tominhcuong2041505-sys/SMT-Pick-and-Place/PCB/2026-09-16/README_NOTE.txt

Thickness   : 1.6mm
Color       : Black
Stencil     : YES
Stencil size: 150*150mm
