tominhcuong2041505-sys/SMT-Pick-and-Place/PCB/2026-07-02/Layout/LPC1769_PNP-B_Silkscreen.pdf

VIN

GND

2B

## 2A1A1B

3V3 GND

X-AXIS

VIN

GND

2B

## 2A1A1B

3V3 GND

Y0-AXIS

VIN

GND

2B

## 2A1A1B

3V3 GND

Y1-AXIS Z-AXIS

VIN

GND

2B

## 2A1A1B

3V3 GND

R-AXIS

VIN

GND

2B

## 2A1A1B

3V3 GND

## ENM1 M2RX

TX CLK

STP

DIR

## ENM1 M2RX

TX CLK

STP

DIR

## ENM1 M2RX

TX CLK

STP

DIR

## ENM1 M2RX

TX CLK

STP

DIR

## ENM1 M2RX

TX CLK

STP

DIR

# P1.29 P1.28 P1.27 P1.18 P1.19 P2.1 P2.3 P2.2 GND

GND

GND

GND

GND P2.5 + P2.4 + P0.15 + P0.16 + + - D- D+ VBUS GND + + + + + + + +
