tominhcuong2041505-sys/SMT-Pick-and-Place/OpenPnP/LBoiz_Scripts/README.md

Tải và copy vào scripts Openpnp "/home/$user$/.openpnp2/scripts"

```
chmod +x /home/lboiz/.openpnp2/scripts/Examples/Python/reset_camera_*.py
```
