tominhcuong2041505-sys/SMT-Pick-and-Place/Klipper/.theme/main-background.png

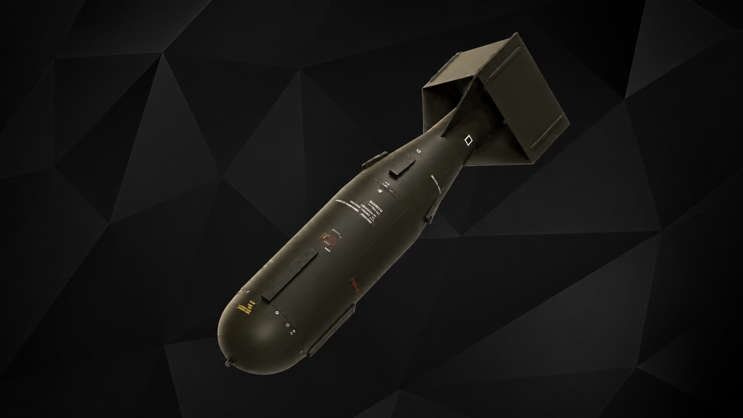
Klipper/.theme/main-background.png
