tominhcuong2041505-sys/SMT-Pick-and-Place/Klipper/.theme/sidebar-background.png

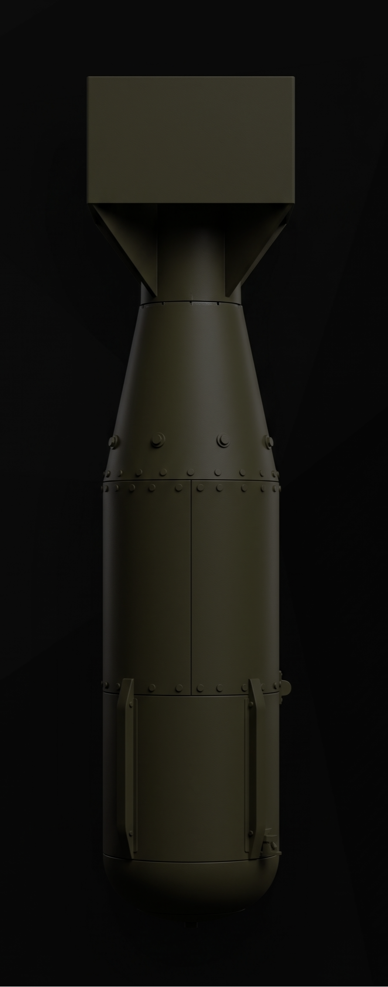
Klipper/.theme/sidebar-background.png
