tominhcuong2041505-sys/SMT-Pick-and-Place/PCB/Images/LPC1769_LBoizPnP_v1.1.png

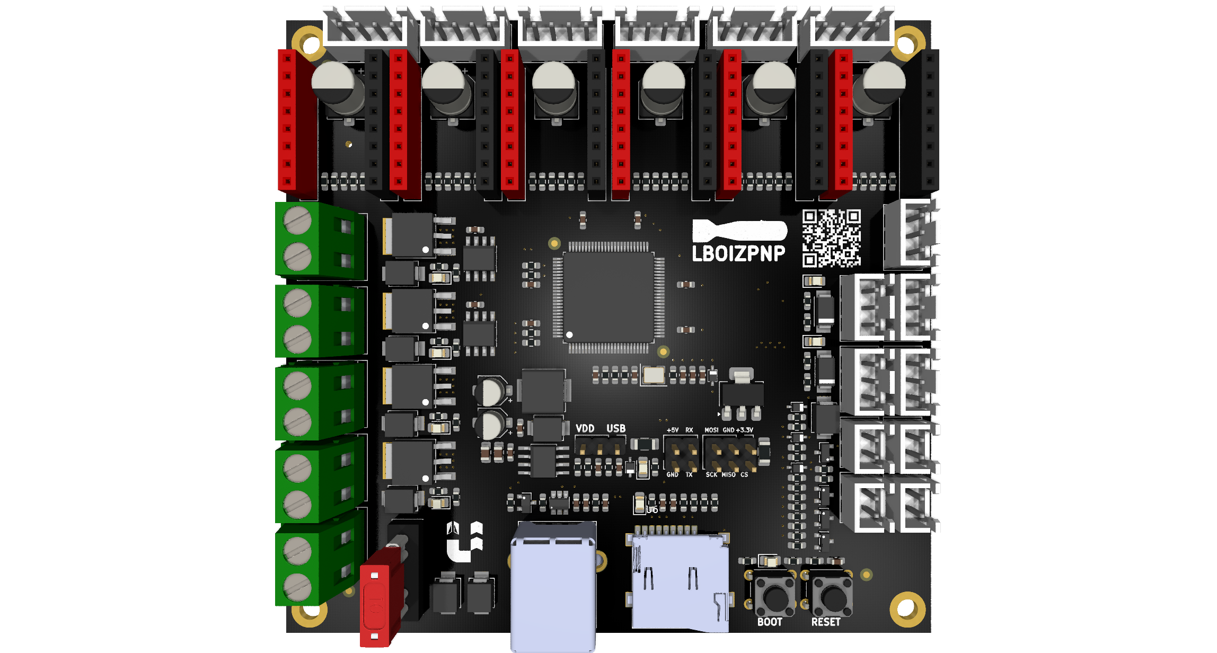
PCB/Images/LPC1769_LBoizPnP_v1.1.png
