tominhcuong2041505-sys/SMT-Pick-and-Place/PCB/Images/LPC1769_LPC-PnP_v1.png

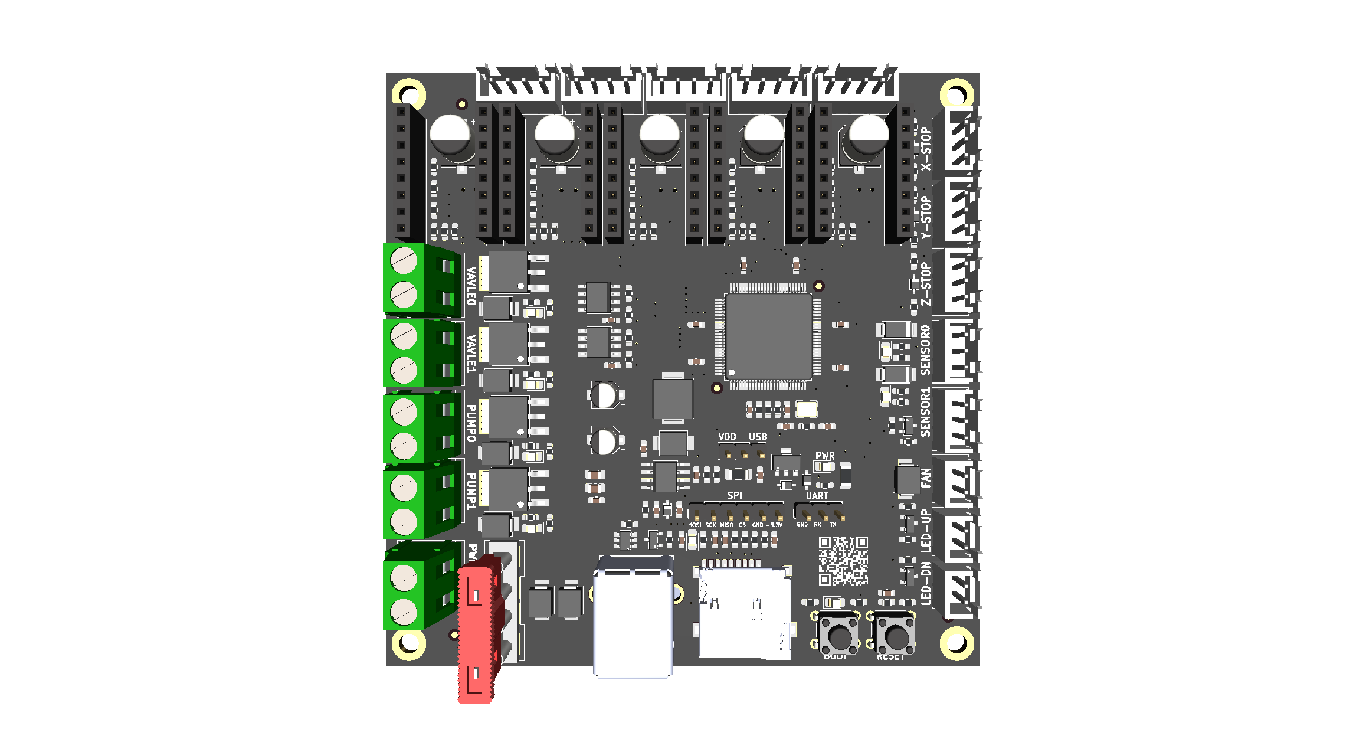
PCB/Images/LPC1769_LPC-PnP_v1.png
