tominhcuong2041505-sys/SMT-Pick-and-Place/PCB/2026-07-02/LBoizPnP_BOM_2026-07-02.xlsx

BILL OF MATERIAL
Project: LBoizPnP
Items | Quantity | Reference | Value | Footprint | Description | Manufacturer | MPN
1 | 2 | C1,C2 | 2.2uF/50V | Capacitor_SMD:C_0805_2012Metric_Pad1.18x1.45mm_HandSolder | 2.2uF ±10% 50V Ceramic Capacitor X7R 0805 | SAMWHA | CS2012X7R225K500NRE
2 | 2 | C3,C4 | 0.1uF/50V | Capacitor_SMD:C_0603_1608Metric_Pad1.08x0.95mm_HandSolder | 100nF ±10% 50V Ceramic Capacitor X7R 0603 | Samsung Electro-Mechanics | CL10B104KB8NNNC
3 | 9 | C5,C8,C10,C22,C23,C24,C25,C26,C27 | 0.1uF/16V | Capacitor_SMD:C_0603_1608Metric_Pad1.08x0.95mm_HandSolder | 100nF ±10% 16V Ceramic Capacitor X7R 0603 | Samsung Electro-Mechanics | CL10B104KO8NNNC
4 | 2 | C6,C7 | 4.7uF/50V | Capacitor_SMD:CP_Elec_4x5.4 | 4.7uF ±20% 50V Aluminum Electrolytic Capacitors 1000hrs@105℃ | VT(Vertical Technology) | VT1H4R7M-CRC54
5 | 1 | C9 | 22uF/10V | Capacitor_SMD:C_0603_1608Metric_Pad1.08x0.95mm_HandSolder | 22uF ±20% 10V Ceramic Capacitor X5R 0603 | CCTC | TCC0603X5R226M100CT
6 | 10 | C11,C12,C13,C14,C15,C16,C17,C18,C19,C20 | 18pF/50V | Capacitor_SMD:C_0603_1608Metric_Pad1.08x0.95mm_HandSolder | 18pF ±5% 50V Ceramic Capacitor C0G 0603 | Chinocera | HGC0603G0180J500NTHJ
7 | 1 | C21 | 47pF/50V | Capacitor_SMD:C_0603_1608Metric_Pad1.08x0.95mm_HandSolder | 47pF ±5% 50V Ceramic Capacitor C0G 0603 | AIDE CAPACITOR | 0603C0G470J500NT
8 | 5 | C28,C29,C30,C31,C32 | 100uF/35V | Capacitor_SMD:CP_Elec_6.3x7.7 | 100uF ±20% 35V Aluminum Electrolytic Capacitors 2000hrs@105℃ | ROQANG | RVT1V101M0607
9 | 8 | D1,D2,D3,D19,D20,D23,D24,D25 | SS56/SMB | MaxiK:SMB_DO-214AA | 1 Independent 60V 950mV@5A 5A SMB Single Diodes RoHS | SEP | SS56(SMB)
10 | 2 | D4,D7 | PESD5V0S1BA | MaxiK:PESD3V3L1BA_PESD5V0S1BA | 14VC Clamp 12A@8/20us Ipp ESD DIODE SOD-323 | UMW | PESD5V0S1BA
11 | 5 | D5,D8,D14,D15,D16 | LED_R | LED_SMD:LED_0603_1608Metric_Pad1.05x0.95mm_HandSolder | Red 2.1V 20mA 120° 2mm x 1.25mm square LED 0805 LED Indication - Discrete RoHS | Guiguang light | GL0805UR01
12 | 4 | D6,D9,D10,D11 | PESD3V3L1BA | MaxiK:PESD3V3L1BA_PESD5V0S1BA | 12VC Clamp 35A Ipp ESD DIODE SOD-323 | TDSEMIC | PESD3V3L1BA
13 | 2 | D12,D13 | SS14 | MaxiK:SS14 | 1 Independent 40V 700mV@1A 1A SMA Single Diodes RoHS | SEP | SS14
14 | 4 | D17,D18,D21,D22 | LED_G | LED_SMD:LED_0603_1608Metric_Pad1.05x0.95mm_HandSolder | 20mA 2.1V 120° Red 2mm x 1.25mm square LED 0805 LED Indication - Discrete RoHS | Guiguang light | GL0805UR01
15 | 1 | F1 | 32V/10A | MaxiK:ATO_Blade_Fuse_Holder_10A | Blade Fuses | Littelfuse | 0287010.PXCN
16 | 1 | F3 | 12V/5A | Fuse:Fuse_1210_3225Metric_Pad1.42x2.65mm_HandSolder | PTC RESET FUSE 12V 5A 1210 | Jinrui | JK-SMD1210-500L-12
17 | 1 | F4 | PTC_6V/1A | Fuse:Fuse_1206_3216Metric_Pad1.42x1.75mm_HandSolder | Polymeric PTC Resettable Fuse 6V 1A Surface Mount 1206 | Jinrui | JK-nSMD100-6
18 | 6 | FB1,FB2,FB3,FB4,FB5,FB6 | 120R | Resistor_SMD:R_0603_1608Metric_Pad0.98x0.95mm_HandSolder | 120Ω@100MHz 1 Line Ferrite Bead 0603 600mA 150mΩ | Chilisin | GBK160808T-121Y-N
19 | 1 | J1 | DC_IN 12-24V | MaxiK:TerminalBlock_KF128_1x02_P5.08 | 2 Position Wire to Board Terminal Block Through Hole 5.08mm | Cixi Kefa Elec | KF128-5.08-2P-AA
20 | 1 | J2 | DC_SEL | Connector_PinHeader_2.54mm:PinHeader_1x03_P2.54mm_Vertical | Pin Header 3 Position 2.54mm Pitch Single Row Through Hole -55℃~+105℃ | HanElectricity | 2541WV-03P
21 | 1 | J3 | SPI | Connector_PinHeader_2.54mm:PinHeader_1x06_P2.54mm_Vertical | Pin Header 6 Position 2.54mm Pitch Single Row Through Hole -55℃~+105℃ | HanElectricity | 2541WV-06P
22 | 1 | J4 | X-STOP | MaxiK:P1x03_XH2.54 | Connector Header 2.5mm Pitch Through Hole | HanElectricity | 8821WV-03P
23 | 1 | J5 | Y-STOP | MaxiK:P1x03_XH2.54 | Connector Header 2.5mm Pitch Through Hole | HanElectricity | 8821WV-03P
24 | 1 | J6 | Z-STOP | MaxiK:P1x03_XH2.54 | Connector Header 2.5mm Pitch Through Hole | HanElectricity | 8821WV-03P
25 | 1 | J7 | SENSOR1 | MaxiK:P1x03_XH2.54 | Connector Header 2.5mm Pitch Through Hole | HanElectricity | 8821WV-03P
26 | 1 | J8 | SENSOR0 | MaxiK:P1x03_XH2.54 | Connector Header 2.5mm Pitch Through Hole | HanElectricity | 8821WV-03P
27 | 1 | J9 | Katapult(CanBoot) | Connector_PinHeader_2.54mm:PinHeader_1x03_P2.54mm_Vertical | Pin Header 3 Position 2.54mm Pitch Single Row Through Hole -55℃~+105℃ | HanElectricity | 2541WV-03P
28 | 1 | J10 | PUMP1 | MaxiK:TerminalBlock_KF128_1x02_P5.08 | 2 Position Wire to Board Terminal Block Through Hole 5.08mm | Cixi Kefa Elec | KF128-5.08-2P-AA
29 | 1 | J11 | PUMP0 | MaxiK:TerminalBlock_KF128_1x02_P5.08 | 2 Position Wire to Board Terminal Block Through Hole 5.08mm | Cixi Kefa Elec | KF128-5.08-2P-AA
30 | 1 | J12 | VAVLE1 | MaxiK:TerminalBlock_KF128_1x02_P5.08 | 2 Position Wire to Board Terminal Block Through Hole 5.08mm | Cixi Kefa Elec | KF128-5.08-2P-AA
31 | 1 | J13 | VAVLE0 | MaxiK:TerminalBlock_KF128_1x02_P5.08 | 2 Position Wire to Board Terminal Block Through Hole 5.08mm | Cixi Kefa Elec | KF128-5.08-2P-AA
32 | 5 | J14,J15,J16,J20,J21 | TMC2209_CONN | MaxiK:TMC2209_CONN | Female Header 8 Position 2.54mm Pitch Single Row Through Hole -40℃~+105℃ | JILN | 22850108ANG1SYA01
33 | 1 | J17 | Motor_X | MaxiK:P1x04_XH2.54 | Connector Header 4 position 2.54mm Pitch 3A Through Hole -25℃~+85℃ | Hanbo Electronic | WAFER-XH254Z-4AL
34 | 1 | J18 | Motor_Y0 | MaxiK:P1x04_XH2.54 | Connector Header 4 position 2.54mm Pitch 3A Through Hole -25℃~+85℃ | Hanbo Electronic | WAFER-XH254Z-4AL
35 | 1 | J19 | Motor_Y1 | MaxiK:P1x04_XH2.54 | Connector Header 4 position 2.54mm Pitch 3A Through Hole -25℃~+85℃ | Hanbo Electronic | WAFER-XH254Z-4AL
36 | 1 | J22 | Motor_Z | MaxiK:P1x04_XH2.54 | Connector Header 4 position 2.54mm Pitch 3A Through Hole -25℃~+85℃ | Hanbo Electronic | WAFER-XH254Z-4AL
37 | 1 | J23 | Motor_R | MaxiK:P1x04_XH2.54 | Connector Header 4 position 2.54mm Pitch 3A Through Hole -25℃~+85℃ | Hanbo Electronic | WAFER-XH254Z-4AL
38 | 1 | J24 | FAN0 | MaxiK:P1x02_XH2.54 | CONN HEADER TH 2.5mm | HanElectricity | 8821WV-02P
39 | 1 | J25 | LED_UP | MaxiK:P1x02_XH2.54 | CONN HEADER TH 2.5mm | HanElectricity | 8821WV-02P
40 | 1 | J26 | LED_DOWN | MaxiK:P1x02_XH2.54 | CONN HEADER TH 2.5mm | HanElectricity | 8821WV-02P
41 | 1 | L1 | 6.8uH | MaxiK:Inductor_7x6.6 | FIXED IND 6.8uH 5A 48mΩ SMD,7x6.6mm | Magnetsyc | FSA0630-6R8MT
42 | 1 | Q1 | AO3401A | MaxiK:AO3401A_AO3400A | 30V 4A 900mV 45mΩ@10V 1 P-Channel P-Channel SOT-23 Single FETs, MOSFETs RoHS | YONGYUTAI | AO3401A
43 | 4 | Q2,Q3,Q4,Q5 | NCE40H12K | MaxiK:NCE40H12K | MOSFET N-CH 40V 120A TO-252-2L | NCE | NCE40H12K
44 | 3 | Q6,Q7,Q8 | AO3400A | MaxiK:AO3401A_AO3400A | N-Channel 30V 5.8A 1.36W Surface Mount SOT-23 | YONGYUTAI | AO3400A
45 | 1 | R1 | 50K/0.1% | Resistor_SMD:R_0603_1608Metric_Pad0.98x0.95mm_HandSolder | 50kΩ ±0.1% 100mW 0603 Thin Film Resistor | YAGEO | RT0603BRD0750KL
46 | 1 | R2 | 68K/1% | Resistor_SMD:R_0603_1608Metric_Pad0.98x0.95mm_HandSolder | 100mW 68kΩ 75V Thick Film Resistor ±1% 0603 Chip Resistor - Surface Mount RoHS | GiantOhm | GR0603F68KT5G00
47 | 1 | R3 | 12K/1% | Resistor_SMD:R_0603_1608Metric_Pad0.98x0.95mm_HandSolder | 100mW 12kΩ 75V Thick Film Resistor ±100ppm/℃ ±1% 0603 Chip Resistor - Surface Mount RoHS | VO | SCR0603F12K
48 | 8 | R4,R15,R17,R19,R21,R24,R25,R26 | 1K/5% | Resistor_SMD:R_0603_1608Metric_Pad0.98x0.95mm_HandSolder | 100mW 1kΩ 75V Thick Film Resistor ±100ppm/℃ ±5% 0603 Chip Resistor - Surface Mount RoHS | Walsin | WR06X102JTL
49 | 28 | R5,R7,R8,R11,R12,R13,R14,R16,R18,R20,R22,R23,R27,R28,R29,R34,R35,R52,R53,R54,R63,R64,R66,R67,R69,R70,R72,R73 | 10K/5% | Resistor_SMD:R_0603_1608Metric_Pad0.98x0.95mm_HandSolder | 10kΩ ±5% 100mW 0603 Thick Film Resistor | FOJAN | FRC0603J103 TS
50 | 1 | R6 | 1M/1% | Resistor_SMD:R_0603_1608Metric_Pad0.98x0.95mm_HandSolder | 100mW 1MΩ 75V Thick Film Resistor ±1% 0603 Chip Resistor - Surface Mount RoHS | CHANGLONG | CL0603FN1MP
51 | 2 | R9,R10 | 1.5K/5% | Resistor_SMD:R_0603_1608Metric_Pad0.98x0.95mm_HandSolder | 1.5kΩ 100mW 50V Thick Film Resistor ±5% ±100ppm/℃ 0603 Chip Resistor - Surface Mount RoHS | HWA CHN | HRC0603J152 ENTN
52 | 4 | R30,R31,R36,R37 | 4.7R/5% | Resistor_SMD:R_0603_1608Metric_Pad0.98x0.95mm_HandSolder | 100mW 4.7Ω 75V Thick Film Resistor ±100ppm/℃ ±5% 0603 Chip Resistor - Surface Mount RoHS | Walsin | WR06X4R7JTL
53 | 4 | R32,R33,R38,R39 | 4.7K/5% | Resistor_SMD:R_0603_1608Metric_Pad0.98x0.95mm_HandSolder | 100mW 4.7kΩ 50V Thick Film Resistor ±5% ±100ppm/℃ 0603 Chip Resistor - Surface Mount RoHS | HWA CHN | HRC0603J472 ENTN
54 | 18 | R40,R42,R43,R44,R46,R47,R48,R50,R51,R55,R57,R58,R59,R61,R62,R65,R68,R71 | 100R/1% | Resistor_SMD:R_0603_1608Metric_Pad0.98x0.95mm_HandSolder | 100mW 100Ω 50V Thick Film Resistor ±100ppm/℃ ±1% 0603 Chip Resistor - Surface Mount RoHS | RESI | AECR0603F100RK9
55 | 5 | R41,R45,R49,R56,R60 | 22R/1% | Resistor_SMD:R_0603_1608Metric_Pad0.98x0.95mm_HandSolder | 22Ω ±1% 100mW 0603 Thick Film Resistor | CHANGLONG | CL0603FN22RP
56 | 1 | SW1 | SW_RST | Button_Switch_THT:SW_TH_Tactile_Omron_B3F-102x | Tactile Switch SPST 0.98N 5mm PC Pin 6mm x 6mm Through Hole | OMRON | B3F-1020
57 | 1 | SW2 | SW_BOOT | Button_Switch_THT:SW_TH_Tactile_Omron_B3F-102x | Tactile Switch SPST 0.98N 5mm PC Pin 6mm x 6mm Through Hole | OMRON | B3F-1020
58 | 1 | U1 | LMR14030SDDAR | LMR14030:LMR14030 | 2.5MHz Step-down type Adjustable 800mV~28V 3.5A SO-8-EP Voltage Regulators - DC DC Switching Regulators RoHS | TI | LMR14030SDDAR
59 | 1 | U2 | AMS1117-3.3 | AMS1117-3.3:AMS1117-3.3 | IC REG LINEAR 3.234V~3.366V 1A SOT-89-3 | FOSAN | AMS1117-3.3
60 | 1 | U3 | LPC1769FBD100 | MaxiK:LPC1769FBD100 | ARM Cortex-M3 32 Bit 120MHz 70 LQFP-100(14x14) Microcontrollers RoHS | NXP | LPC1769FBD100
61 | 1 | U4 | USB_TypeB | MaxiK:USB-B1HSB6 | CONN RCPT USB 2.0 Type-B 4POS TH R/A | SHOU HAN | BF 90
62 | 1 | U5 | USBLC6-2SC6 | MaxiK:USBLC6-2SC6 | https://www.lcsc.com/datasheet/C2687116.pdf | UMW | USBLC6-2SC6
63 | 1 | U6 | SD_CARD | MaxiK:SD_Card_MSD-4-A | -40℃~+85℃ Push-Push 2mm Connector and Ejector MicroSD Card (TF Card) SMD PC Card Sockets RoHS | CUI | MSD-4-A
64 | 2 | U7,U8 | UCC27524ADR | MaxiK:UCC27524ADR | 4.5V~18V 5A 5A SOIC-8 Gate Drivers RoHS | TI | UCC27524ADR
65 | 1 | Y1 | 12MHz | Crystal:Crystal_SMD_3225-4Pin_3.2x2.5mm | CRYSTAL 12MHz 20pF SMD | KYX | K3A120002010
