tominhcuong2041505-sys/SMT-Pick-and-Place/3D/STLs/X-Mount_Right_x1.stl

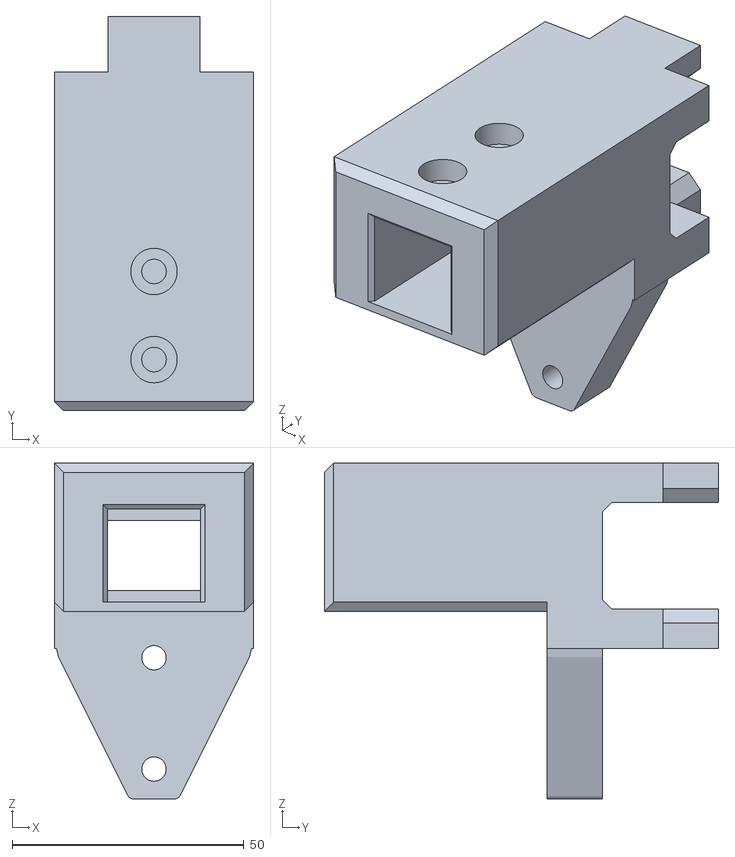
[picture p14: CAD file, 2026-11-03]
3D/STLs/X-Mount_Right_x1.stl
43.0 x 85.0 x 72.5
