tominhcuong2041505-sys/SMT-Pick-and-Place/PCB/2026-07-02/LittalBoizPnP_3DPCB_2026-07-02.step

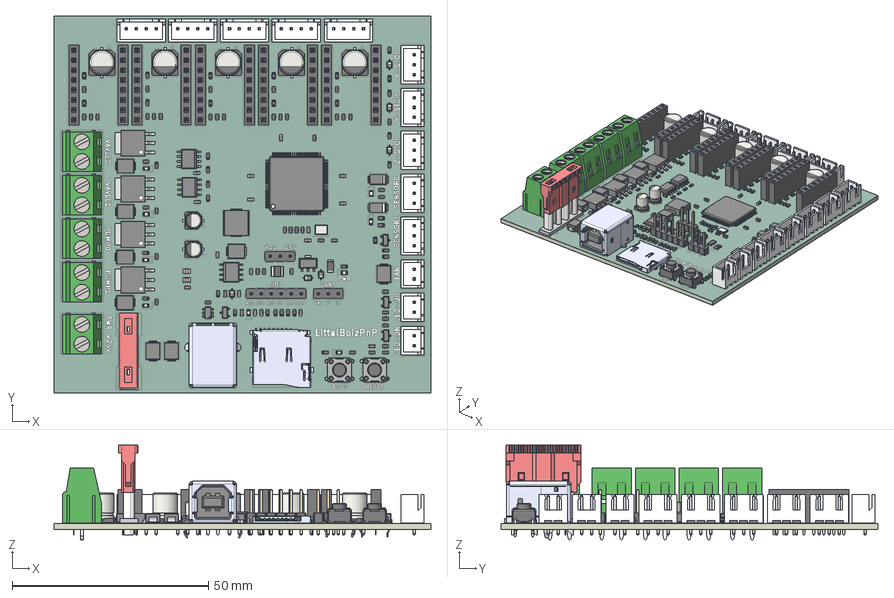
[picture p15: CAD file, 2026-11-03]
PCB/2026-07-02/LittalBoizPnP_3DPCB_2026-07-02.step
96.0 x 96.0 x 24.1 mm
KRE_2 x 5
NCE40H12K x 4
SS14 x 2
LED_0603_1608Metric x 9
JST - XH - Thru - 3Pin - 2.54mm x 5
JST - XH - Thru - 4Pin - 2.54mm x 5
SMB_DO-214AA x 8
R_0603_1608Metric x 79
C_0603_1608Metric x 23
USB-B1HSB6
PESD3V3L1BA x 6
JST - XH - Thru - 2Pin - 2.54mm x 3
UCC27524ADR x 2
CP_Elec_63x77 x 5
C_0805_2012Metric x 2
USBLC6-2SC6
PinHeader_1x06_P254mm_Vertical
LPC1769
CP_Elec_4x54 x 2
PinSocket_1x08_P2.54mm_Vertical x 10
Fuse_1206_3216Metric
AO3401A x 4
CUI_DEVICES_MSD-4-A
LMR14030
Inductor_7x6.6
Fuse_1210_3225Metric
AMS1117-3.3
Crystal_SMD_3225-4Pin_3.2x2.5mm
SW_TH_Tactile_Omron_B3F-102x x 2
plate
terminal
terminal(Mirror)
Fuse:1
Fuse2:1
PinHeader_1x03_P254mm_Vertical x 2
LPC1769_PNP_silkscreen x 2
LPC1769_PNP_soldermask x 2
LPC1769_PNP_PCB
