tominhcuong2041505-sys/SMT-Pick-and-Place/PCB/2026-08-28/3D_Model/LittalBoizPnP_3DPCB_2026-08-28.step

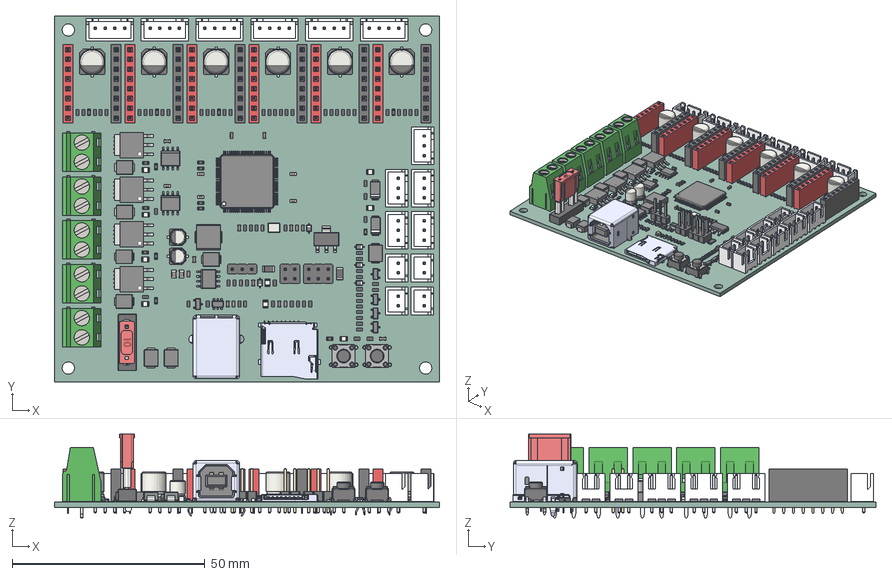
[picture p18: CAD file, 2026-11-03]
PCB/2026-08-28/3D_Model/LittalBoizPnP_3DPCB_2026-08-28.step
100.0 x 95.0 x 21.8 mm
KRE_2 x 5
NCE40H12K x 4
SS14 x 2
LED_0805_2012Metric x 9
JST - XH - Thru - 3Pin - 2.54mm x 5
JST - XH - Thru - 4Pin - 2.54mm x 6
SMB_DO-214AA x 8
R_0603_1608Metric x 85
Pins
Fuse-mini10A.step
PinSocket_1x08_P2.54mm_Vertical_Red.step x 7
C_0603_1608Metric x 23
PESD3V3L1BA x 5
JST - XH - Thru - 2Pin - 2.54mm x 4
UCC27524ADR x 2
CP_Elec_63x77 x 6
PinSocket_1x08_P2.54mm_Vertical x 6
C_0805_2012Metric x 2
USBLC6-2SC6
Fuse_1206_3216Metric x 2
LPC1769
CP_Elec_4x54 x 2
AO3401A x 5
CUI_DEVICES_MSD-4-A
LMR14030
Inductor_7x6.6
SOT-223
Crystal_SMD_3225-4Pin_3.2x2.5mm
SW_TH_Tactile_Omron_B3F-102x x 2
USB-B1HSB6
PinHeader_2x03_P254mm_Vertical
PinHeader_2x02_P254mm_Vertical
PinHeader_1x03_P254mm_Vertical
LBoizPnP_PCB
