tominhcuong2041505-sys/SMT-Pick-and-Place/3D/STLs/CamBot_Plate_x1.stl

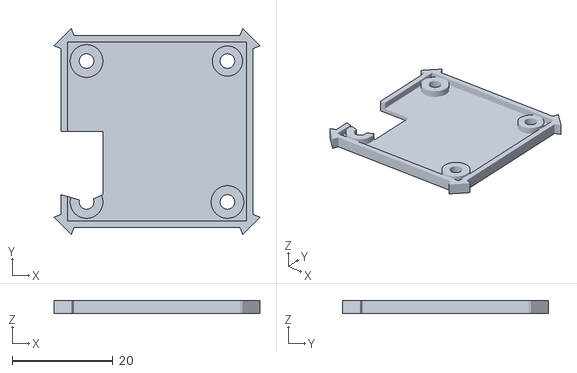
[picture p19: CAD file, 2026-11-03]
3D/STLs/CamBot_Plate_x1.stl
40.9 x 40.9 x 2.50
