tominhcuong2041505-sys/SMT-Pick-and-Place/3D/STLs/BackLeg_Right_x1.stl

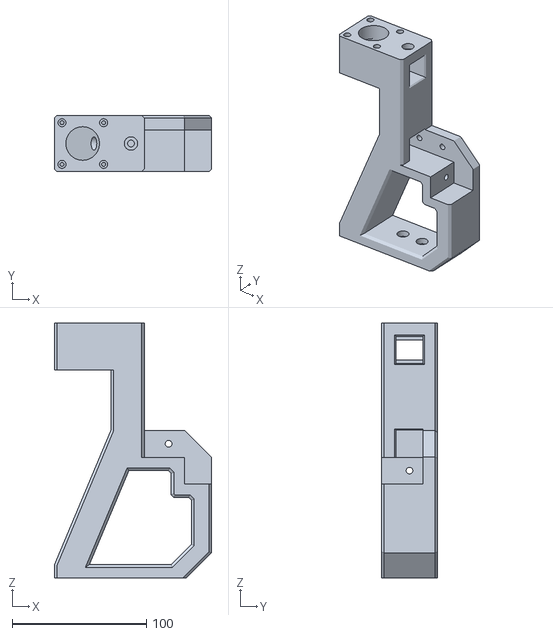
[picture p20: CAD file, 2026-11-03]
3D/STLs/BackLeg_Right_x1.stl
117.0 x 42.0 x 190.0
