tominhcuong2041505-sys/SMT-Pick-and-Place/3D/STLs/BeltTension_x3.stl

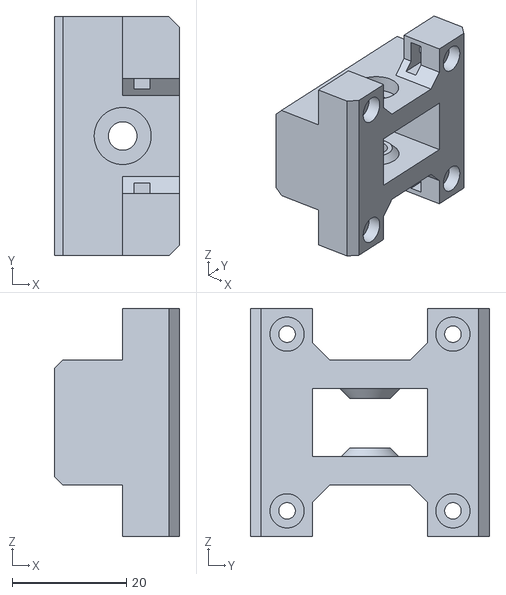
[picture p21: CAD file, 2026-11-03]
3D/STLs/BeltTension_x3.stl
22.0 x 42.0 x 40.0
