tominhcuong2041505-sys/SMT-Pick-and-Place/3D/STLs/CamBot_Mount_x1.stl

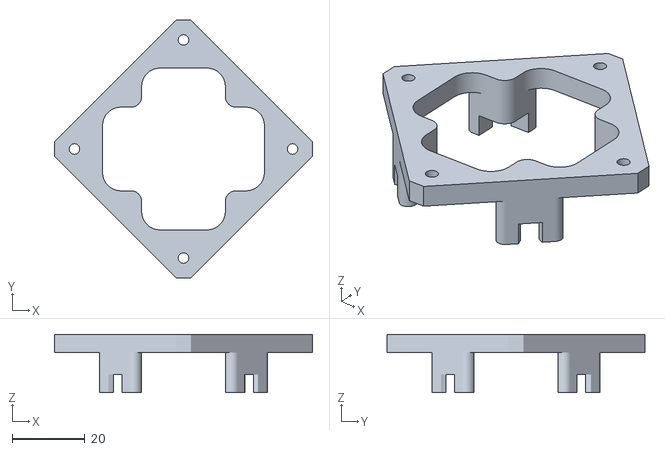
[picture p23: CAD file, 2026-11-03]
3D/STLs/CamBot_Mount_x1.stl
71.0 x 71.0 x 16.0
