tominhcuong2041505-sys/SMT-Pick-and-Place/3D/STLs/Z-Mount_Left_x1.stl

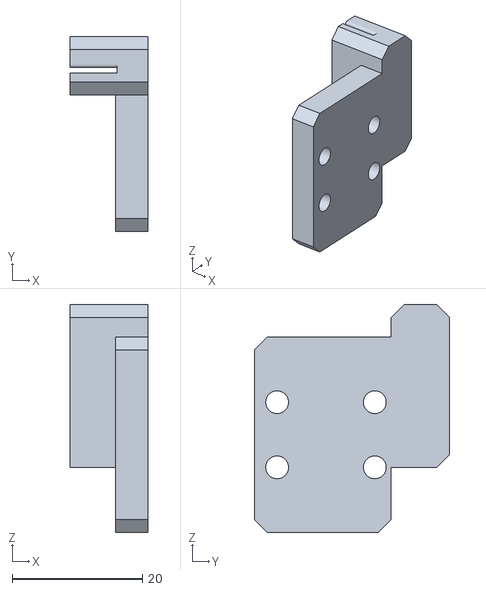
[picture p24: CAD file, 2026-11-03]
3D/STLs/Z-Mount_Left_x1.stl
12.0 x 30.0 x 35.0
