tominhcuong2041505-sys/SMT-Pick-and-Place/3D/STLs/CamBot_Led_x1.stl

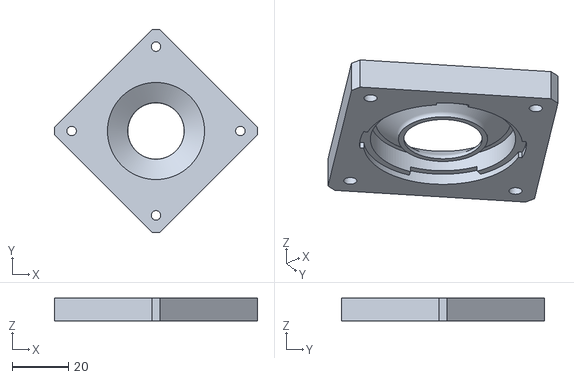
[picture p25: CAD file, 2026-11-03]
3D/STLs/CamBot_Led_x1.stl
72.2 x 72.2 x 8.00
