tominhcuong2041505-sys/SMT-Pick-and-Place/3D/STLs/Z-Mount_Right_x1.stl

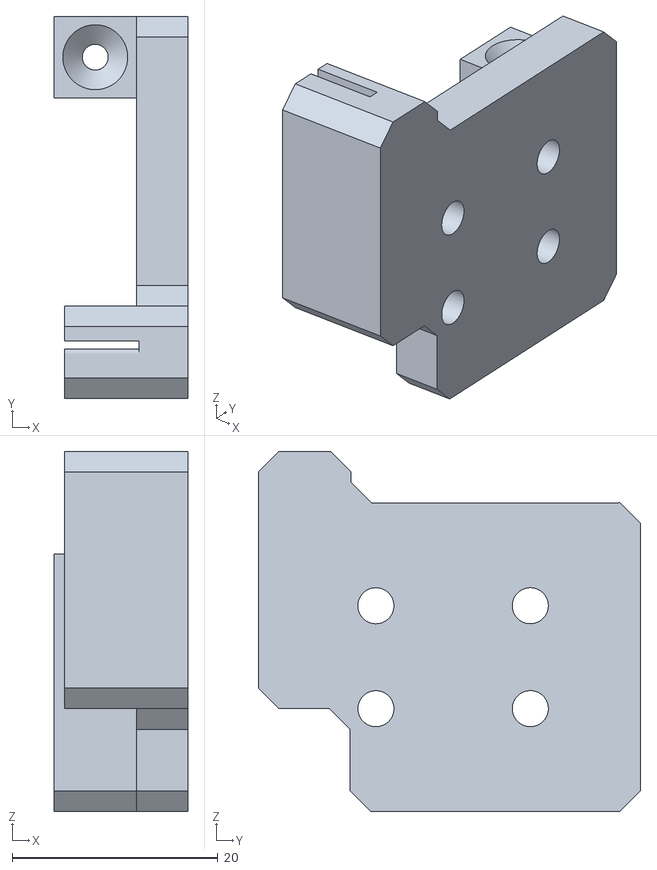
[picture p26: CAD file, 2026-11-03]
3D/STLs/Z-Mount_Right_x1.stl
13.0 x 37.1 x 35.0
