tominhcuong2041505-sys/SMT-Pick-and-Place/3D/STLs/X-Gantry_Back_x1.stl

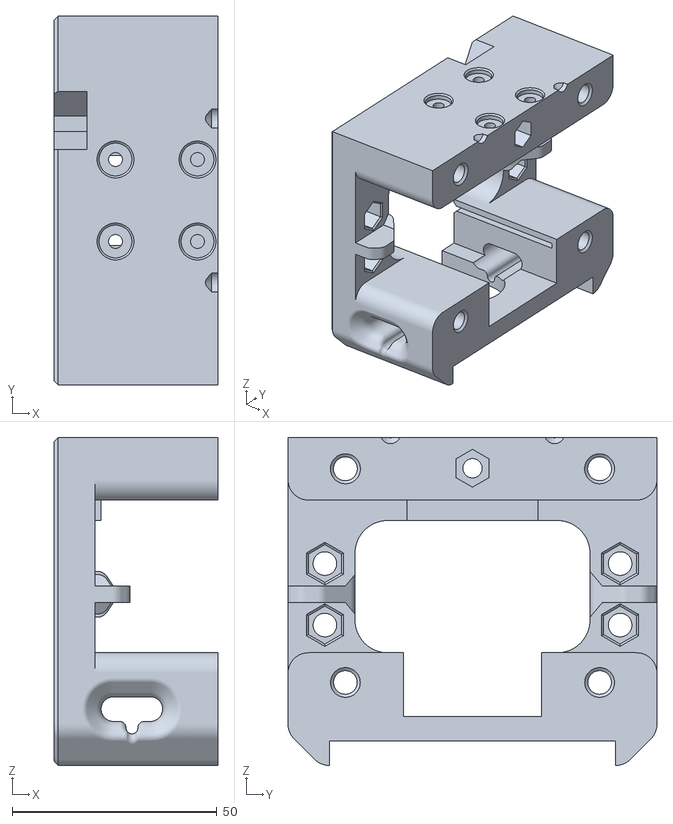
[picture p27: CAD file, 2026-11-03]
3D/STLs/X-Gantry_Back_x1.stl
40.0 x 90.0 x 80.0
