tominhcuong2041505-sys/SMT-Pick-and-Place/3D/STLs/Y-Mount_Right_x1.stl

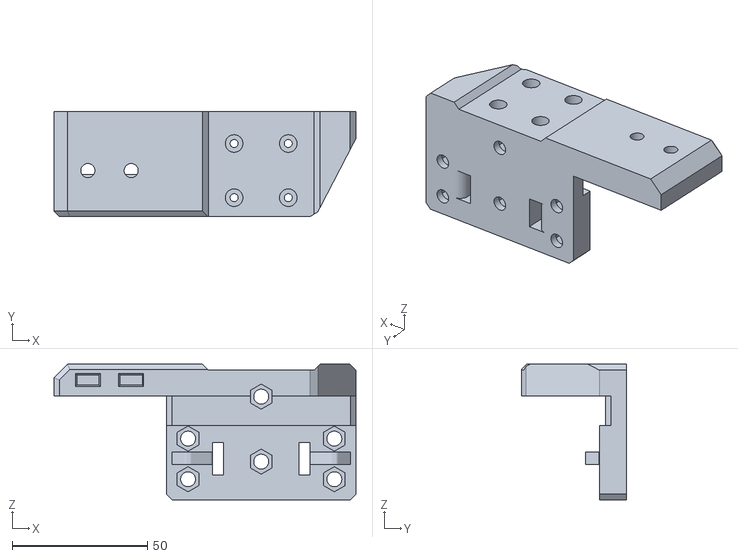
[picture p28: CAD file, 2026-11-03]
3D/STLs/Y-Mount_Right_x1.stl
111.5 x 38.9 x 50.1
