tominhcuong2041505-sys/SMT-Pick-and-Place/3D/STLs/BeltClamp_6x.stl

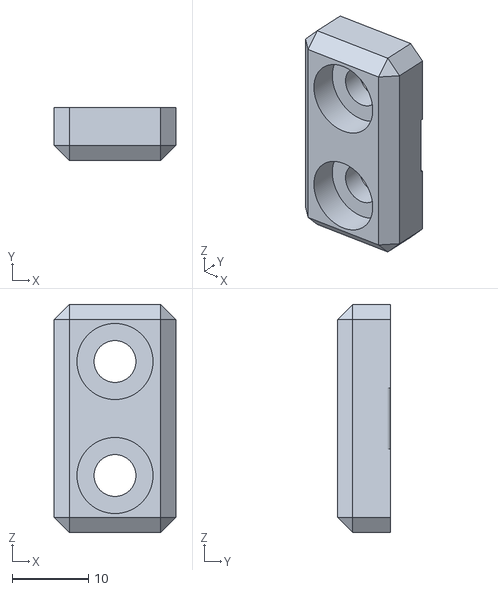
[picture p29: CAD file, 2026-11-03]
3D/STLs/BeltClamp_6x.stl
16.0 x 7.00 x 30.0
