tominhcuong2041505-sys/SMT-Pick-and-Place/3D/STLs/CamTop_Led_x1.stl

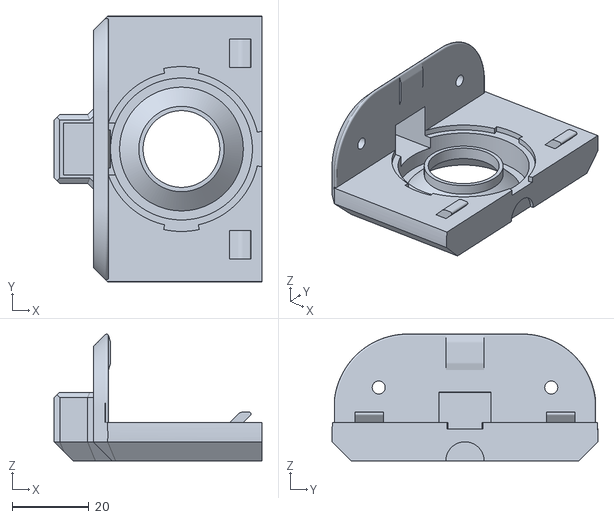
[picture p30: CAD file, 2026-11-03]
3D/STLs/CamTop_Led_x1.stl
54.3 x 69.4 x 33.1
