tominhcuong2041505-sys/SMT-Pick-and-Place/3D/STLs/Frame.3mf

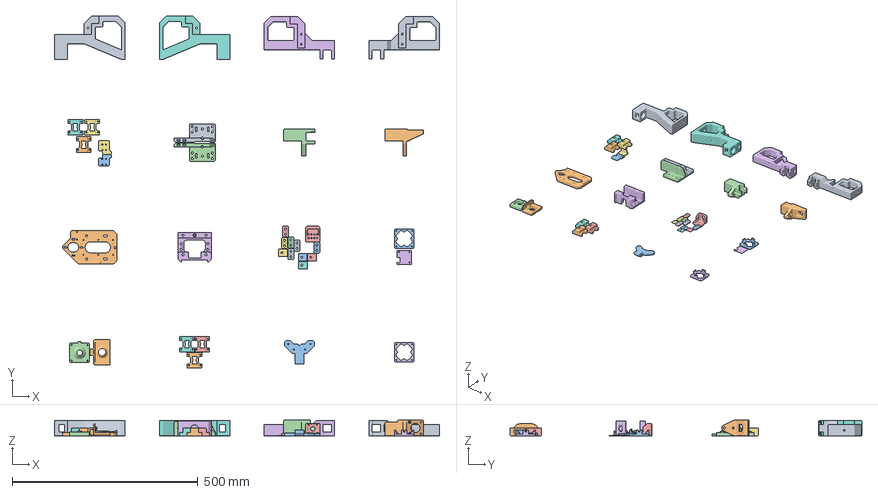
[picture p31: CAD file, 2026-11-03]
3D/STLs/Frame.3mf
1036.0 x 947.0 x 43.0 mm
BackLeg_Right_x1.stl
CamTop_Led_x1.stl
Fiducial1_x1.stl
CamBot_Led_x1.stl
BeltTension_x3.stl x 6
CamBot_Mount_x1.stl x 2
Z-Mount_Right_x1.stl
Y-Mount_Left_x1.stl
Z-Mount_Left_x1.stl
Y-Mount_Right_x1.stl
R-Mount_x1.stl
CamBot_Plate_x1.stl
BeltClamp_6x.stl x 6
FrontLeg_Right_x1.stl
BackLeg_Left_x1.stl
X-Mount_Left_x1.stl
LBoizPnP.stl x 4
X-Mount_Right_x1.stl
X-Gantry_Back_x1.stl
FrontLeg_Left_x1.stl
X-Gantry_Front_x1.stl
