tominhcuong2041505-sys/SMT-Pick-and-Place/3D/STLs/X-Gantry_Front_x1.stl

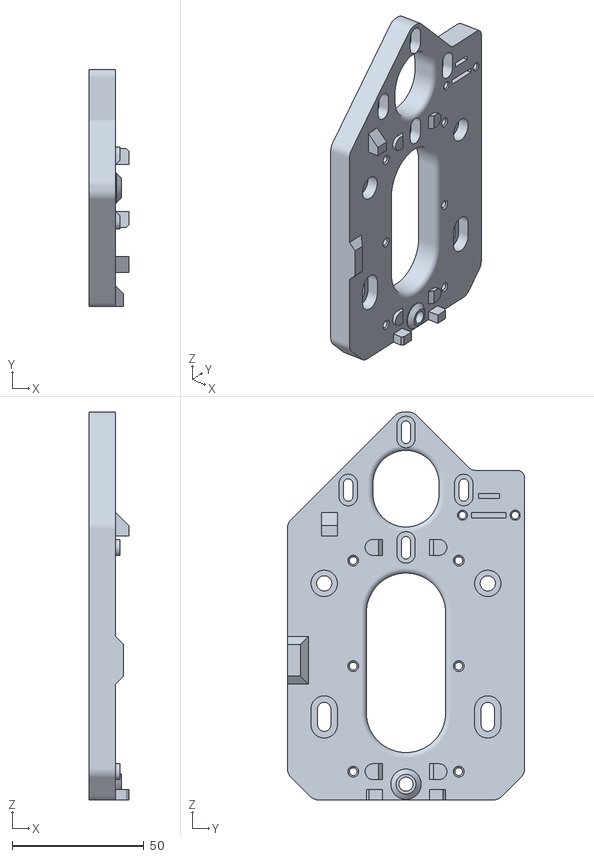
[picture p32: CAD file, 2026-11-03]
3D/STLs/X-Gantry_Front_x1.stl
15.0 x 90.0 x 147.1
