tominhcuong2041505-sys/SMT-Pick-and-Place/3D/STLs/R-Mount_x1.stl

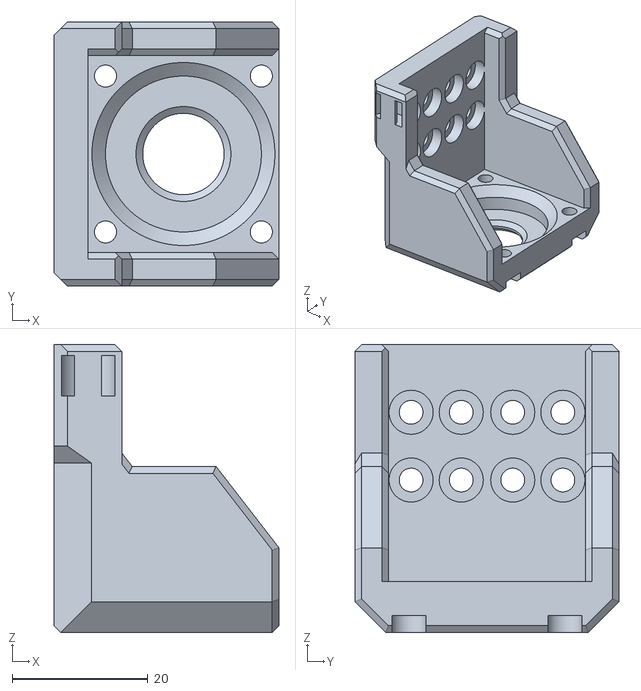
[picture p33: CAD file, 2026-11-03]
3D/STLs/R-Mount_x1.stl
33.2 x 39.0 x 42.5
