tominhcuong2041505-sys/SMT-Pick-and-Place/3D/STLs/X-Mount_Left_x1.stl

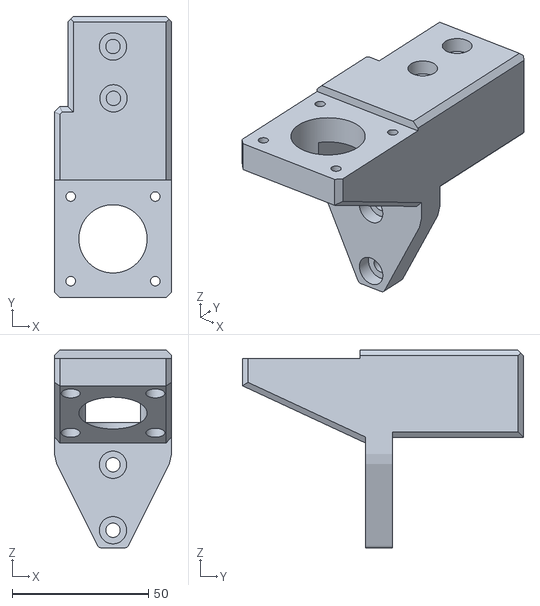
[picture p34: CAD file, 2026-11-03]
3D/STLs/X-Mount_Left_x1.stl
43.0 x 103.0 x 72.4
