tominhcuong2041505-sys/SMT-Pick-and-Place/(list of files, cad)

Other CAD files:
PCB/2026-09-16/3D_Model/LittalBoizPnP_3DPCB_2026-09-16.step
PCB/2026-09-20/3D_Model/LittalBoizPnP_3DPCB_2026-09-16.stl
PCB/Mainboard/2026-06-29/LBoizPnP_3DPCB_2026-06-29.step
3D/STLs/Y-Mount_Left_x1.stl
3D/STLs/FrontLeg_Left_x1.stl
3D/STLs/BackLeg_Left_x1.stl
PCB/2026-08-03/3D_Model/LittalBoizPnP_3DPCB_2026-08-02.stl
PCB/2026-08-28/3D_Model/LittalBoizPnP_3DPCB_2026-08-28.stl
