tominhcuong2041505-sys/SMT-Pick-and-Place/PCB/2026-07-02/LBoizPnP_Schematic_2026-07-02.pdf

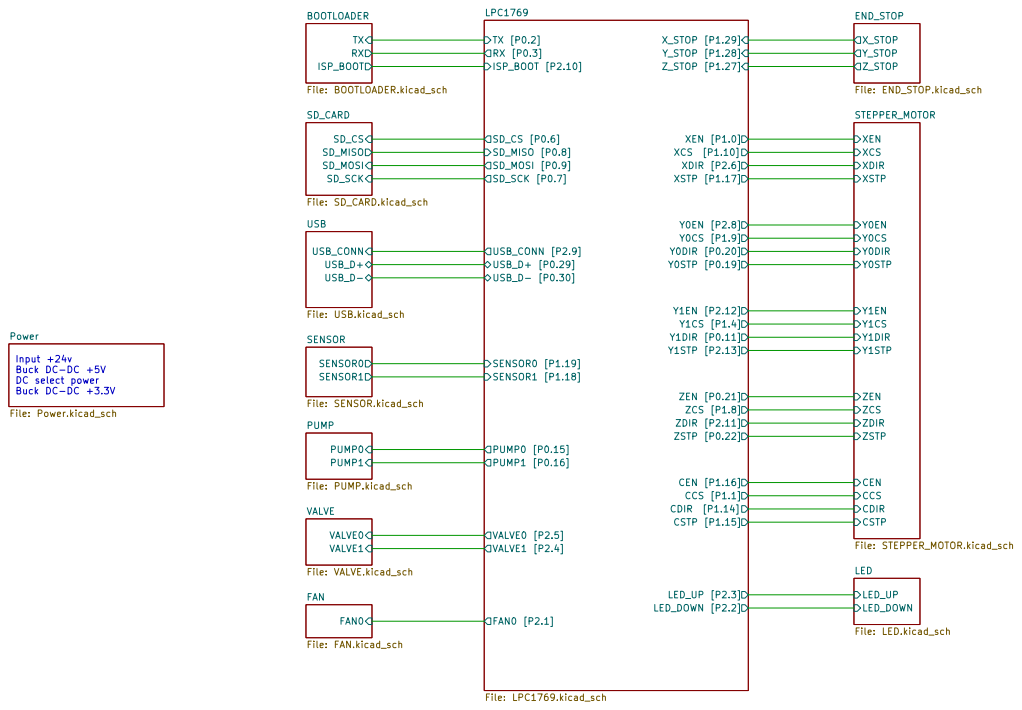
[picture p35: page 1]

Input +24v Buck DC-DC +5V DC select power Buck DC-DC +3.3V

File: STEPPER_MOTOR.kicad_sch CCS [P1.1] CDIR [P1.14] CEN [P1.16] CSTP [P1.15] FAN0 [P2.1]

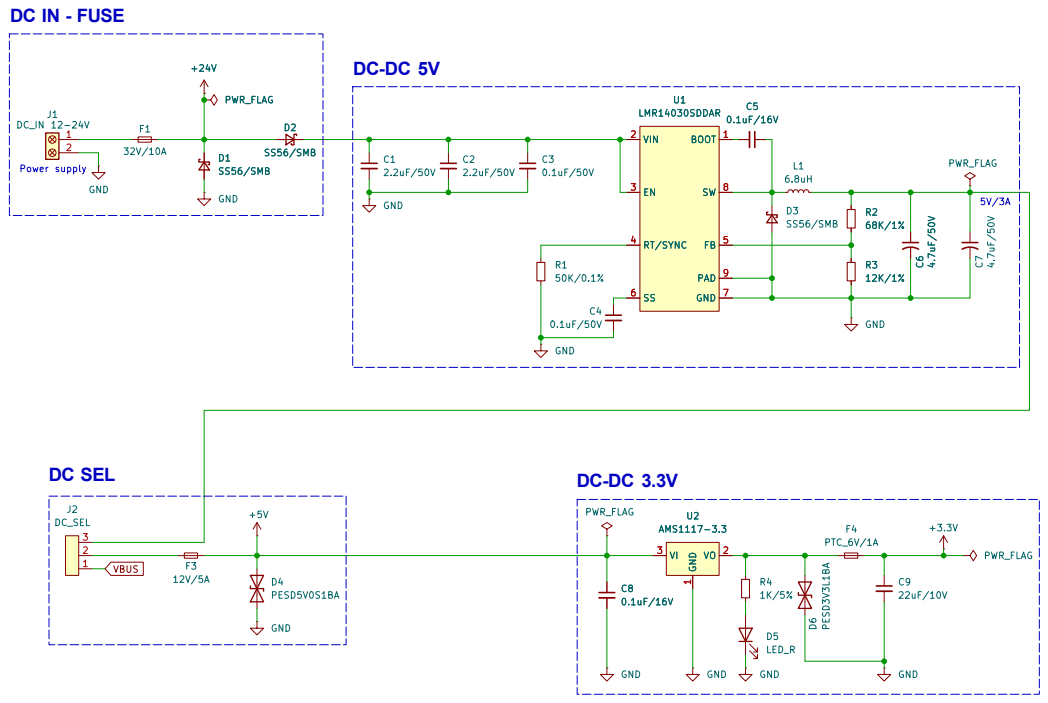
[picture p36: page 2]

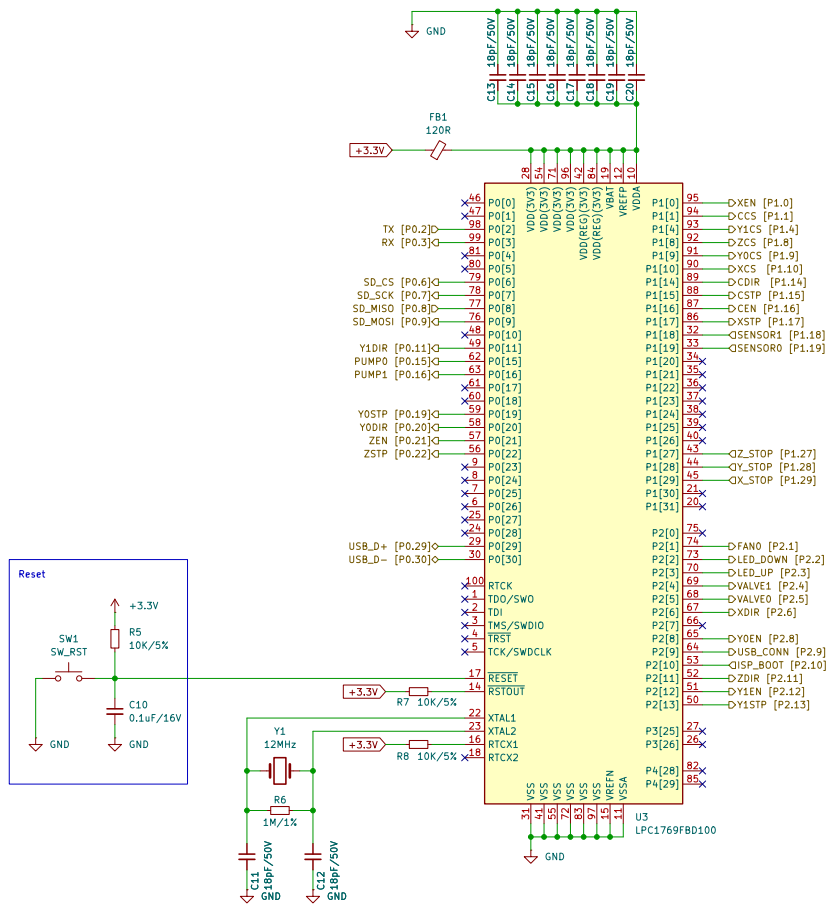
[picture p37: page 3]

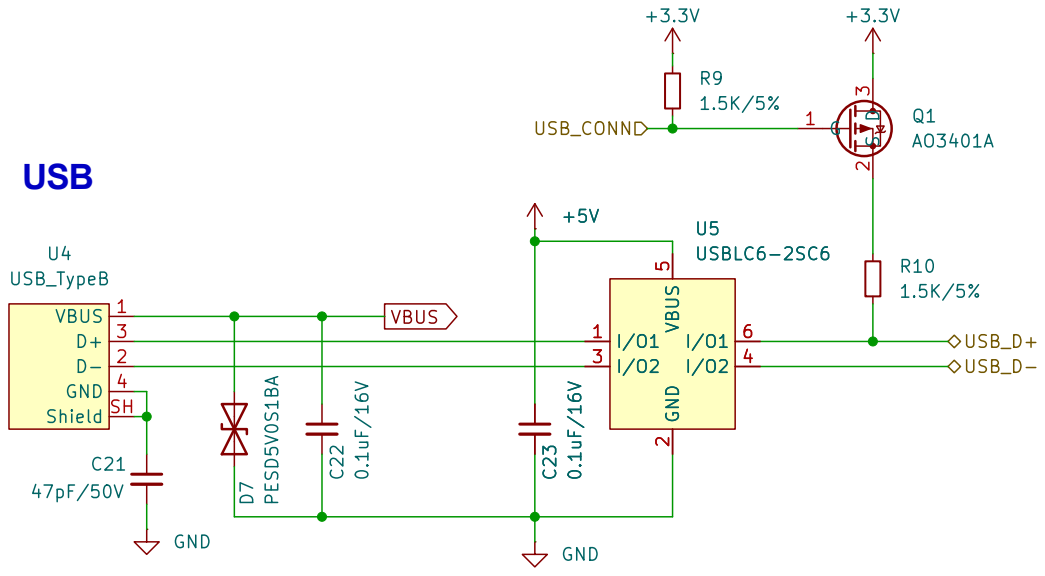
[picture p38: page 4]

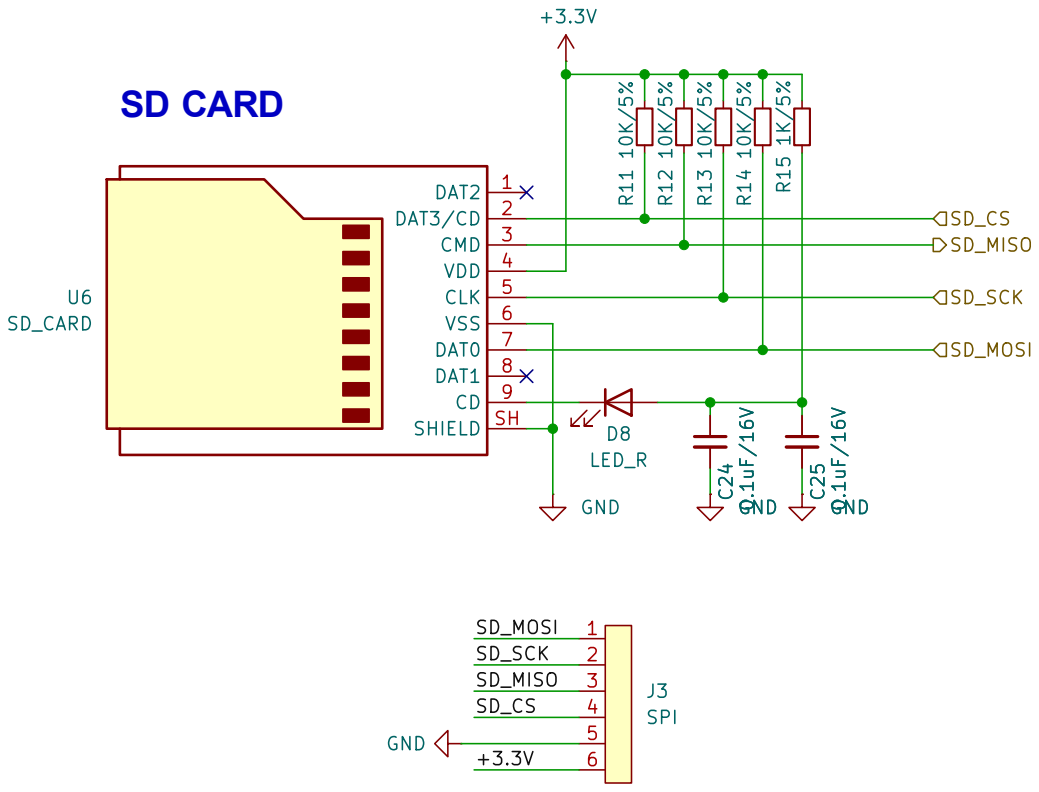
[picture p39: page 5]

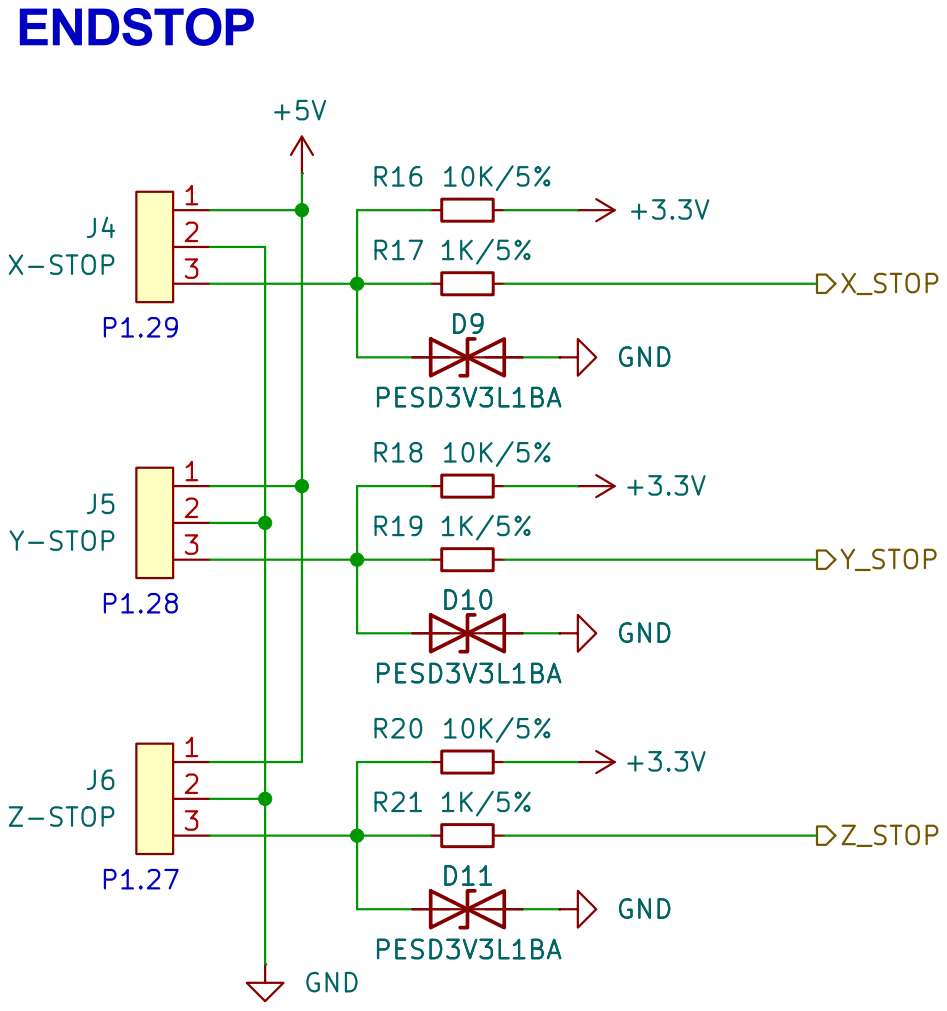
[picture p40: page 6]

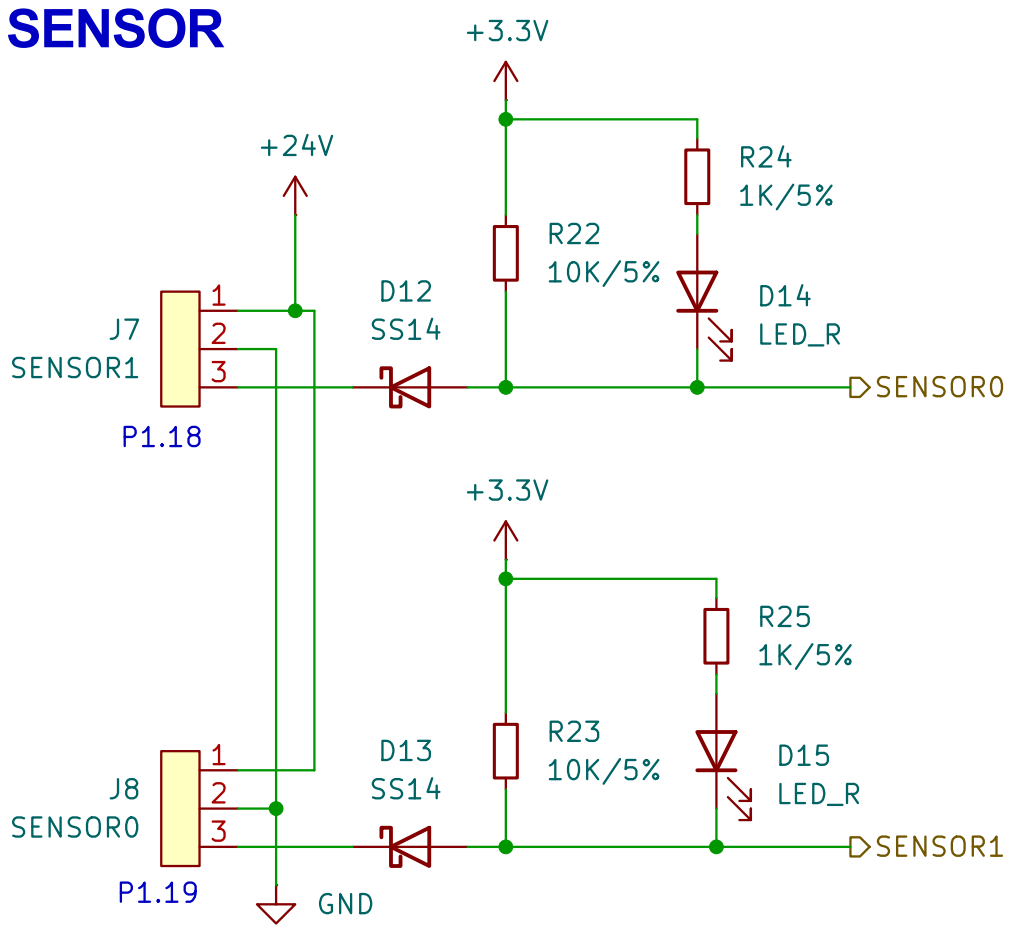
[picture p41: page 7]

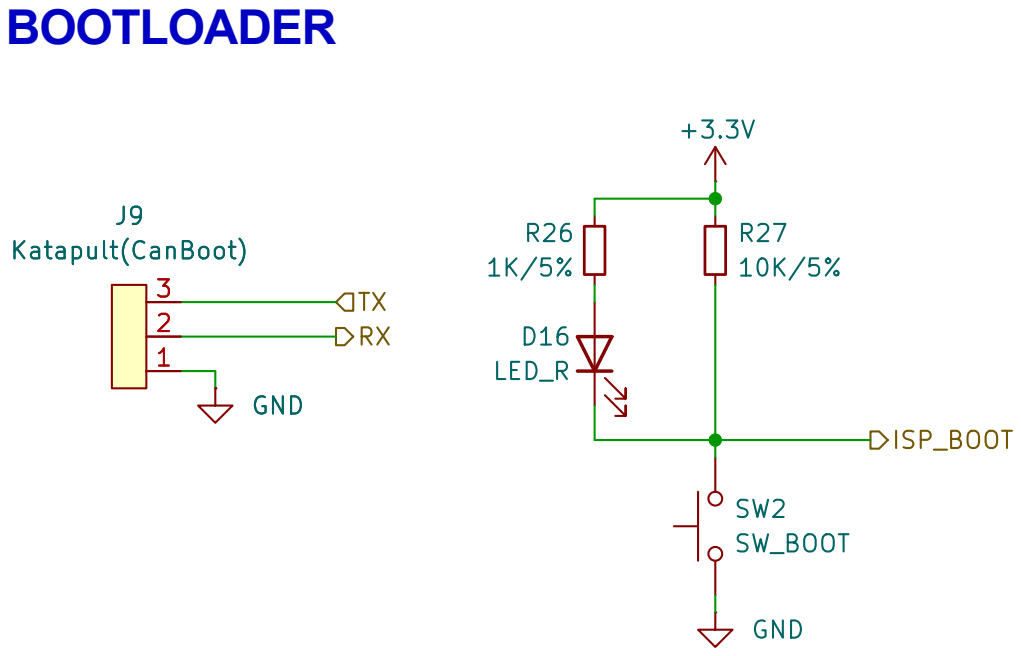
[picture p42: page 8]

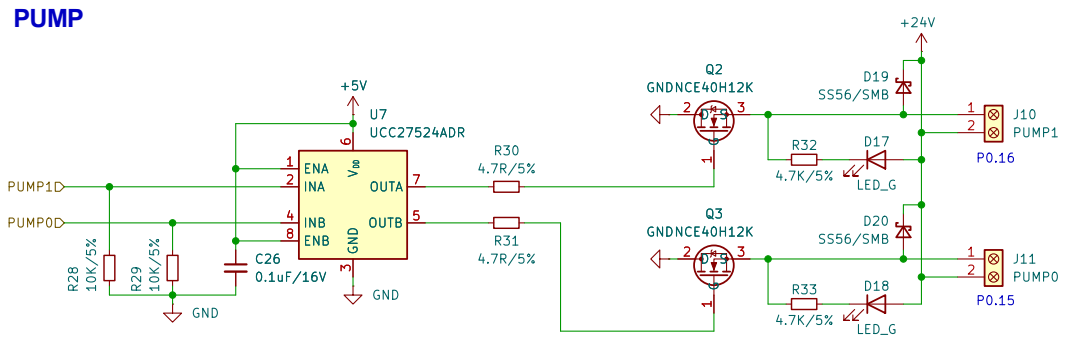
[picture p43: page 9]

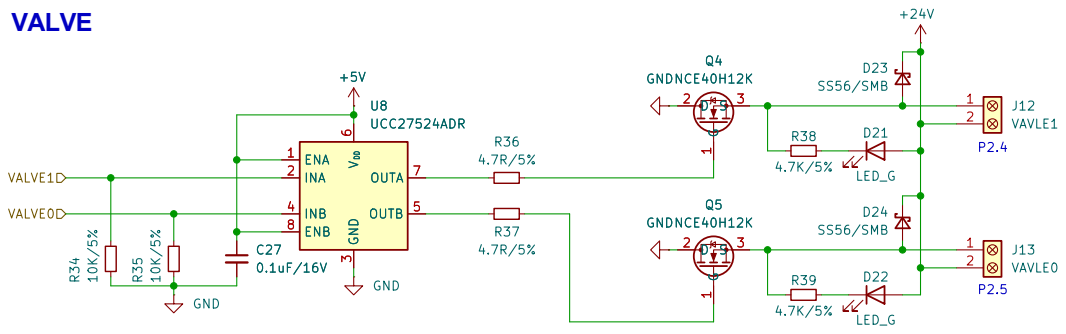
[picture p44: page 10]

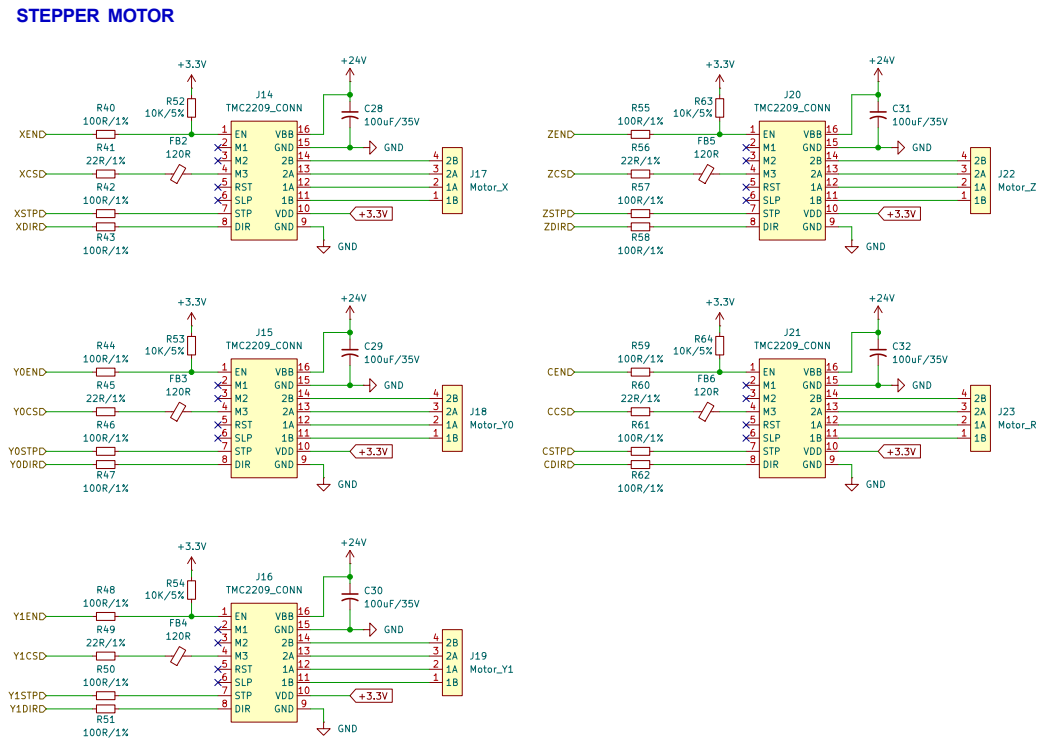
[picture p45: page 11]

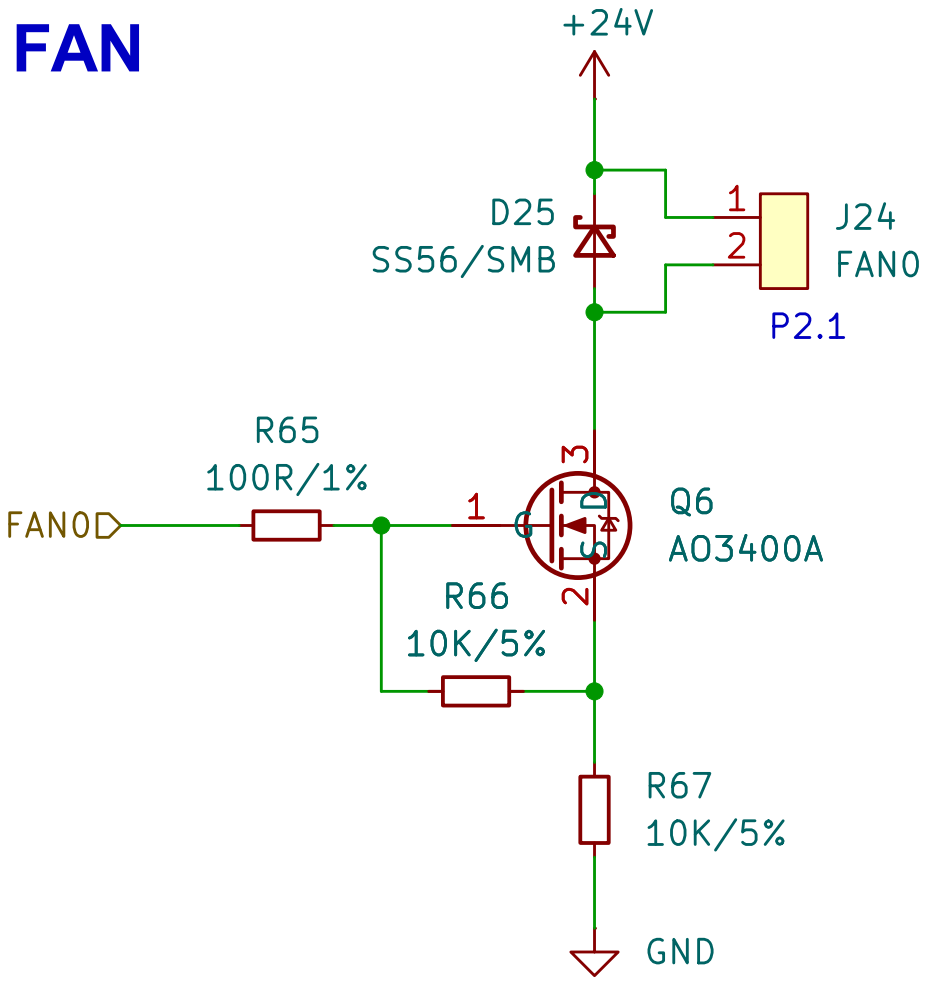
[picture p46: page 12]

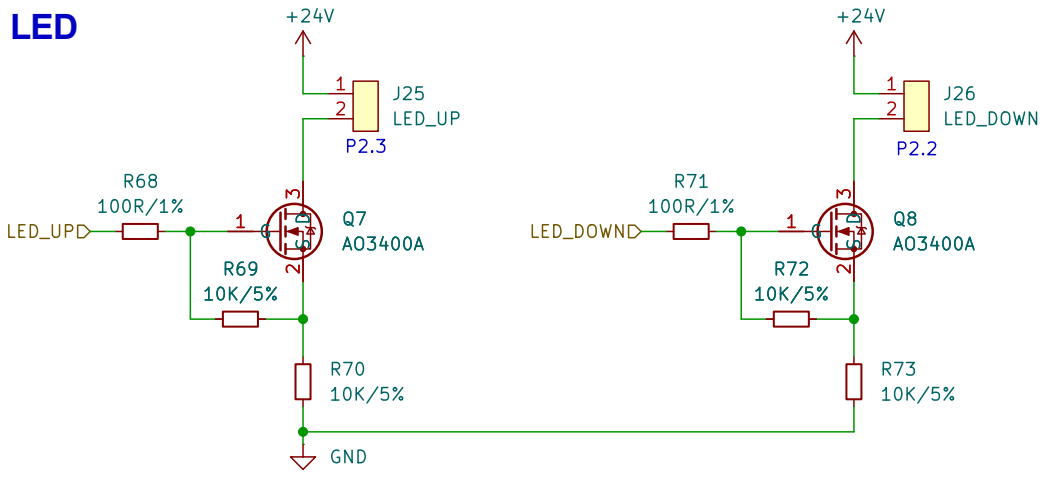
[picture p47: page 13]
