tominhcuong2041505-sys/SMT-Pick-and-Place/PCB/2026-08-03/LBoizPnP_Schematic_2026-08-02.pdf

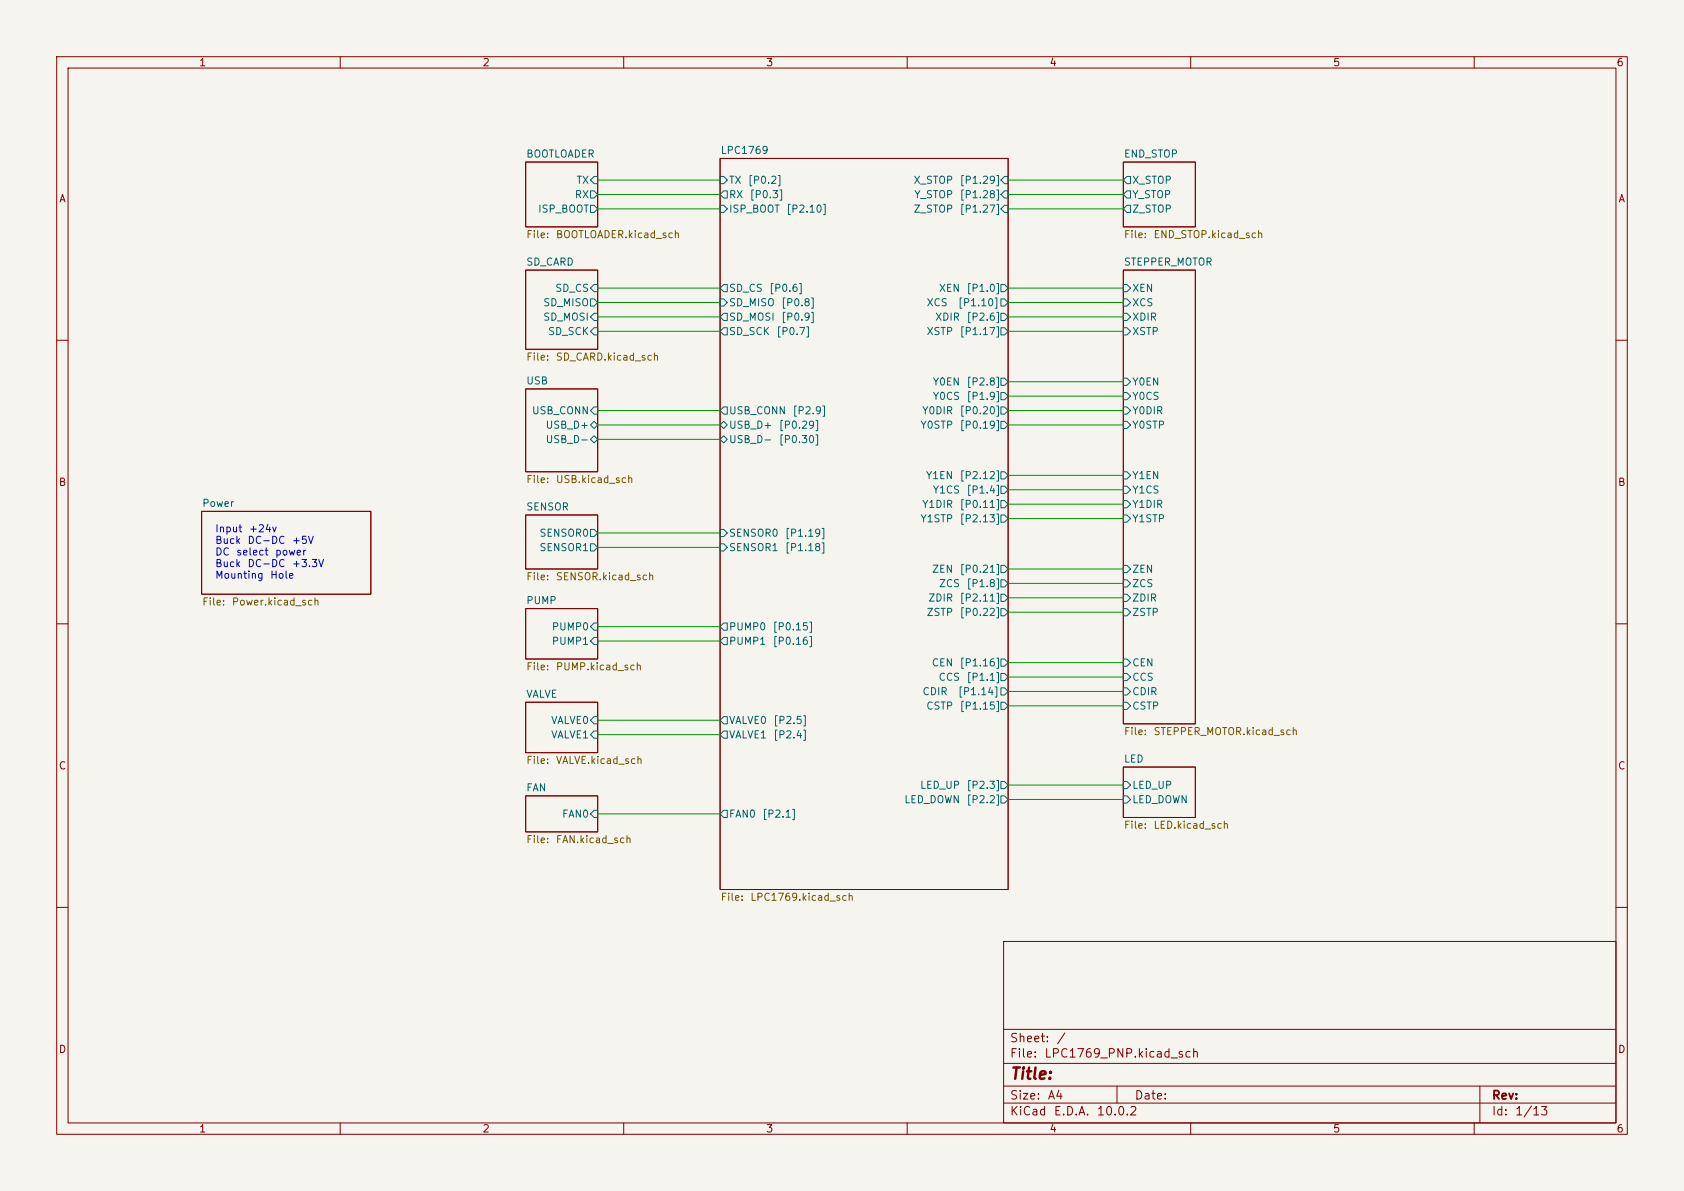
[picture p48: page 1]

Input +24v Buck DC-DC +5V DC select power Buck DC-DC +3.3V Mounting Hole

File: STEPPER_MOTOR.kicad_sch CCS [P1.1] CDIR [P1.14] CEN [P1.16] CSTP [P1.15] FAN0 [P2.1]

Size: A4 | Rev:
KiCad E.D.A. 10.0.2 | Id: 1/13

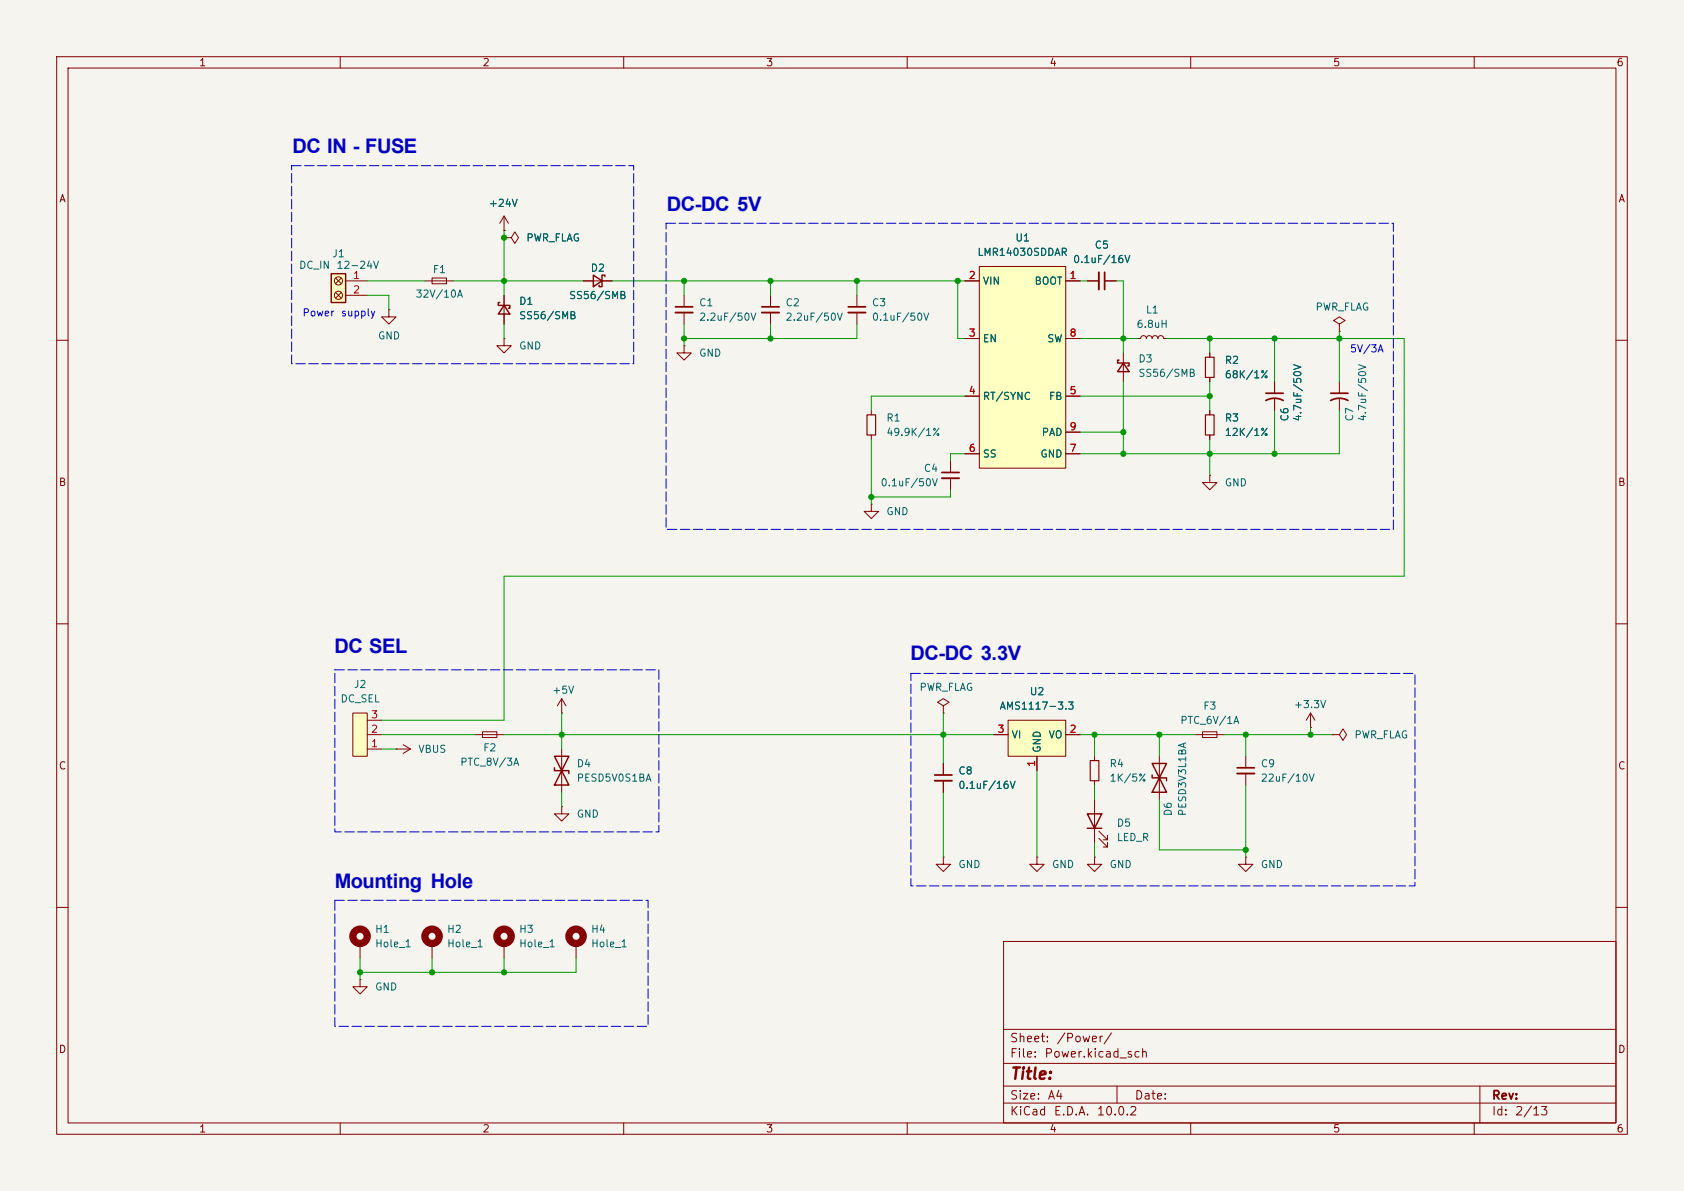
[picture p49: page 2]

GND

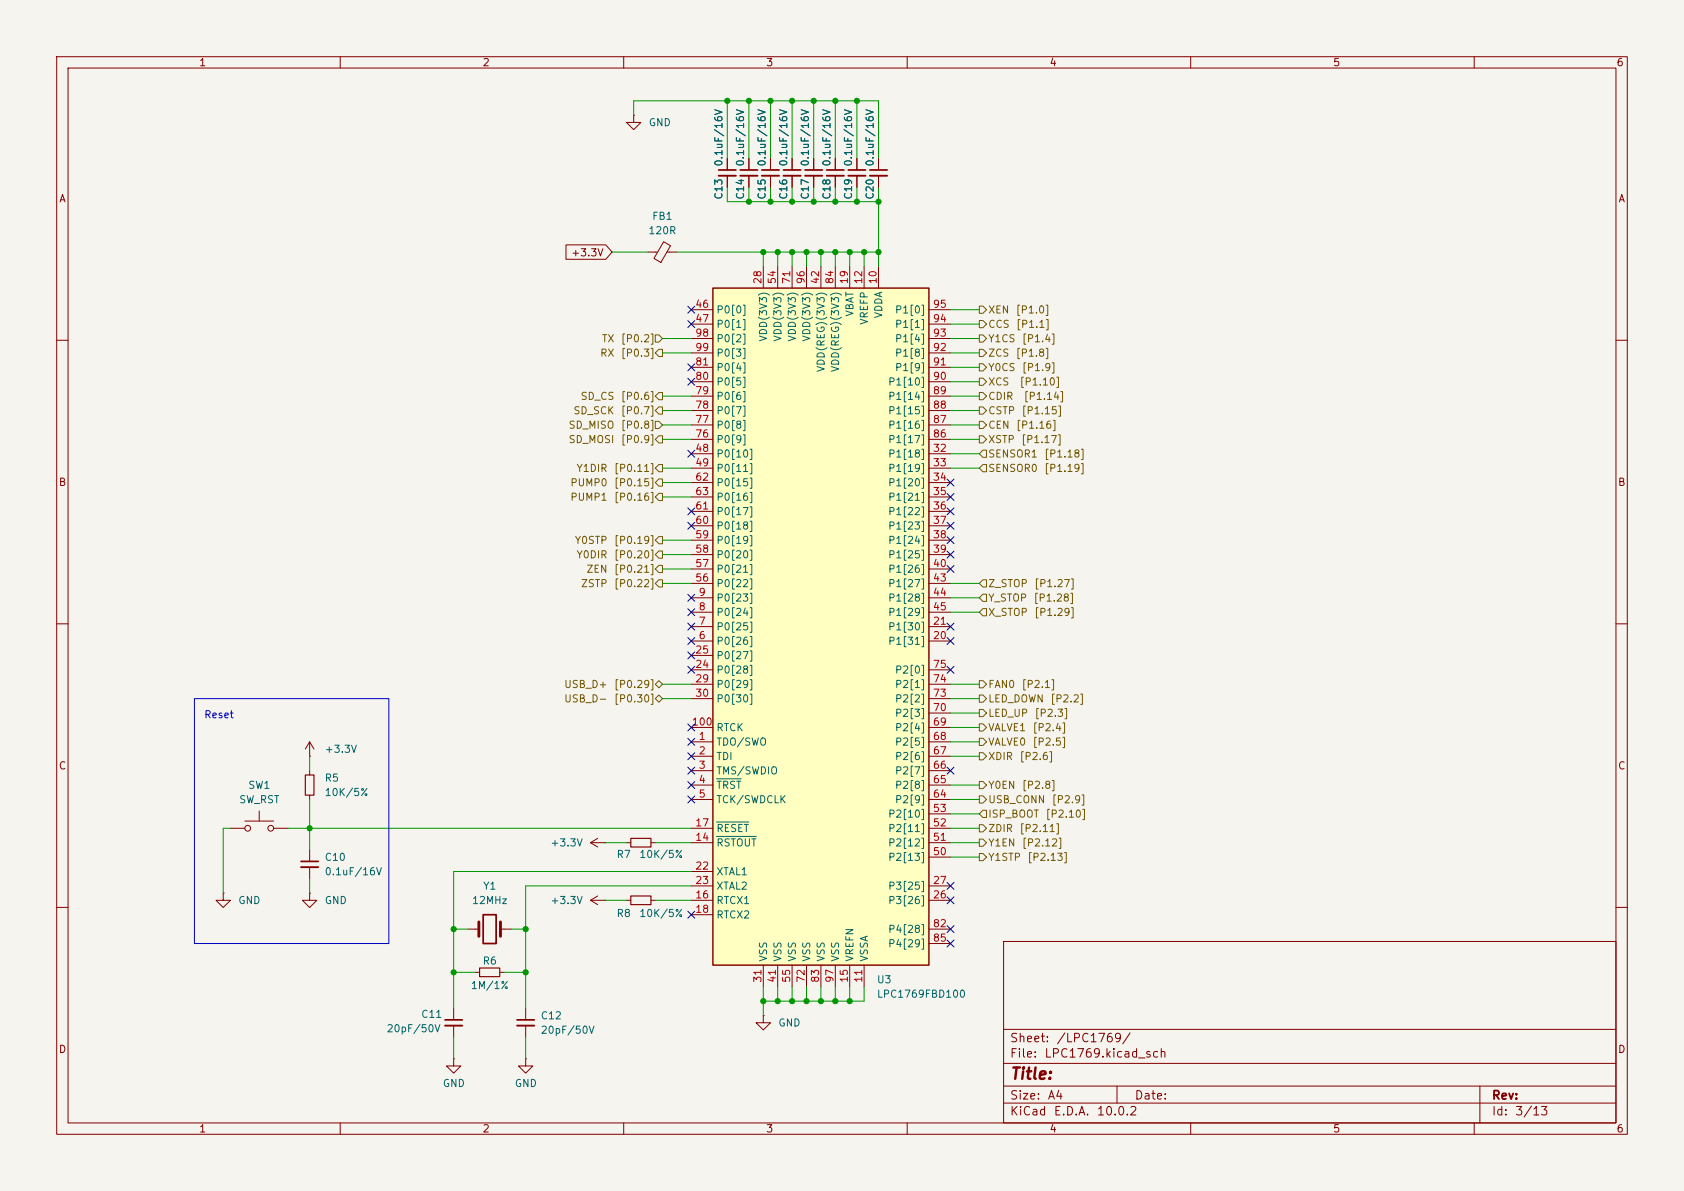
[picture p50: page 3]

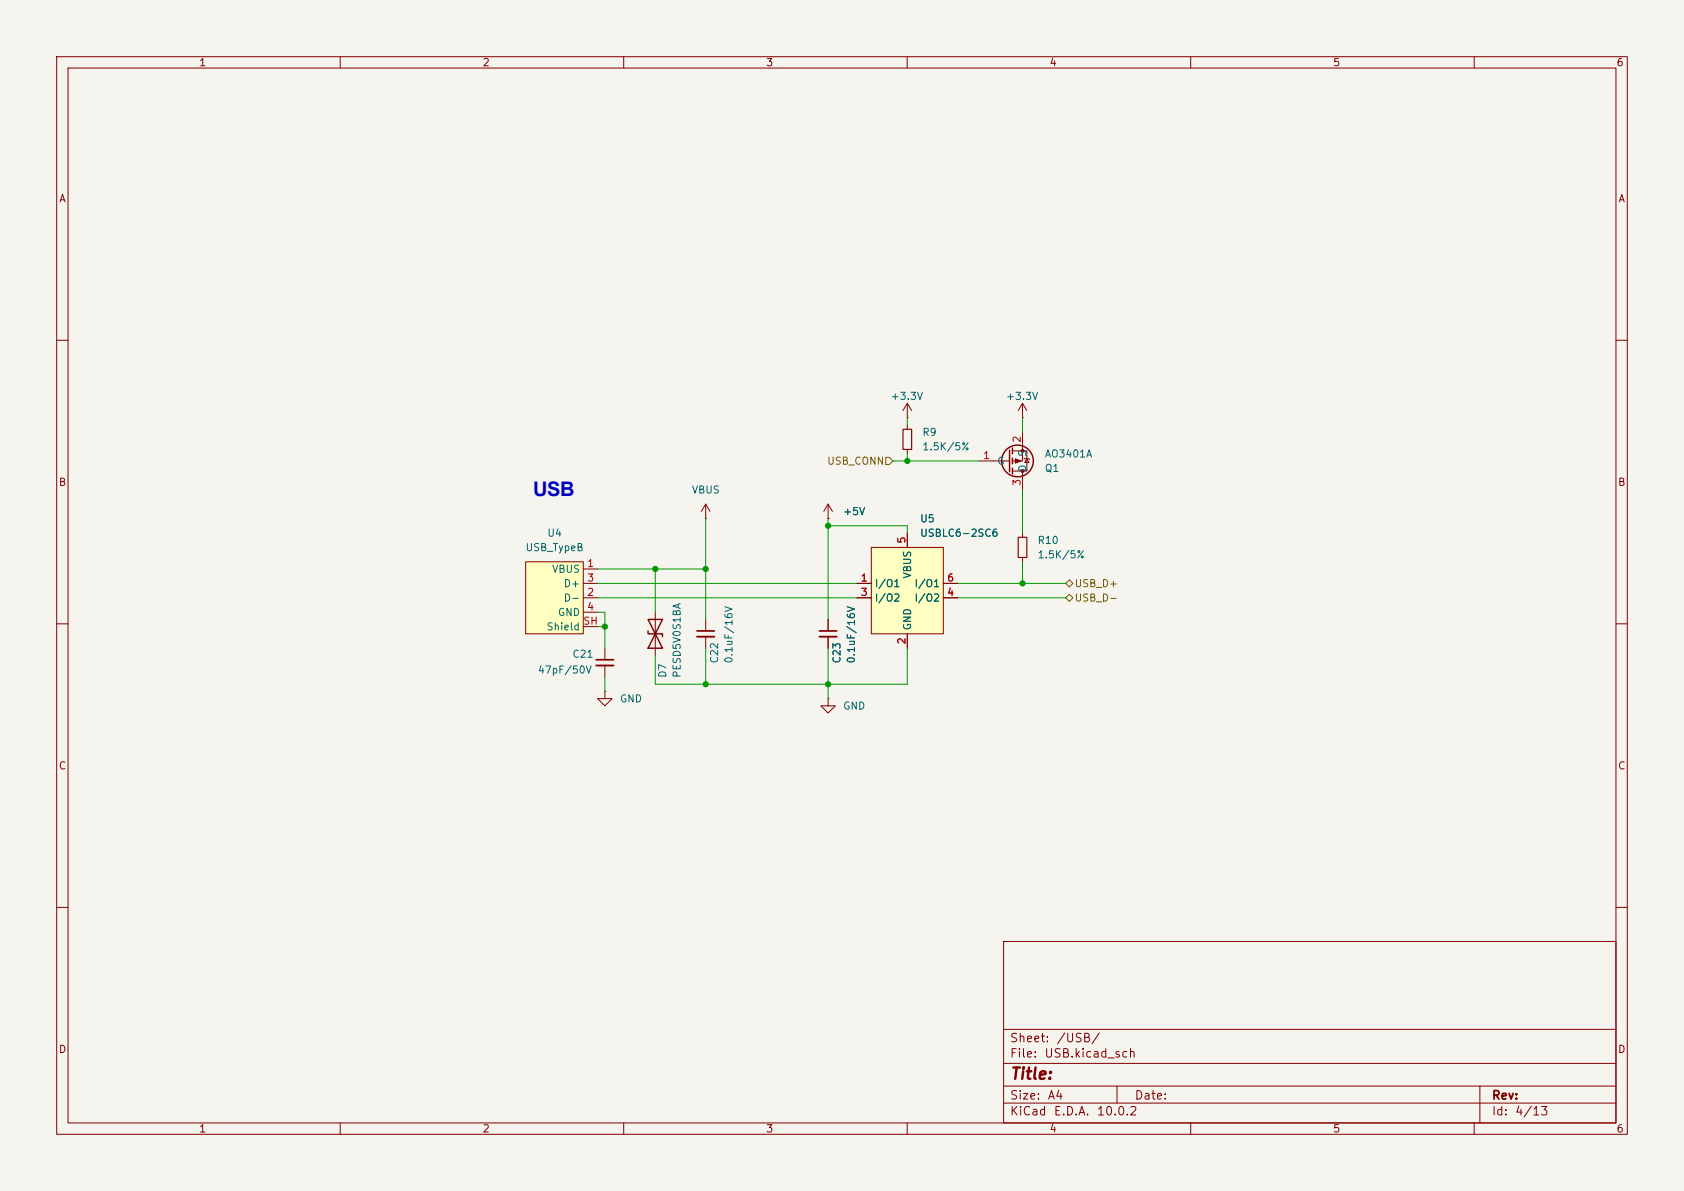
[picture p51: page 4]

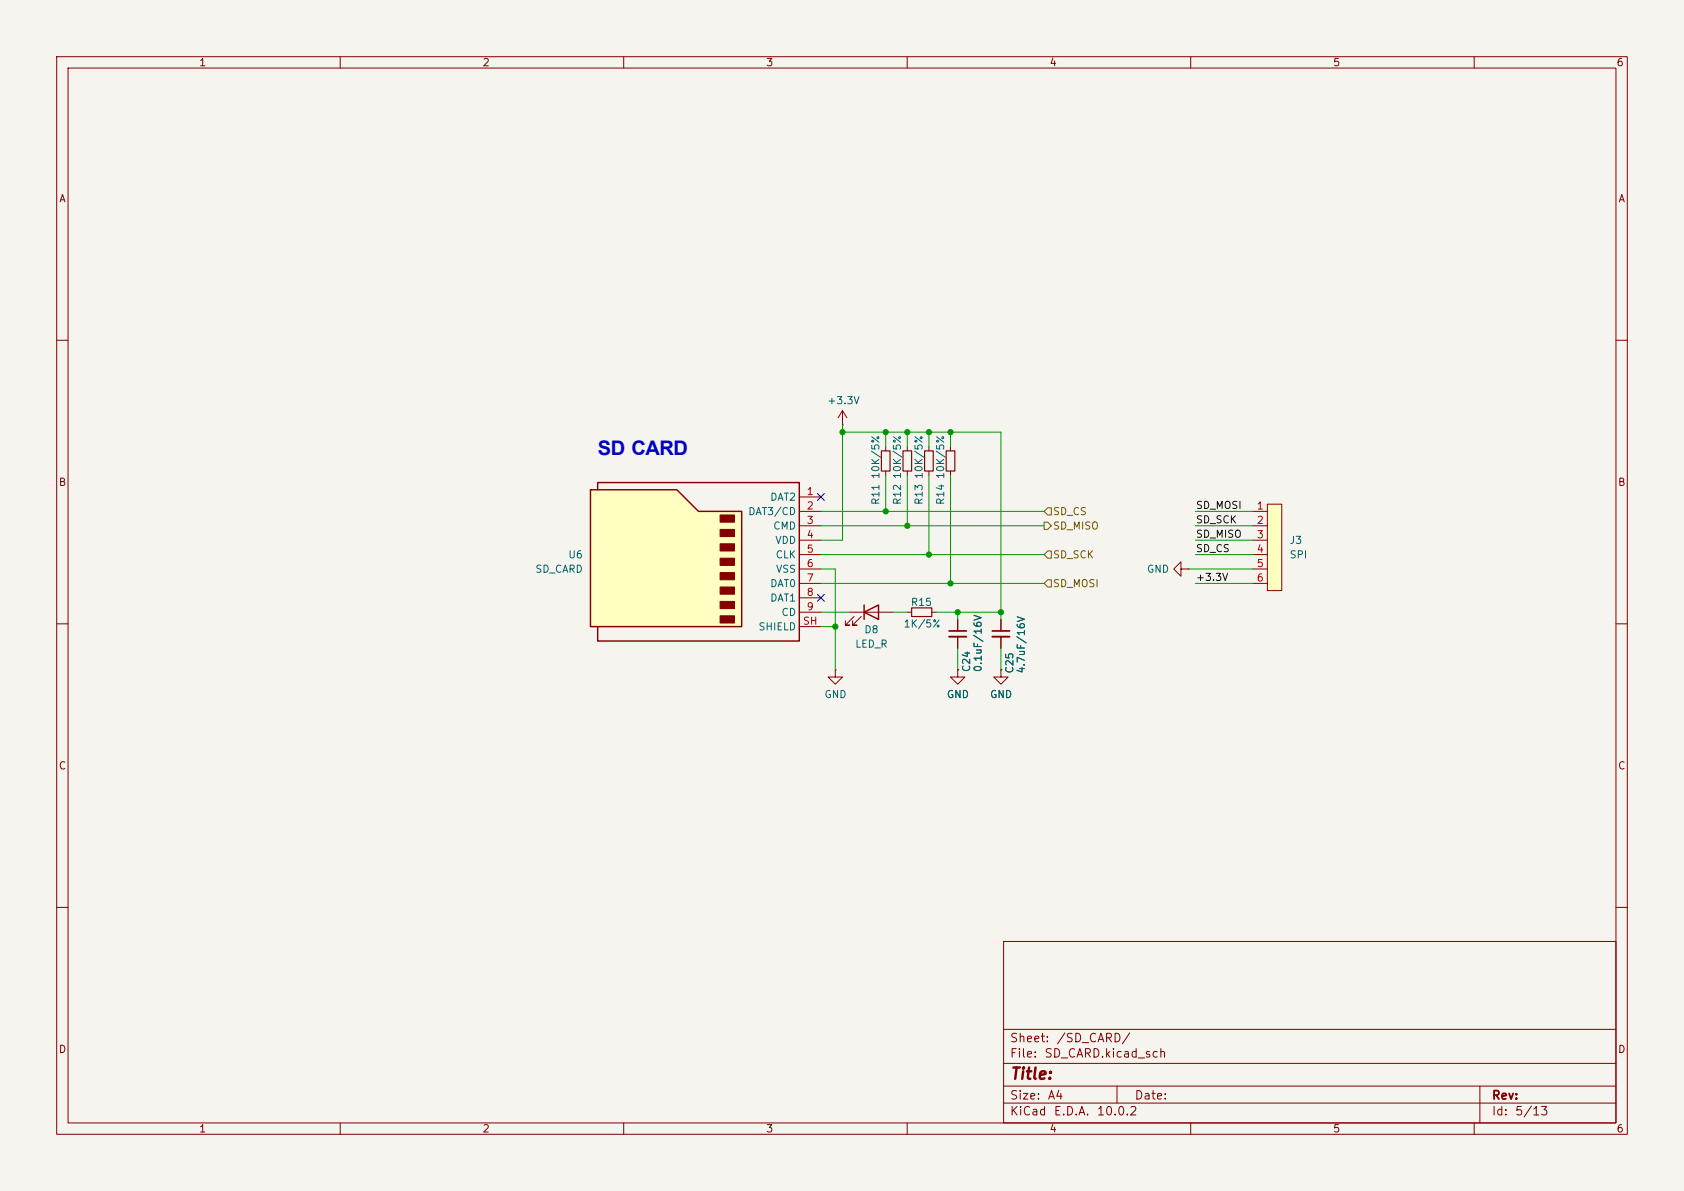
[picture p52: page 5]

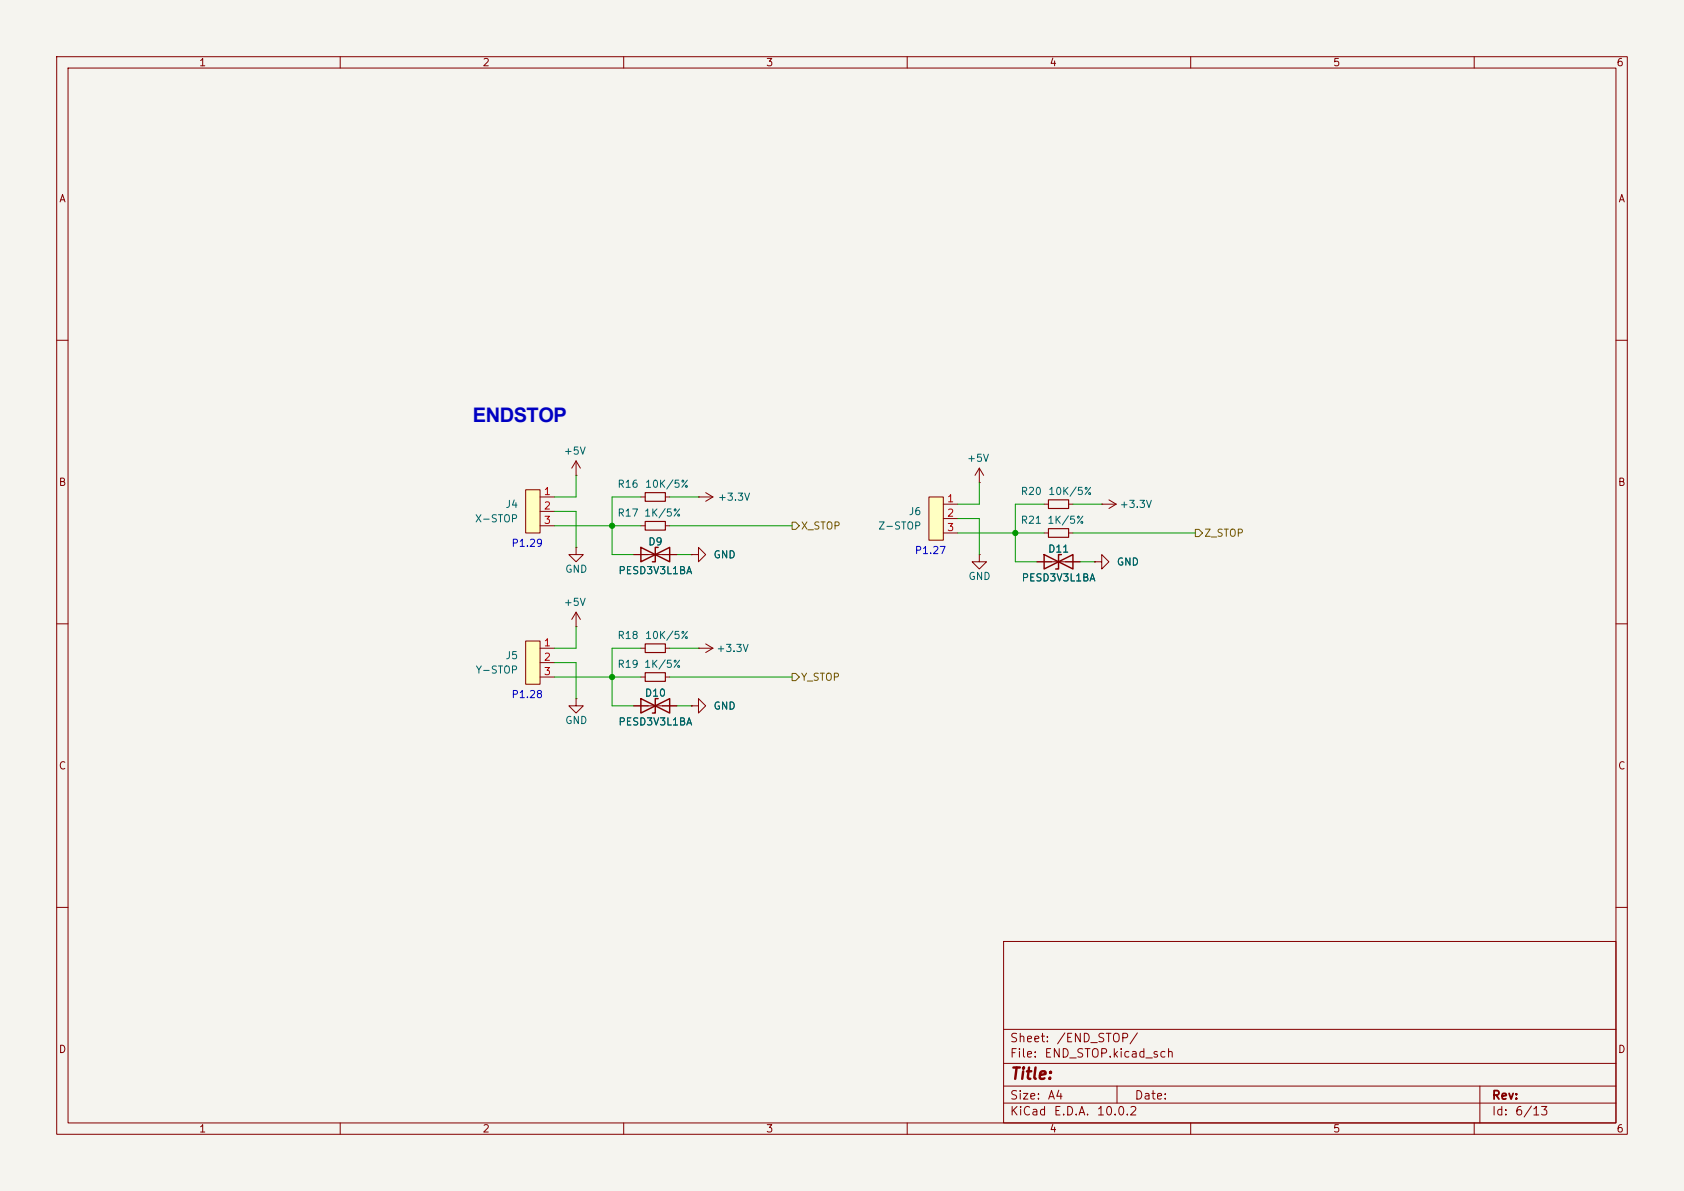
[picture p53: page 6]

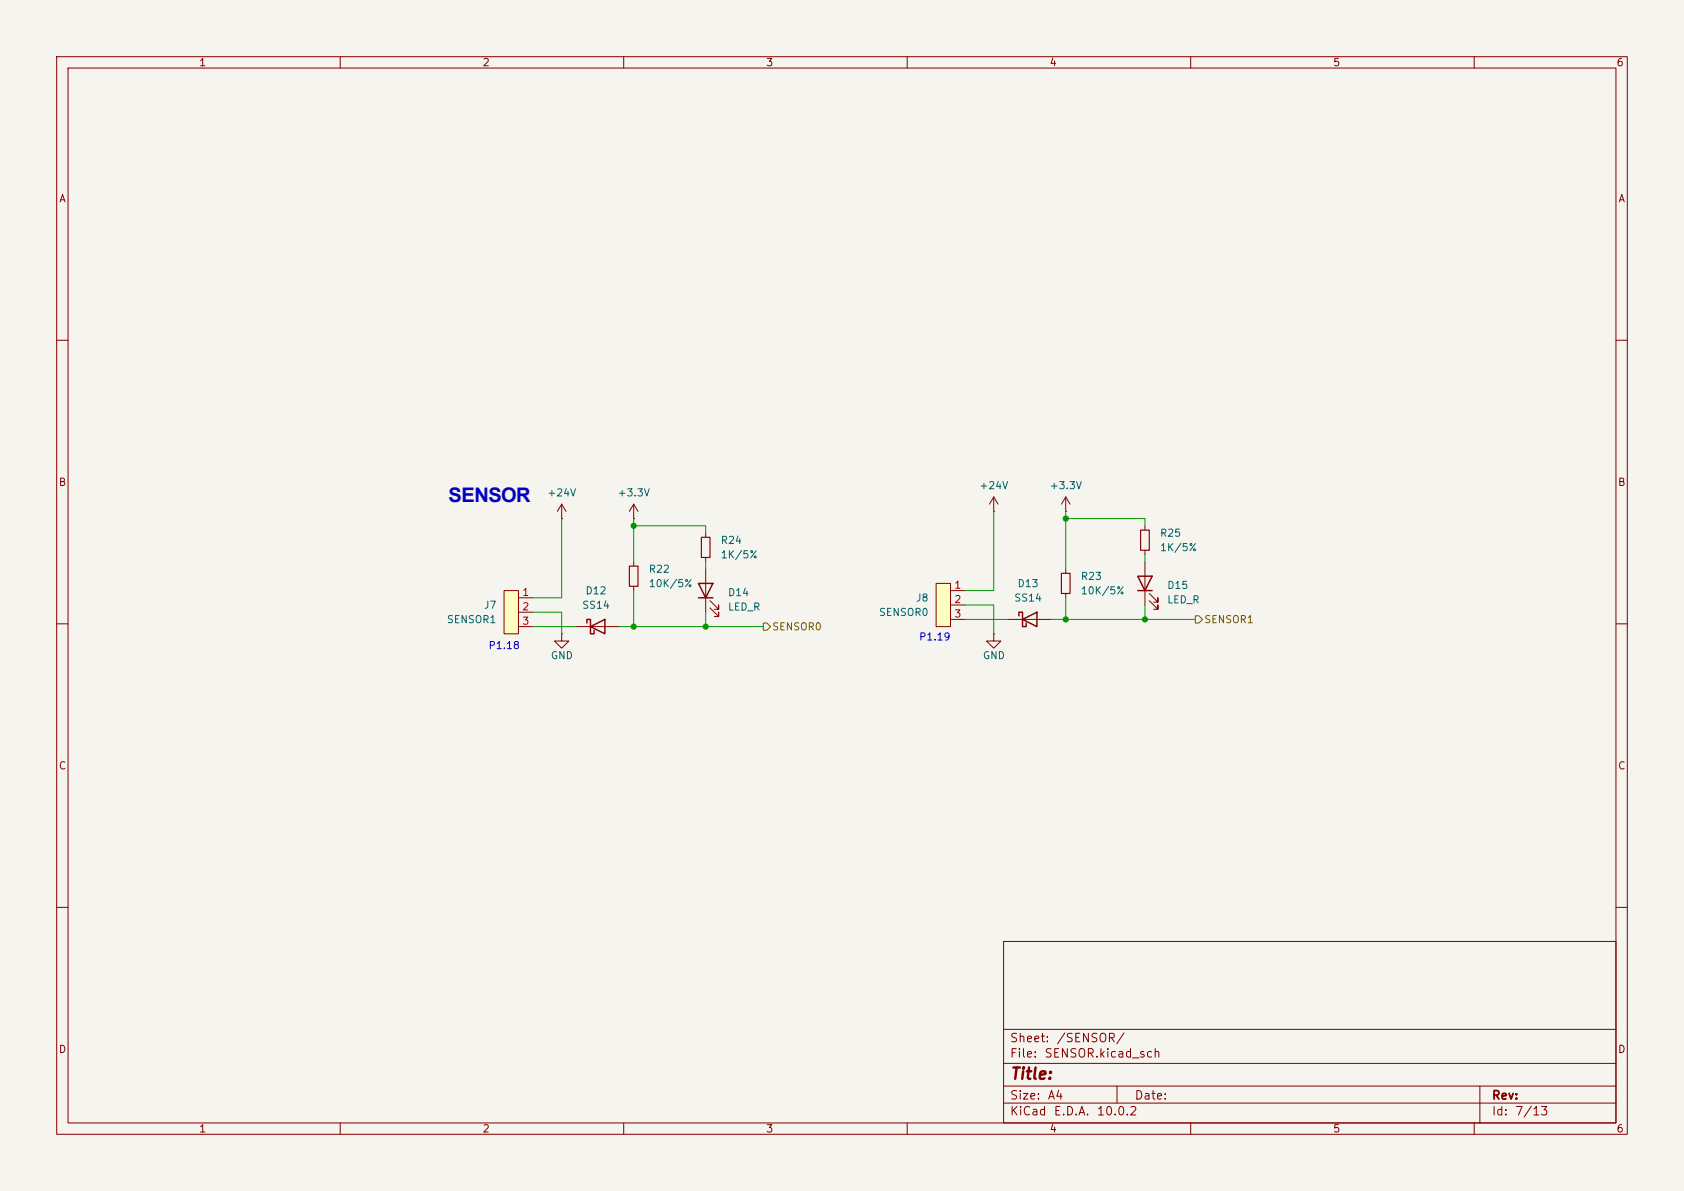
[picture p54: page 7]

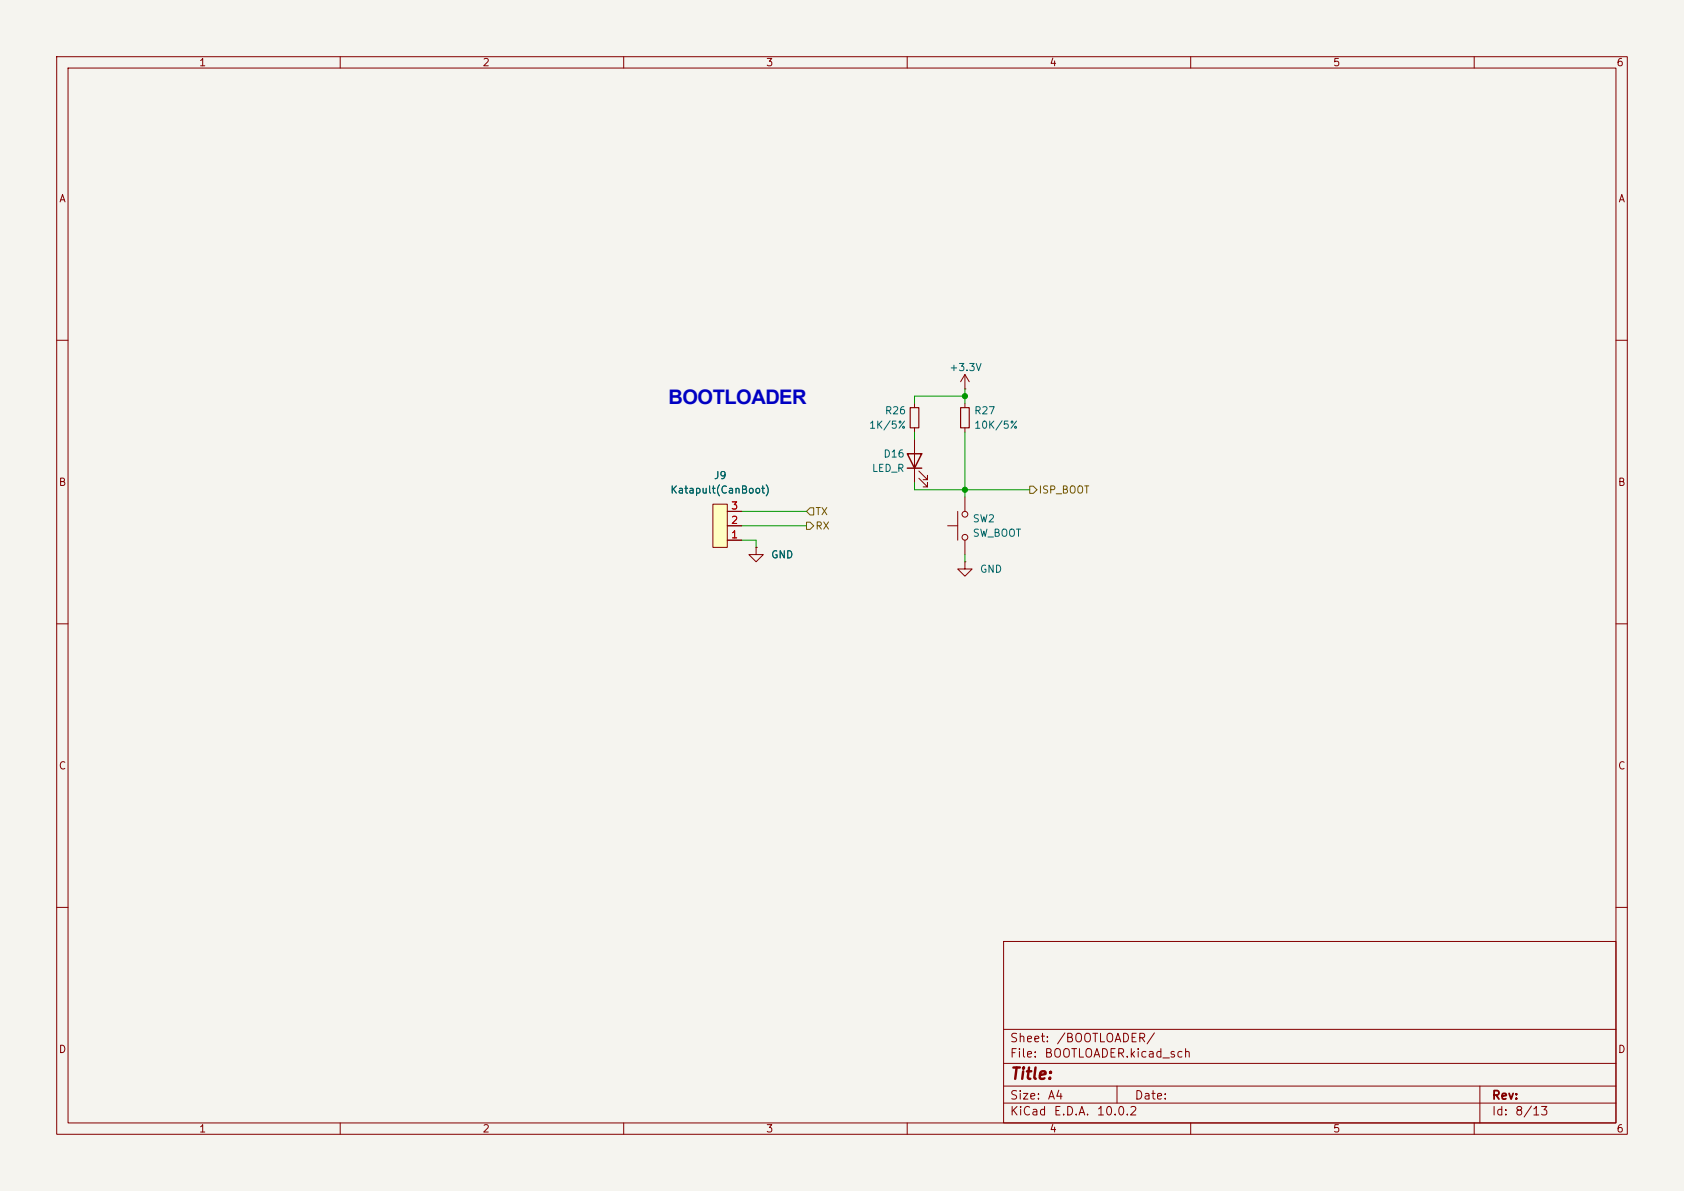
[picture p55: page 8]

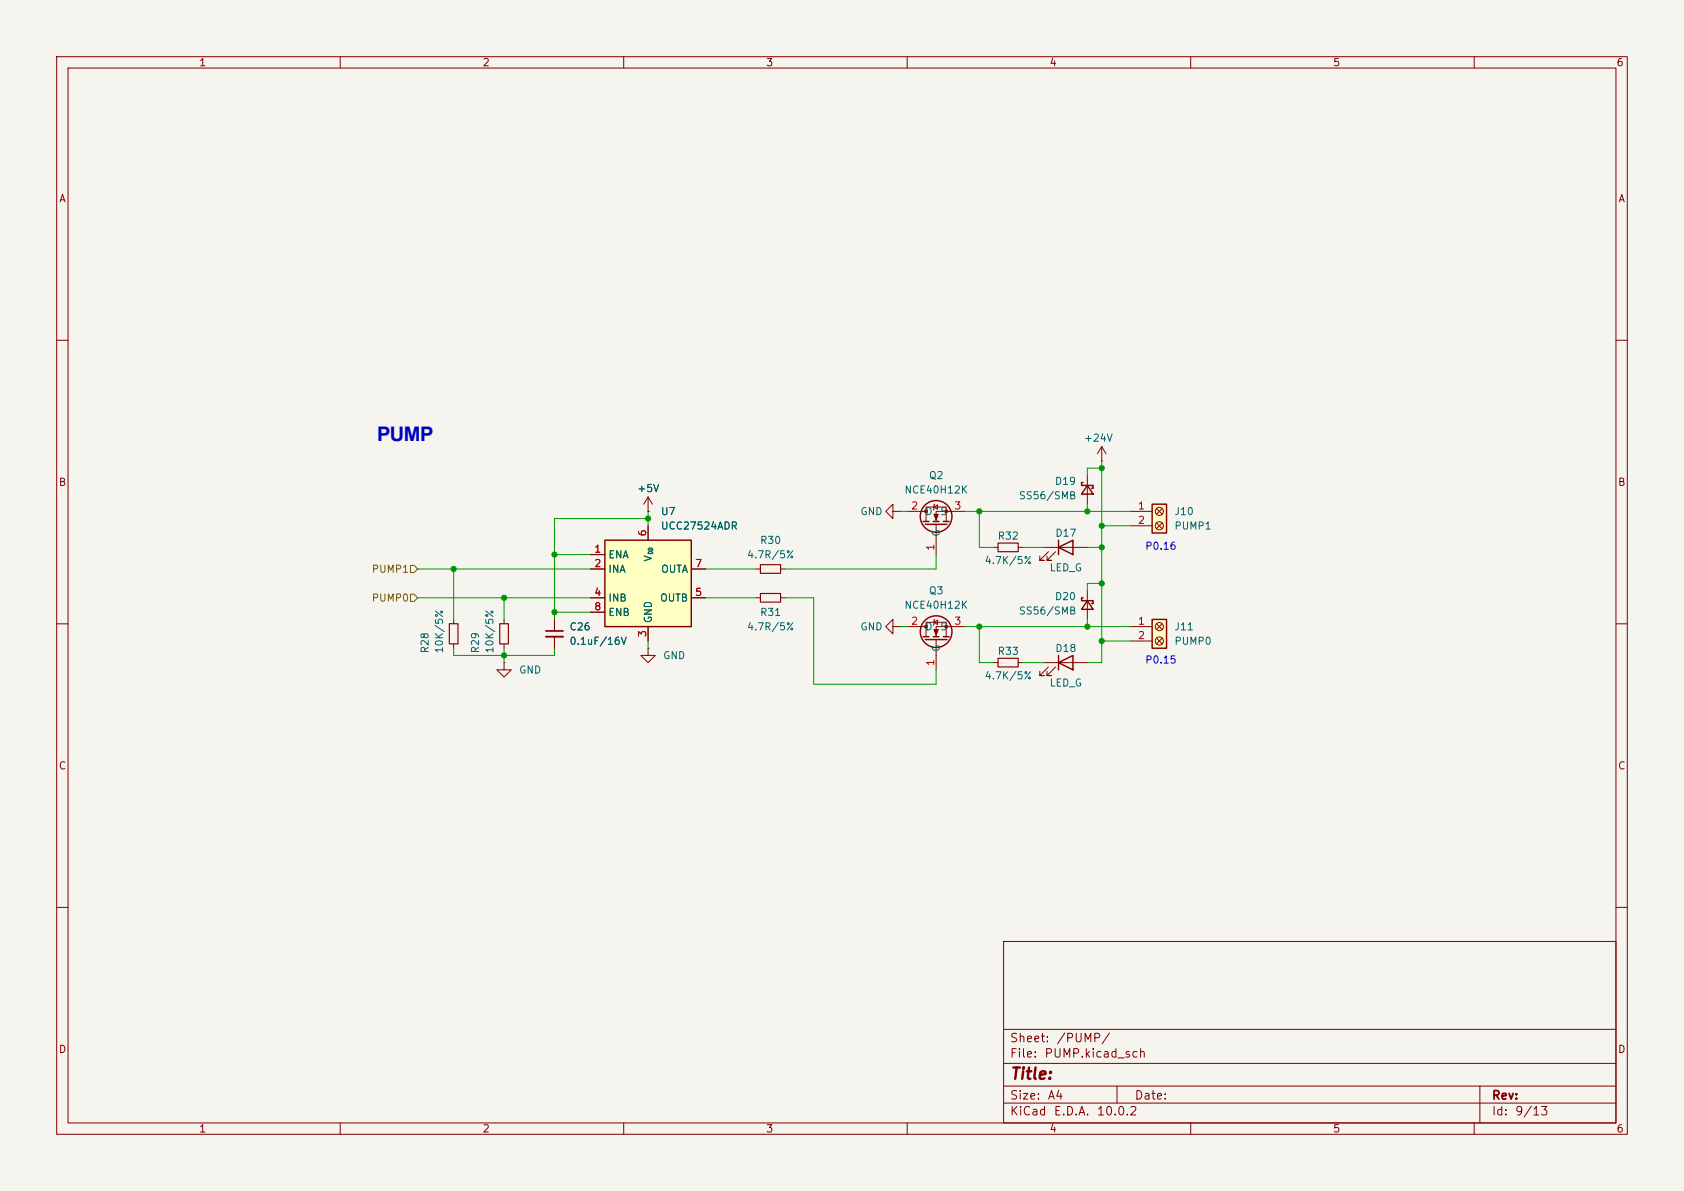
[picture p56: page 9]

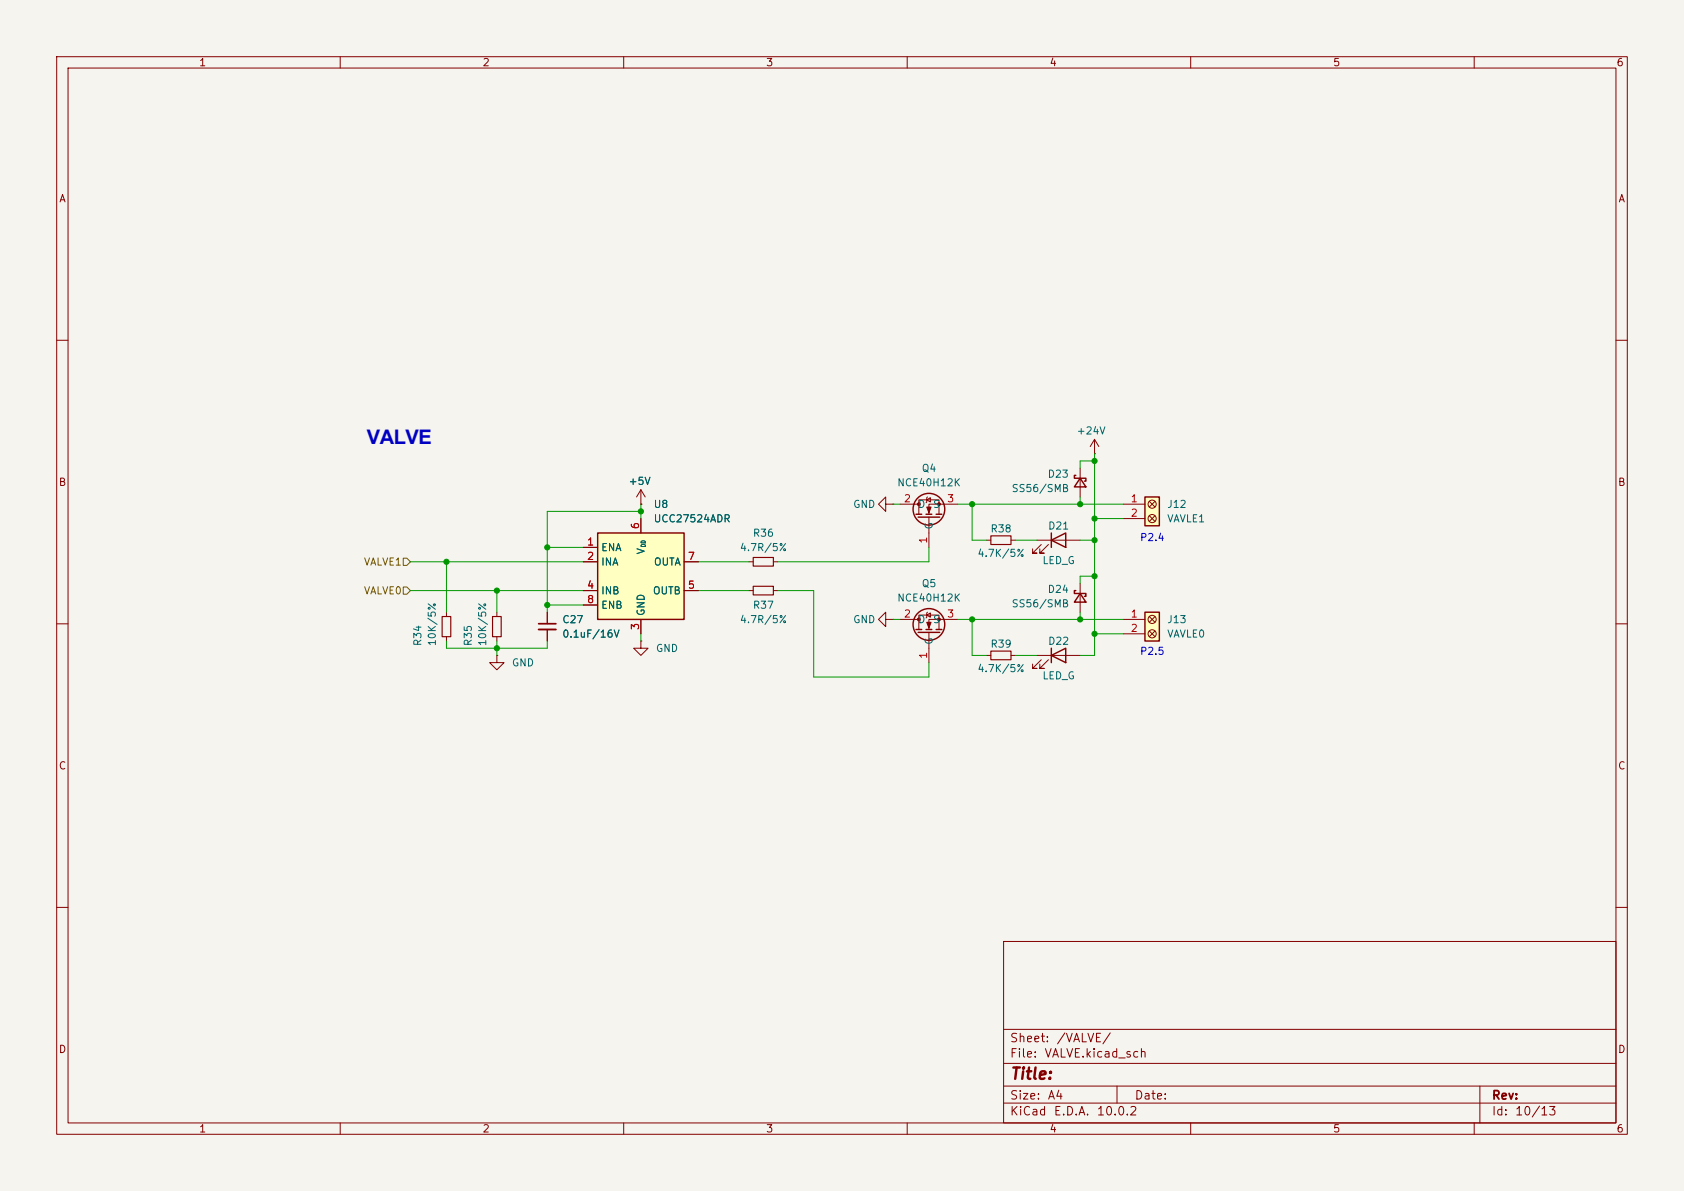
[picture p57: page 10]

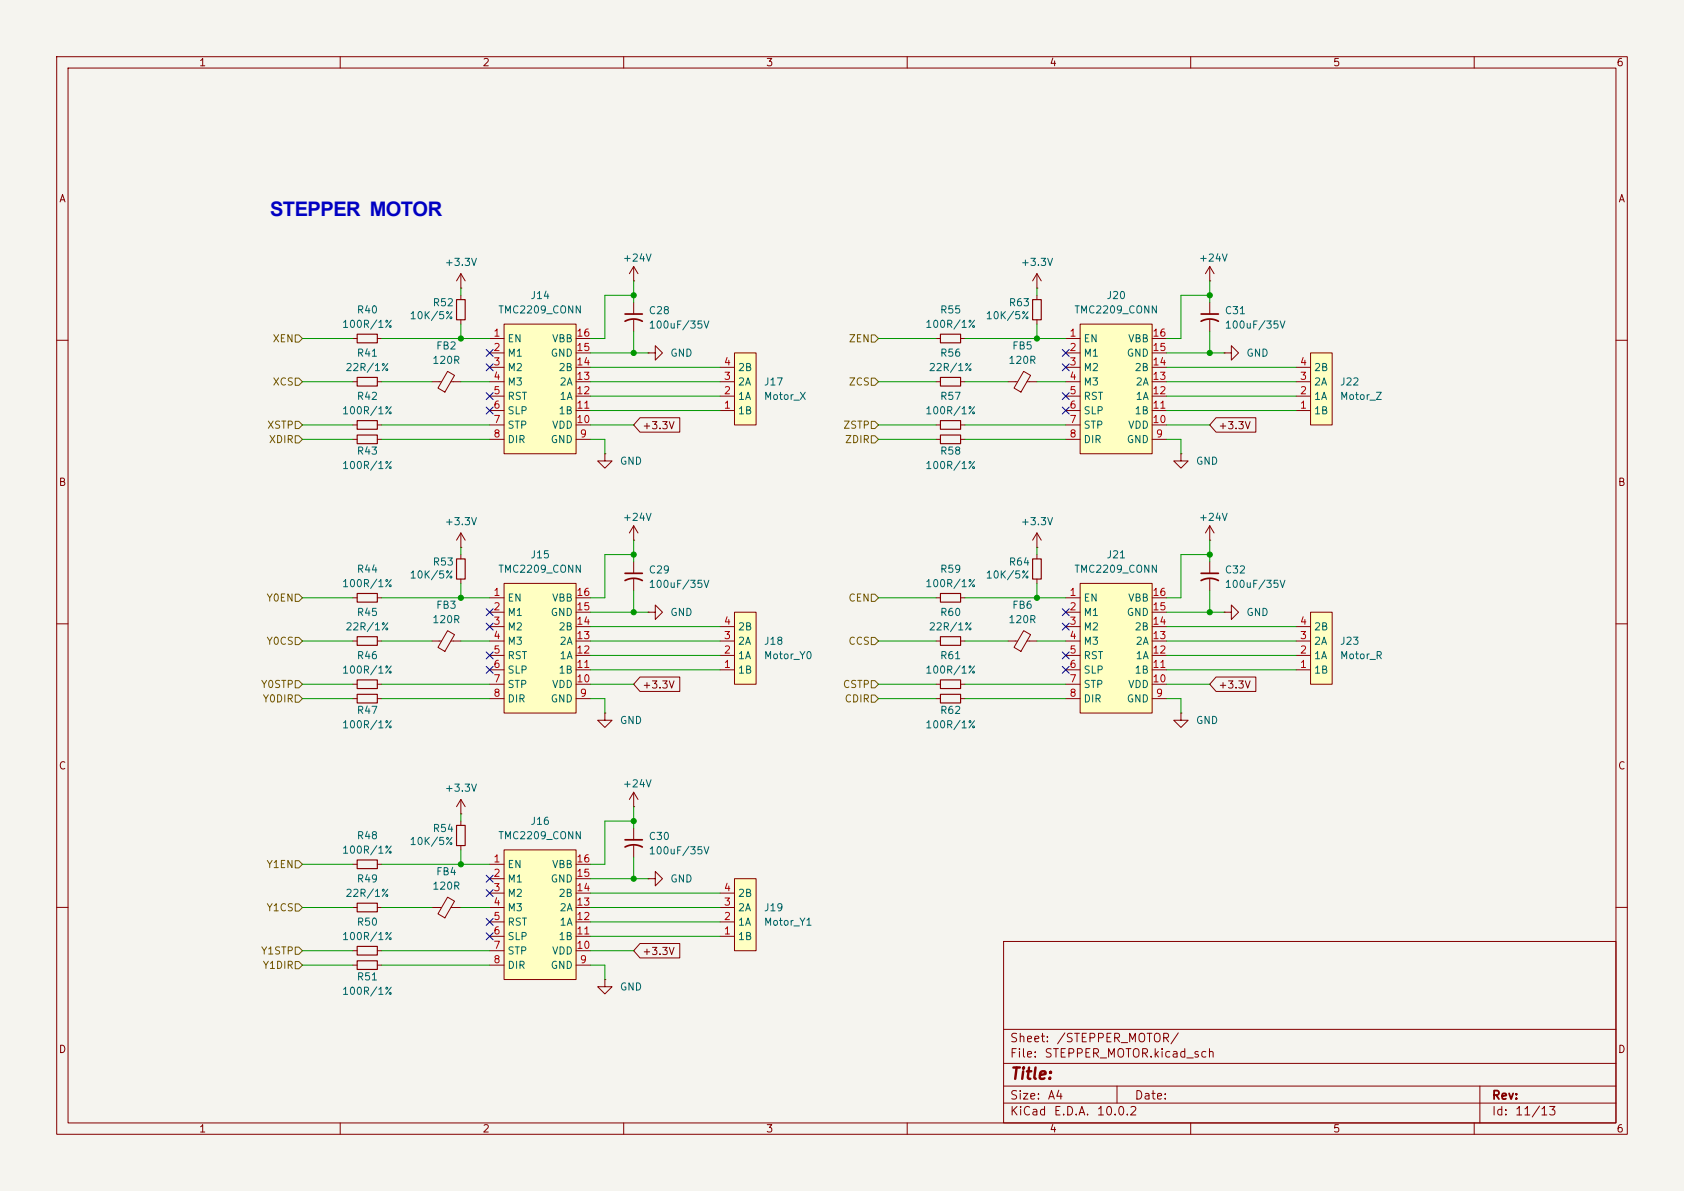
[picture p58: page 11]

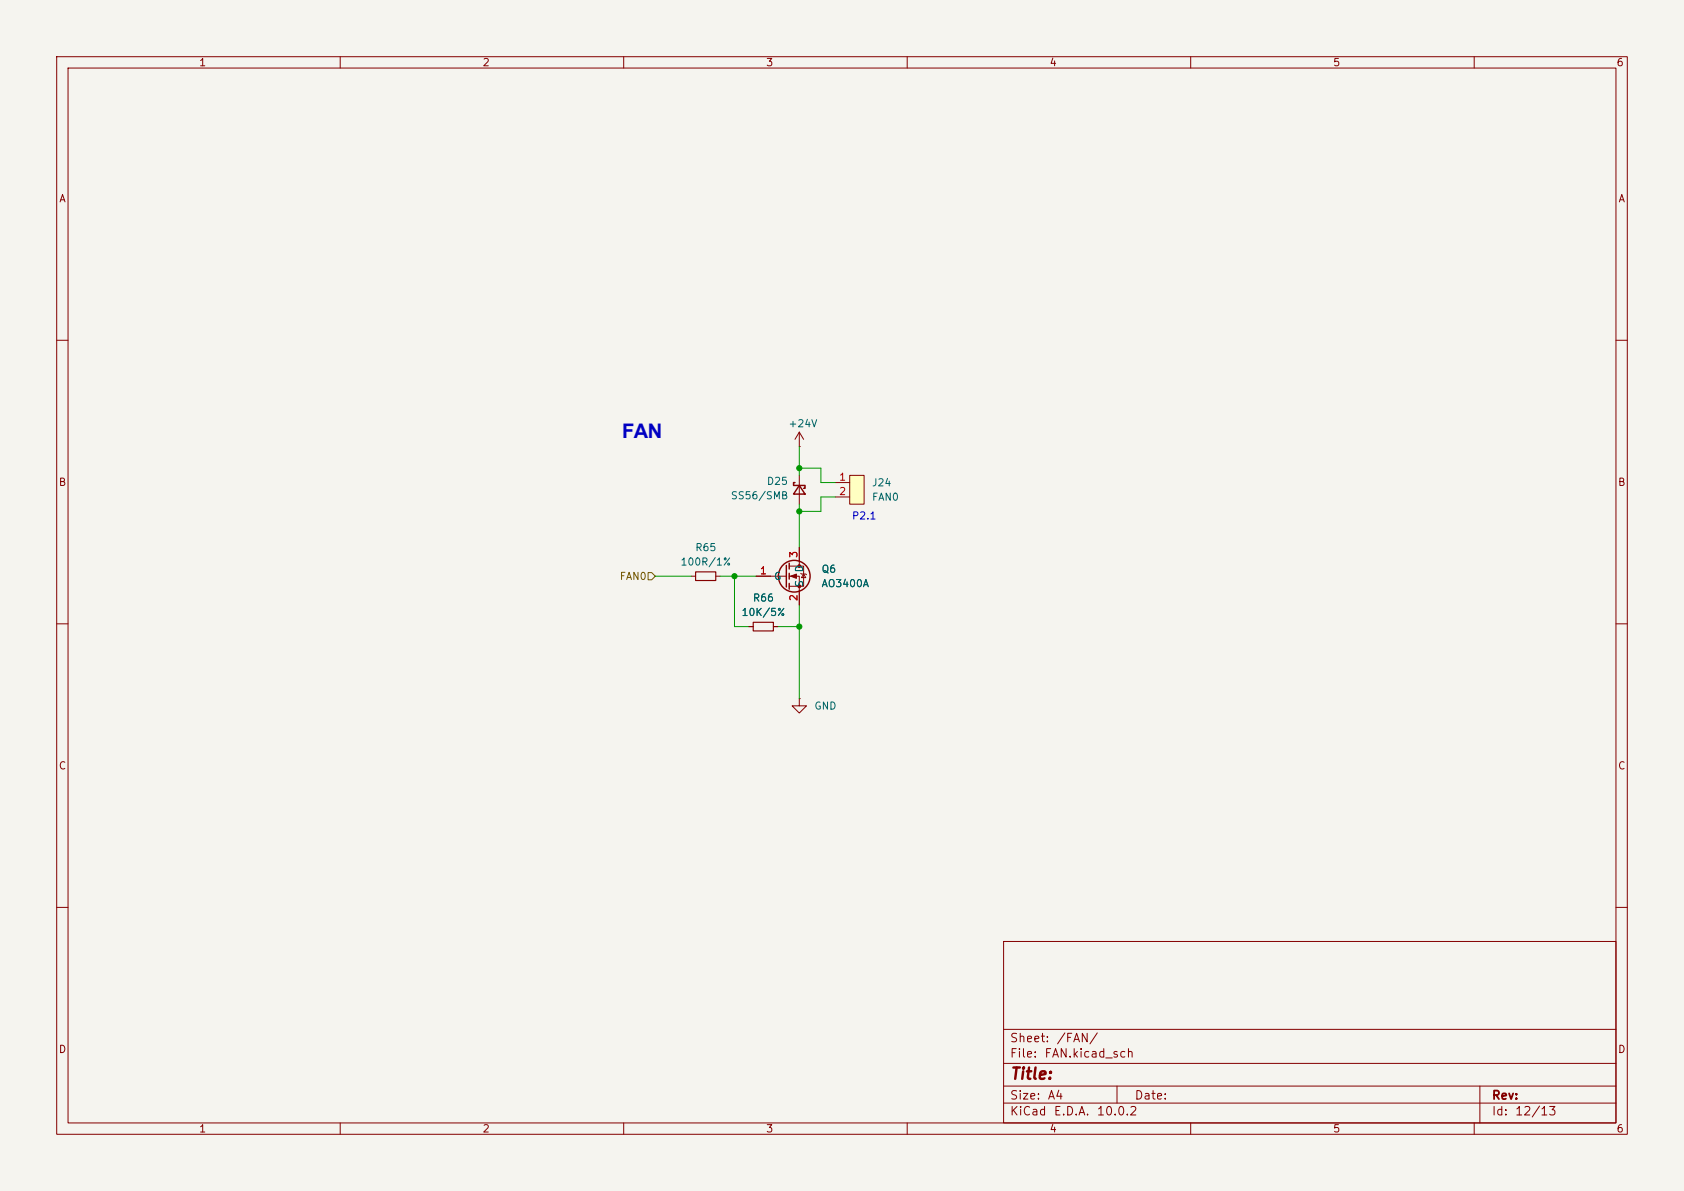
[picture p59: page 12]

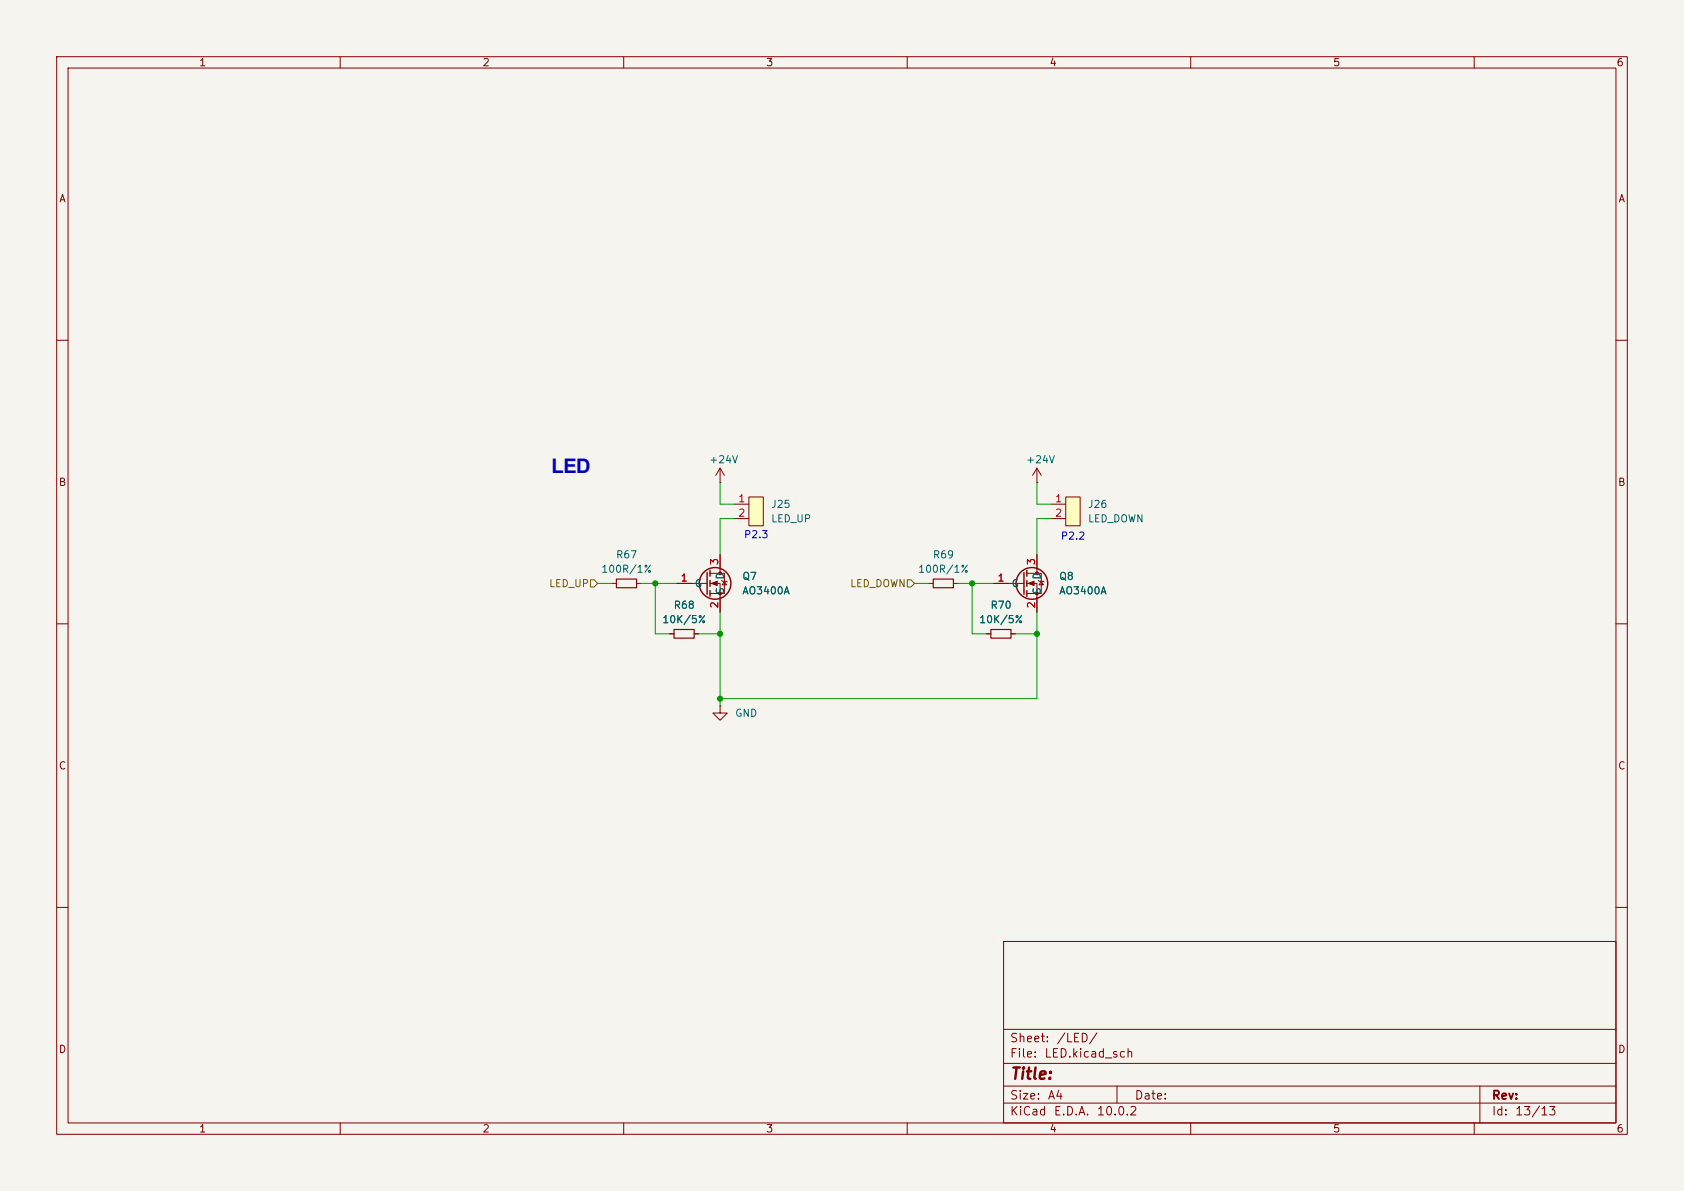
[picture p60: page 13]
