tominhcuong2041505-sys/SMT-Pick-and-Place/PCB/2026-08-28/LBoizPnP_Schematic_2026-08-28.pdf

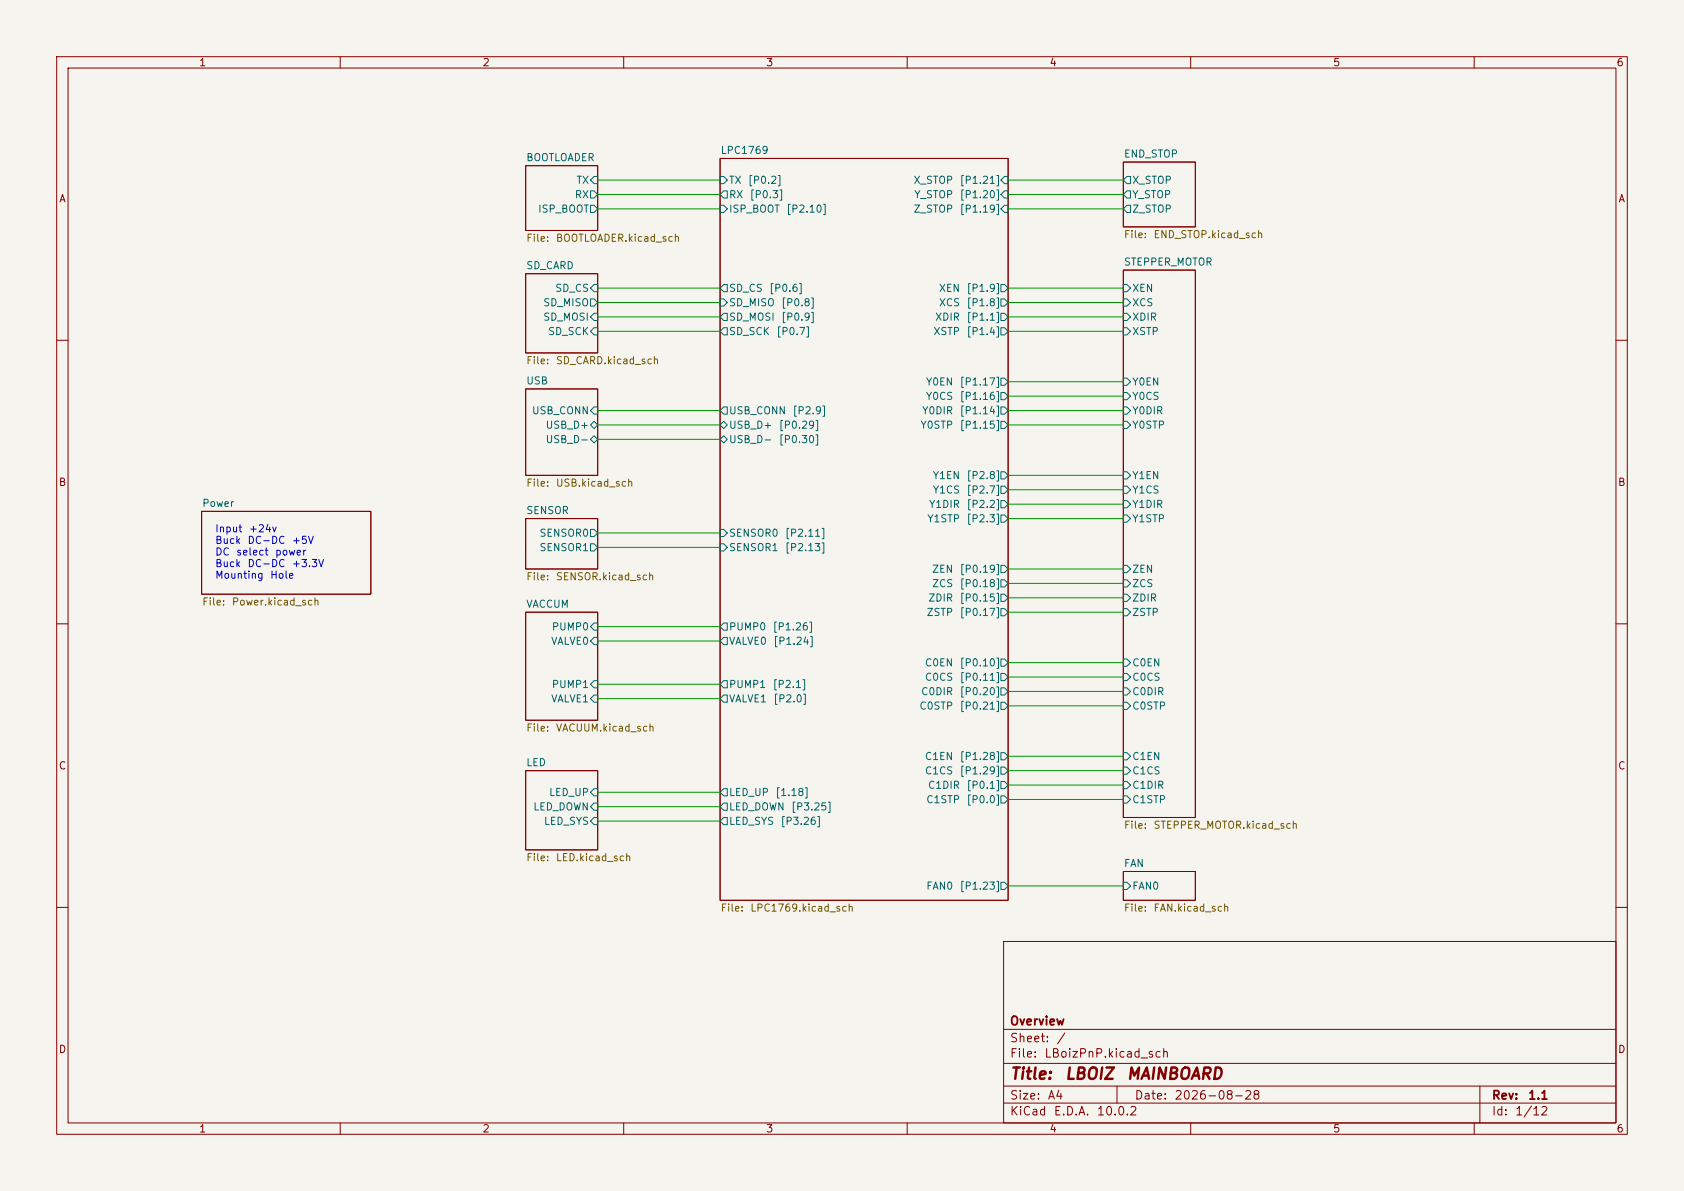
[picture p61: page 1]

Input +24v Buck DC-DC +5V DC select power Buck DC-DC +3.3V Mounting Hole

Size: A4 | Rev: 1.1
KiCad E.D.A. 10.0.2 | Id: 1/12

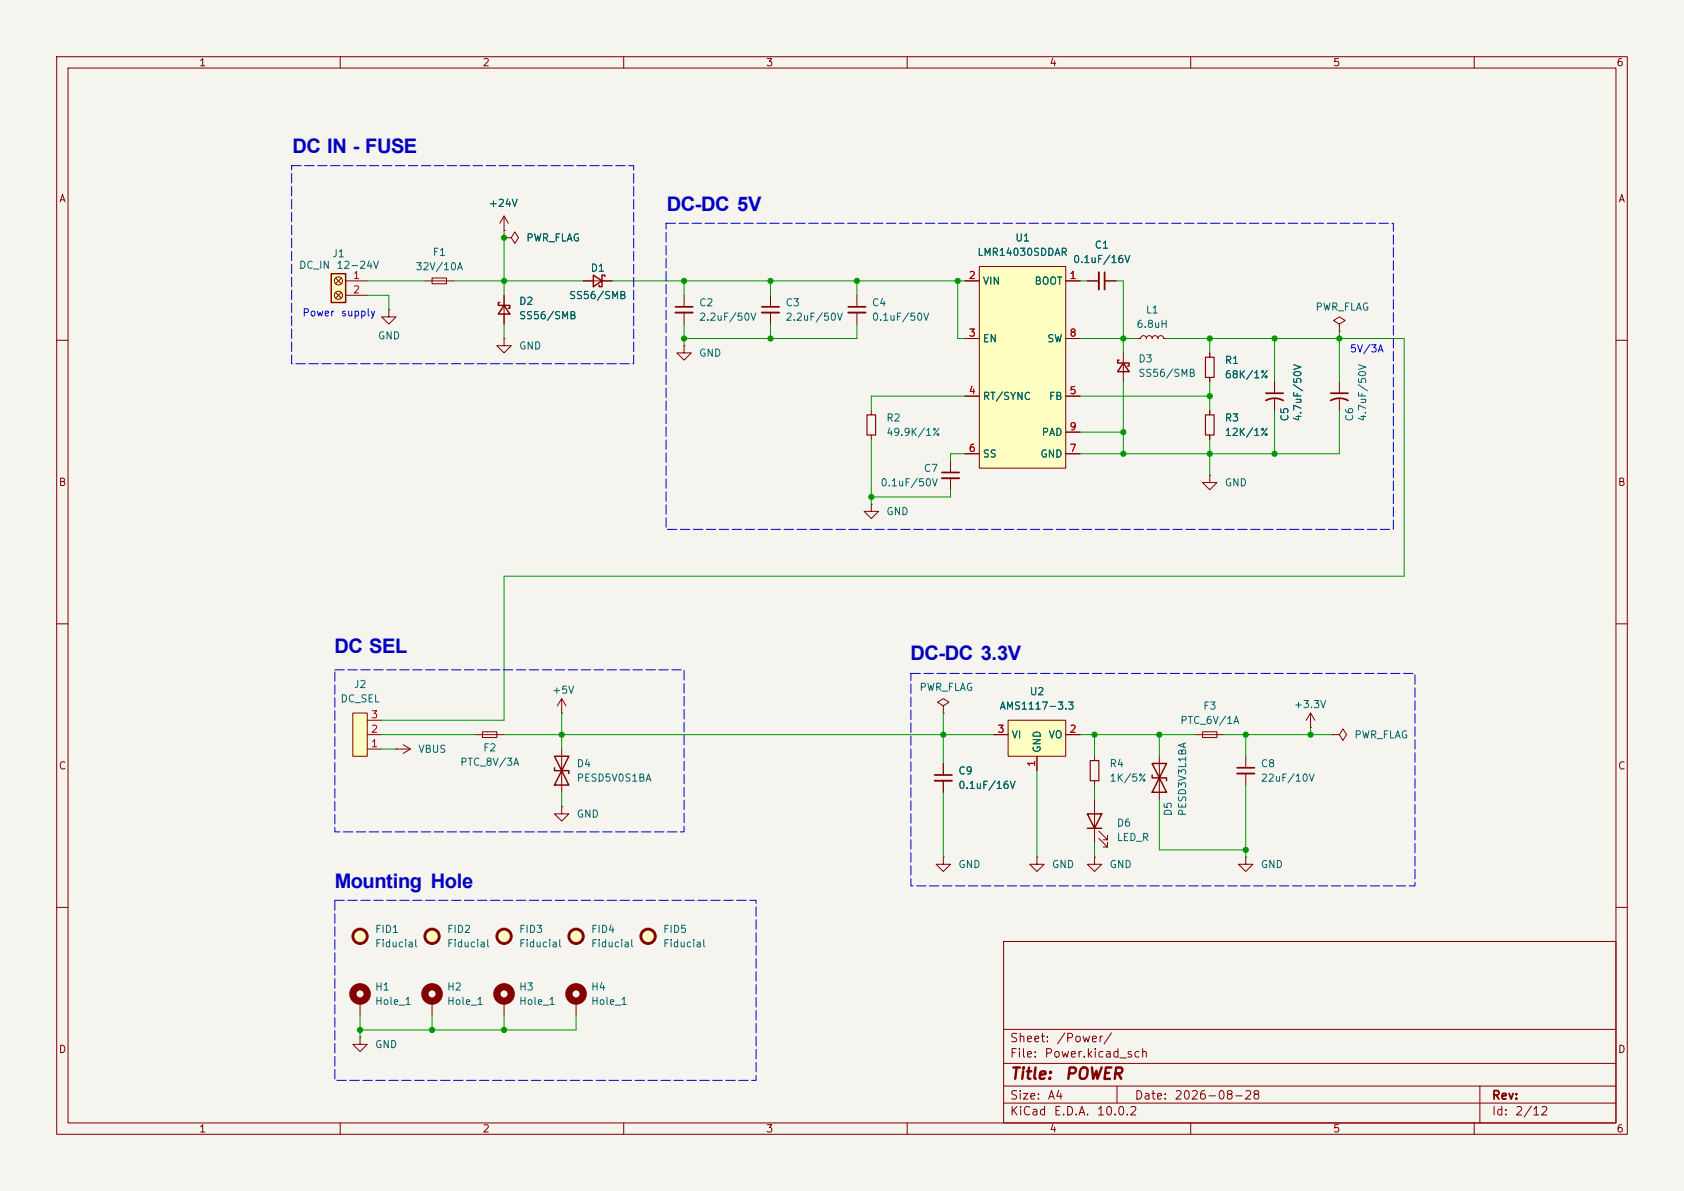
[picture p62: page 2]

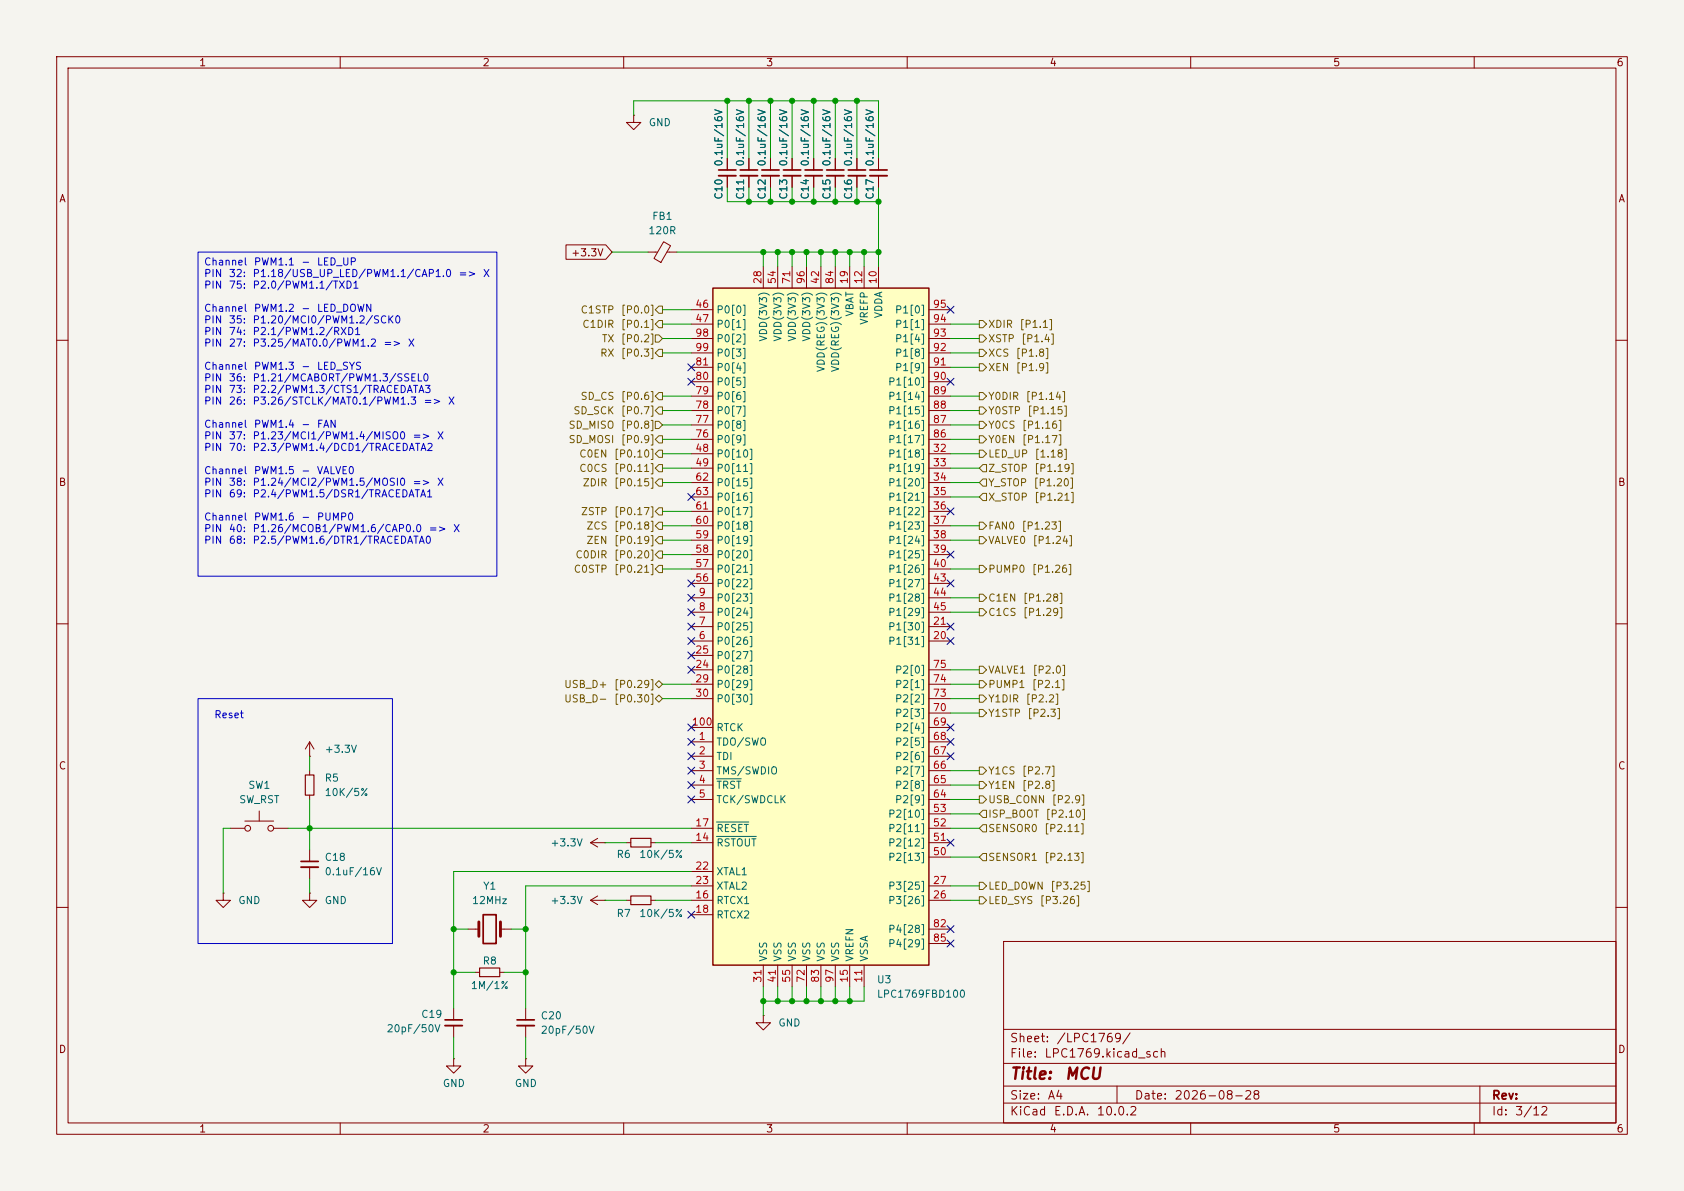
[picture p63: page 3]

PIN 35: P1.20/MCI0/PWM1.2/SCK0 PIN 74: P2.1/PWM1.2/RXD1 PIN 27: P3.25/MAT0.0/PWM1.2 => X Channel PWM1.3 - LED_SYS PIN 36: P1.21/MCABORT/PWM1.3/SSEL0 PIN 73: P2.2/PWM1.3/CTS1/TRACEDATA3 PIN 26: P3.26/STCLK/MAT0.1/PWM1.3 => X Channel PWM1.4 - FAN

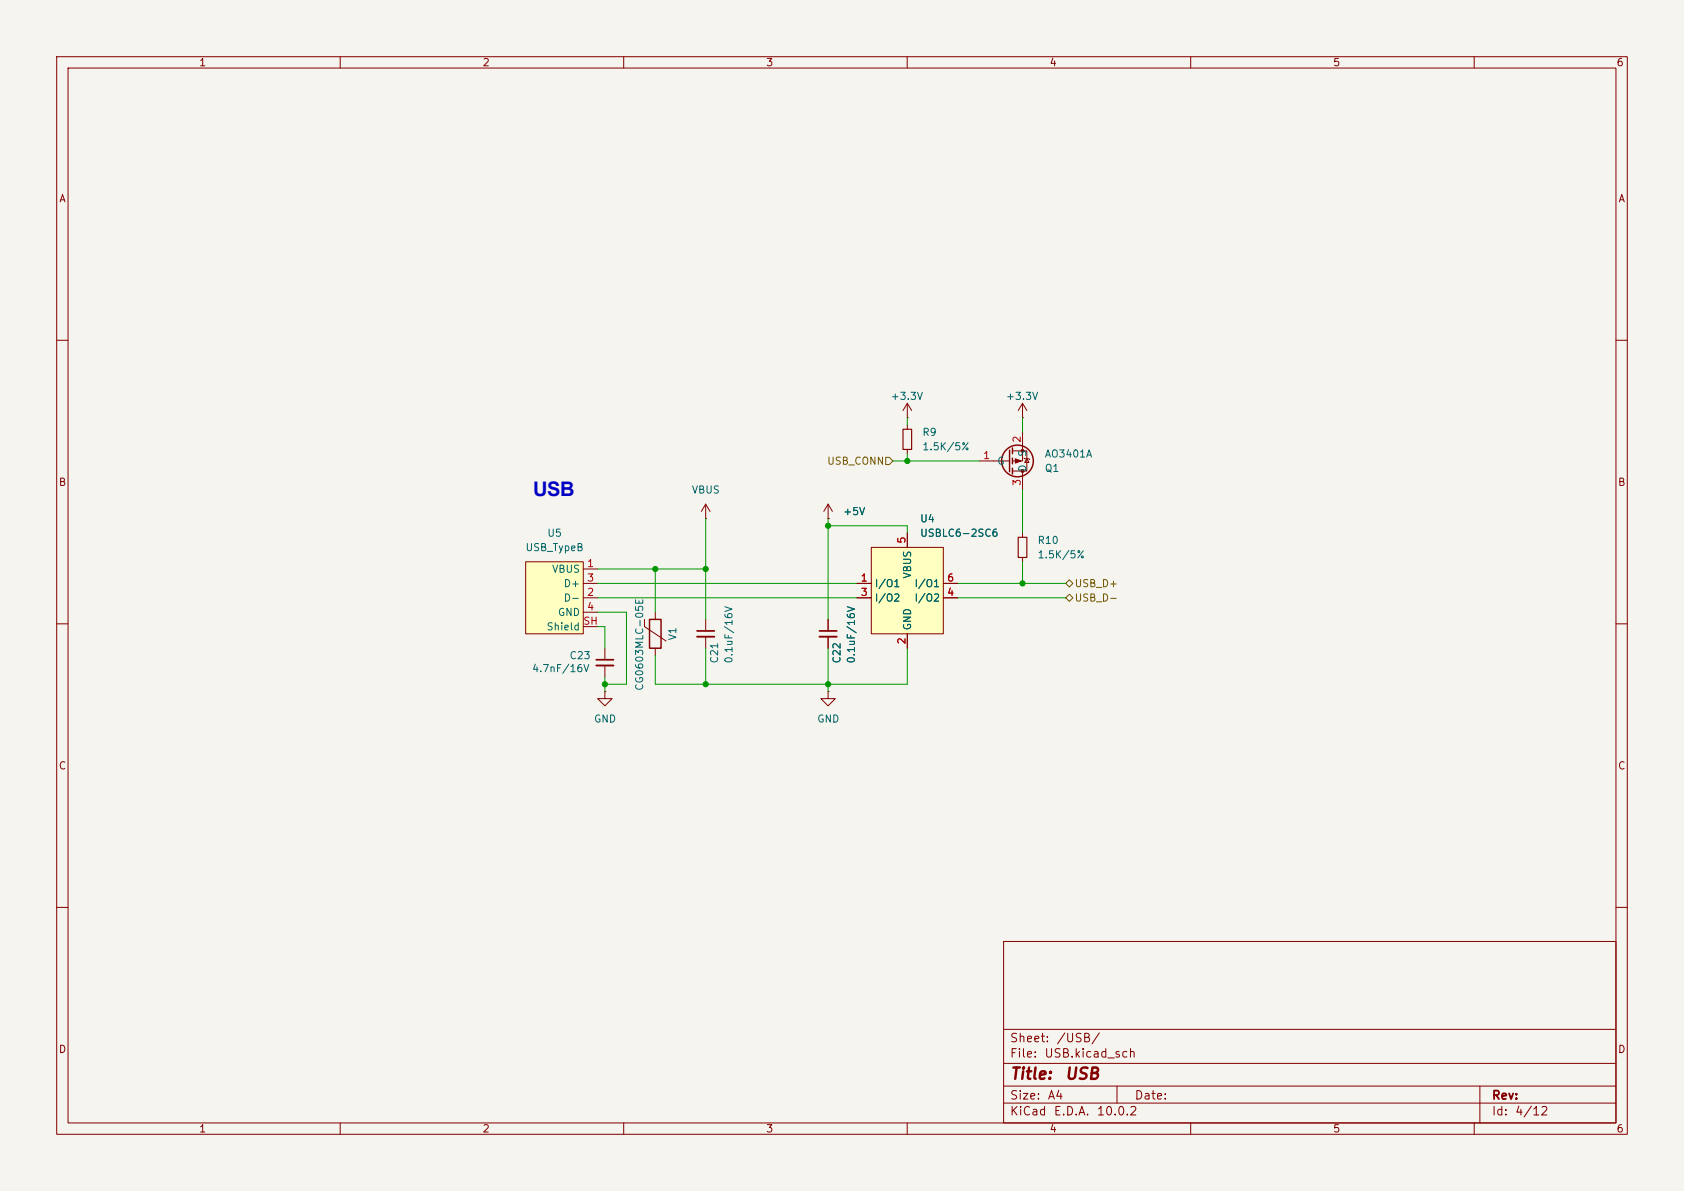
[picture p64: page 4]

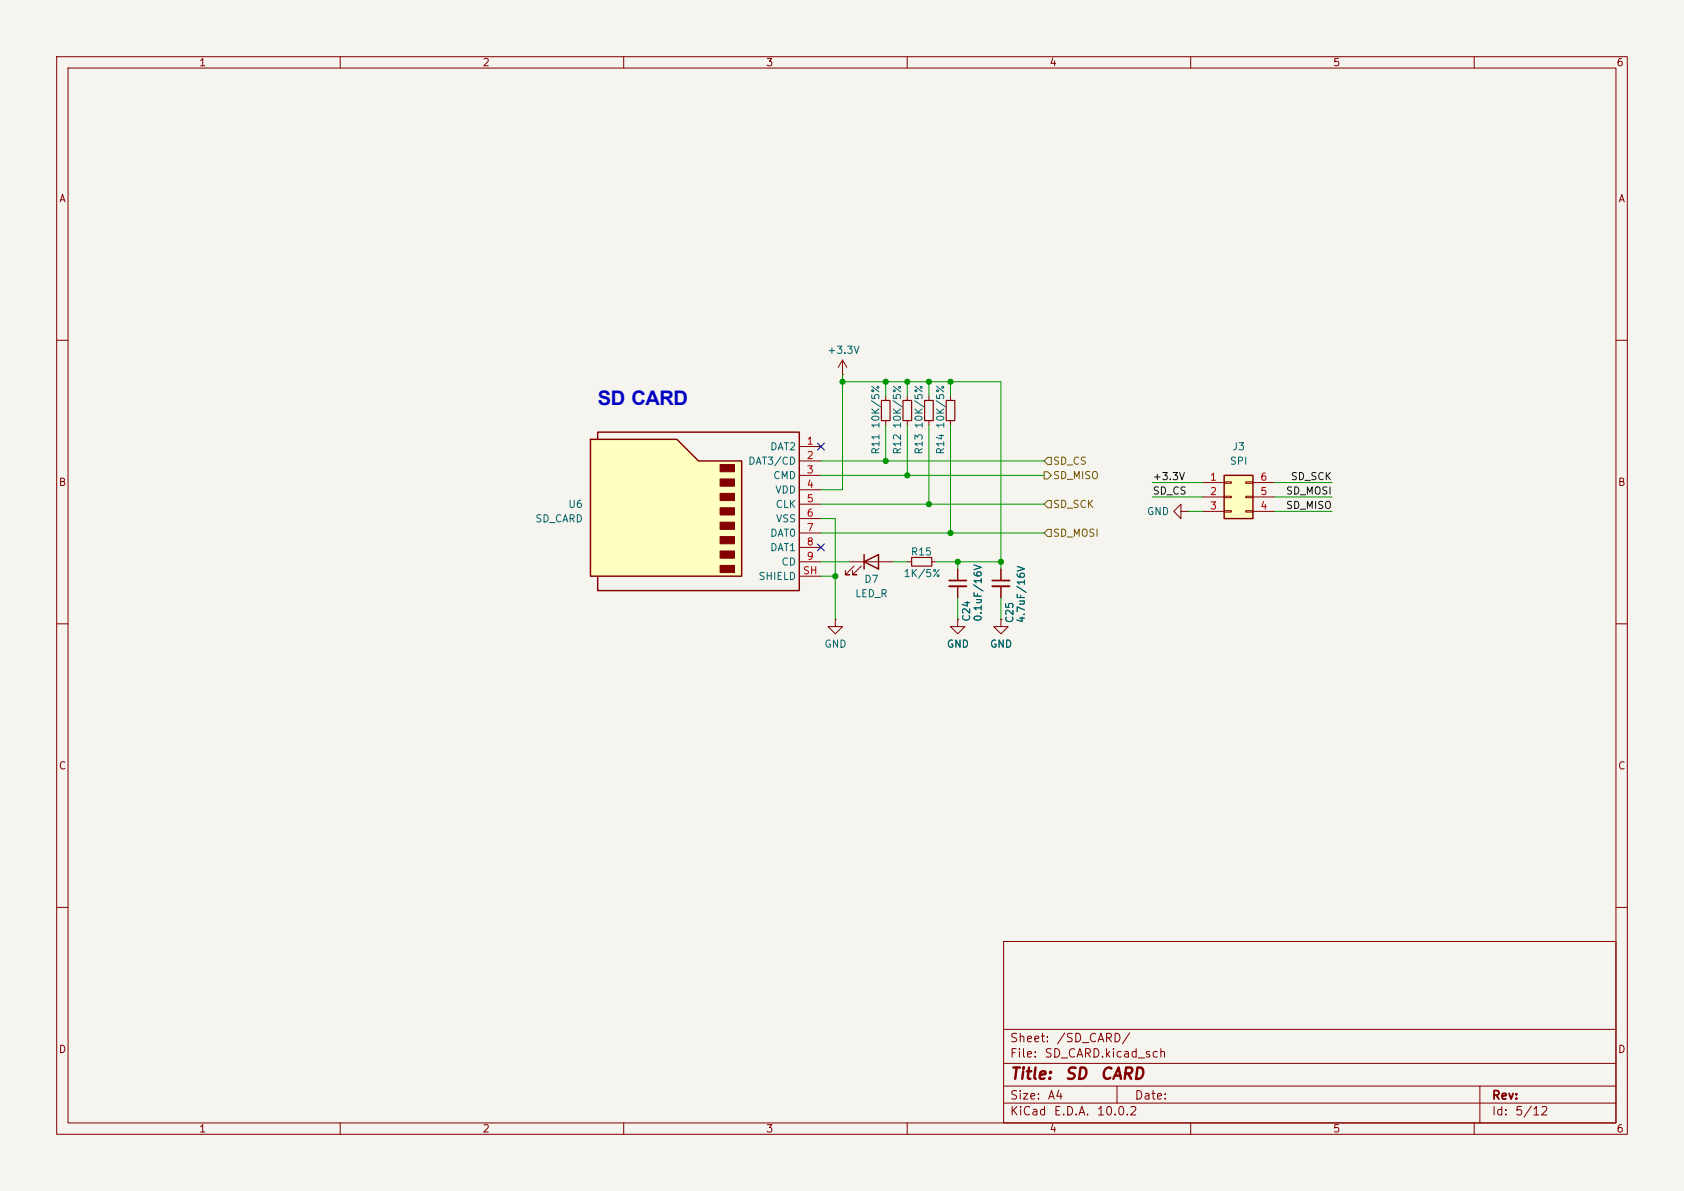
[picture p65: page 5]

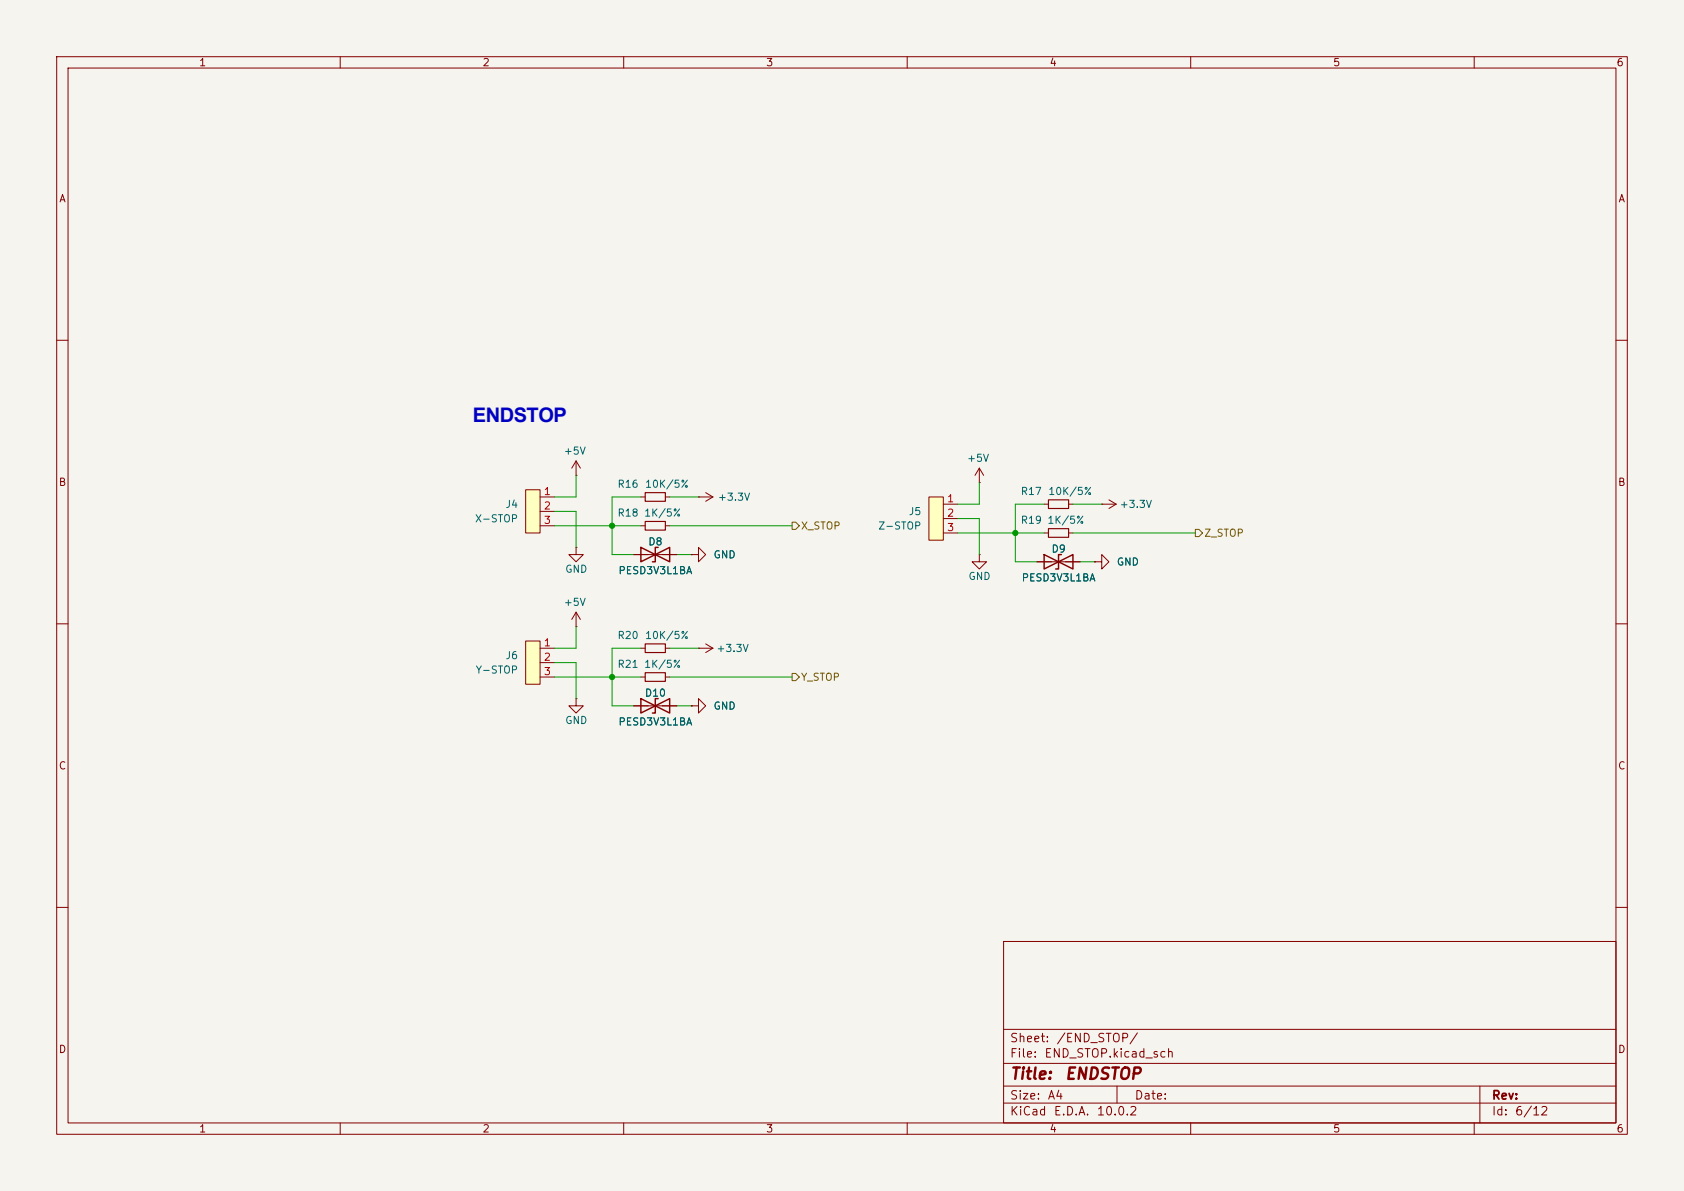
[picture p66: page 6]

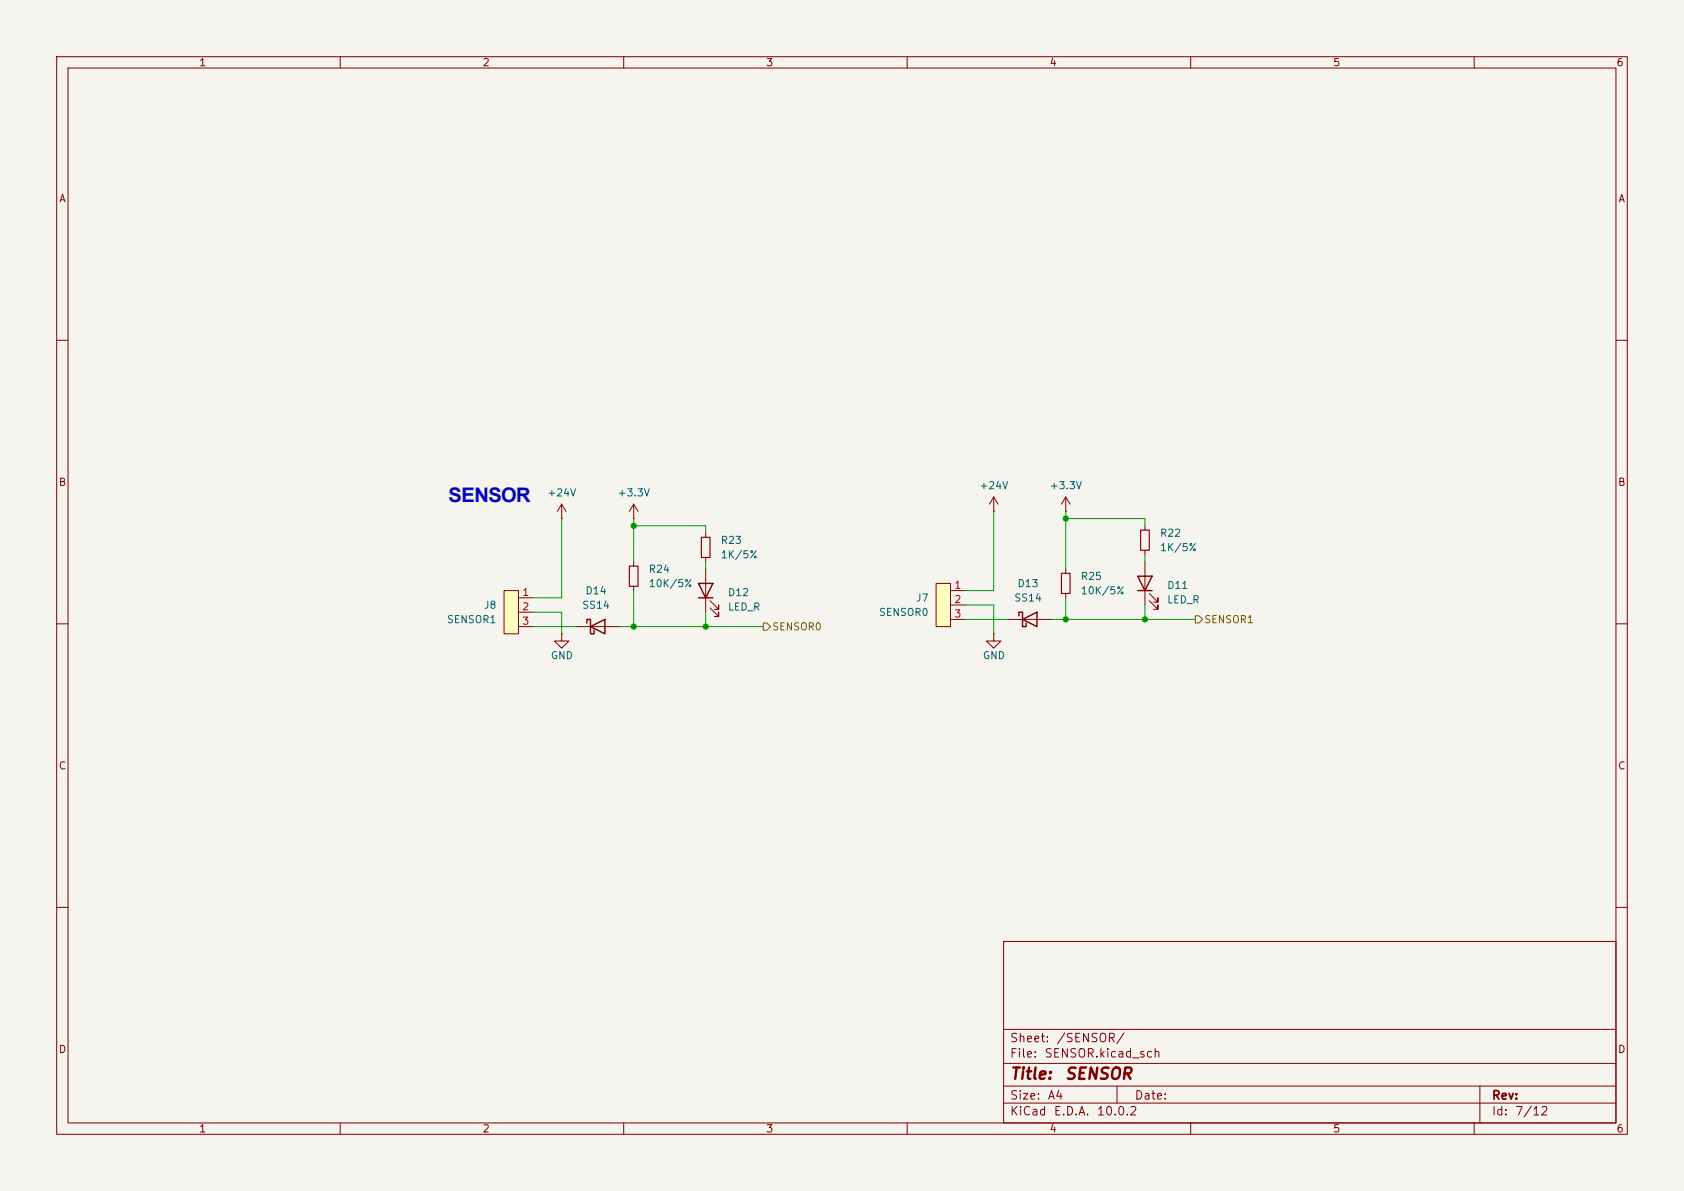
[picture p67: page 7]

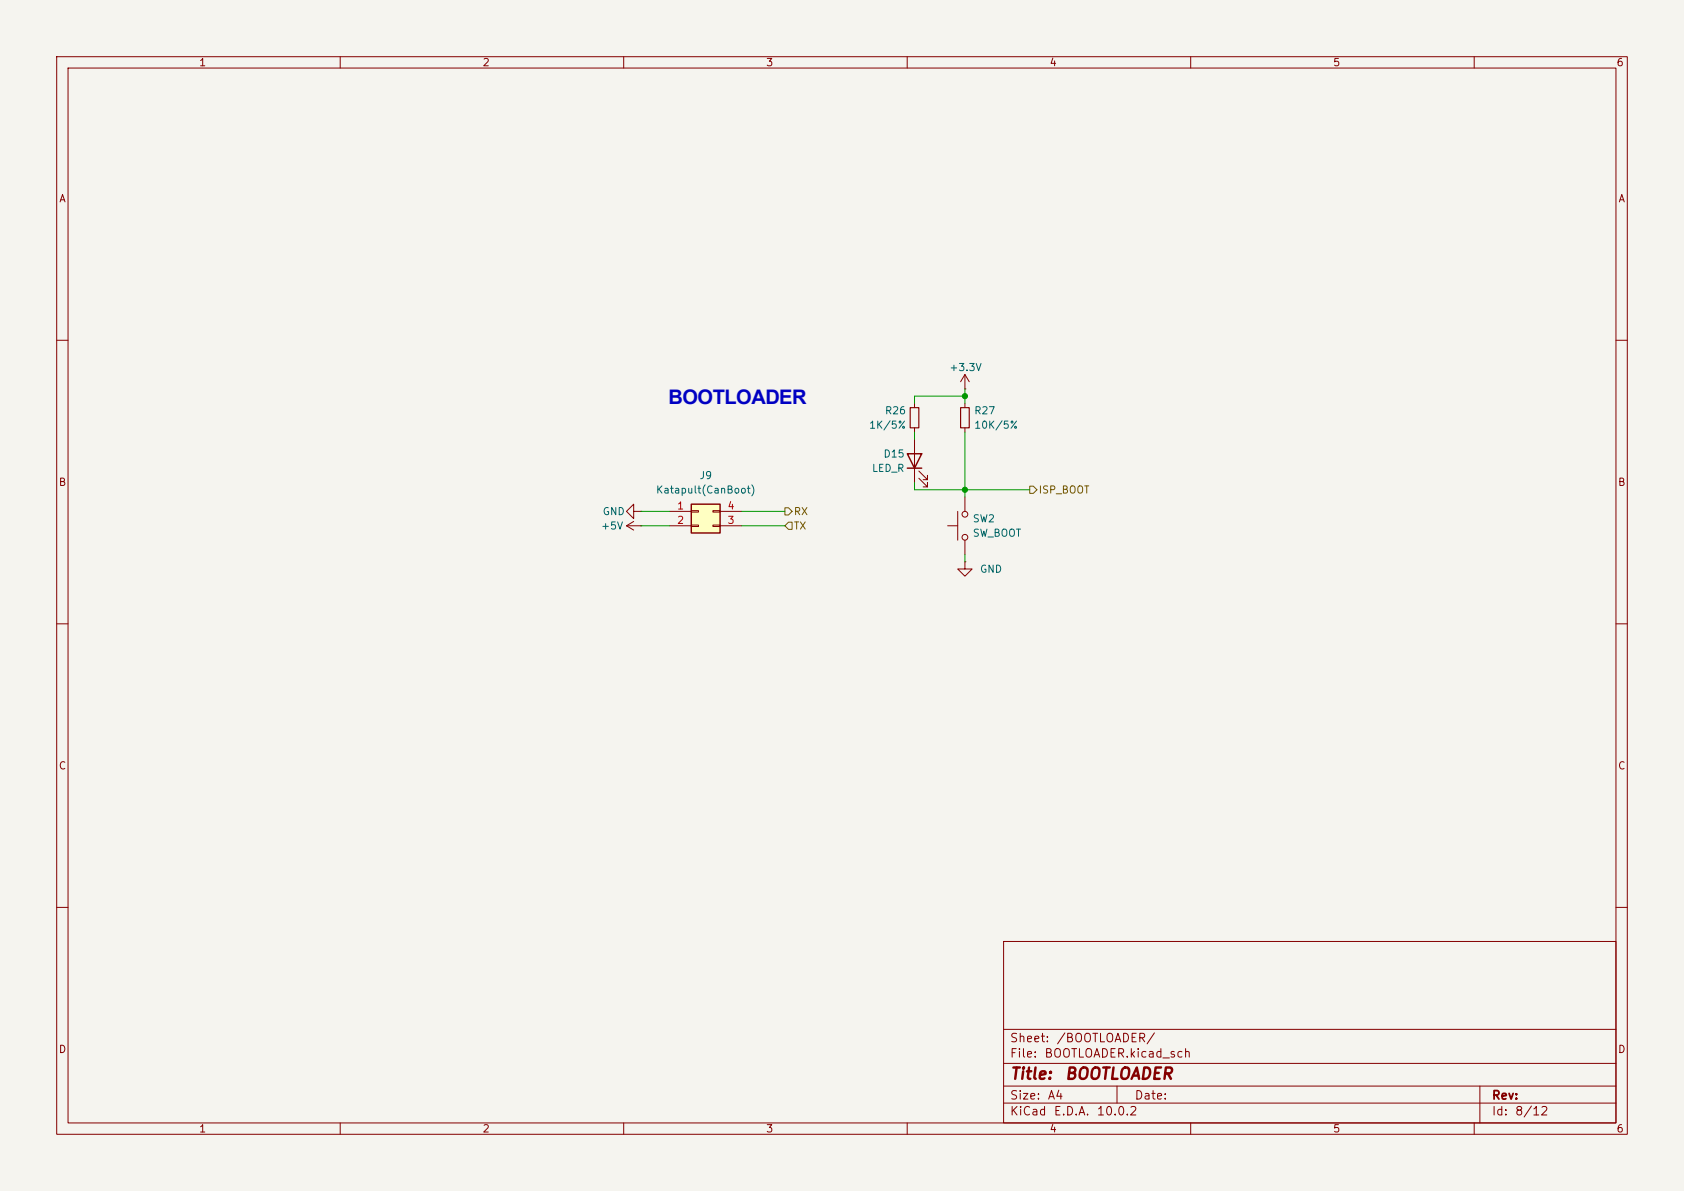
[picture p68: page 8]

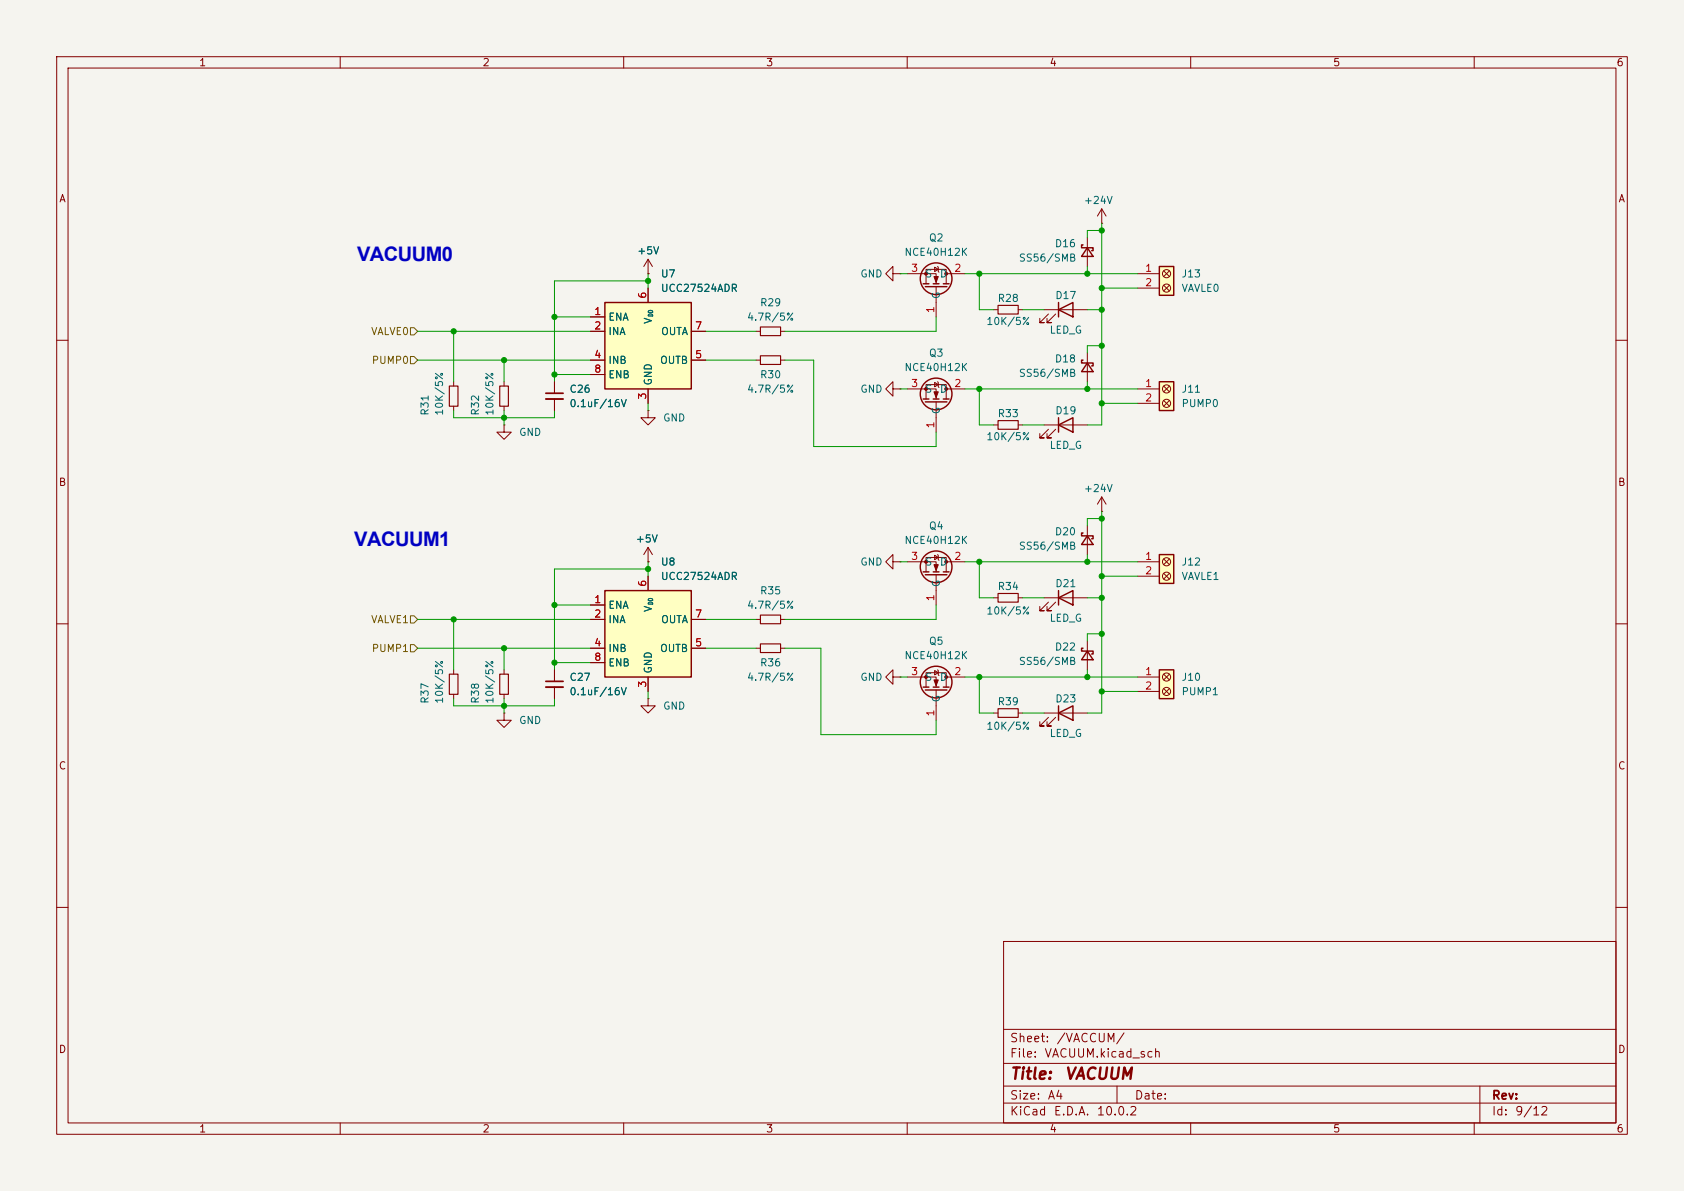
[picture p69: page 9]

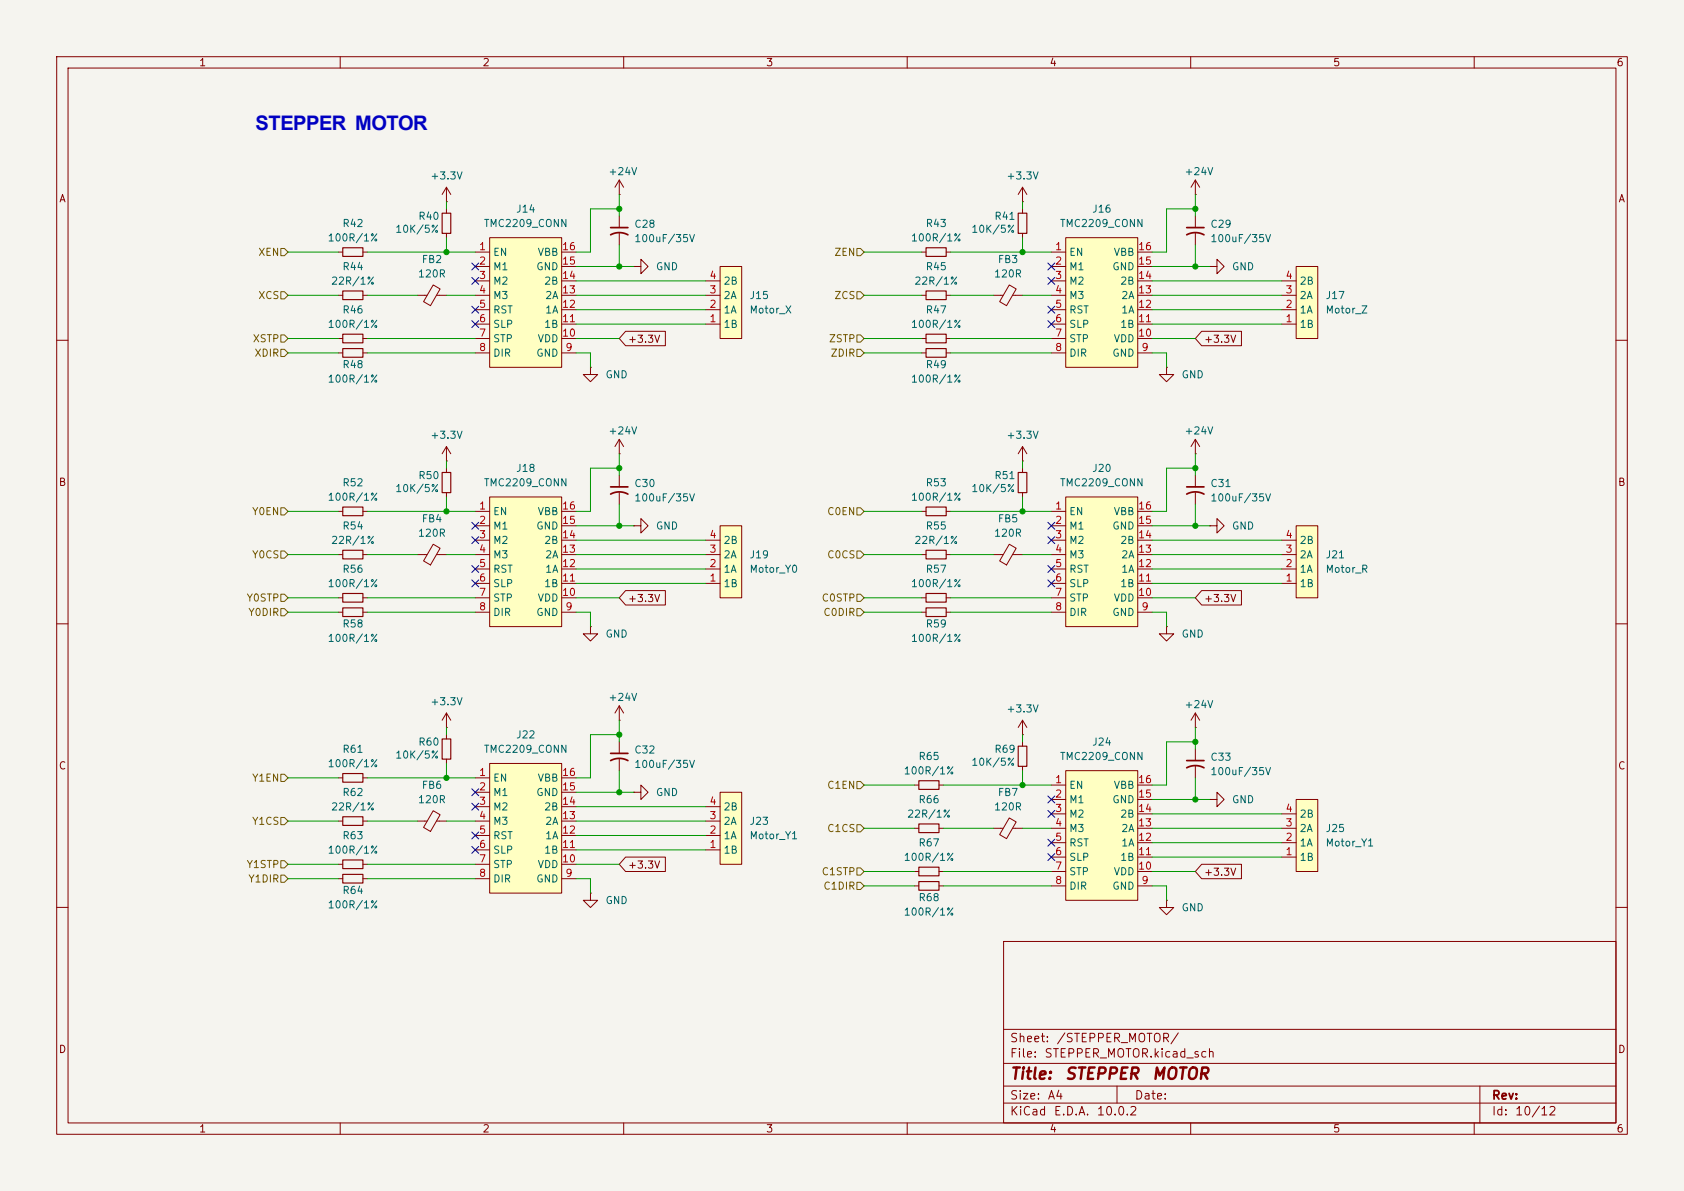
[picture p70: page 10]

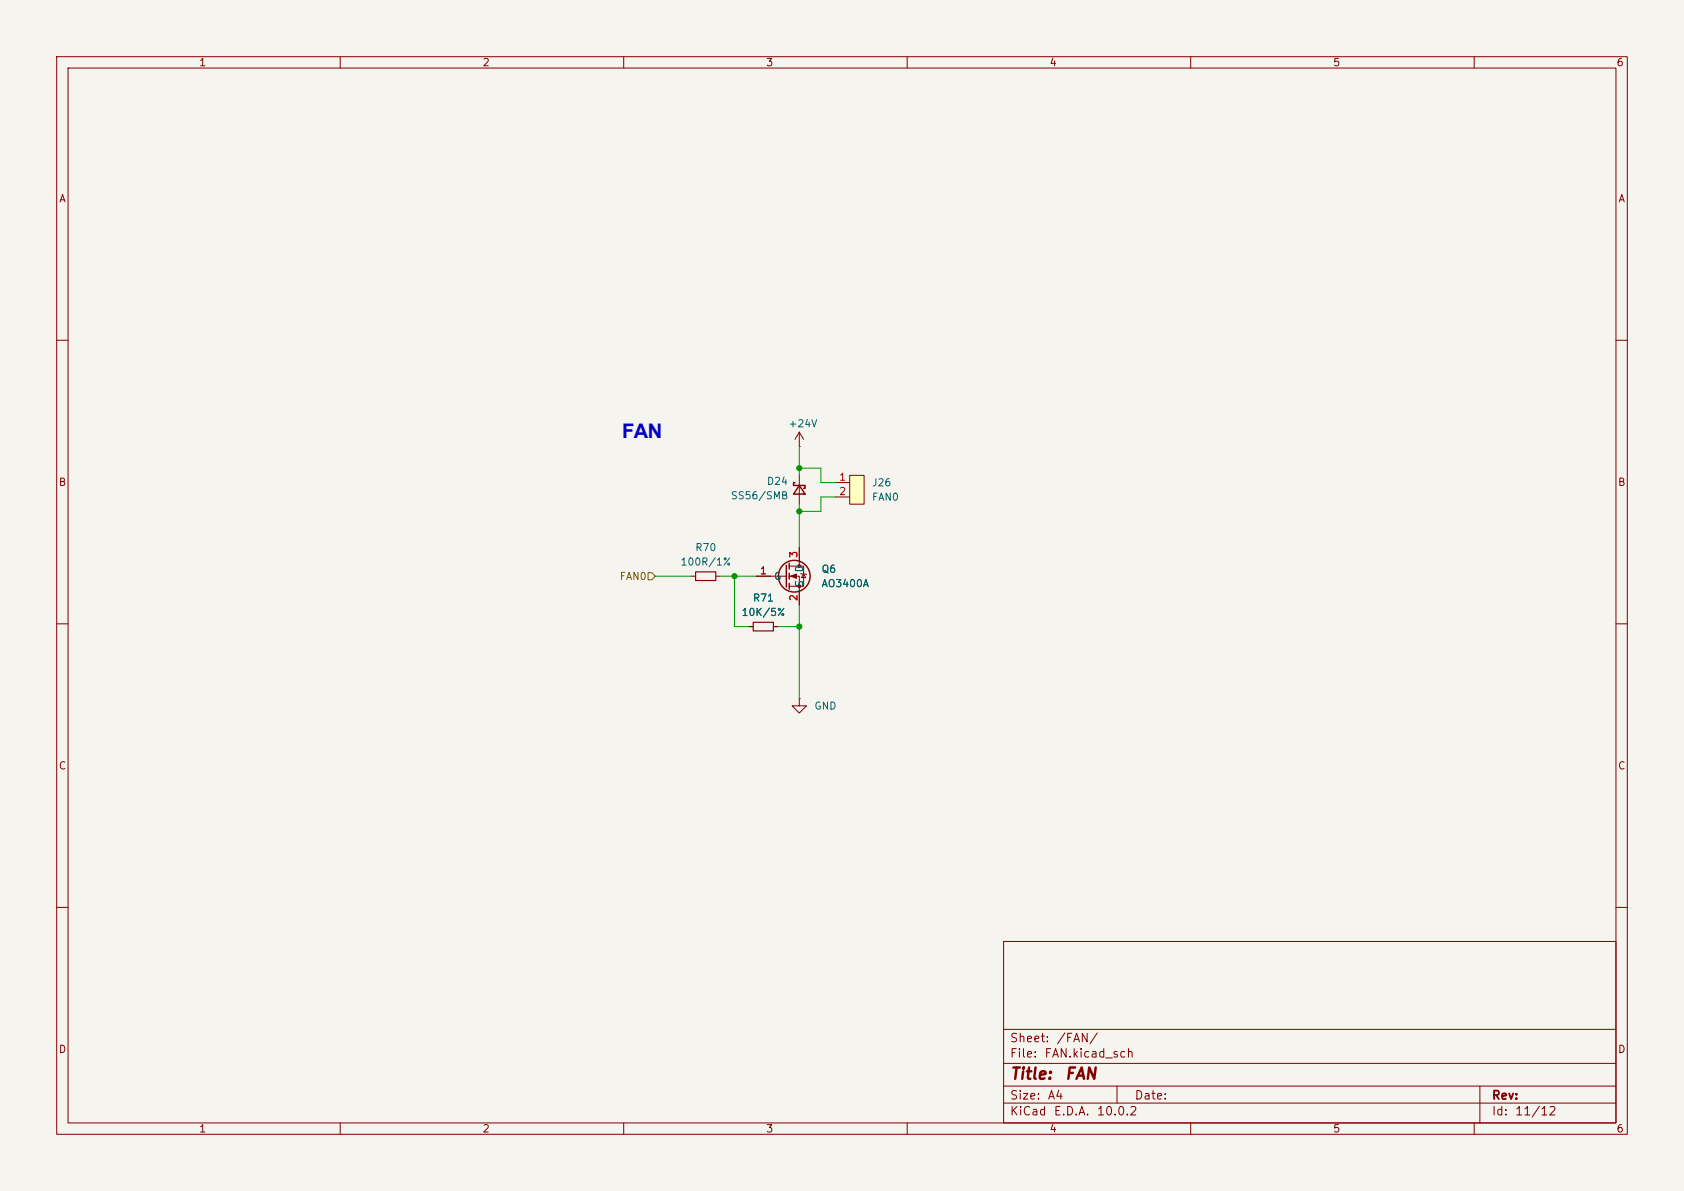
[picture p71: page 11]

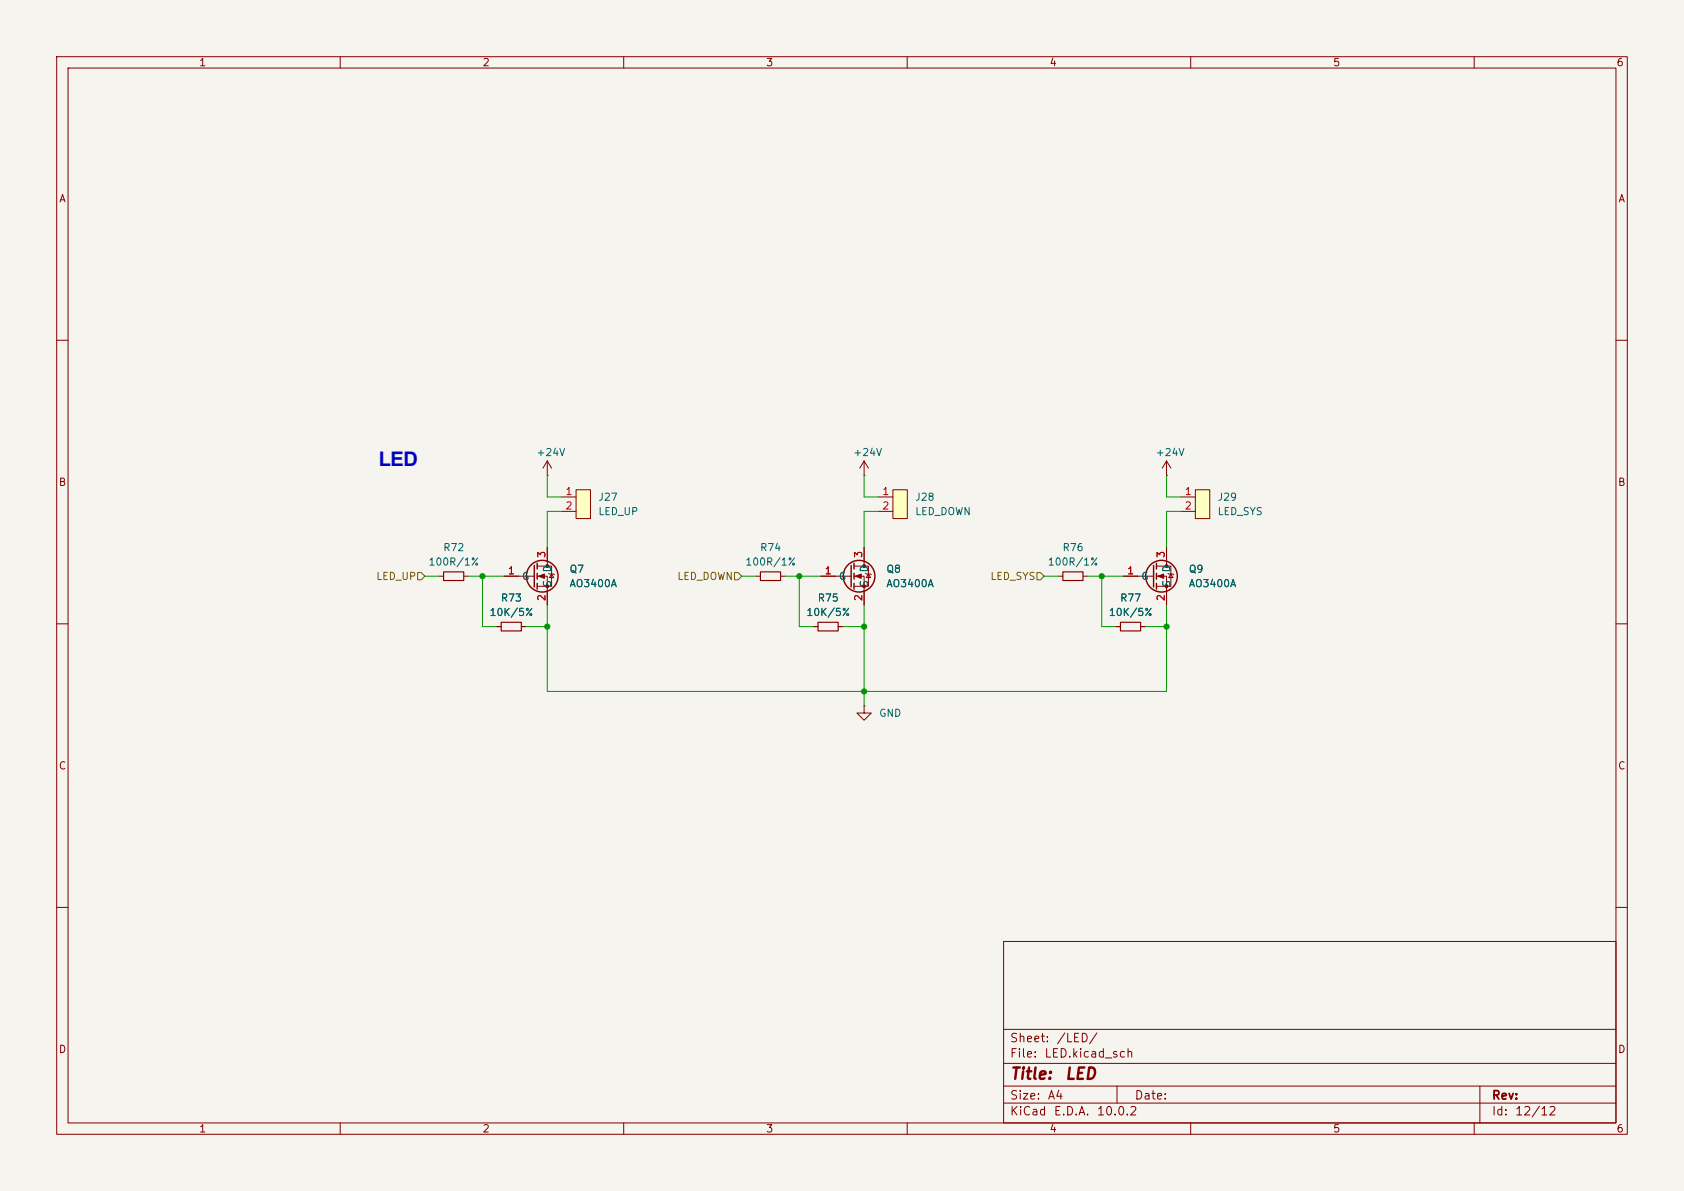
[picture p72: page 12]
