tominhcuong2041505-sys/SMT-Pick-and-Place/PCB/Mainboard/2026-06-29/LBoizPnP_Schematic_2026-06-29.pdf

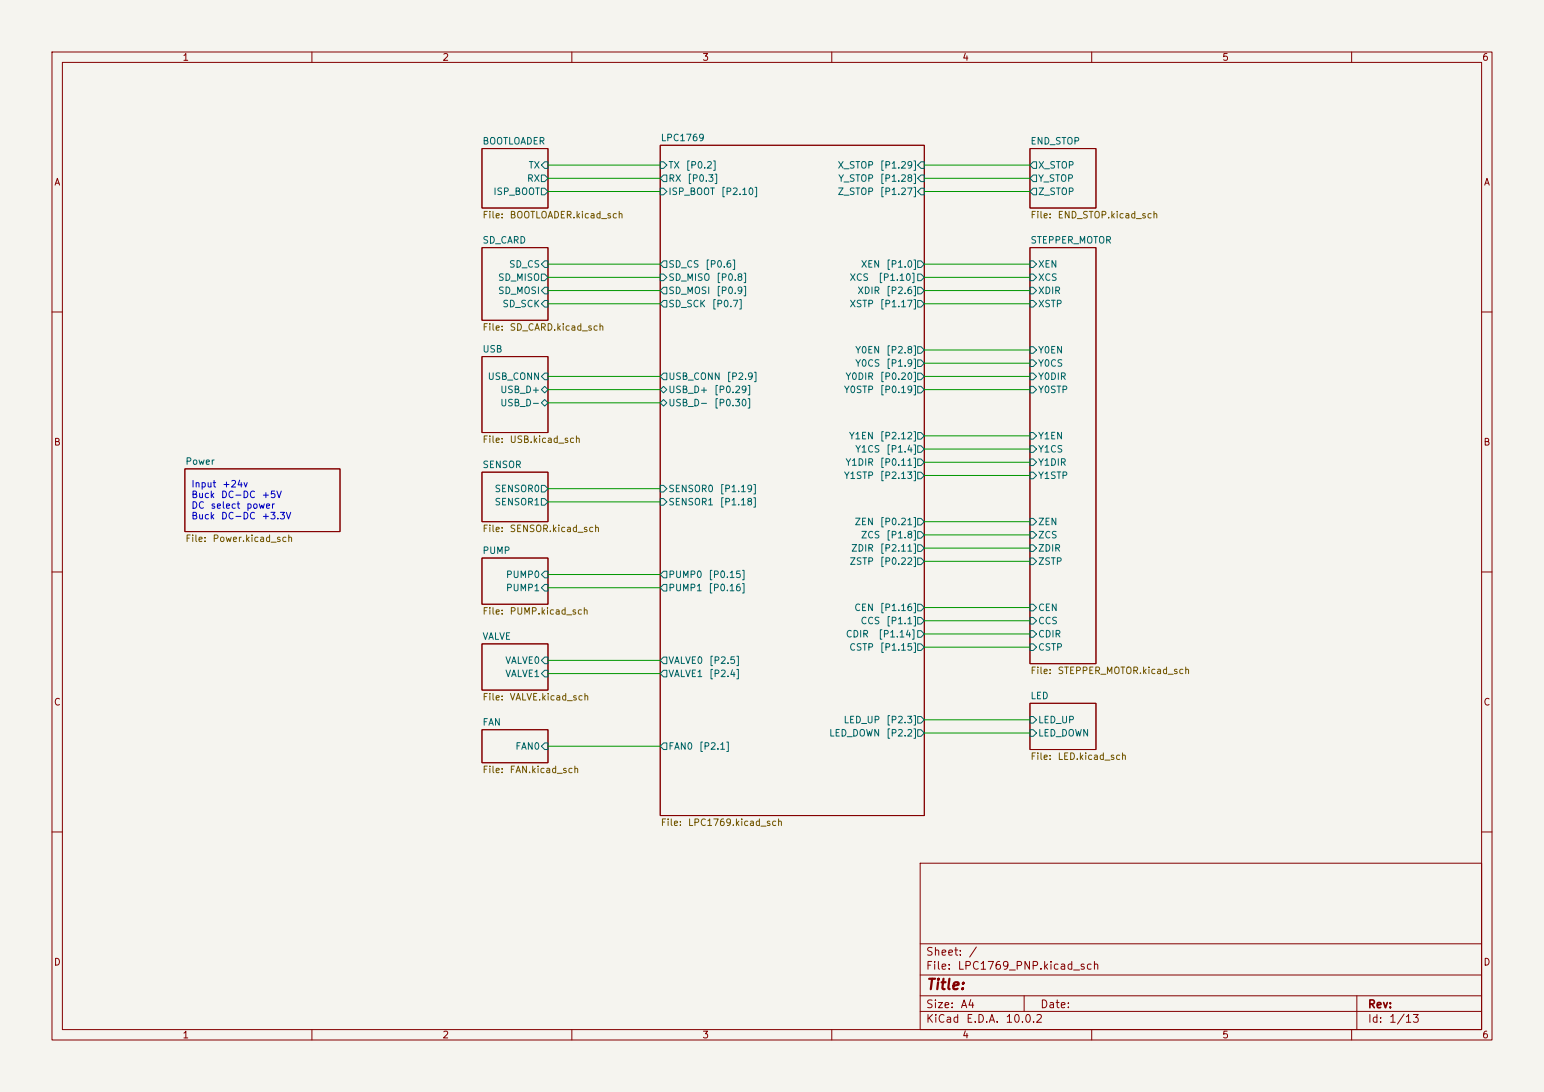
[picture p84: page 1]

Input +24v Buck DC-DC +5V DC select power Buck DC-DC +3.3V

File: STEPPER_MOTOR.kicad_sch CCS [P1.1] CDIR [P1.14] CEN [P1.16] CSTP [P1.15] FAN0 [P2.1]

Size: A4 | Rev:
KiCad E.D.A. 10.0.2 | Id: 1/13

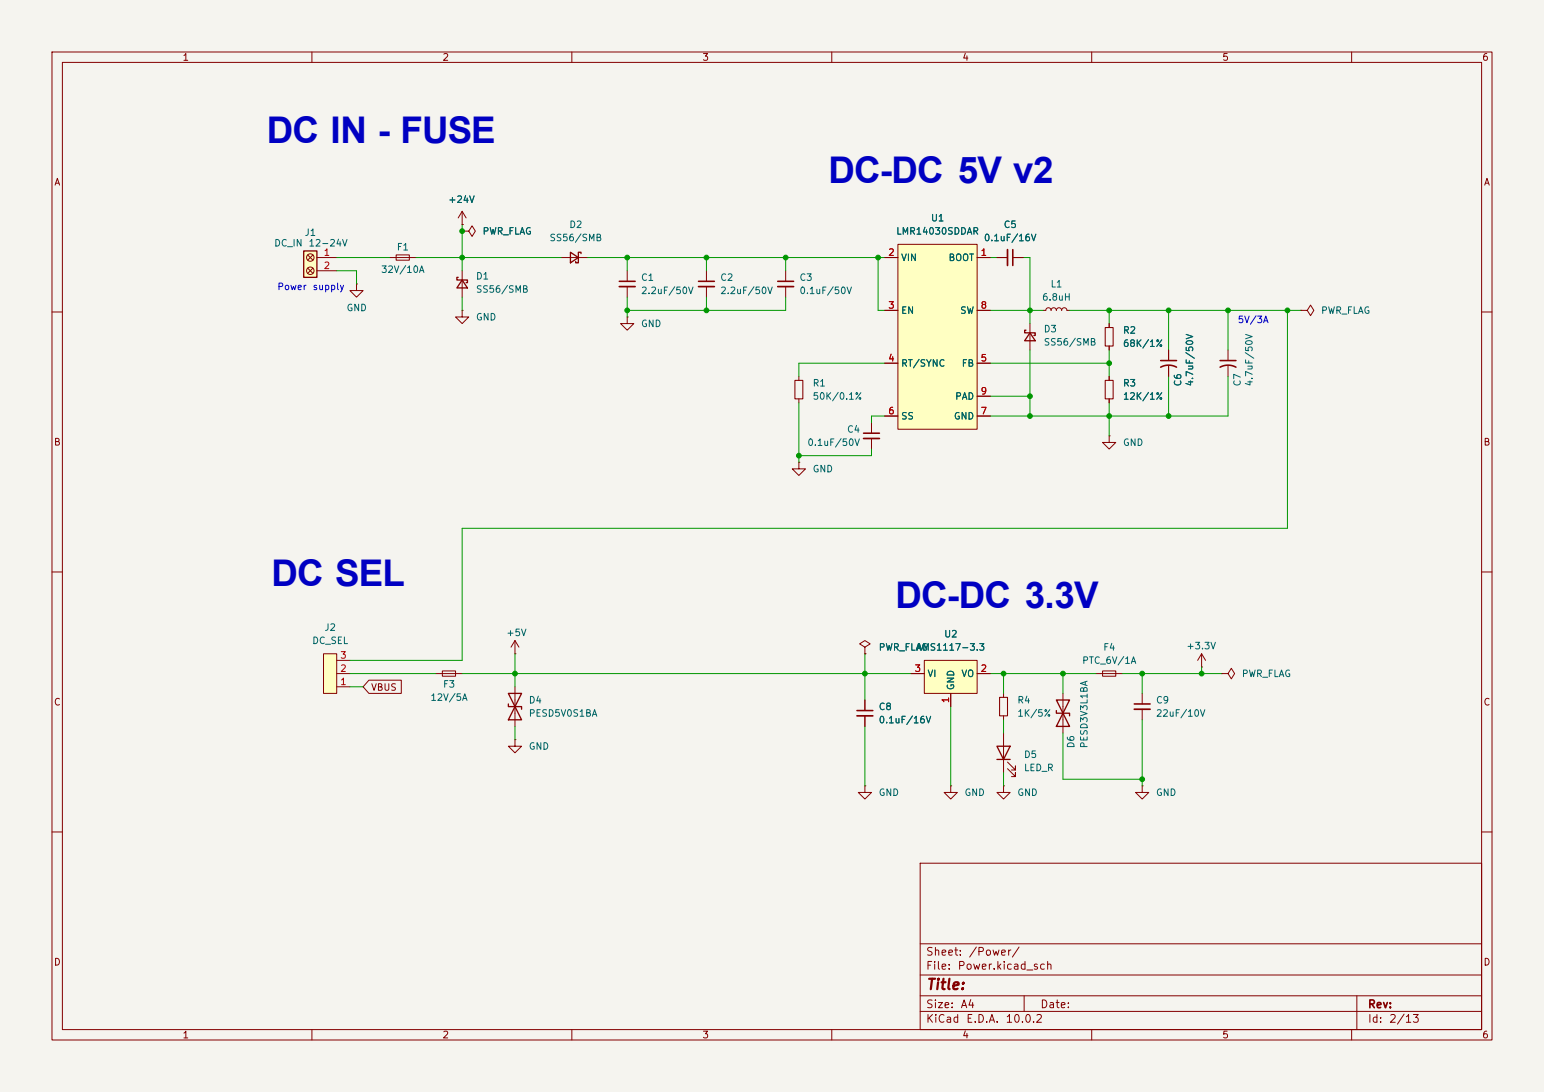
[picture p85: page 2]

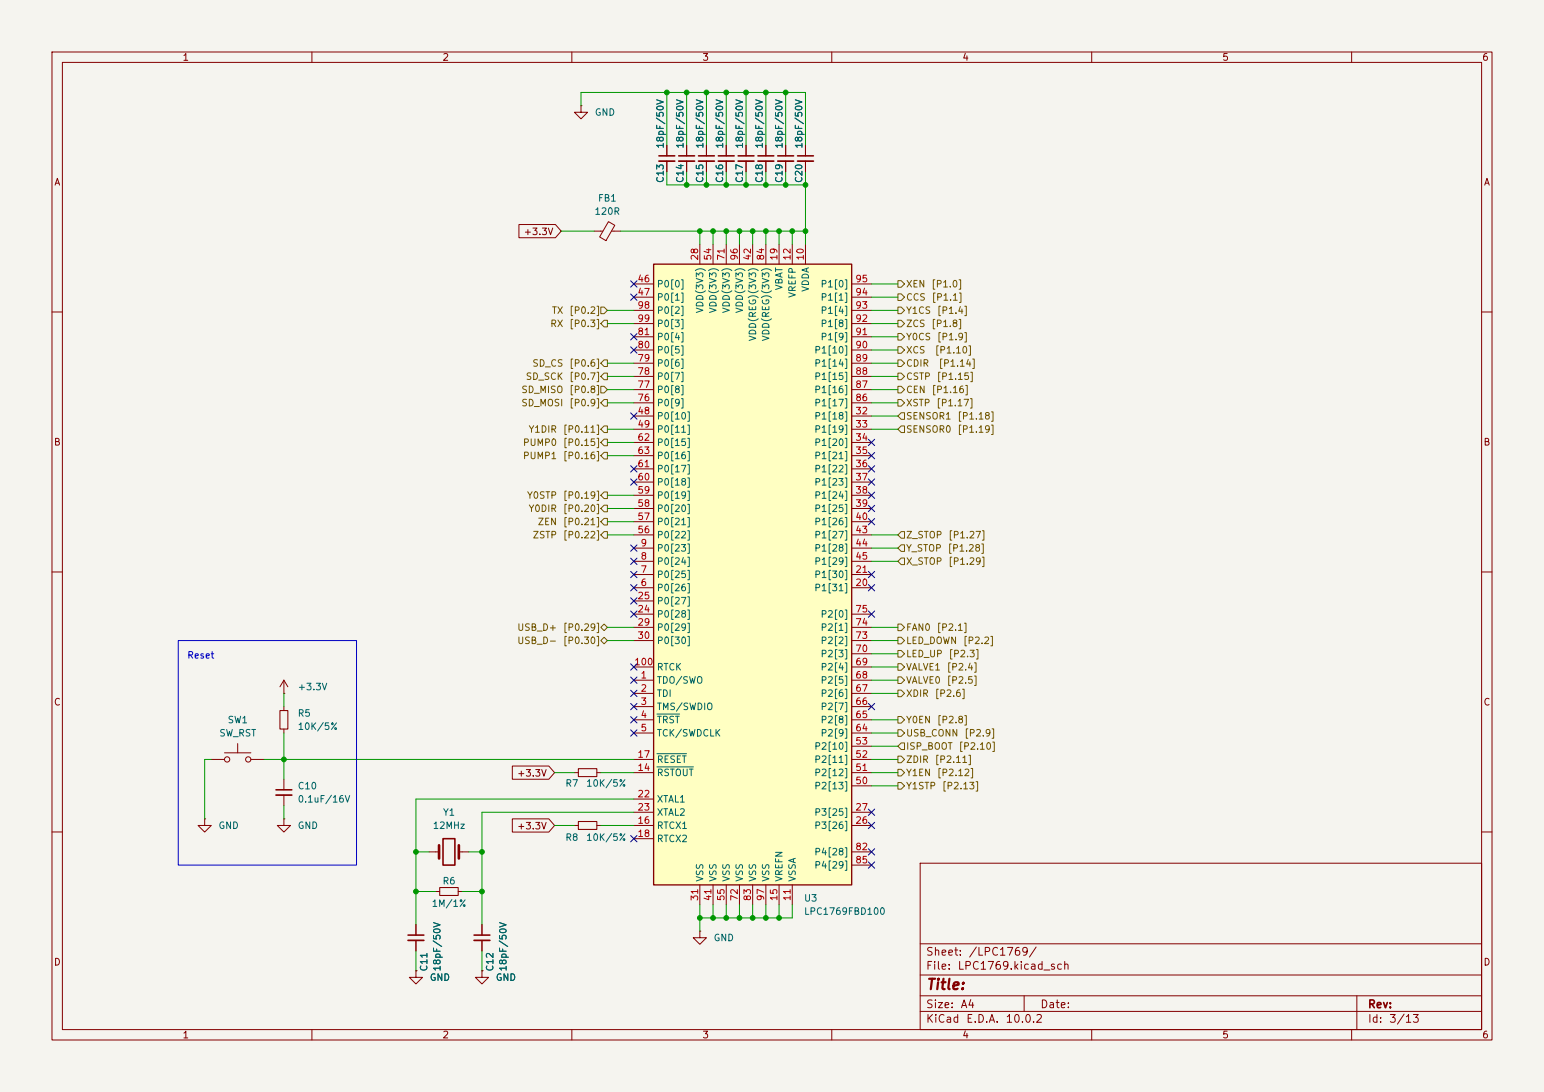
[picture p86: page 3]

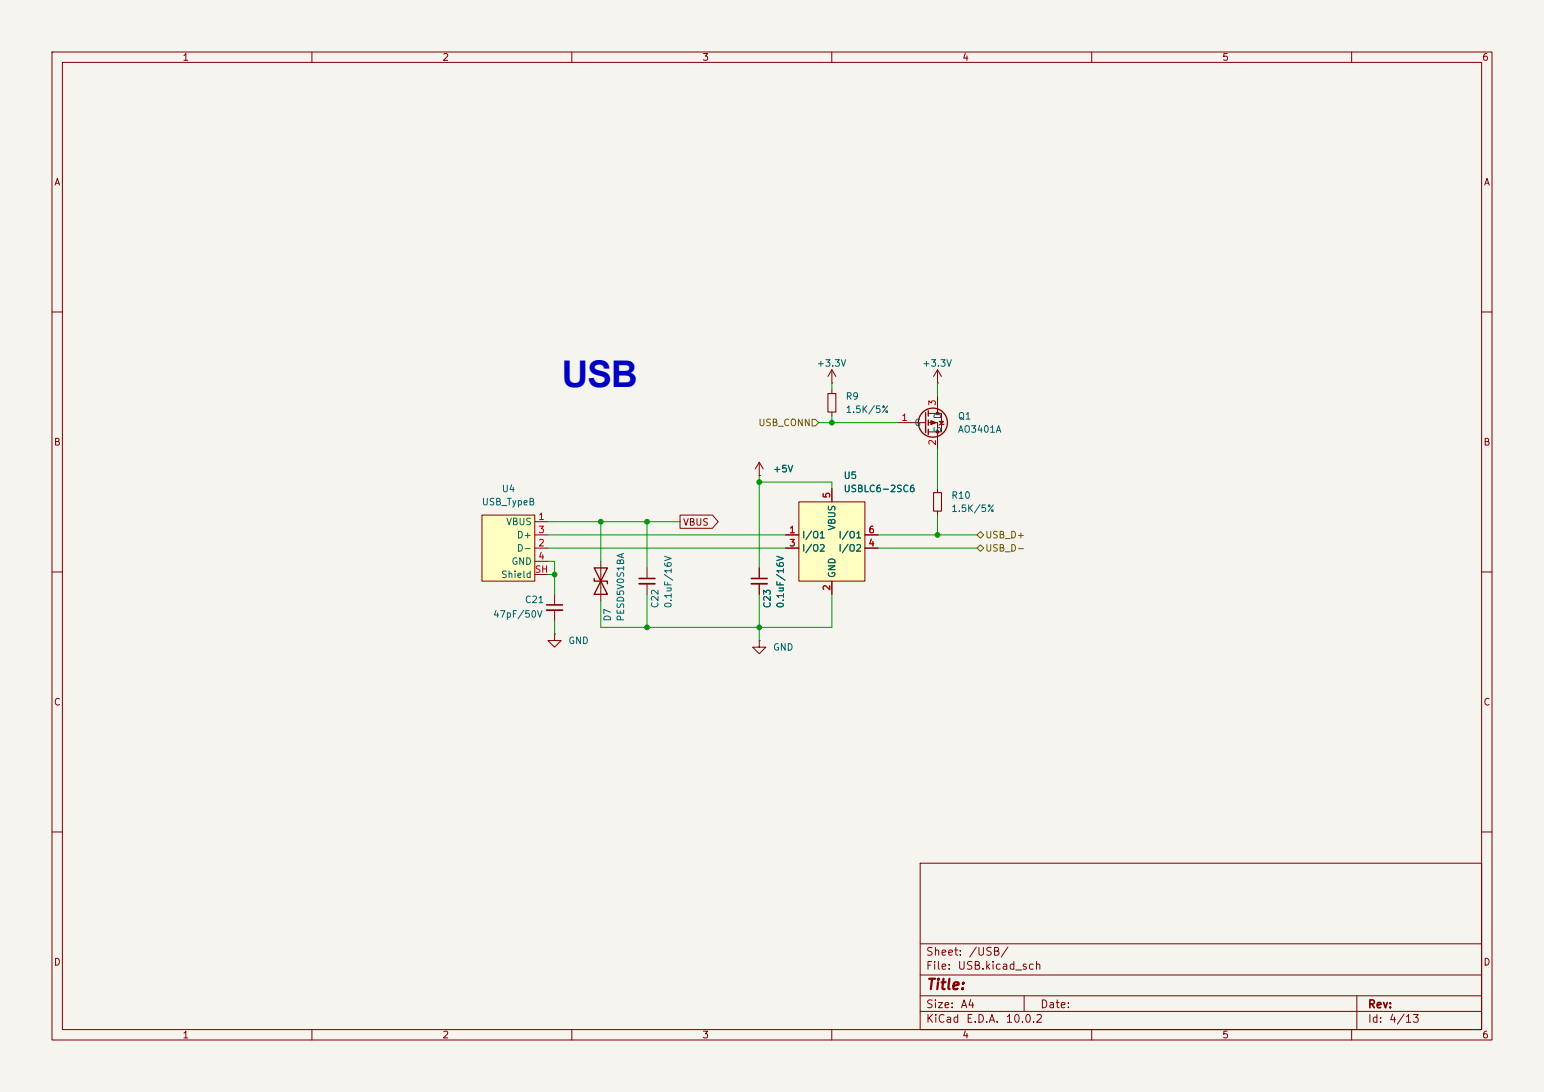
[picture p87: page 4]

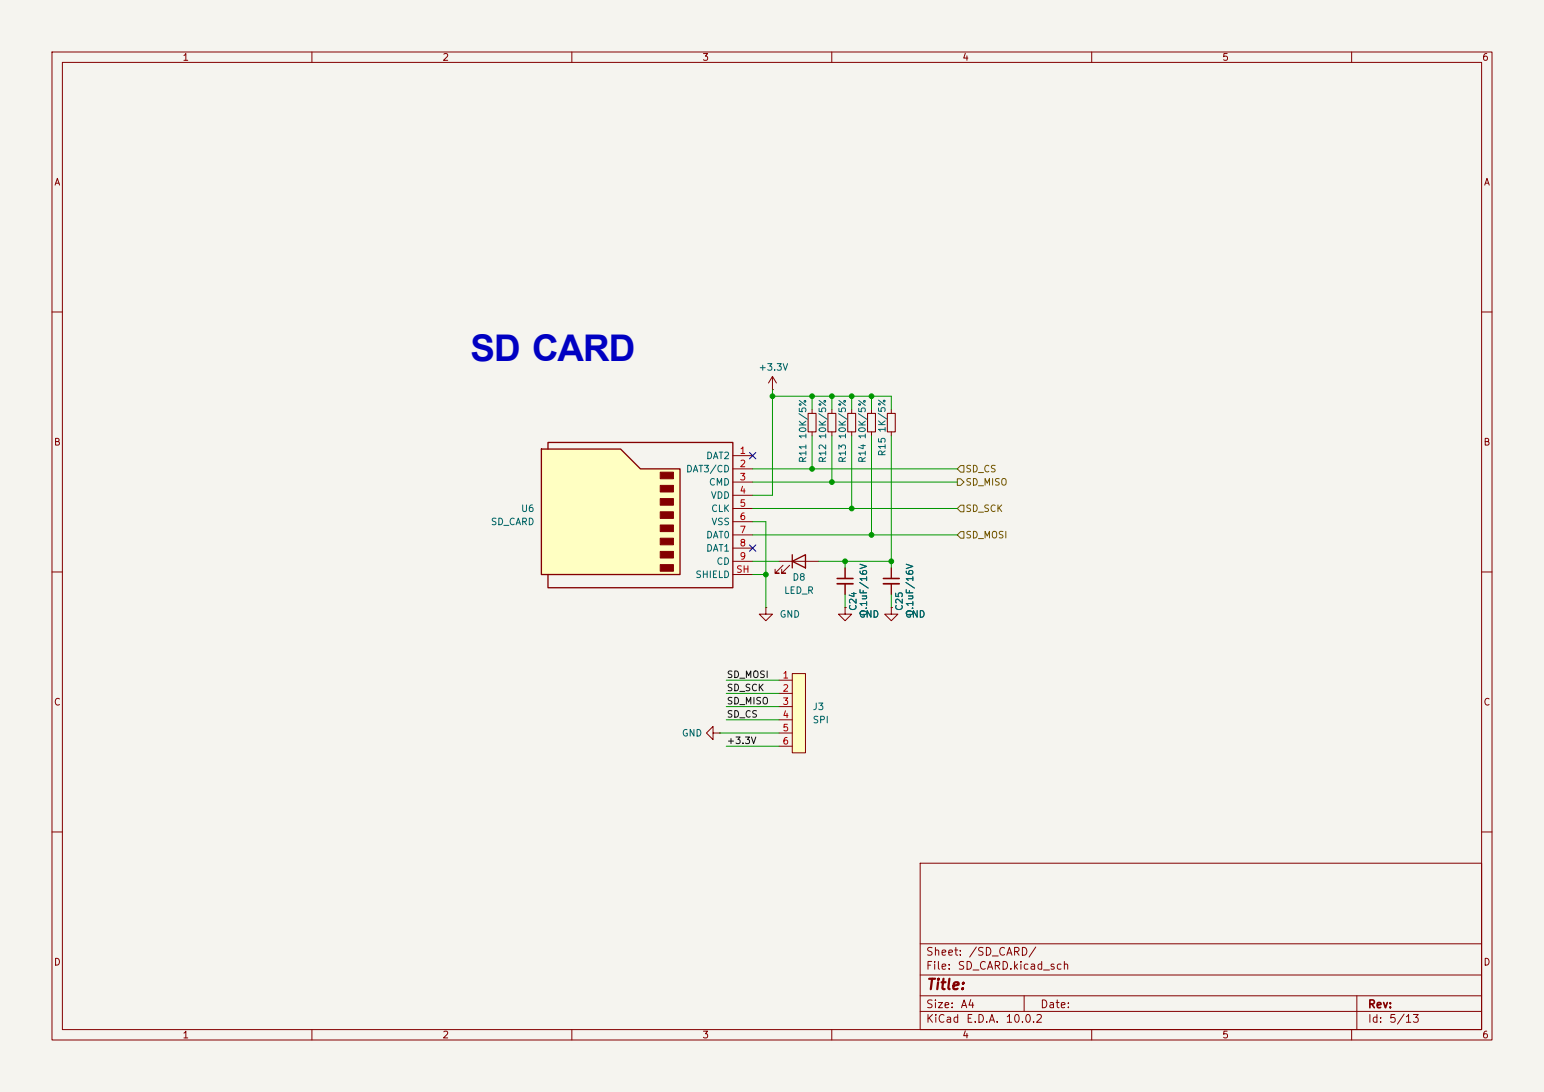
[picture p88: page 5]

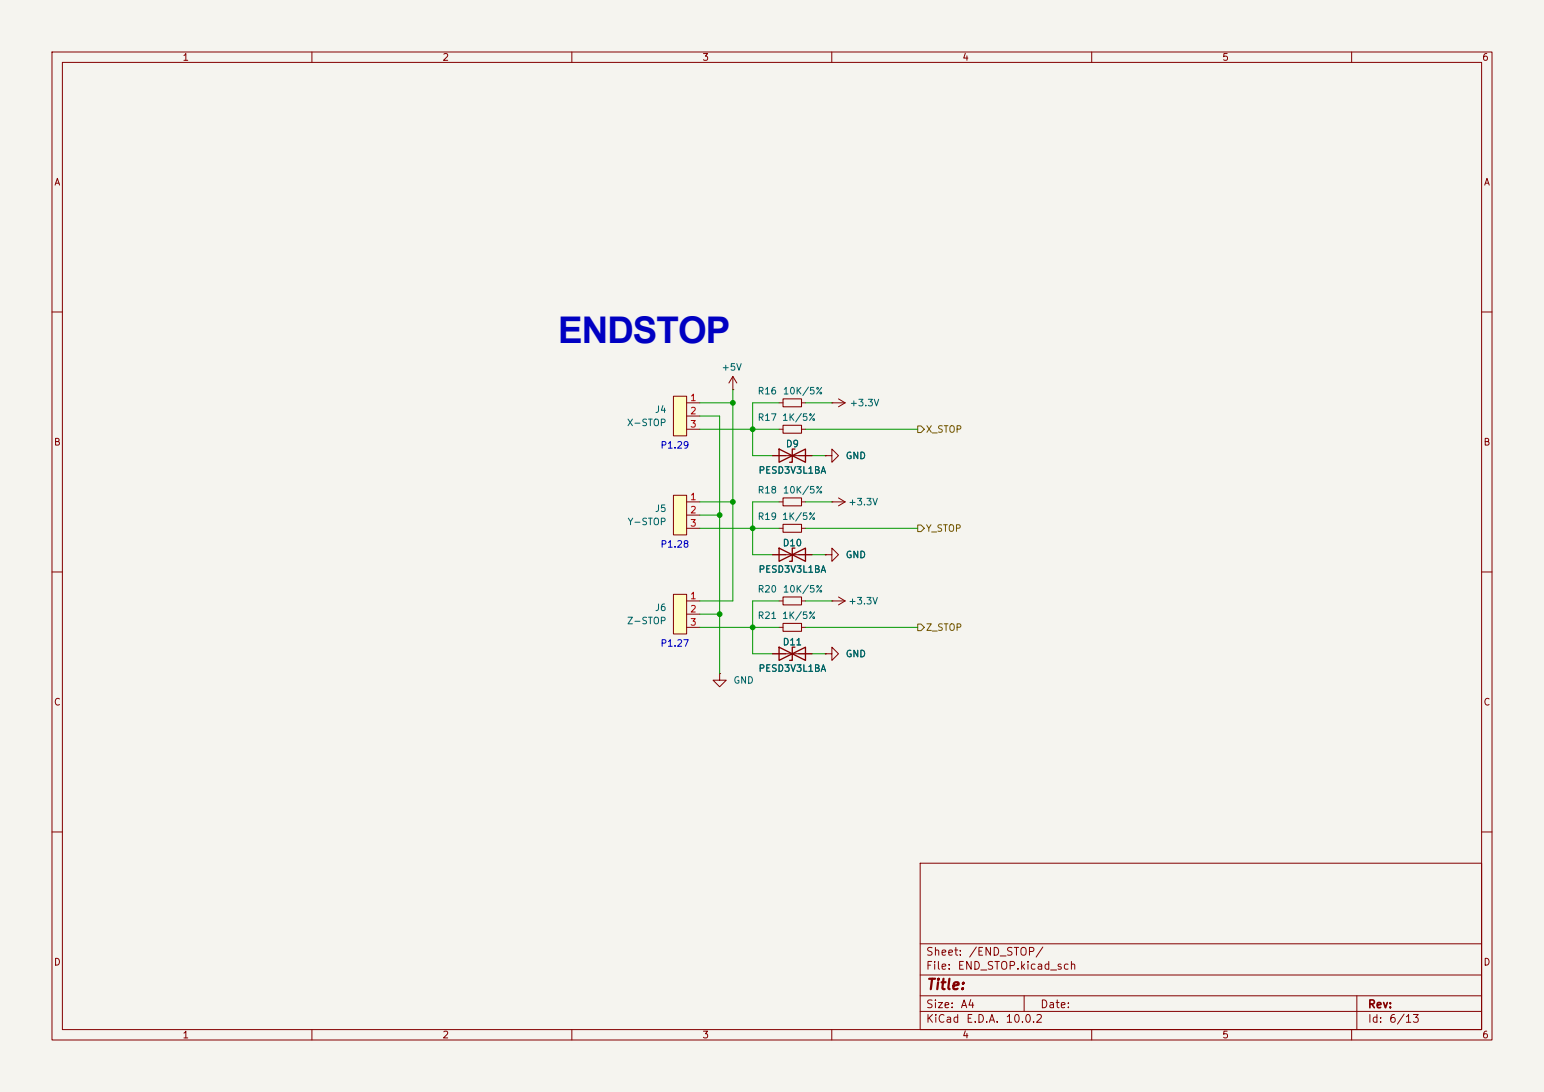
[picture p89: page 6]

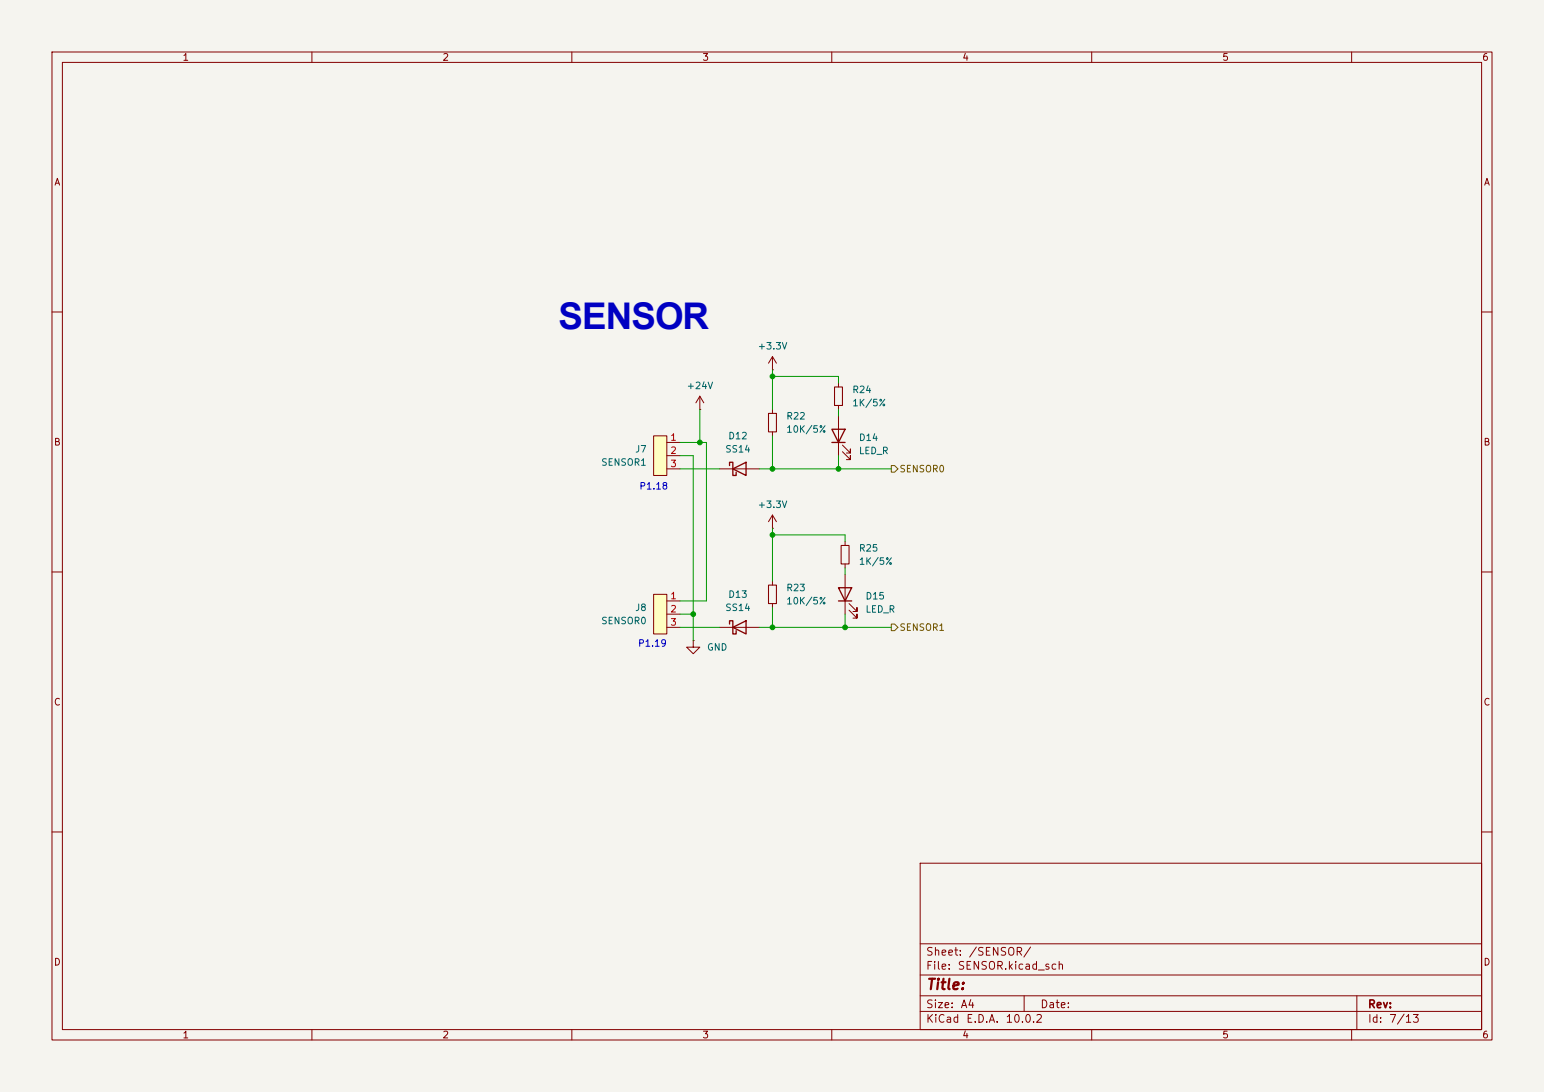
[picture p90: page 7]

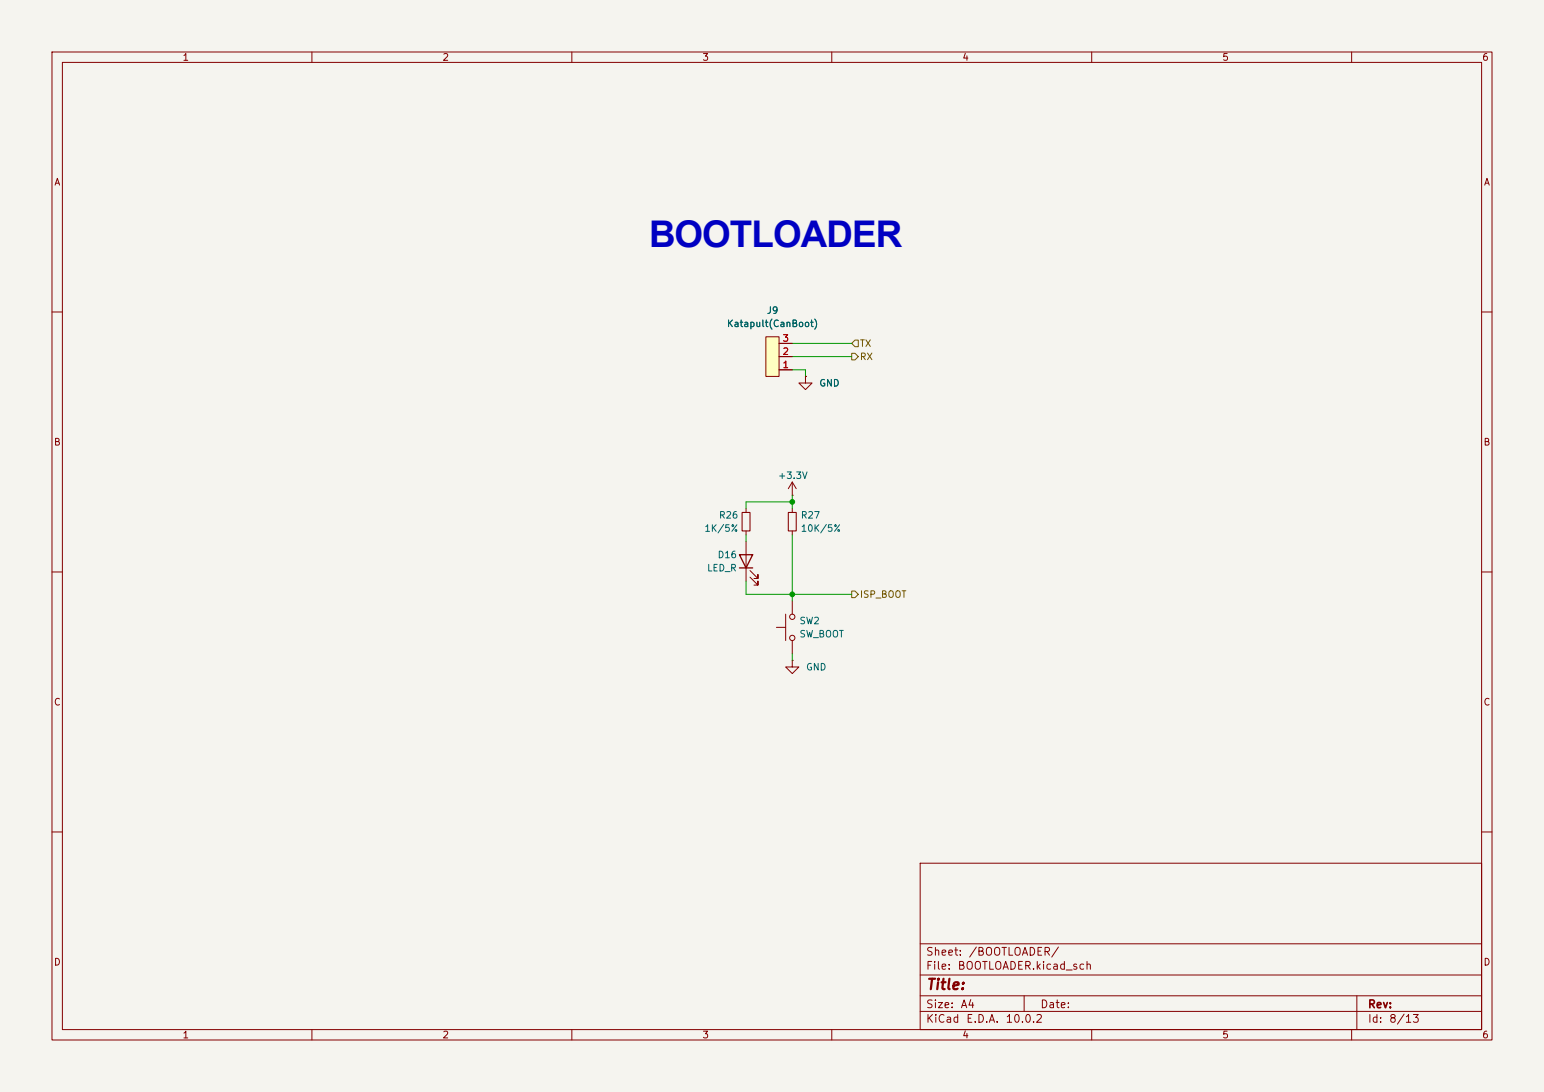
[picture p91: page 8]

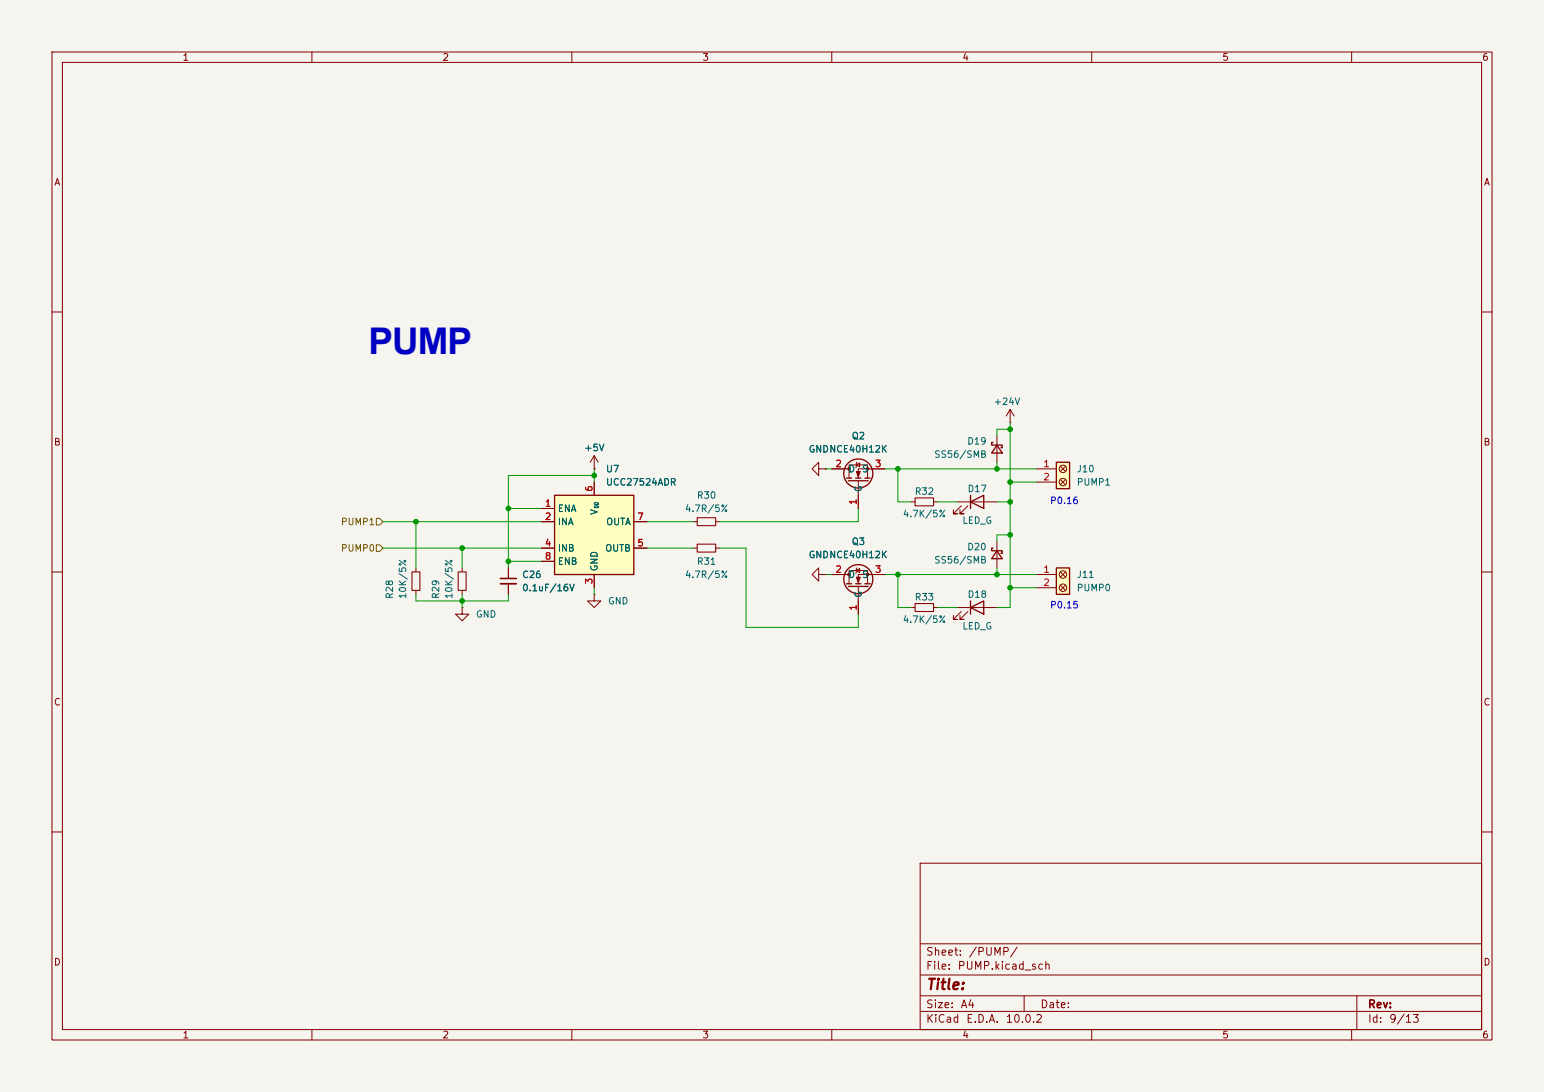
[picture p92: page 9]

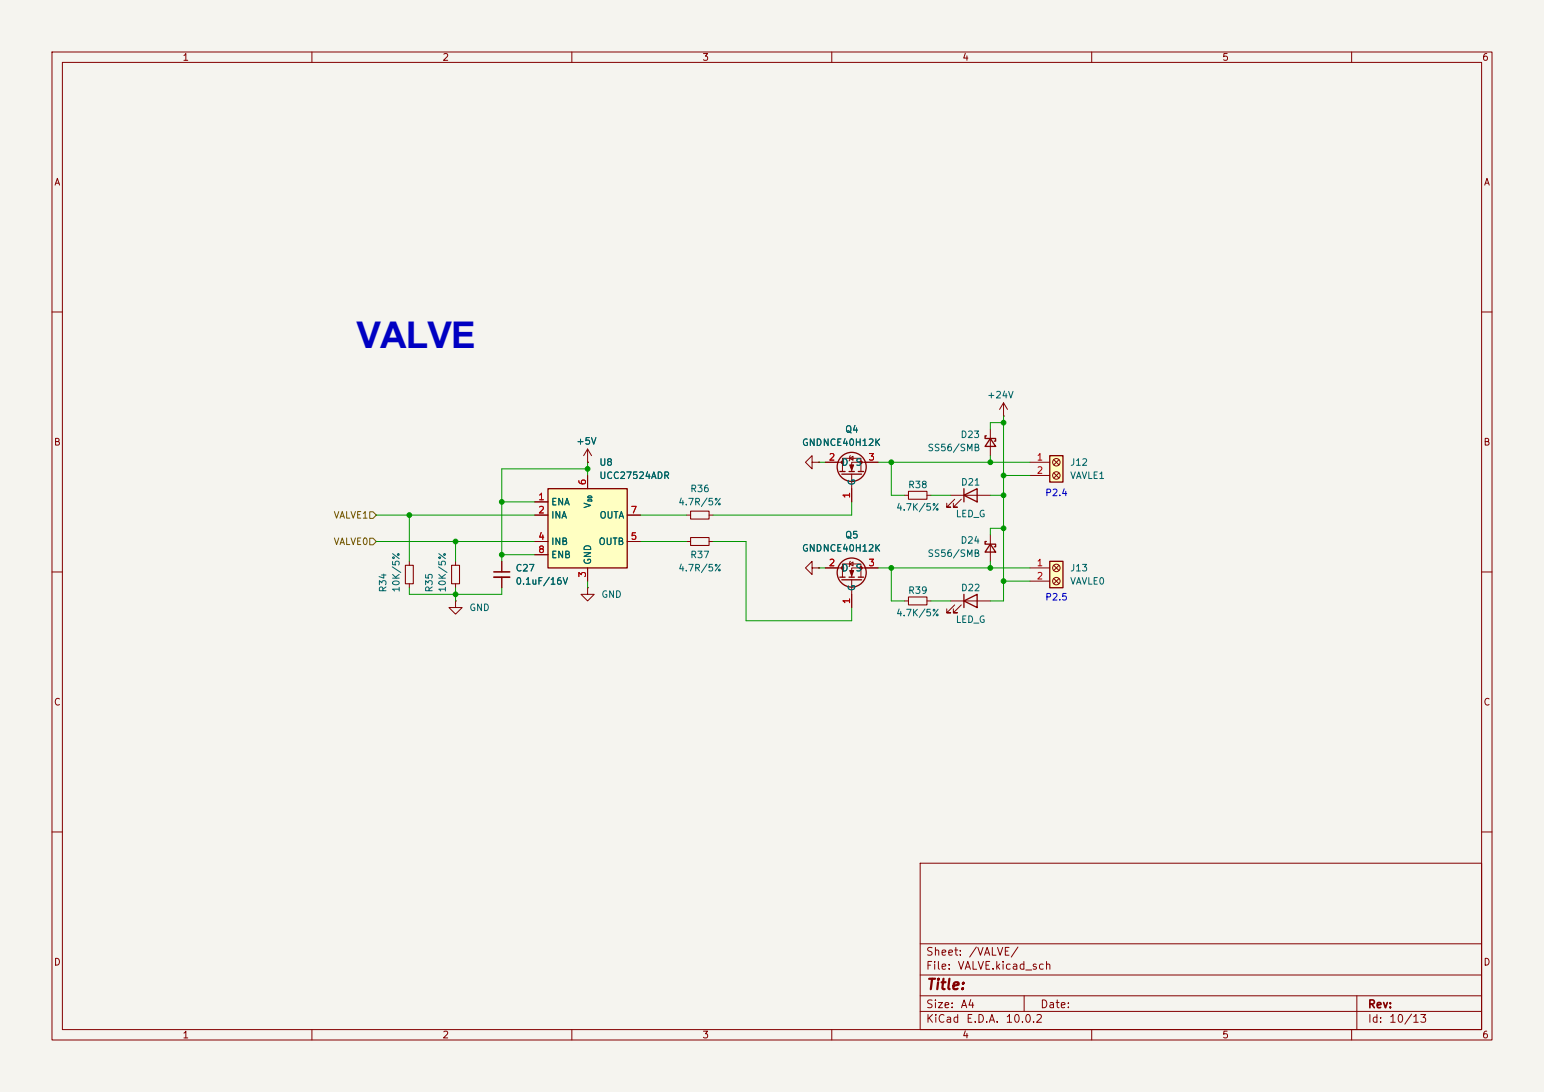
[picture p93: page 10]

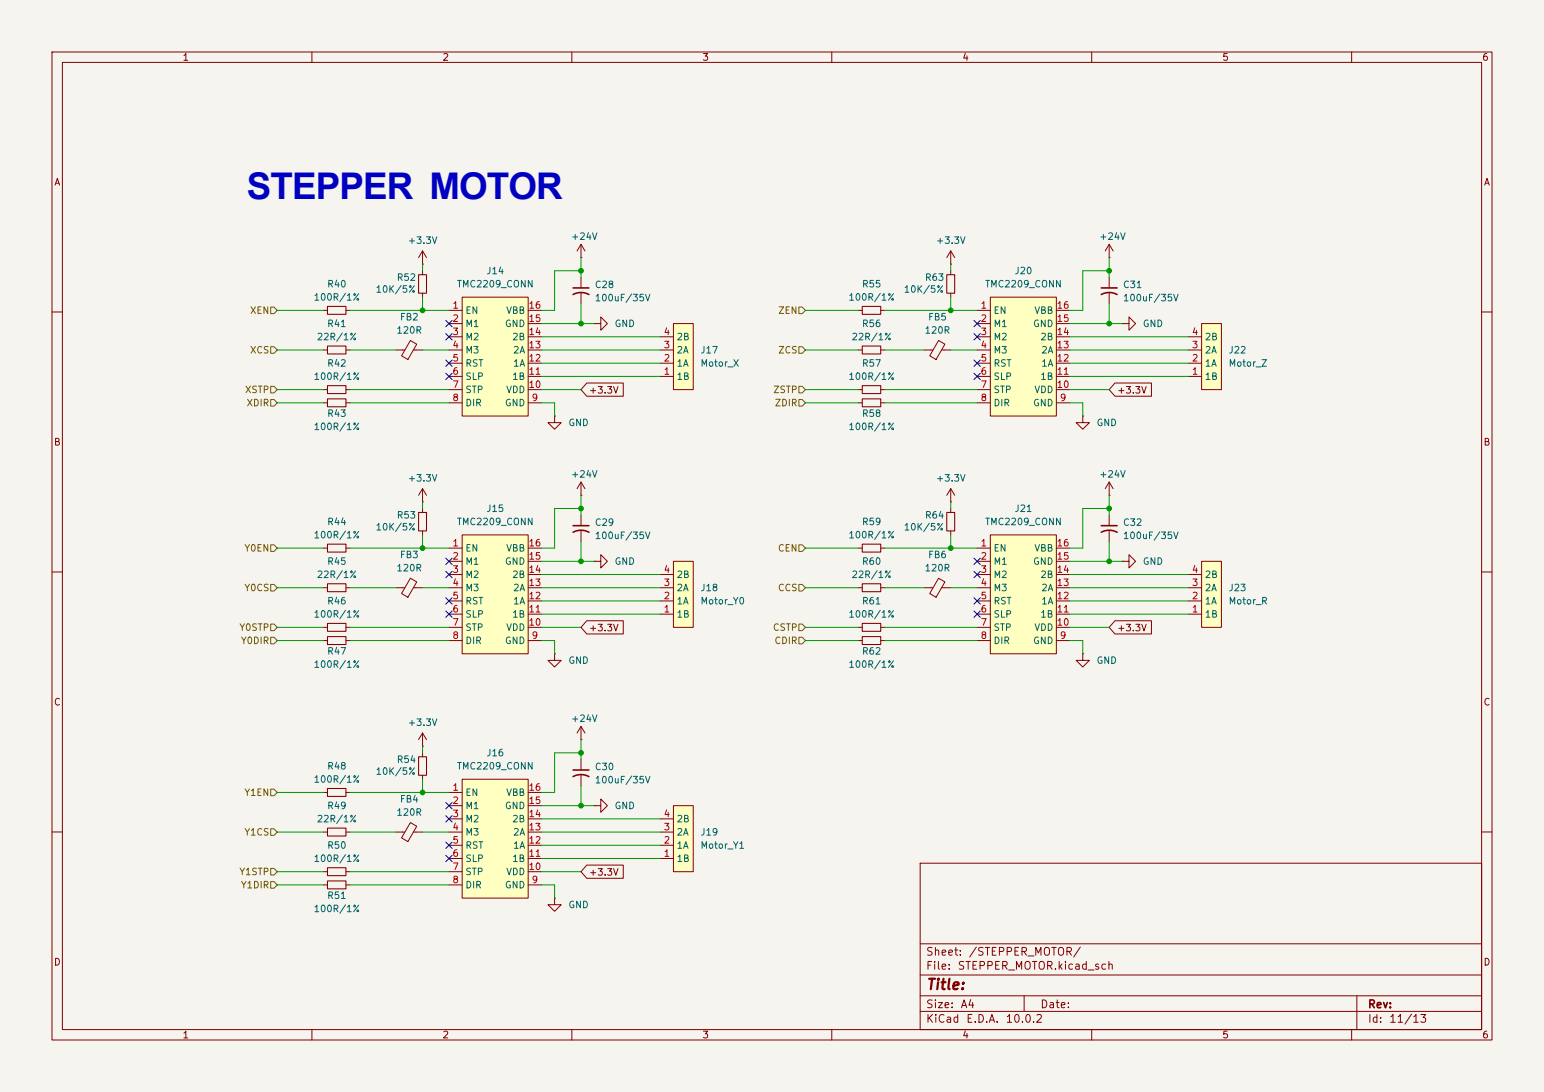
[picture p94: page 11]

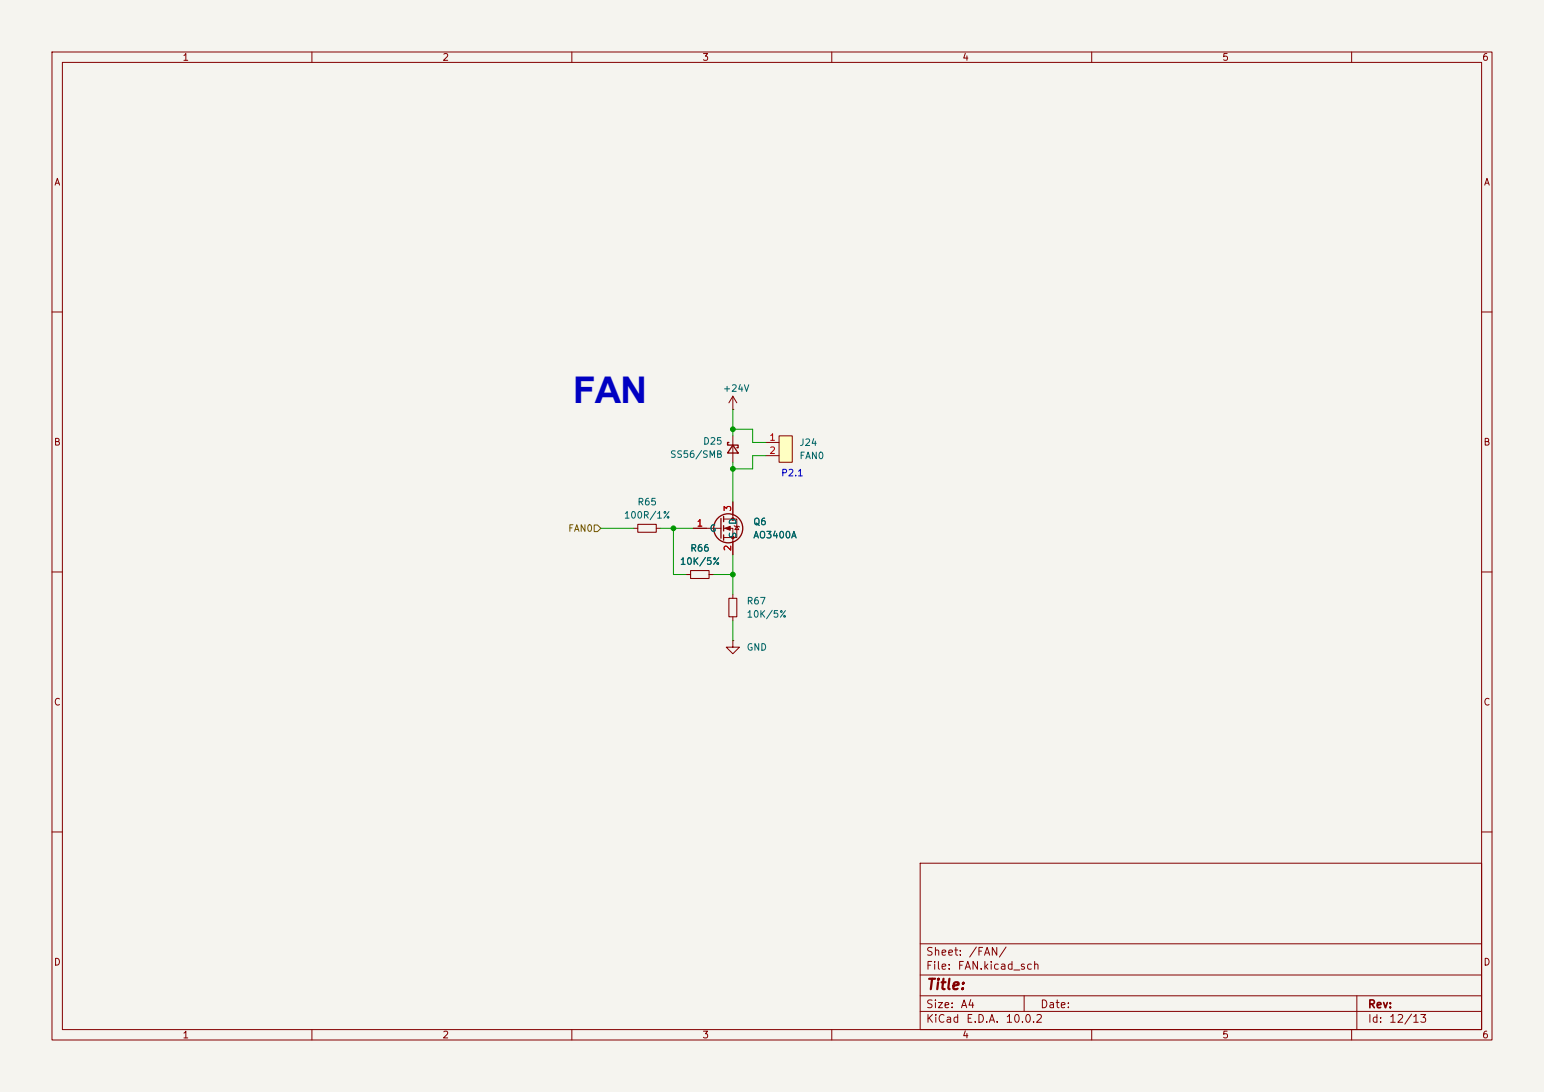
[picture p95: page 12]

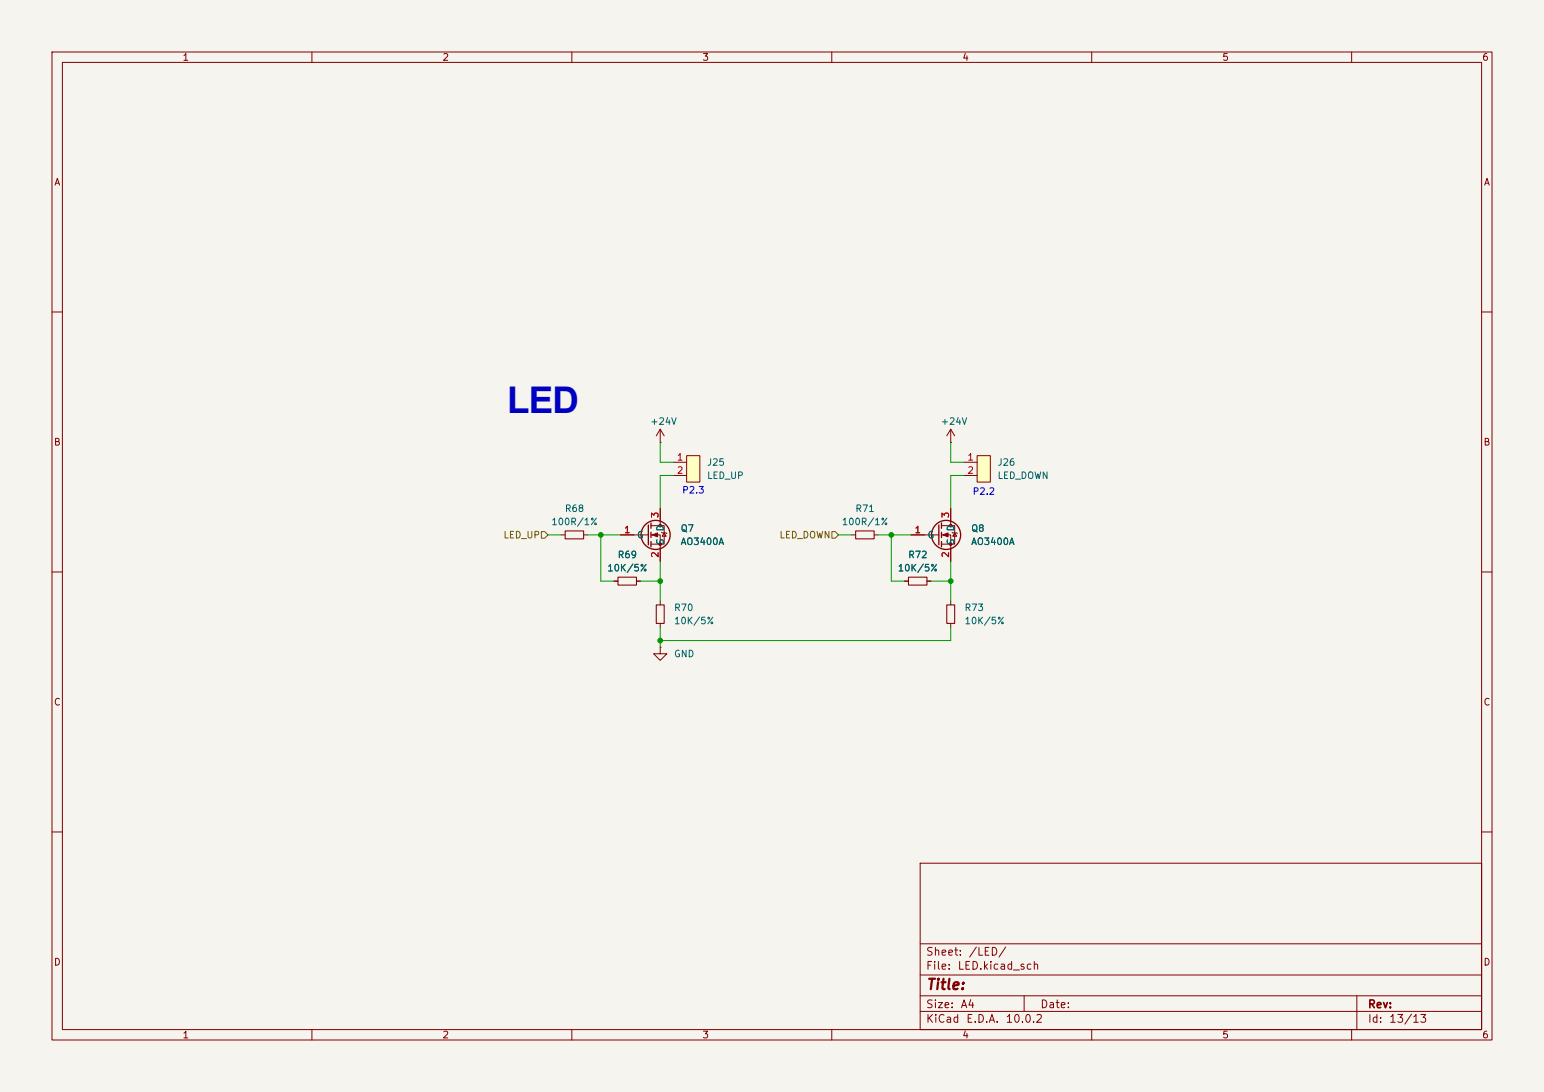
[picture p96: page 13]
