tominhcuong2041505-sys/SMT-Pick-and-Place/PCB/2026-08-03/LBoizPnP_Layout_2026-08-02.pdf

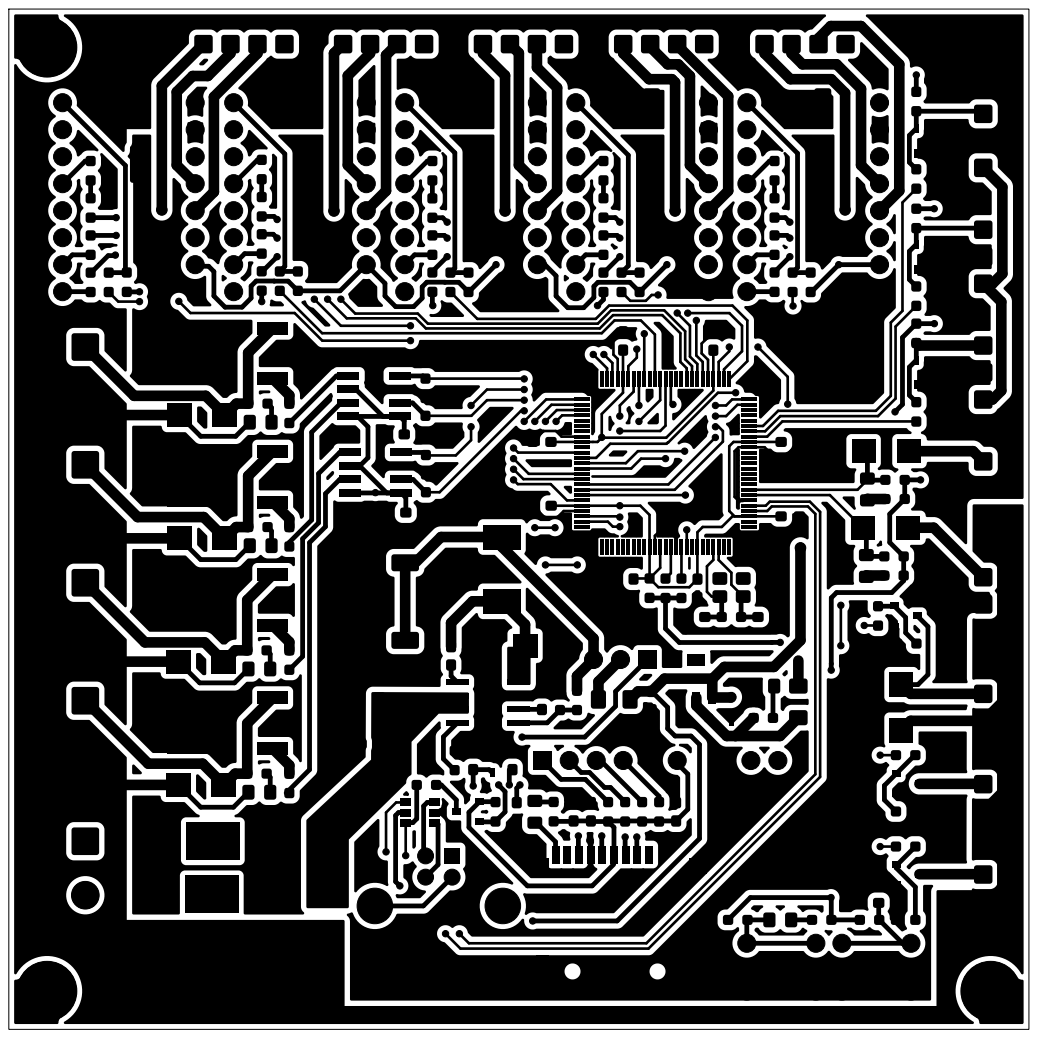
[picture p97: page 1]

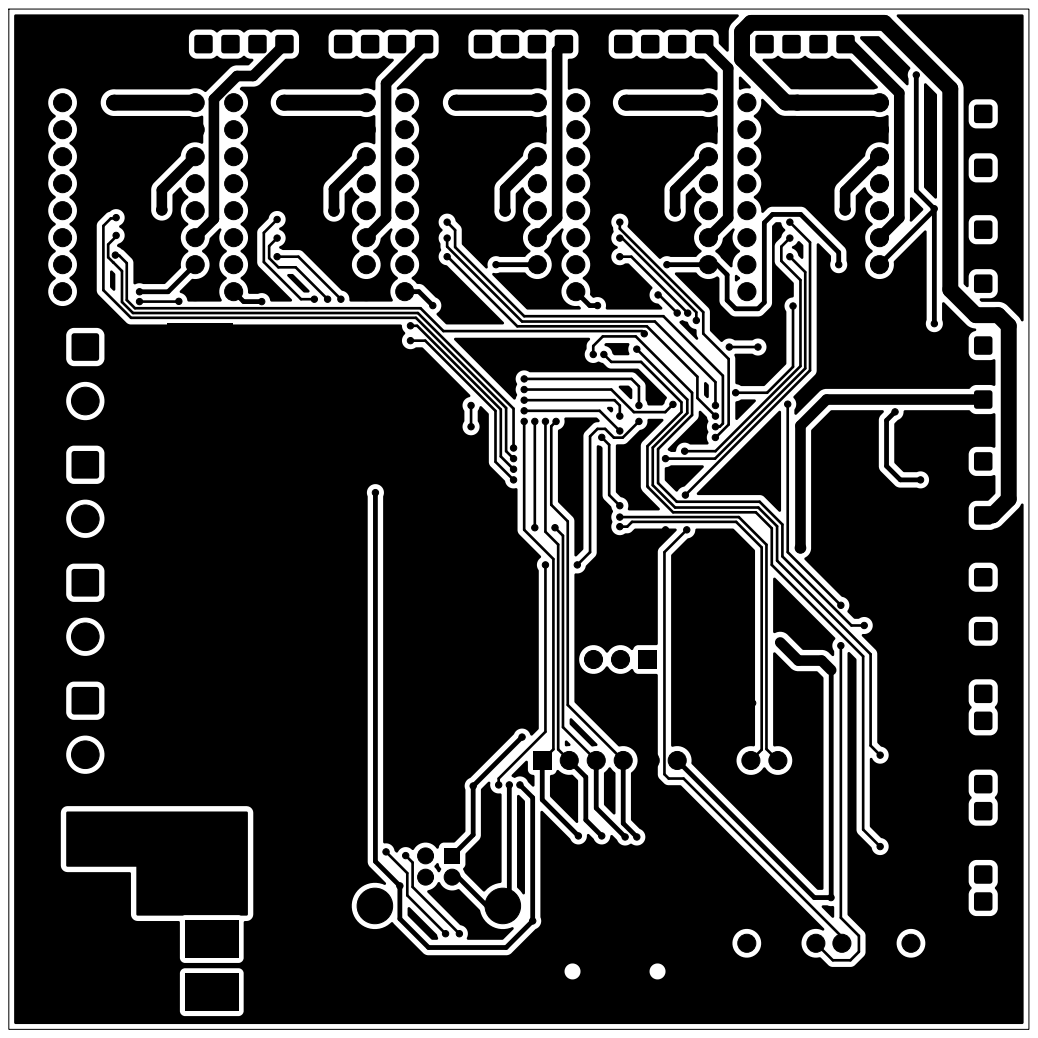
[picture p98: page 2]

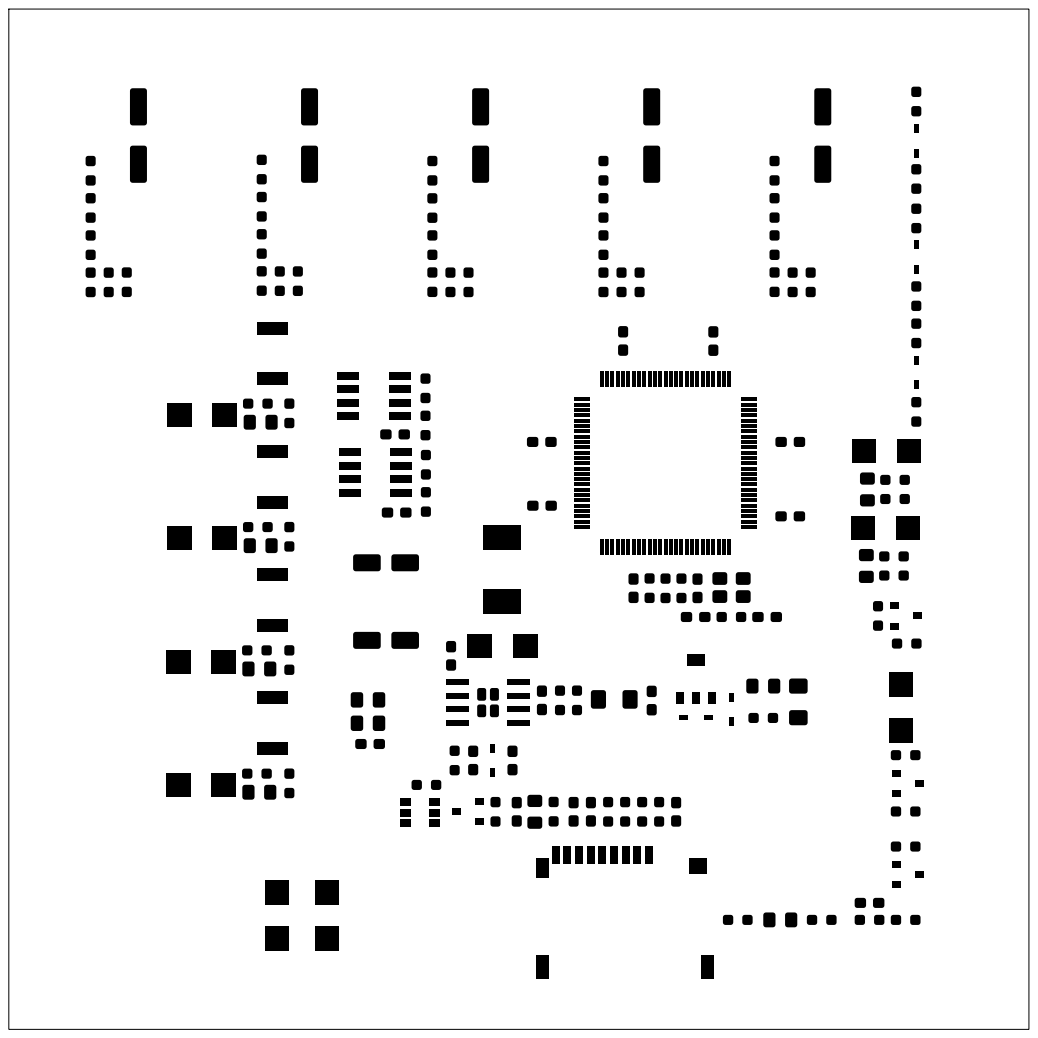
[picture p99: page 3]

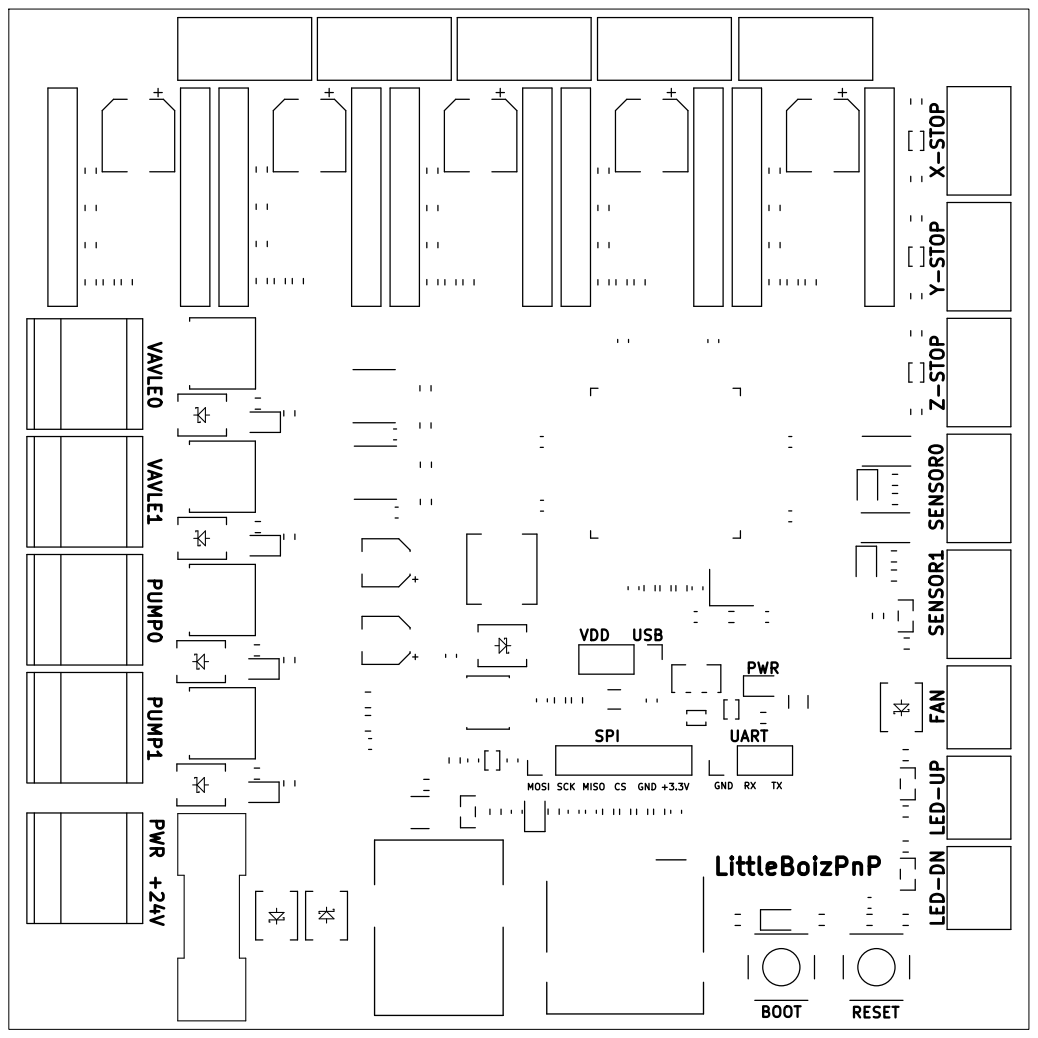
[picture p100: page 5]

VIN

GND

2B

## 2A1A1B

3V3 GND

X-AXIS

VIN

GND

2B

## 2A1A1B

3V3 GND

Y0-AXIS

VIN

GND

2B

## 2A1A1B

3V3 GND

Y1-AXIS Z-AXIS

VIN

GND

2B

## 2A1A1B

3V3 GND

R-AXIS

VIN

GND

2B

## 2A1A1B

3V3 GND

## ENM1 M2RX

TX CLK

STP

DIR

## ENM1 M2RX

TX CLK

STP

DIR

## ENM1 M2RX

TX CLK

STP

DIR

## ENM1 M2RX

TX CLK

STP

DIR

## ENM1 M2RX

TX CLK

STP

DIR

# P1.29 P1.28 P1.27 P1.18 P1.19 P2.1 P2.3 P2.2 GND

GND

GND

GND

GND P2.5 + P2.4 + P0.15 + P0.16 + + - D- D+ VBUS GND + + + + + + + +

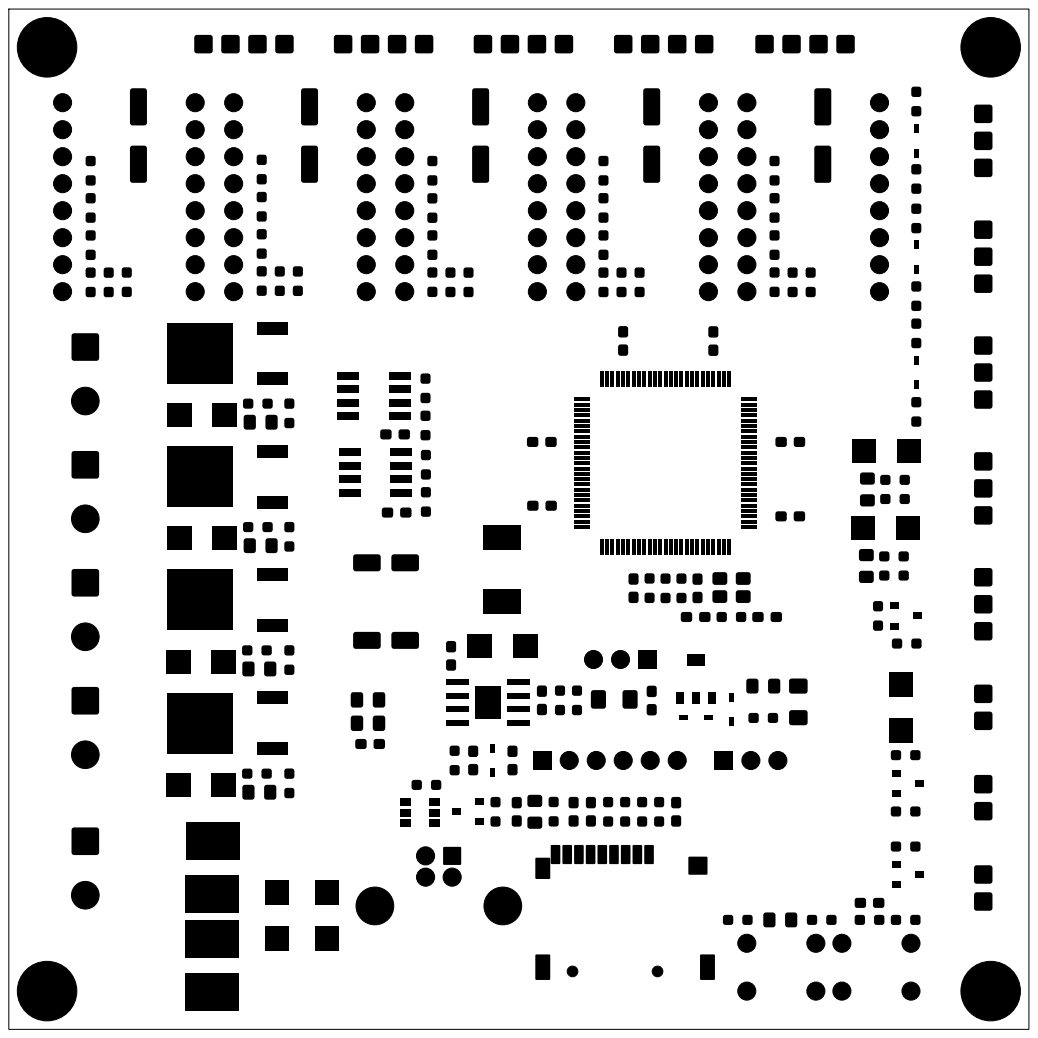
[picture p101: page 7]

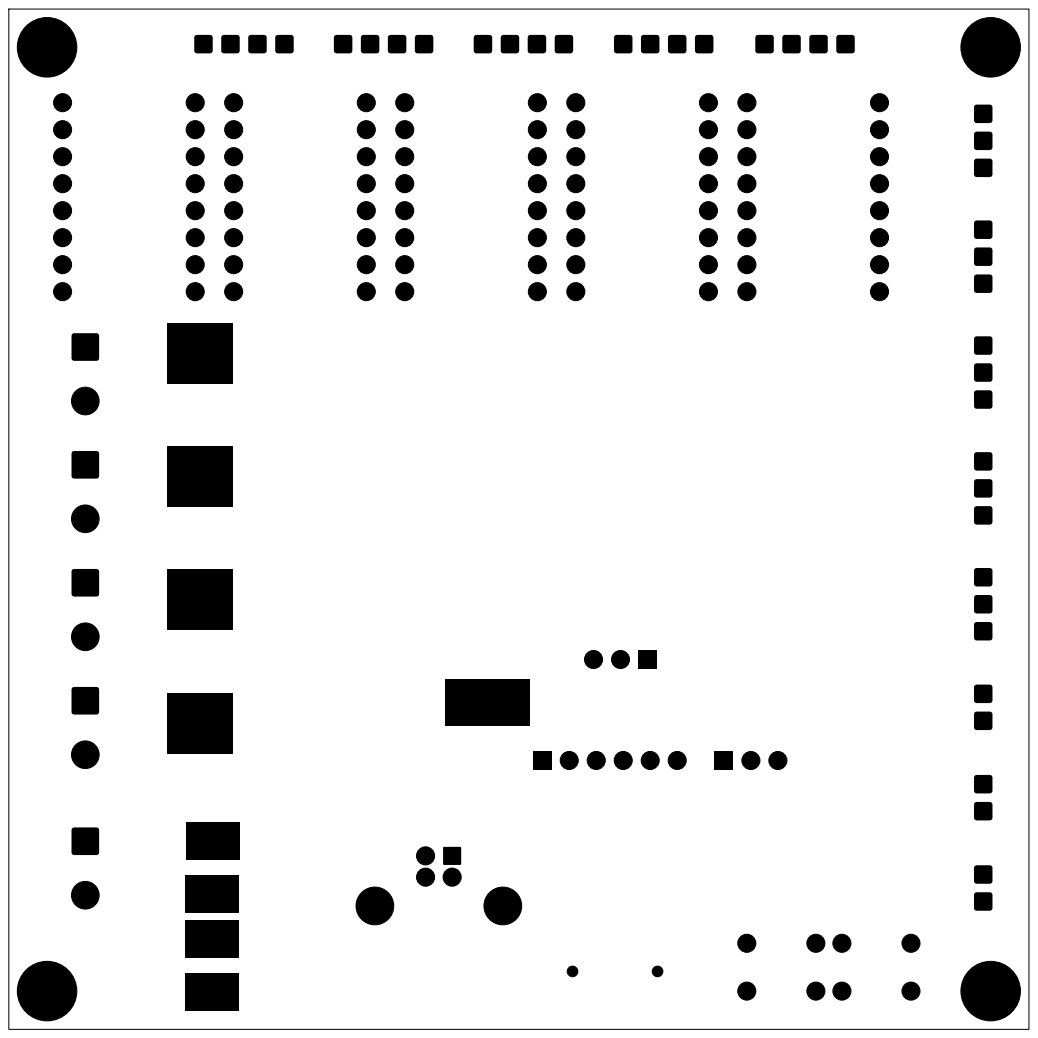
[picture p102: page 8]
