tominhcuong2041505-sys/SMT-Pick-and-Place/PCB/2026-08-28/LBoizPnP_BlockDiagram_2026-06-29.pdf

# SƠ ĐỒ KHỐI TỔNG QUÁT

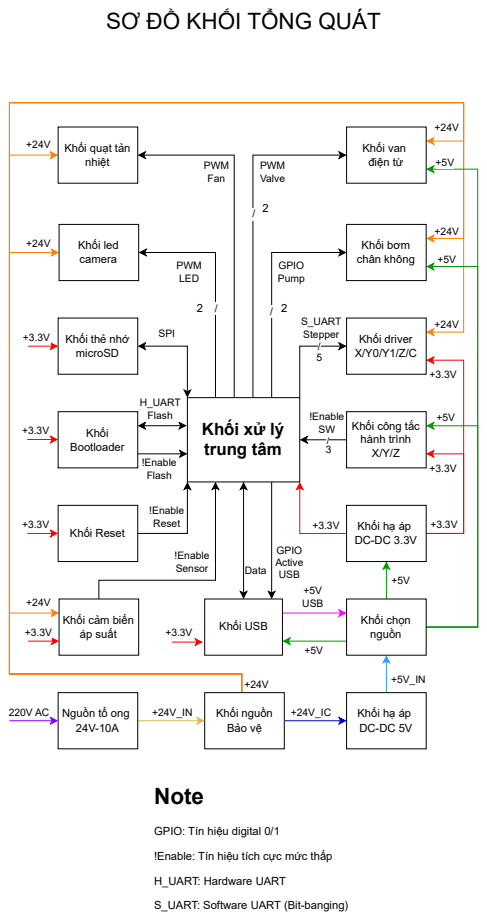
[picture p109: page 1]
Khối nguồn Bảo vệ; Khối chọn nguồn; +5V USB; Khối USB; Khối hạ áp; !Enable; S_UART Stepper /; PWM LED; PWM Valve; PWM Fan; Data; GPIO Active USB; Khối xử lý; Flash; H_UART Flash; Bootloader; Khối bơm chân không; !Enable Sensor; !Enable SW /; Khối driver X/Y0/Y1/Z/C; GPIO Pump; Khối led camera; Khối van điện từ; Note; H_UART: Hardware UART; Nguồn tổ ong

Khối quạt tản
nhiệt

SPI Khối thẻ nhớ
microSD

Khối công tắc
hành trình

Khối
trung tâm !Enable

Reset Khối Reset

Khối cảm biến
áp suất

Khối hạ áp

GPIO: Tín hiệu digital 0/1

!Enable: Tín hiệu tích cực mức thấp

S_UART: Software UART (Bit-banging)

# SƠ ĐỒ KHỐI CHI TIẾT

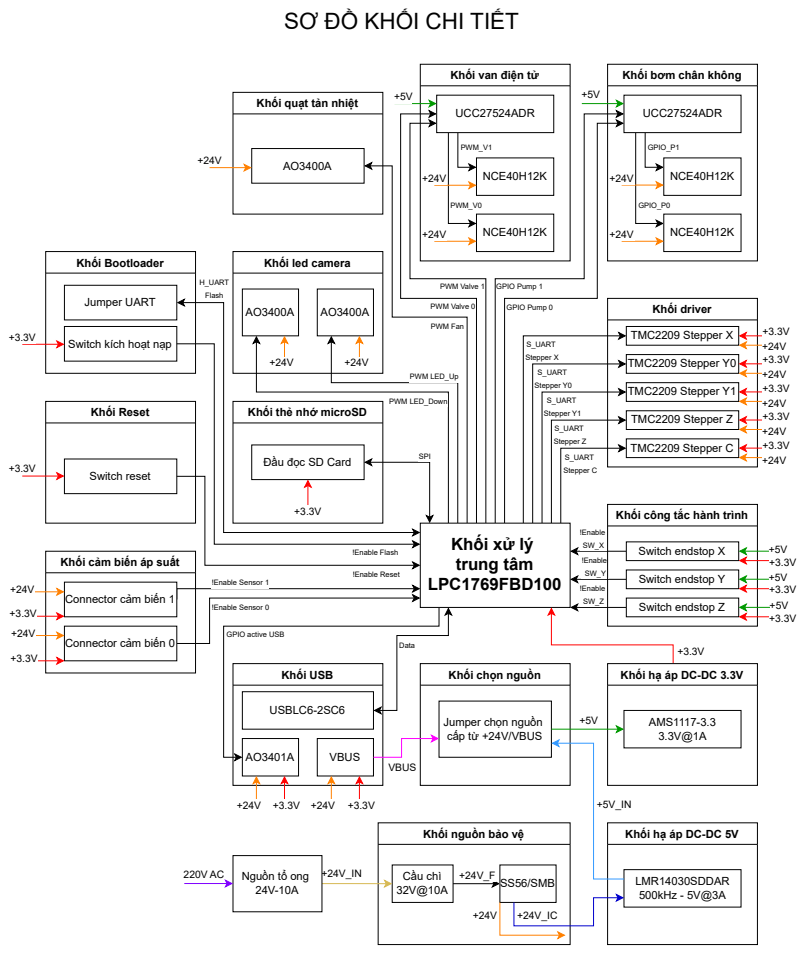
[picture p110: page 2]
!Enable; S_UART; Stepper C; Stepper Z; Stepper Y1; Stepper Y0; Stepper X; PWM Valve 0; PWM LED_Down; PWM LED_Up; PWM Fan; SPI; Data; !Enable Sensor 1; !Enable Sensor 0; PWM Valve 1; GPIO Pump 1; GPIO Pump 0; Cầu chì; SS56/SMB; LMR14030SDDAR 500kHz - 5V@3A; Khối USB; USBLC6-2SC6; VBUS; AMS1117-3.3 3.3V@1A; Switch endstop X; Switch endstop Y; Switch endstop Z; Khối driver; TMC2209 Stepper X; TMC2209 Stepper Y0; TMC2209 Stepper Y1; TMC2209 Stepper Z; TMC2209 Stepper C; UCC27524ADR; NCE40H12K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

Khối van điện tử

Khối bơm chân không

Khối quạt tản nhiệt

Khối led camera

Switch kích hoạt nạp

Khối thẻ nhớ microSD

Đầu đọc SD Card

Khối công tắc hành trình

Khối xử lý
trung tâm
LPC1769FBD100

Khối cảm biến áp suất

Connector cảm biến 1

GPIO active USB

Connector cảm biến 0

Khối chọn nguồn

Khối hạ áp DC-DC 3.3V

Jumper chọn nguồn
cấp từ +24V/VBUS

Khối nguồn bảo vệ

Khối hạ áp DC-DC 5V

Nguồn tổ ong +24V_IN
