tominhcuong2041505-sys/SMT-Pick-and-Place/PCB/2026-08-28/LBoizPnP_Layout_2026-08-28.pdf

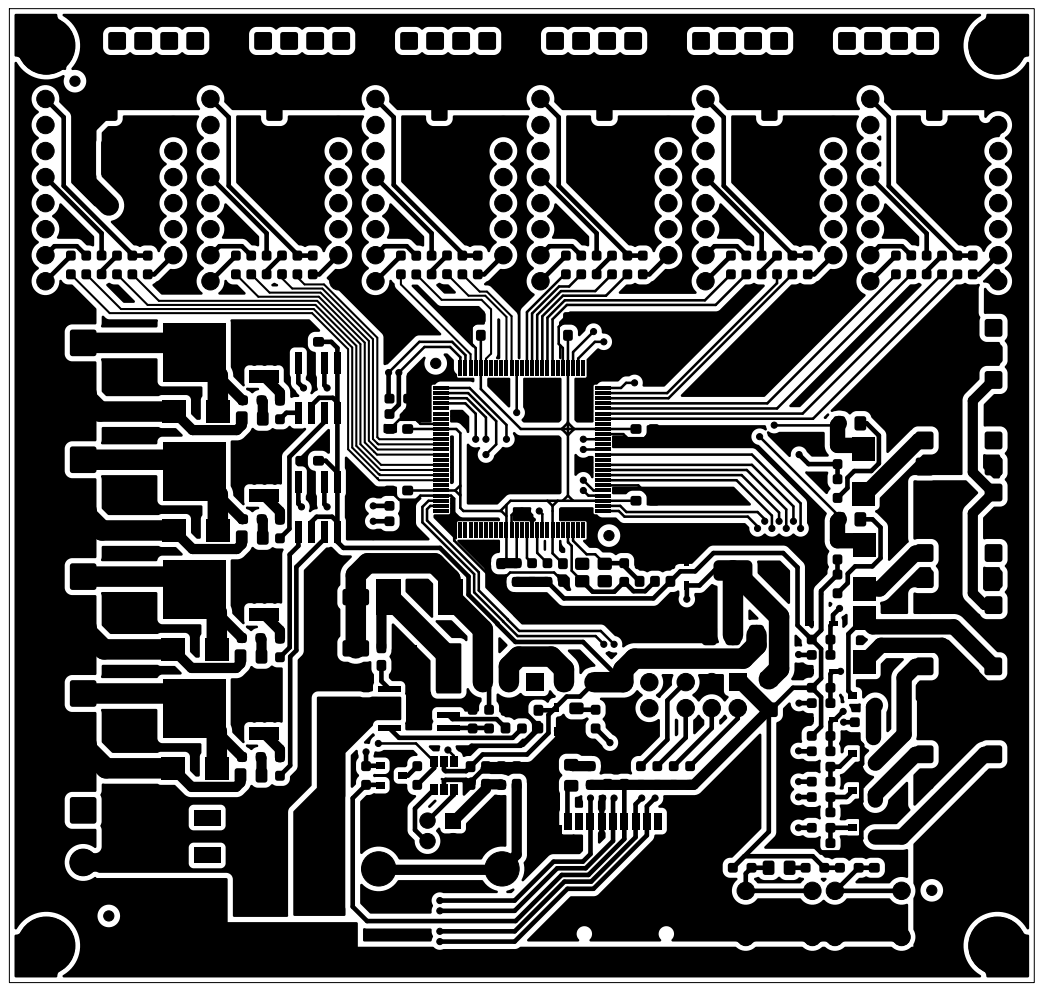
[picture p111: page 1]

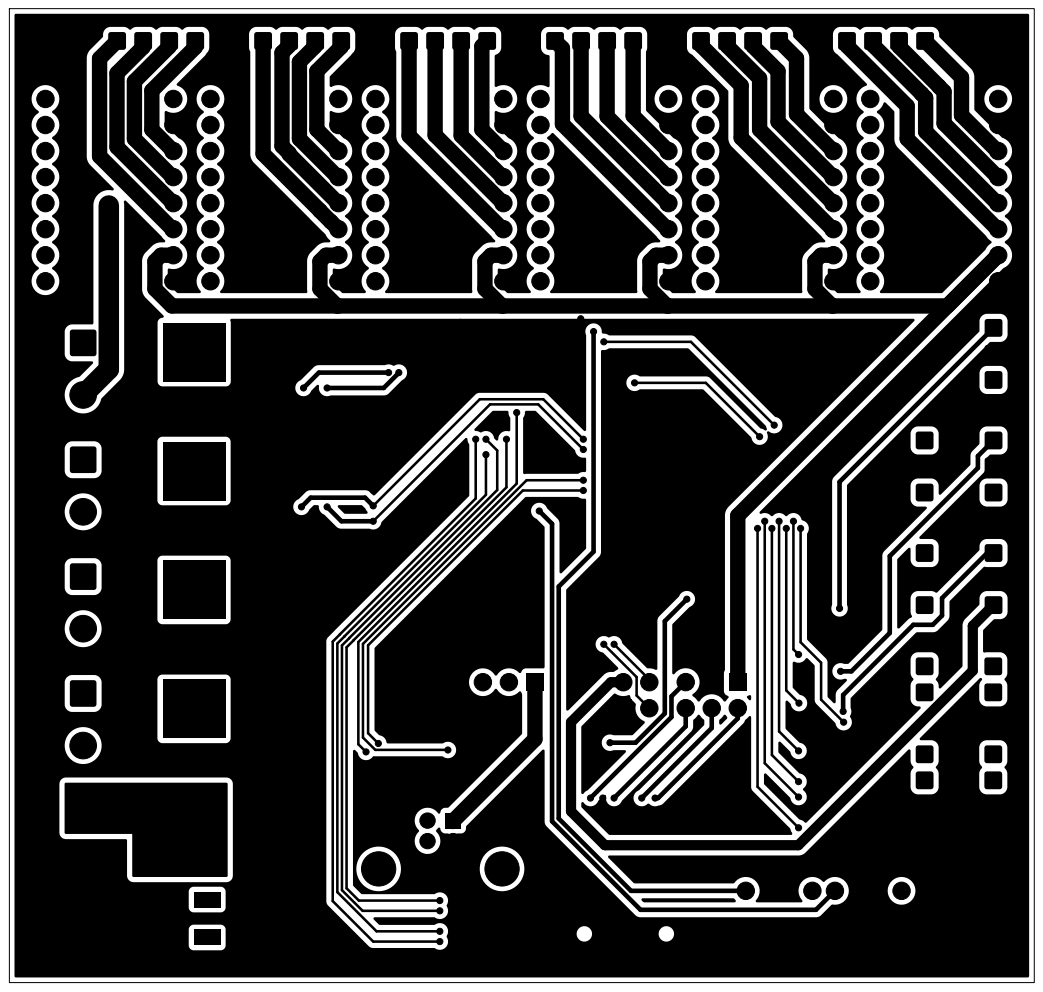
[picture p112: page 2]

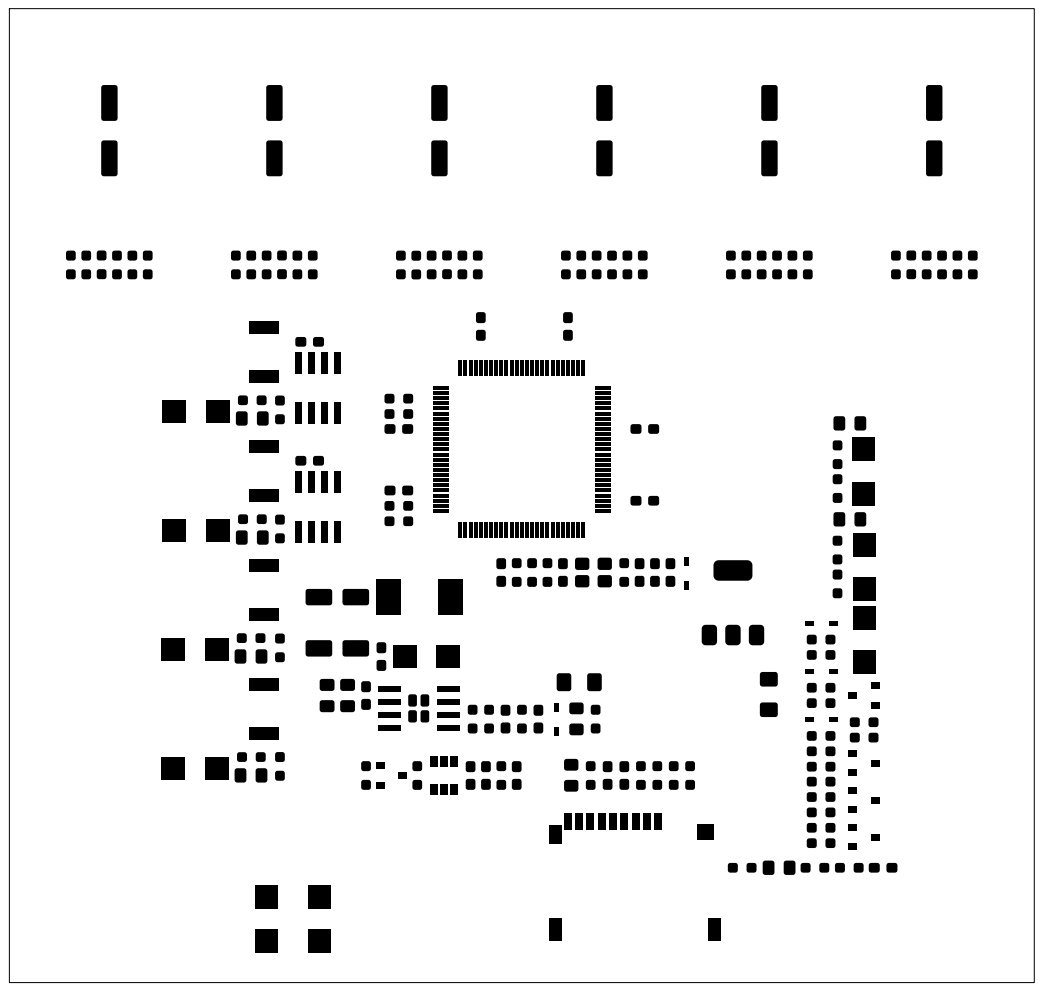
[picture p113: page 3]

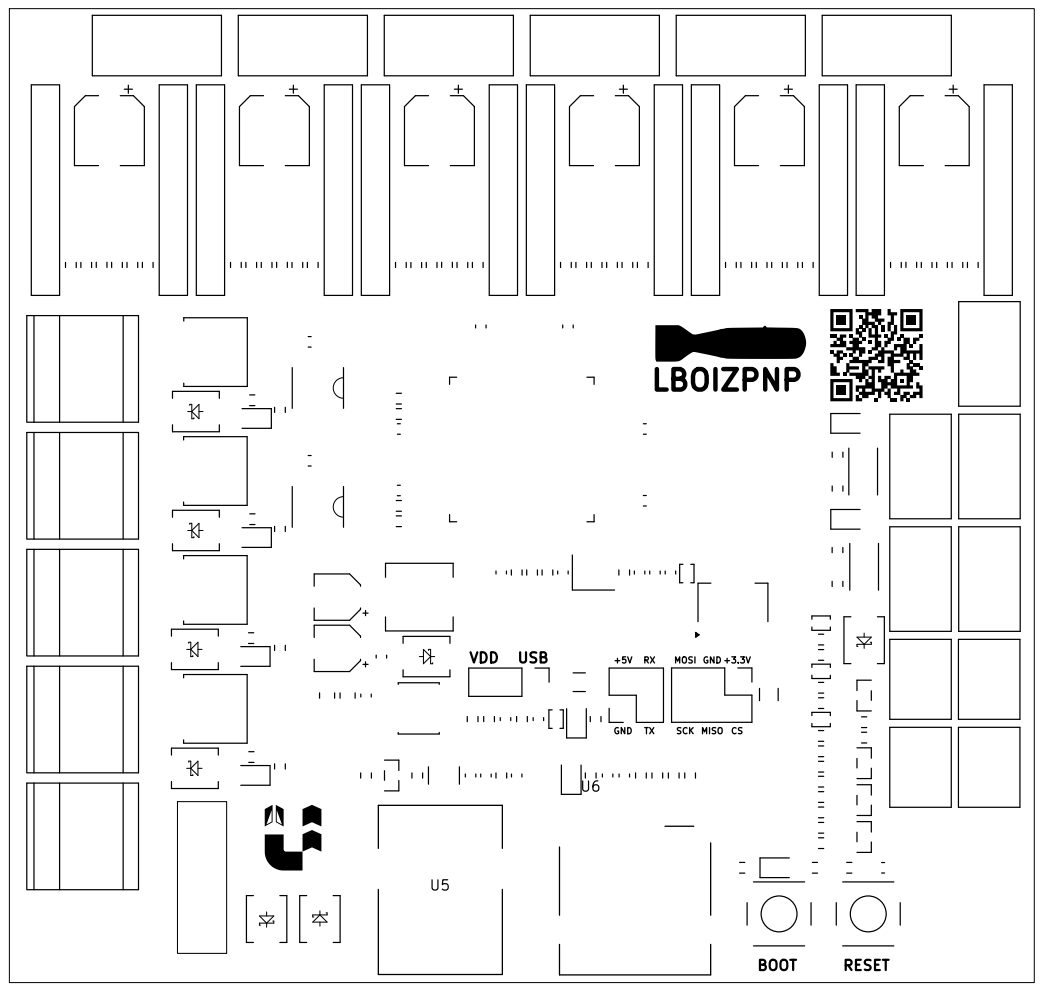
[picture p114: page 5]

GND +3.3V CS VDD USB

VIN

GND

2B

## 2A1A1B

3V3 GND

X-AXIS

VIN

GND

2B

## 2A1A1B

3V3 GND

Y0-AXIS Y1-AXIS

VIN

GND

2B

## 2A1A1B

3V3 GND

Z-AXIS

VIN

GND

2B

## 2A1A1B

3V3 GND

C0-AXIS

VIN

GND

2B

## 2A1A1B

3V3 GND

C1-AXIS

VIN

GND

2B

## 2A1A1B

3V3 GND

# P1.26 P1.24 +24V +24V +24V +24V P2.1 P2.0

## ENM1 M2RX

TX CLK

STP

DIR

## ENM1 M2RX

TX CLK

STP

DIR

## ENM1 M2RX

TX CLK

STP

DIR

D-D+

VBUS GND

## ENM1 M2RX

TX CLK

STP

DIR

## ENM1 M2RX

TX CLK

STP

DIR

# P2.11 P2.13 P1.18 P3.25 +24V +24V +24V +24V

## ENM1 M2RX

TX CLK

STP

DIR

GND

GND

# P1.21 P1.20 P1.19 P1.23 P3.26 +24V +24V GND

GND

GND +5V +5V +5V +

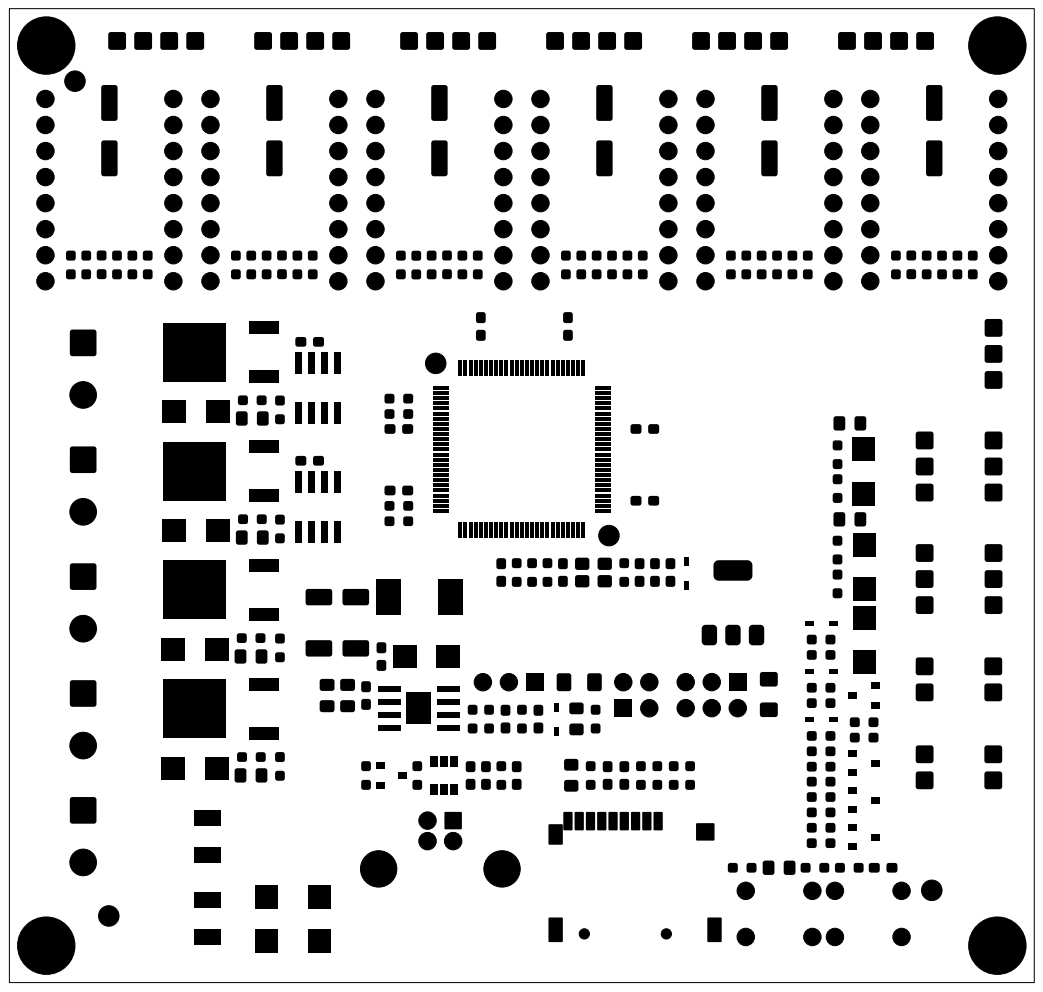
[picture p115: page 7]

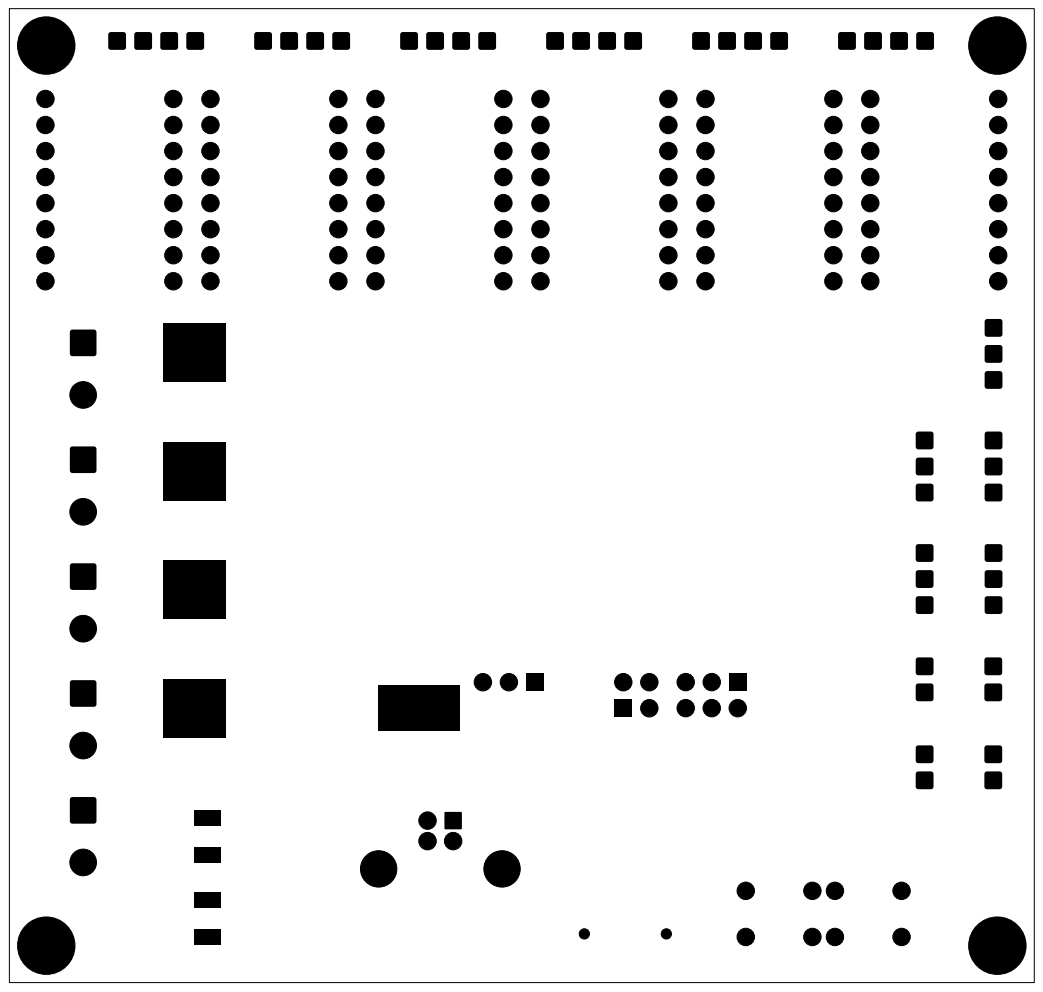
[picture p116: page 8]
