tominhcuong2041505-sys/SMT-Pick-and-Place/PCB/2026-09-16/LBoizPnP_Layout_2026-09-16.pdf

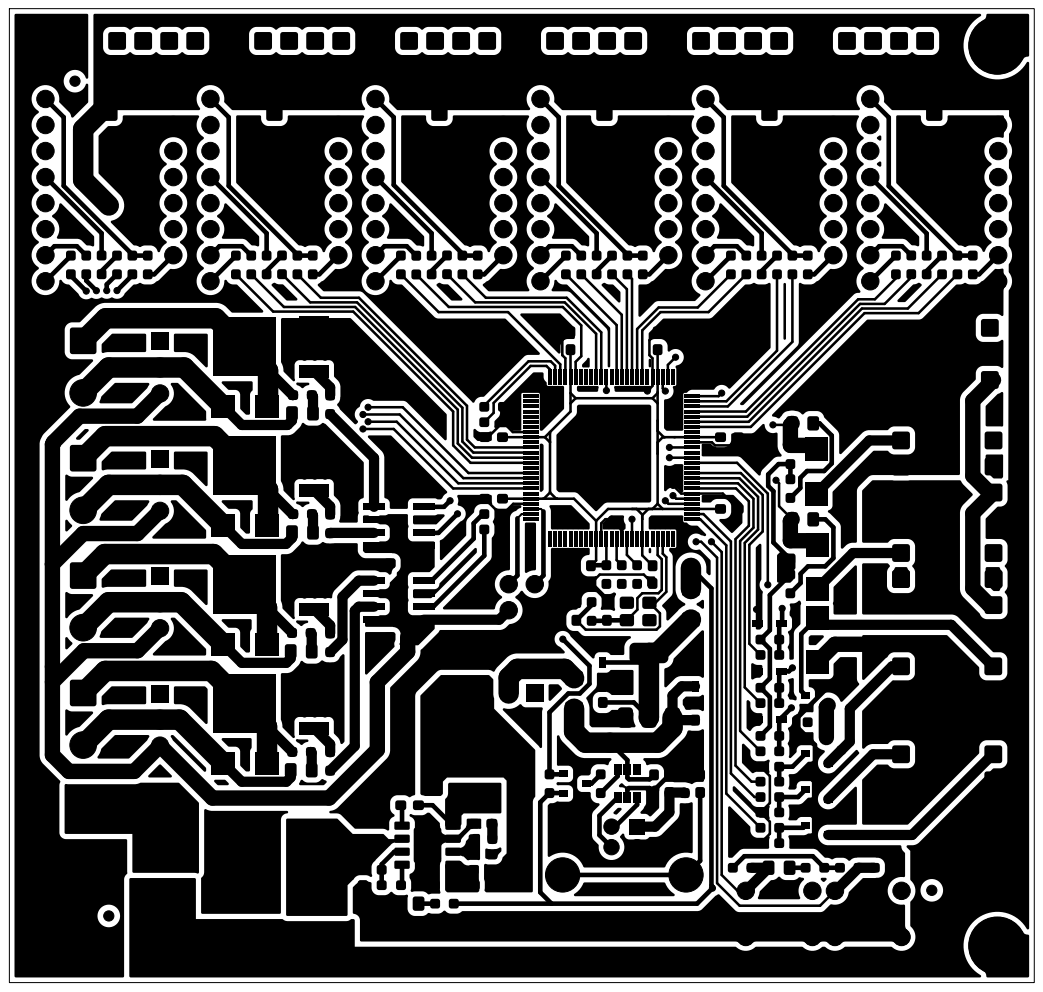
[picture p117: page 1]

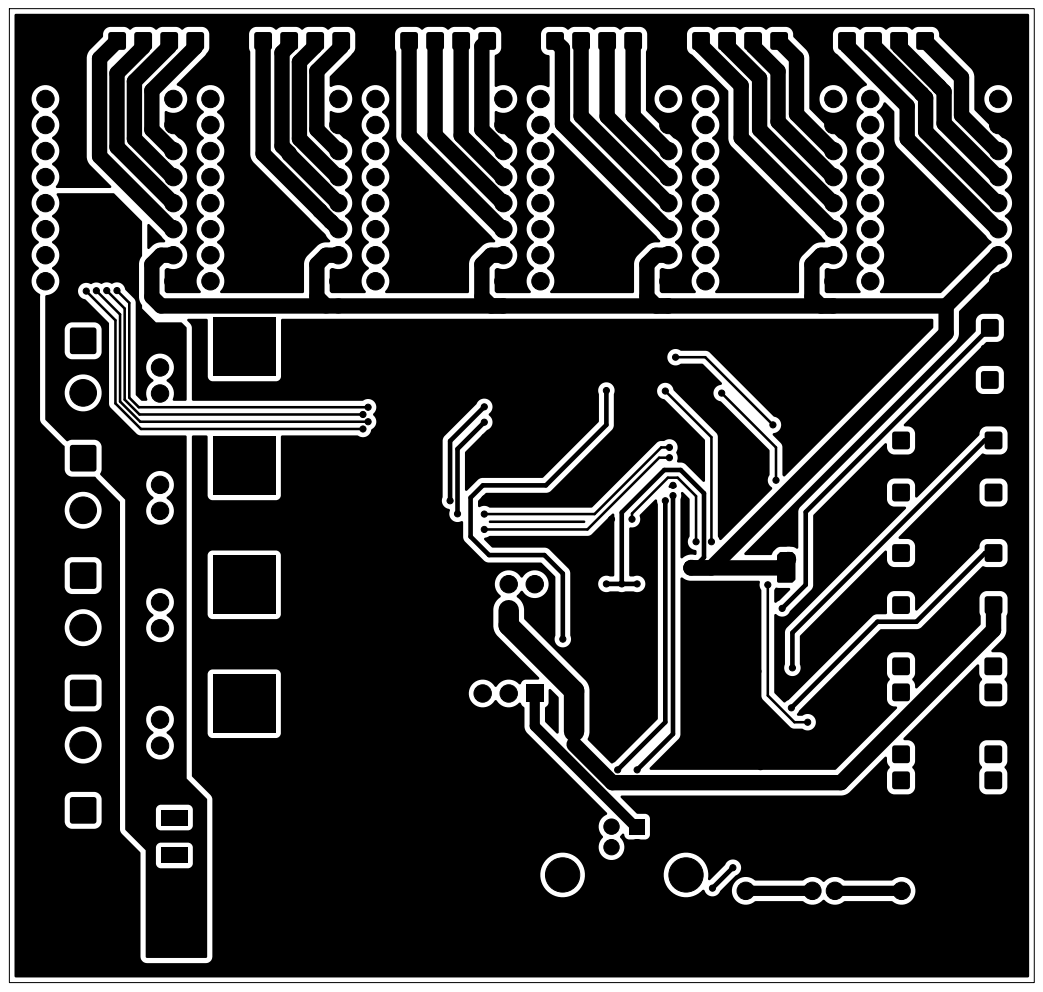
[picture p118: page 2]

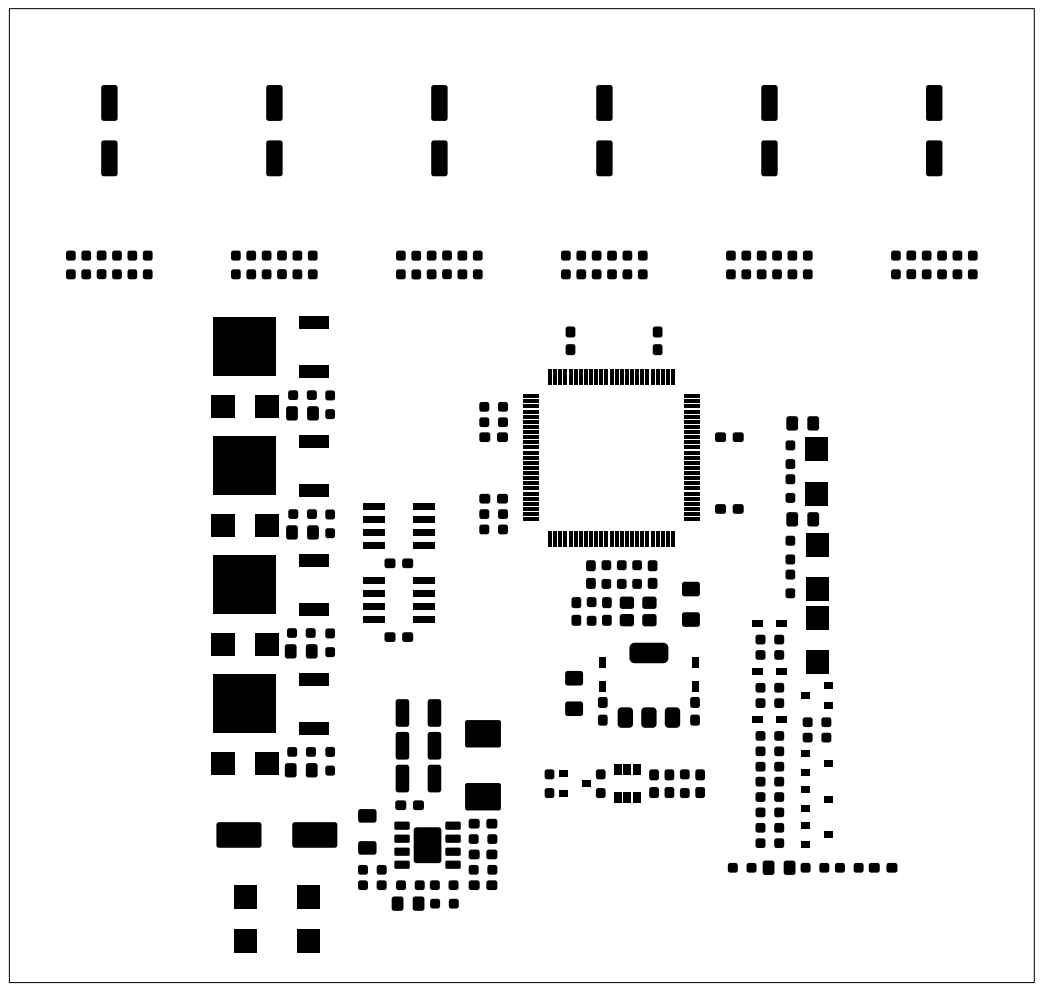
[picture p119: page 3]

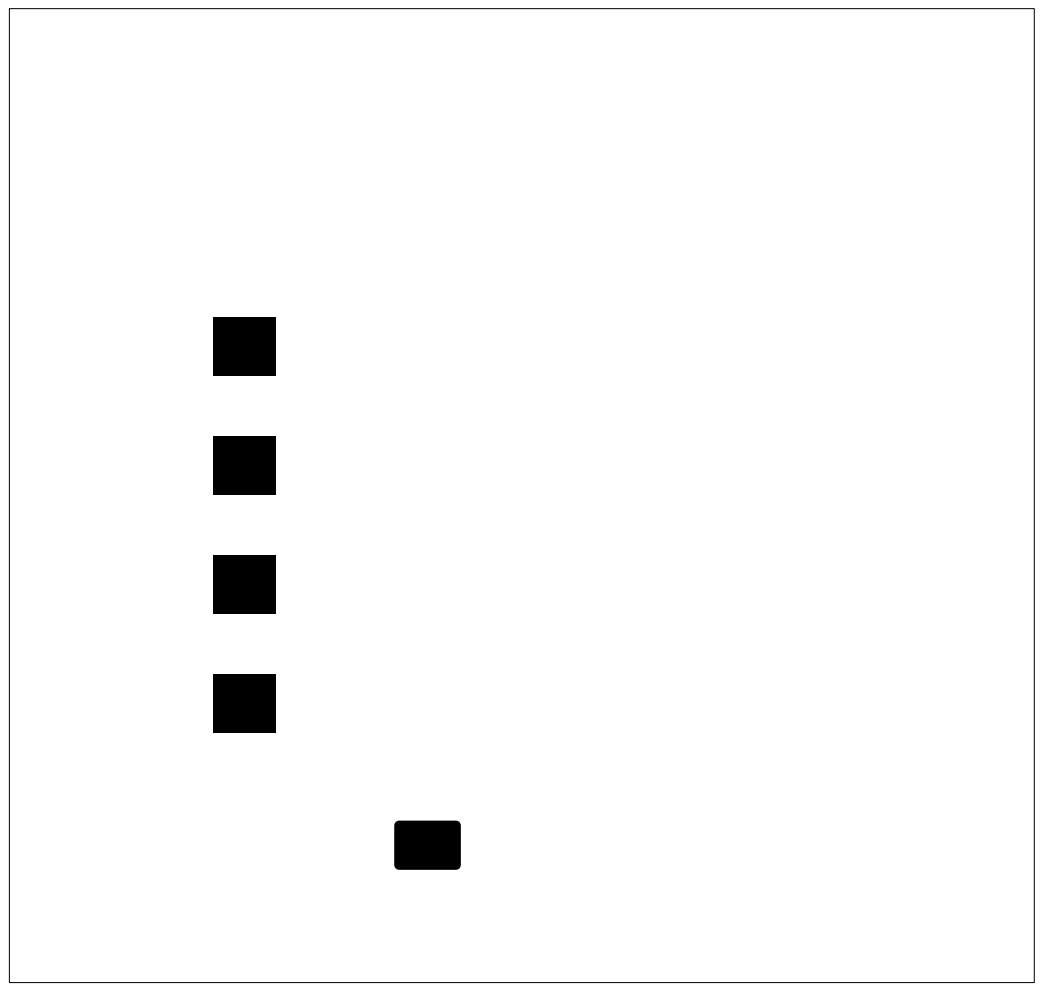
[picture p120: page 4]

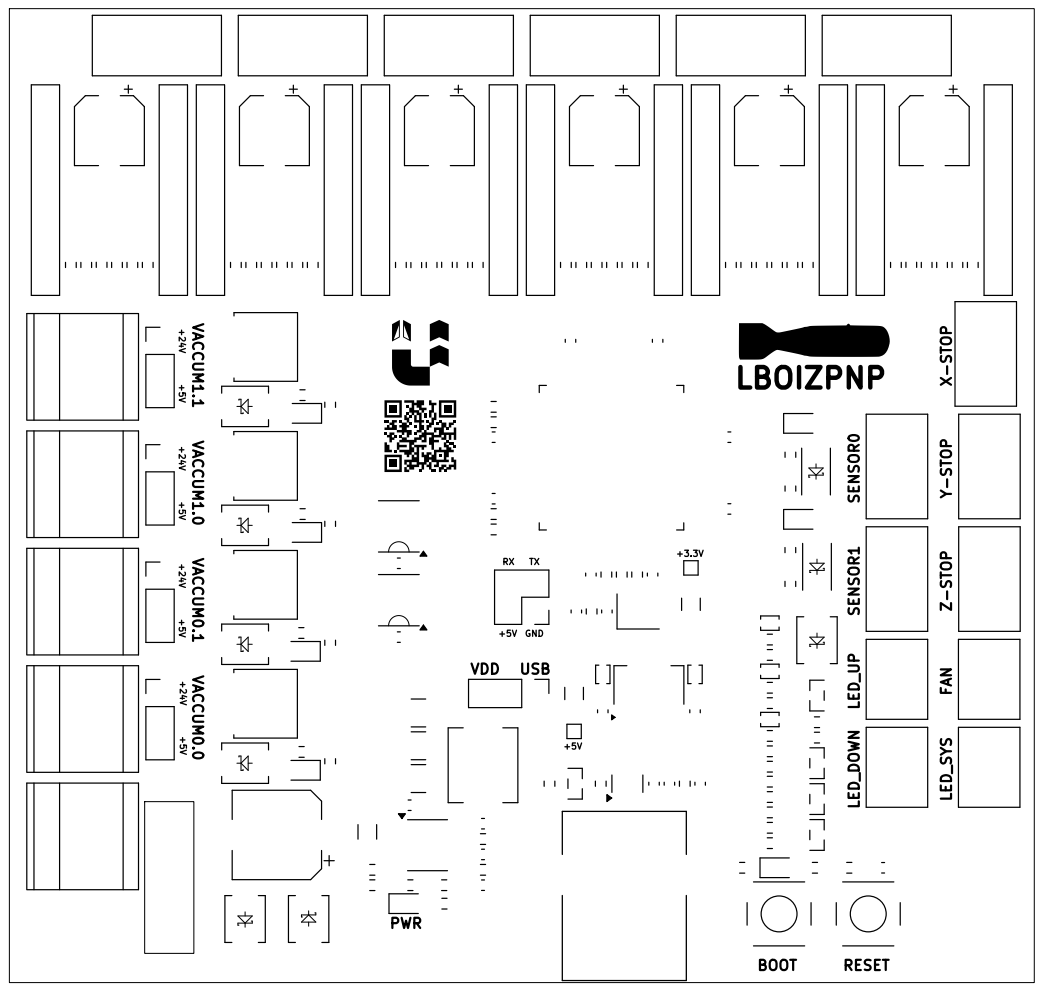
[picture p121: page 5]

X-STOP Y-STOP Z-STOP SENSOR0 SENSOR1 FAN LED_UP LED_DOWN LED_SYS VACCUM1.1 VACCUM1.0 VACCUM0.1 VACCUM0.0 +24V +24V +24V +24V +5V +5V +5V +5V +3.3V +5V +5V RX GND
TX PWR

VIN VIN

2B

## 2A1A1B

GND

GND GND

3V3

2B

# 1A3V3 GND

2A

VIN

GND

1B

GND

1A 3V3

1B

VIN

2A 2B

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
# 2A1AGND

VIN

2A 2A1AGND

VIN

2B

1A1B

3V3

VCC

P1.26

VCC

VCC

VCC

X-AXIS Y0-AXIS Y1-AXIS Z-AXIS C0-AXIS C1-AXIS P1.24 P2.1 P2.0

## ENM1 M2RX

TX CLK

STP

DIR

## ENM1 M2RX

TX CLK

STP

DIR

D-D+

## ENM1 M2RX

TX CLK

STP

DIR

VBUS GND

## ENM1 M2RX

TX CLK

STP

DIR

## ENM1 M2RX

TX CLK

STP

DIR

# P2.11 P2.13 P1.18 P3.25 +24V +24V +24V +24V

## ENM1 M2RX

TX CLK

STP

DIR

GND

GND

# P1.21 P1.20 P1.19 P1.23 P3.26 +24V +24V GND

GND

GND +5V +5V +5V +

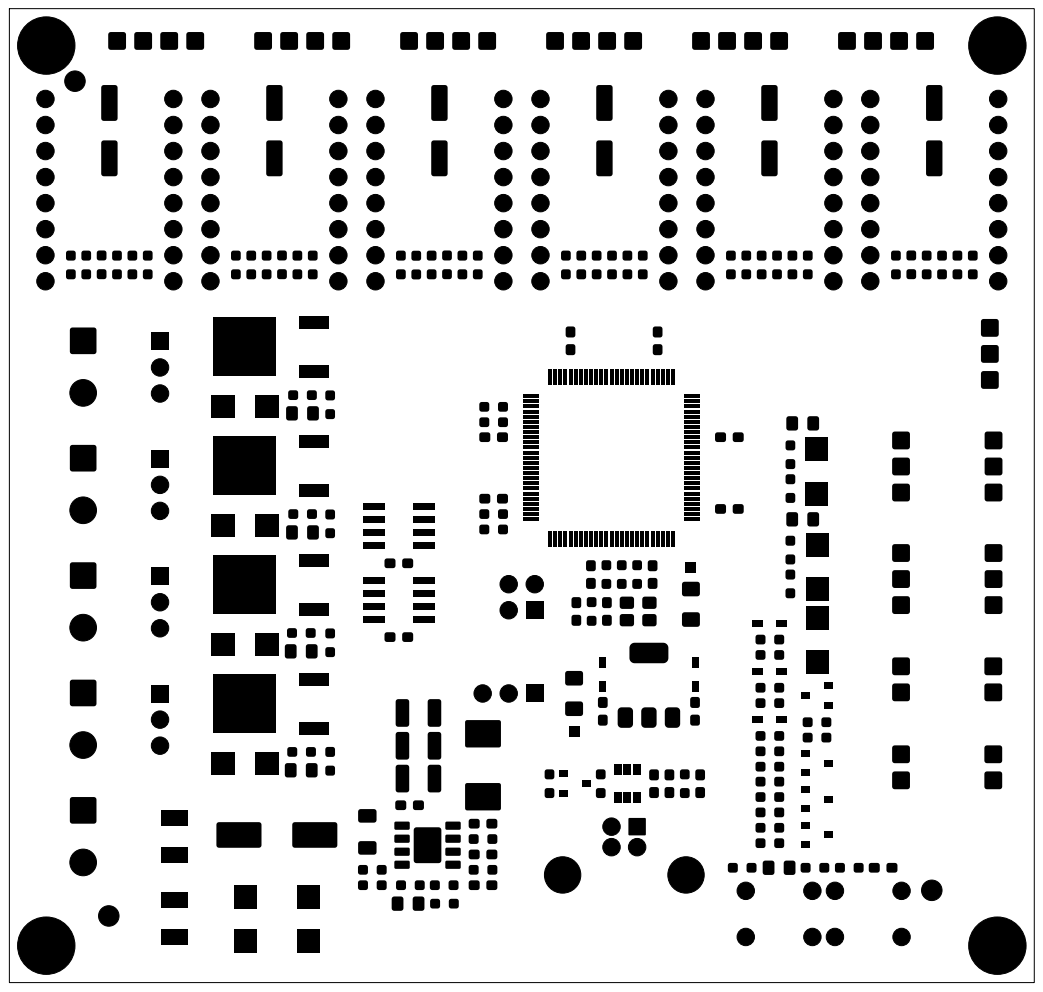
[picture p122: page 7]

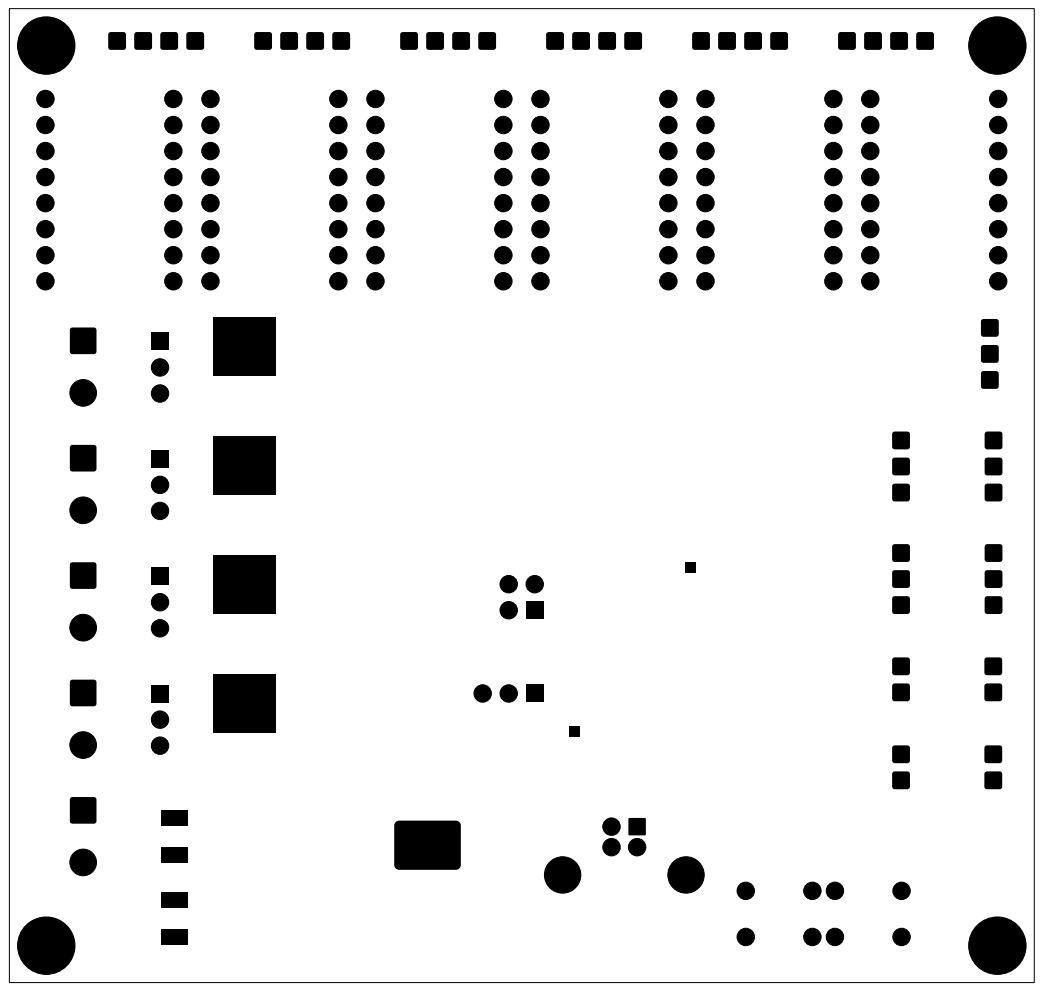
[picture p123: page 8]
