tominhcuong2041505-sys/SMT-Pick-and-Place/PCB/2026-09-20/LBoizPnP_Layout_2026-09-19.pdf

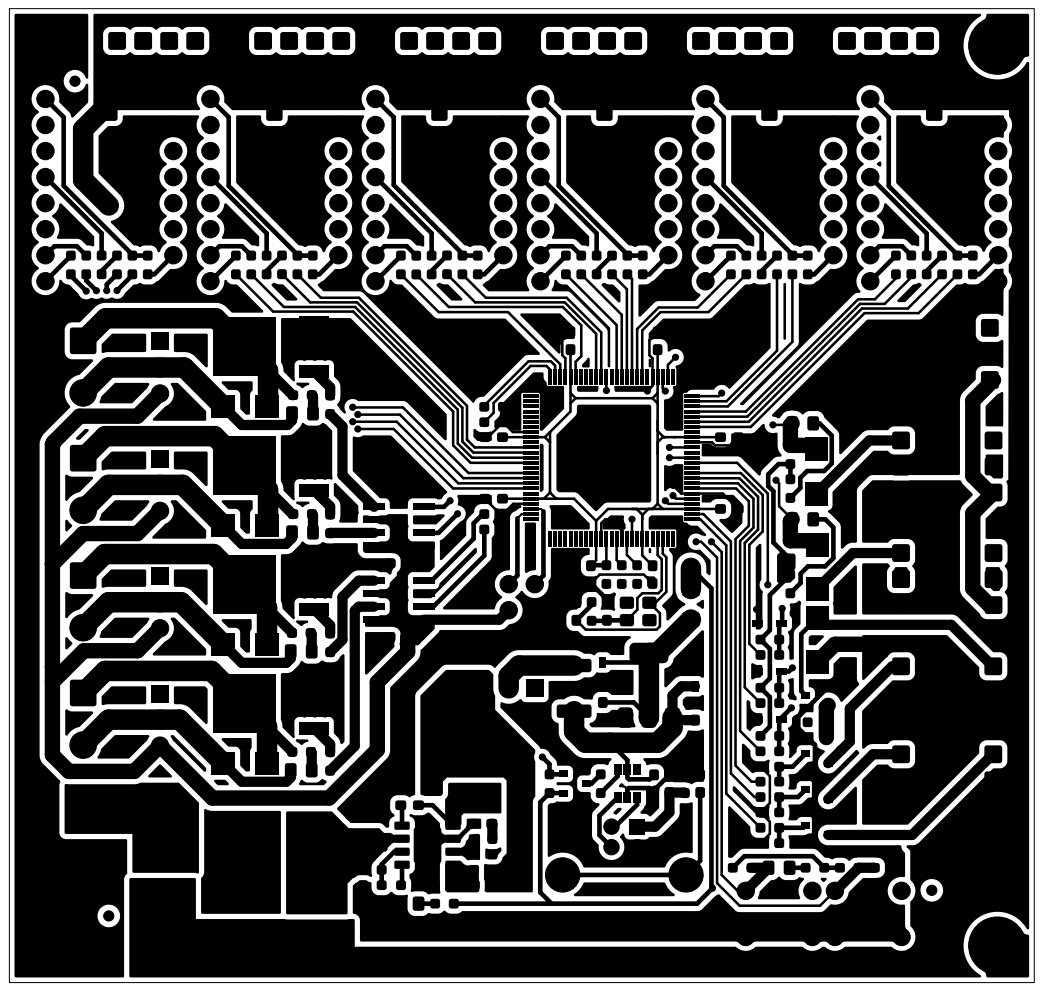
[picture p124: page 1]

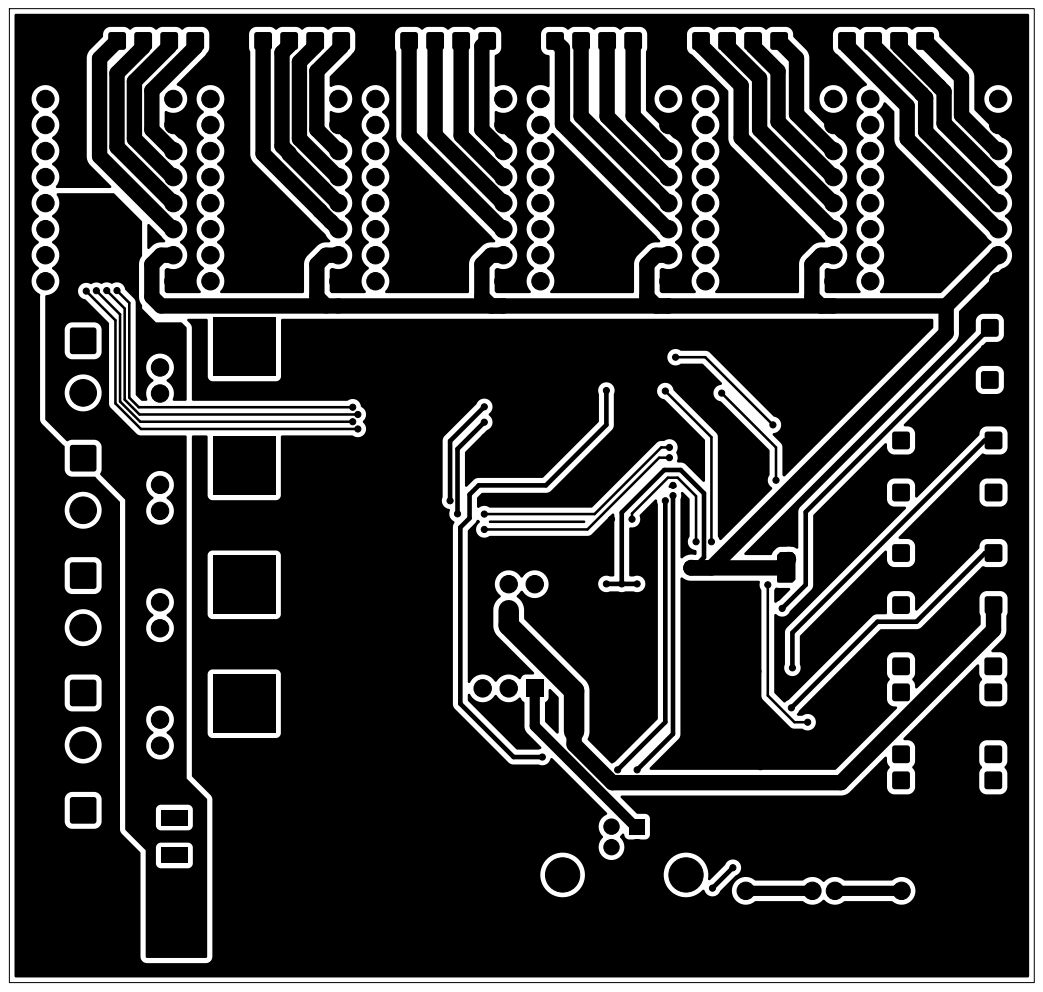
[picture p125: page 2]

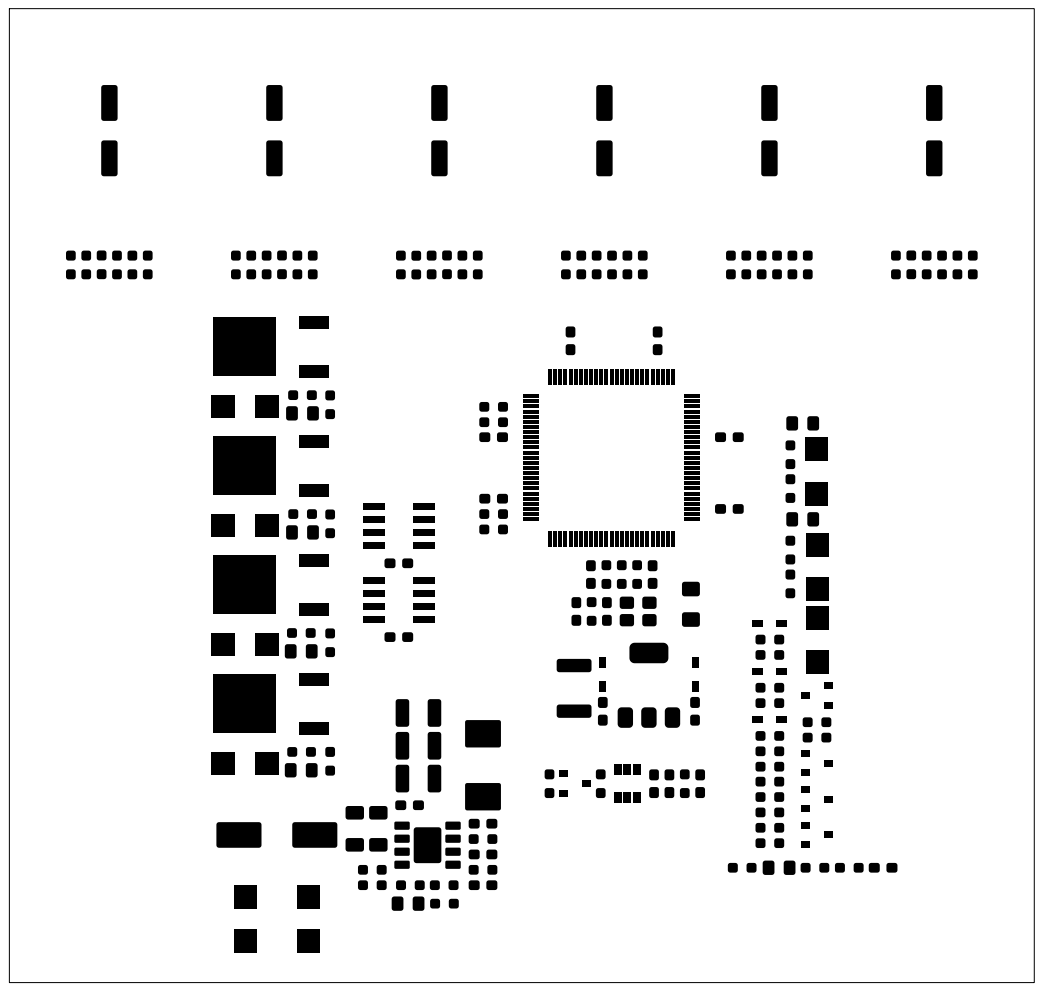
[picture p126: page 3]


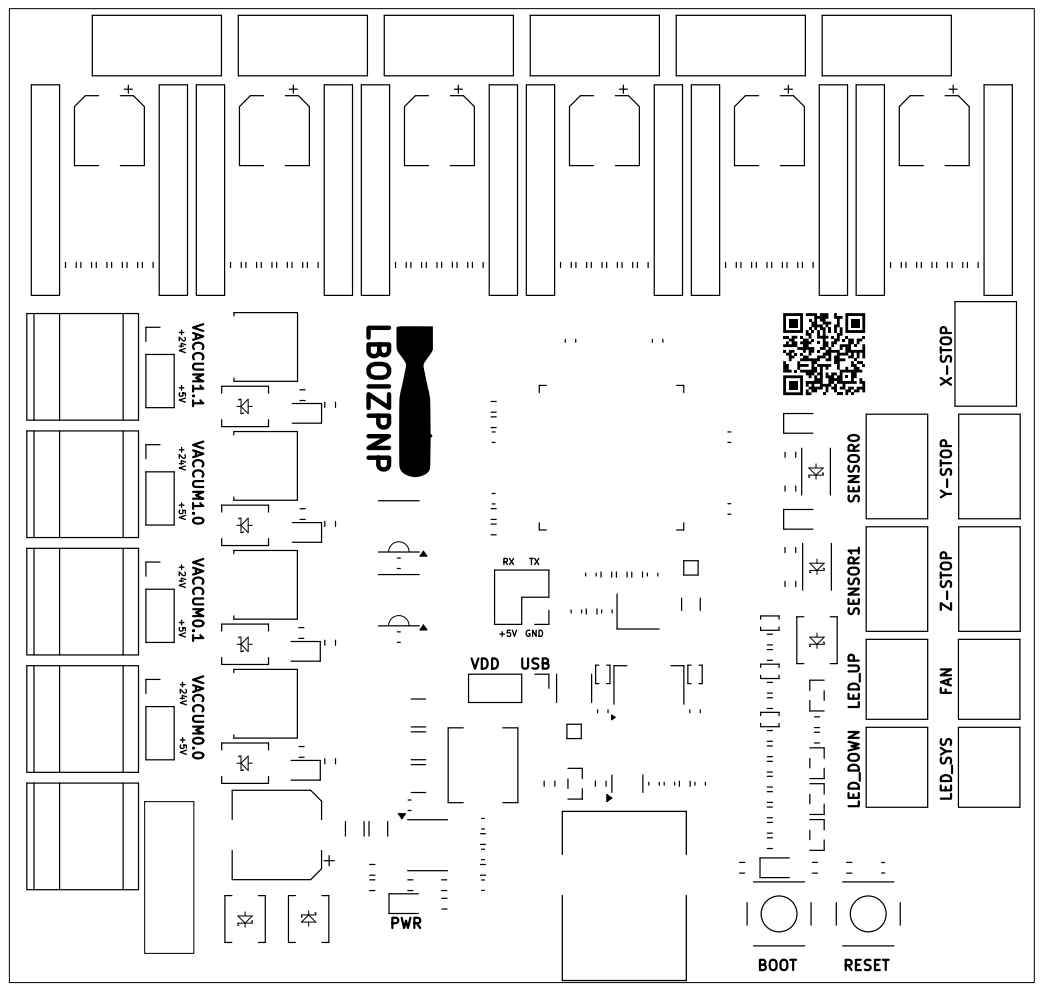
[picture p127: page 5]

VIN

GND

2B

## 2A1A1B

3V3 GND

X-AXIS

VIN

GND

2B

## 2A1A1B

3V3 GND

Y0-AXIS Y1-AXIS

VIN

GND

2B

## 2A1A1B

3V3 GND

Z-AXIS

VIN

GND

2B

## 2A1A1B

3V3 GND

C0-AXIS

VIN

GND

2B

## 2A1A1B

3V3 GND

C1-AXIS

VIN

GND

2B

## 2A1A1B

3V3 GND

# P1.26 P1.24 P2.1 P2.0

VCC

VCC

VCC

VCC

## ENM1 M2RX

TX CLK

STP

DIR

## ENM1 M2RX

TX CLK

STP

DIR

## ENM1 M2RX

TX CLK

STP

DIR

## ENM1 M2RX

TX CLK

STP

DIR

D-D+

VBUS GND

## ENM1 M2RX

TX CLK

STP

DIR

# P2.11 P2.13 P1.18 P3.25 +24V +24V +24V +24V GND

GND

## ENM1 M2RX

TX CLK

STP

DIR

# P1.21 P1.20 P1.19 P1.23 P3.26 +24V +24V GND

GND

GND +5V +5V +5V +

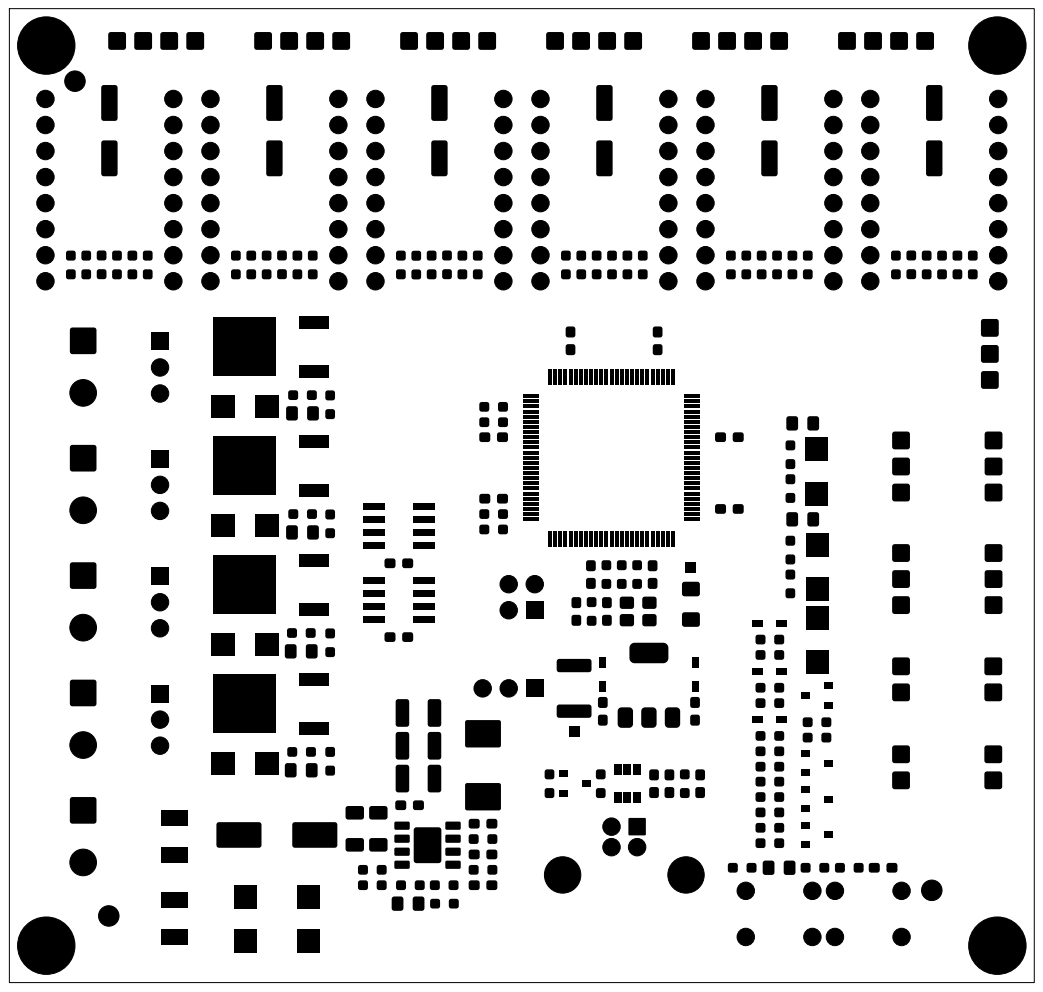
[picture p128: page 7]

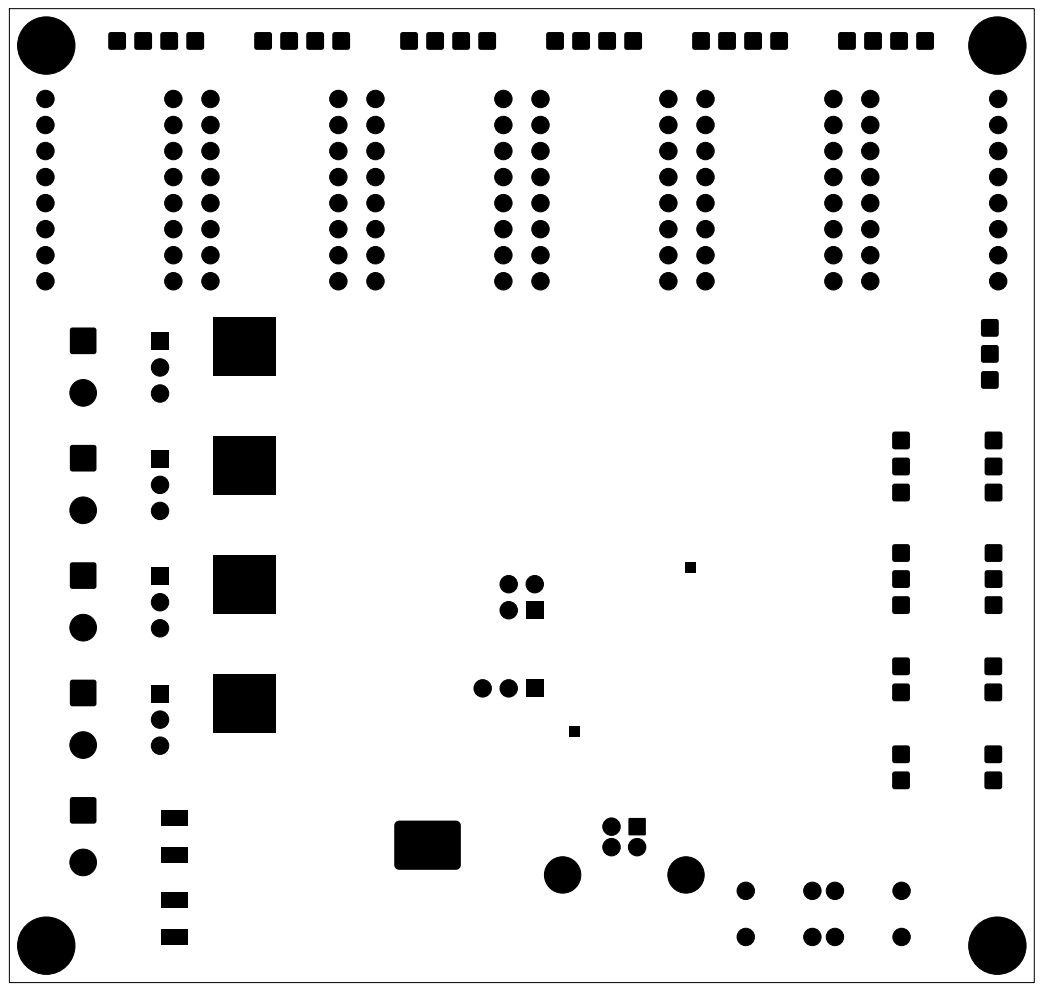
[picture p129: page 8]
