tominhcuong2041505-sys/SMT-Pick-and-Place/PCB/2026-07-02/LBoizPnP_AssemblyTop_2026-07-02.pdf

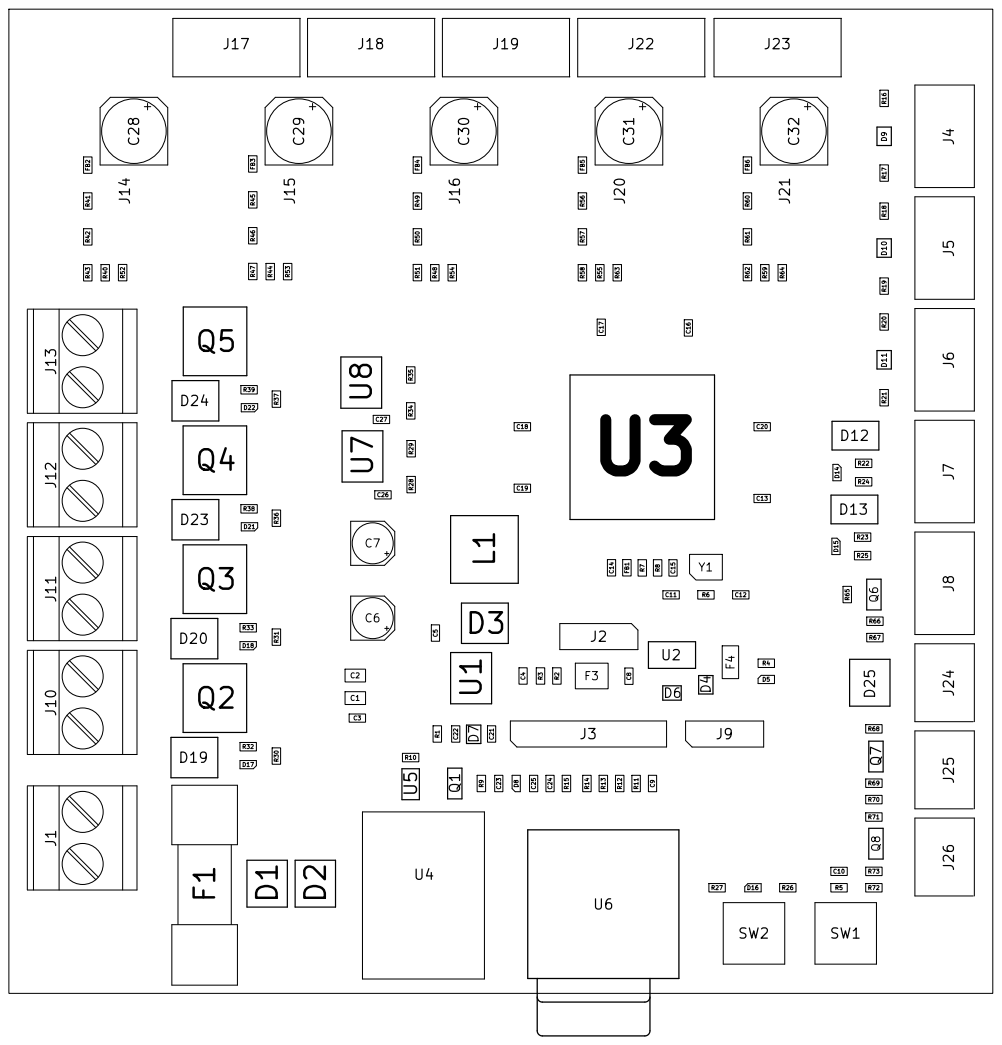
[picture p130: page 1]
