tominhcuong2041505-sys/SMT-Pick-and-Place/PCB/2026-08-03/LBoizPnP_AssemblyTop_2026-08-02.pdf

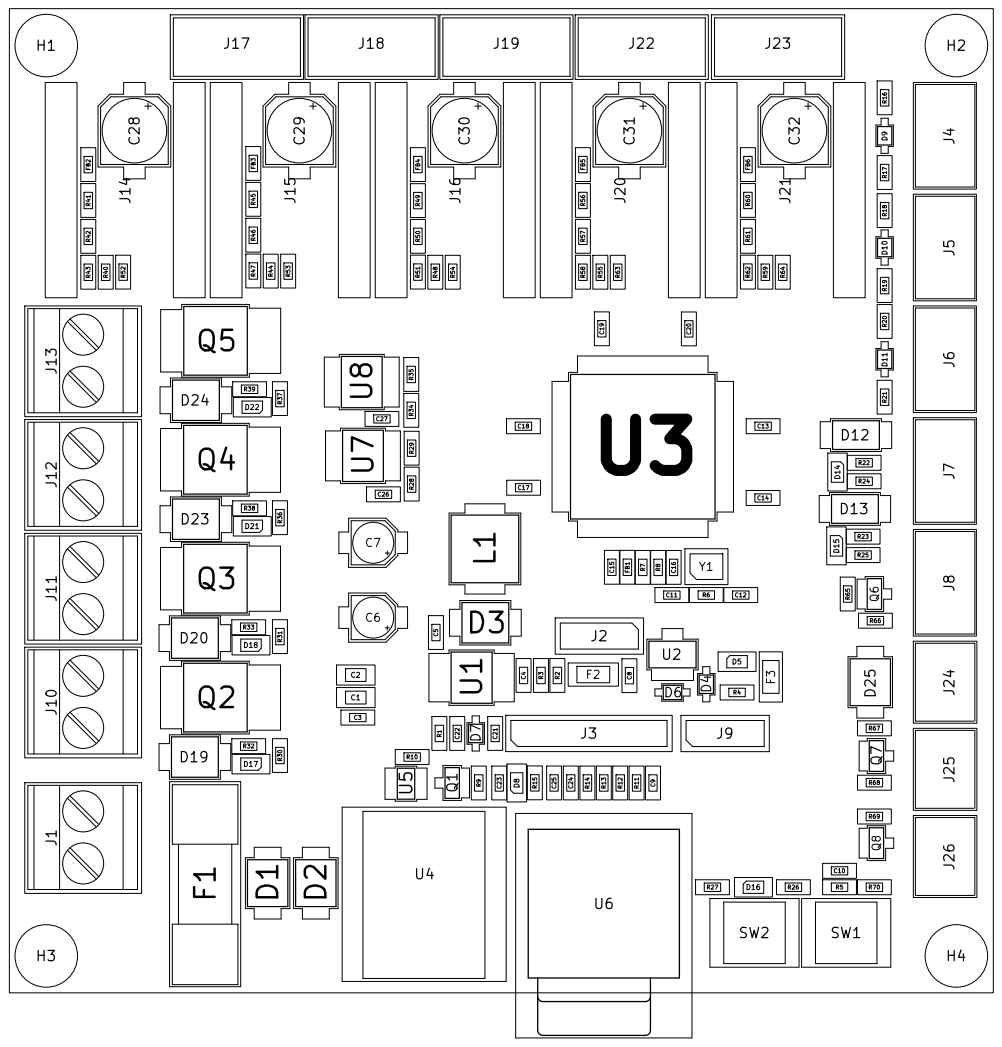
[picture p131: page 1]
