tominhcuong2041505-sys/SMT-Pick-and-Place/PCB/2026-08-28/LBoizPnP_AssemblyTop_2026-08-28.pdf

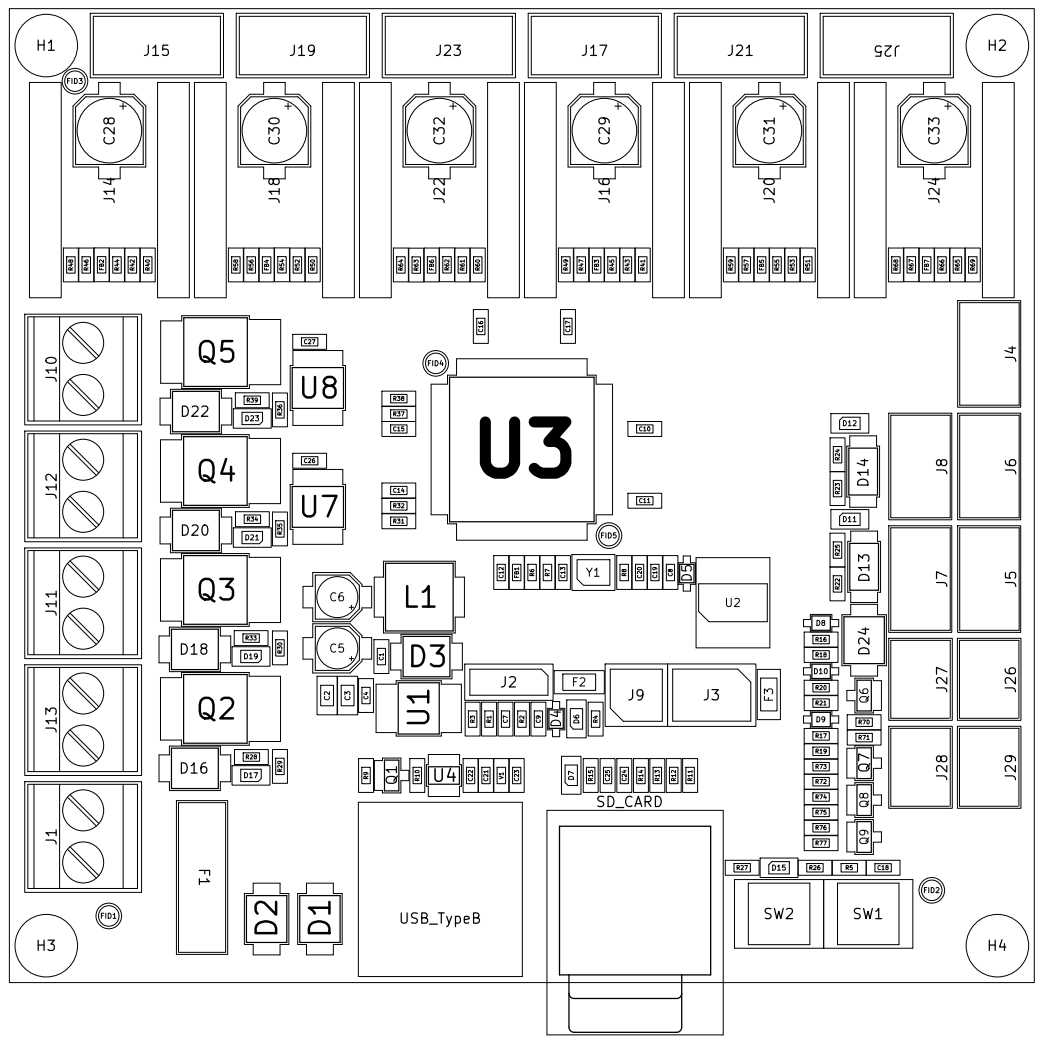
[picture p133: page 1]
