tominhcuong2041505-sys/SMT-Pick-and-Place/PCB/2026-09-20/LBoizPnP_AssemblyTop_2026-09-19.pdf

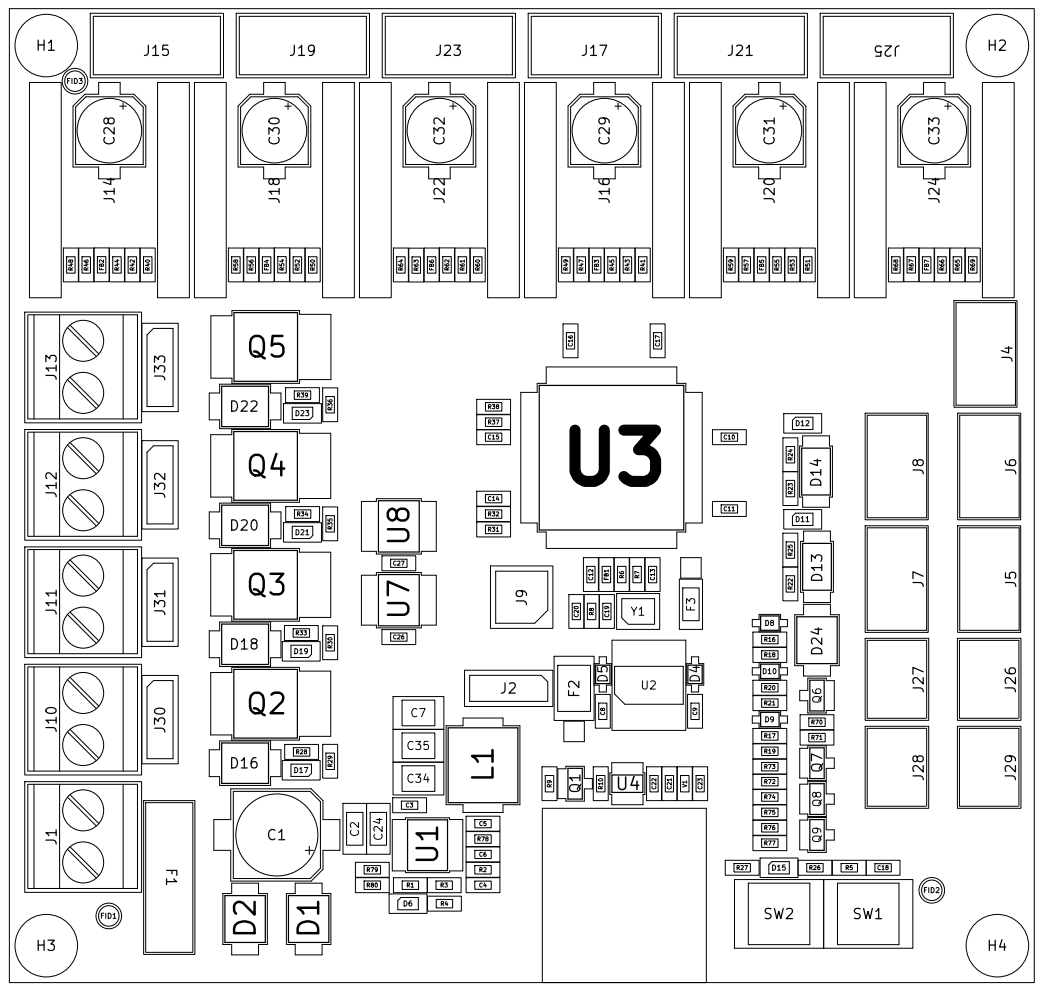
[picture p135: page 1]
