tominhcuong2041505-sys/SMT-Pick-and-Place/PCB/Mainboard/2026-06-29/LBoizPnP_AssemblyTop_2026-06-29.pdf

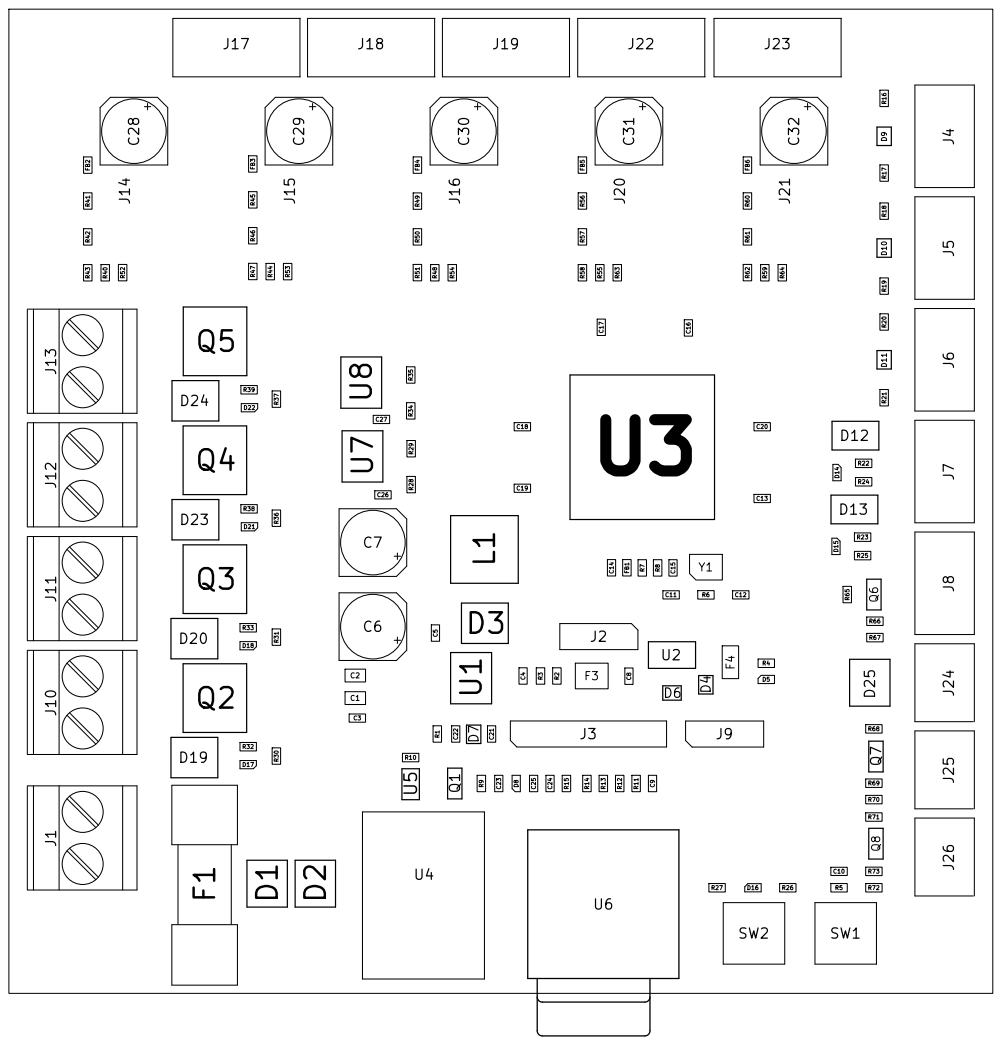
[picture p136: page 1]
