tominhcuong2041505-sys/SMT-Pick-and-Place/PCB/2026-07-02/LBoizPnP_DrillMap_2026-07-02.pdf

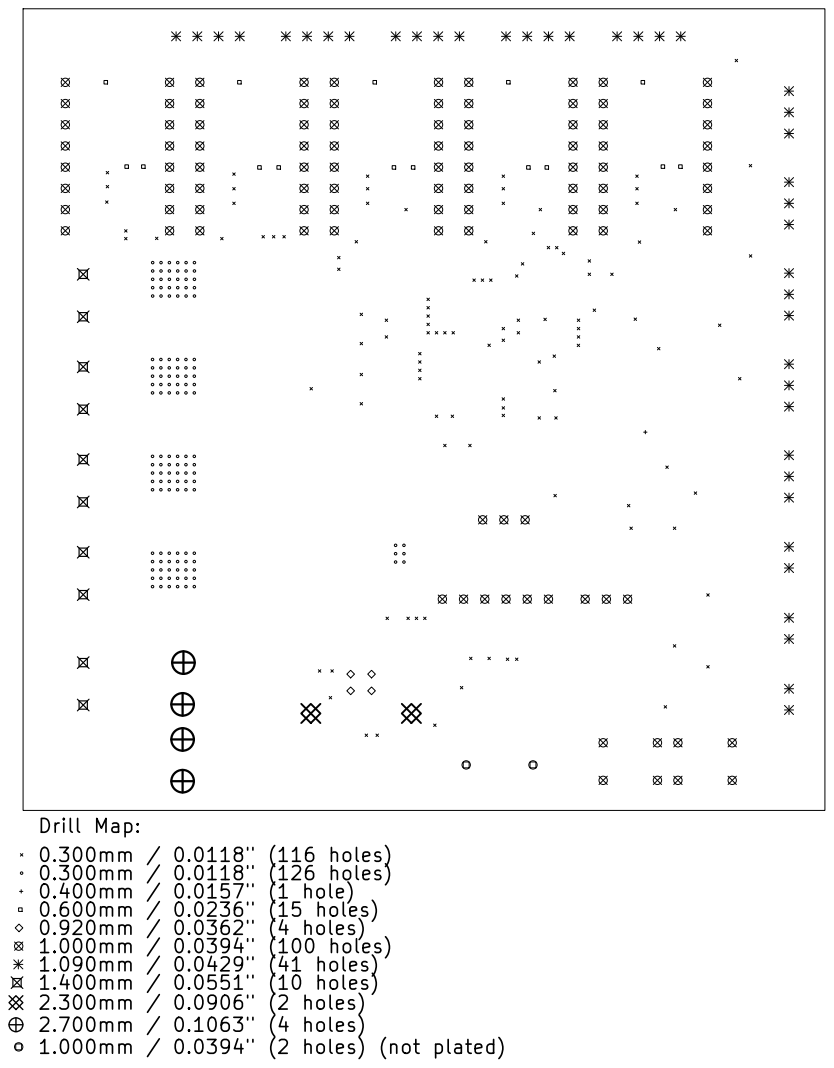
[picture p137: page 1]
