tominhcuong2041505-sys/SMT-Pick-and-Place/PCB/2026-08-03/LBoizPnP_DrillMap_2026-08-02.pdf

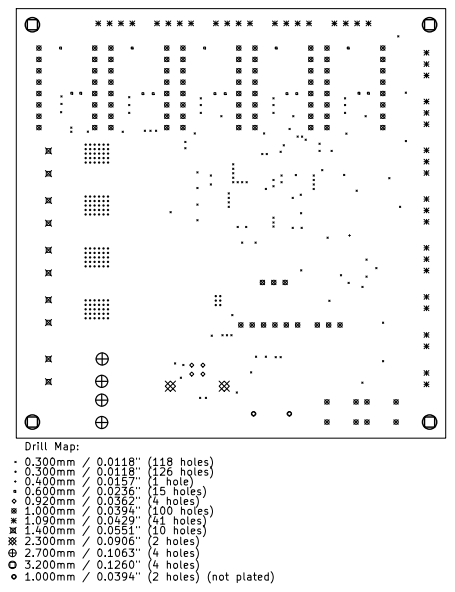
[picture p138: page 1]
