tominhcuong2041505-sys/SMT-Pick-and-Place/PCB/2026-08-10/LBoizPnP_DrillMap_2026-08-10.pdf

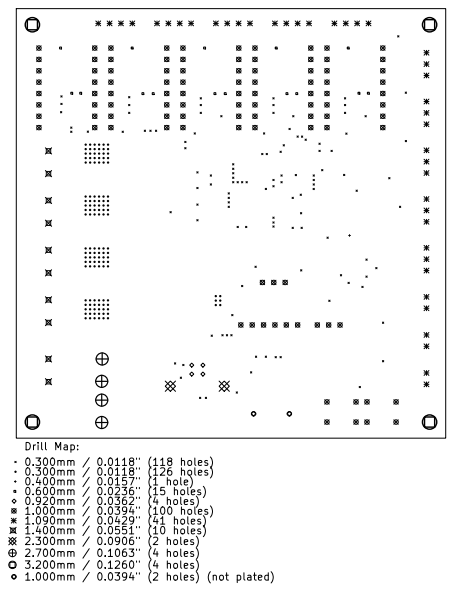
[picture p139: page 1]
