tominhcuong2041505-sys/SMT-Pick-and-Place/PCB/2026-08-28/LBoizPnP_DrillMap_2026-08-28.pdf

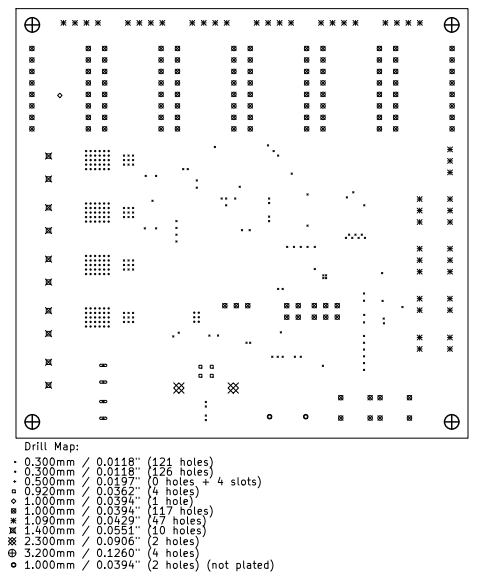
[picture p140: page 1]
