tominhcuong2041505-sys/SMT-Pick-and-Place/PCB/2026-09-16/LBoizPnP_DrillMap_2026-09-16.pdf

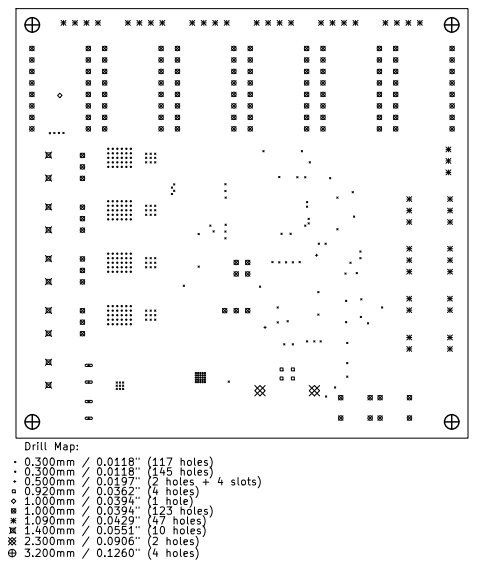
[picture p141: page 1]
