tominhcuong2041505-sys/SMT-Pick-and-Place/PCB/2026-09-20/LBoizPnP_DrillMap_2026-09-19.pdf

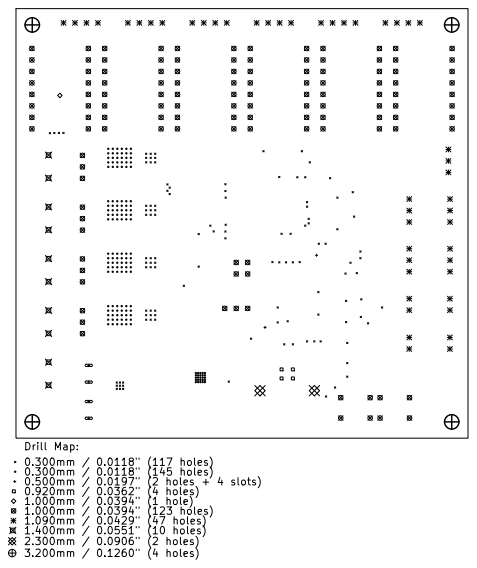
[picture p142: page 1]
