tominhcuong2041505-sys/SMT-Pick-and-Place/PCB/2026-07-02/Layout/LPC1769_PNP-B_Cu.pdf

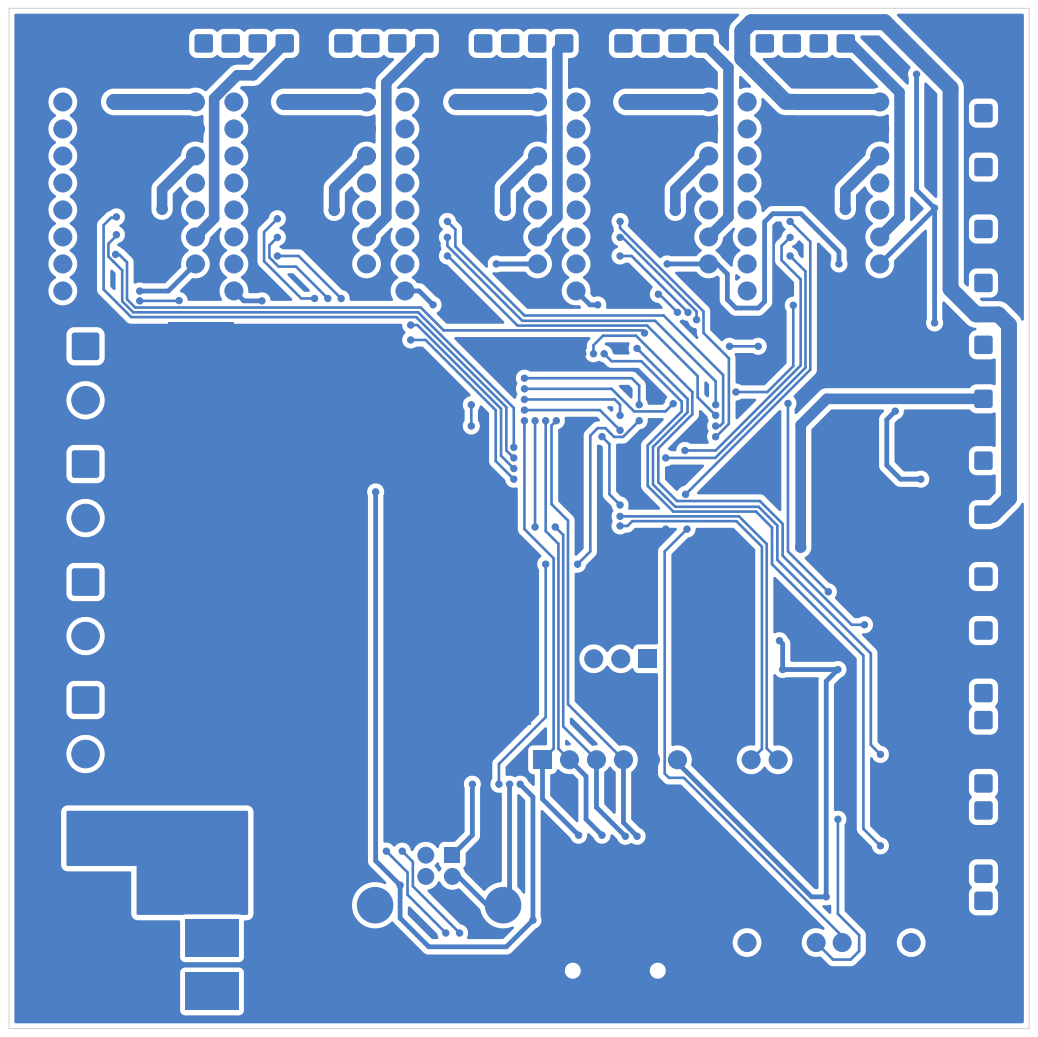
[picture p143: page 1]
