tominhcuong2041505-sys/SMT-Pick-and-Place/PCB/2026-07-02/Layout/LPC1769_PNP-B_Mask.pdf

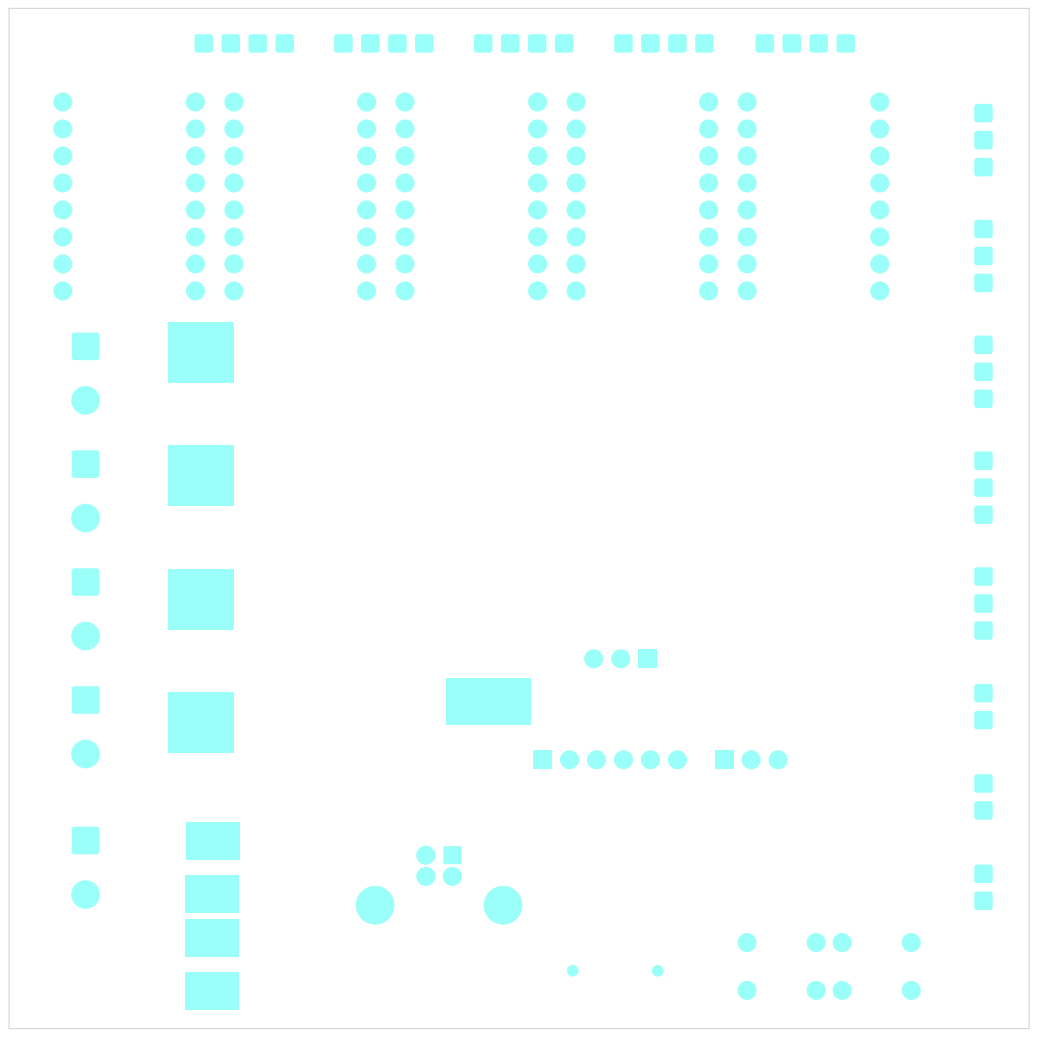
[picture p144: page 1]
