tominhcuong2041505-sys/SMT-Pick-and-Place/PCB/2026-07-02/Layout/LPC1769_PNP-F_Cu.pdf

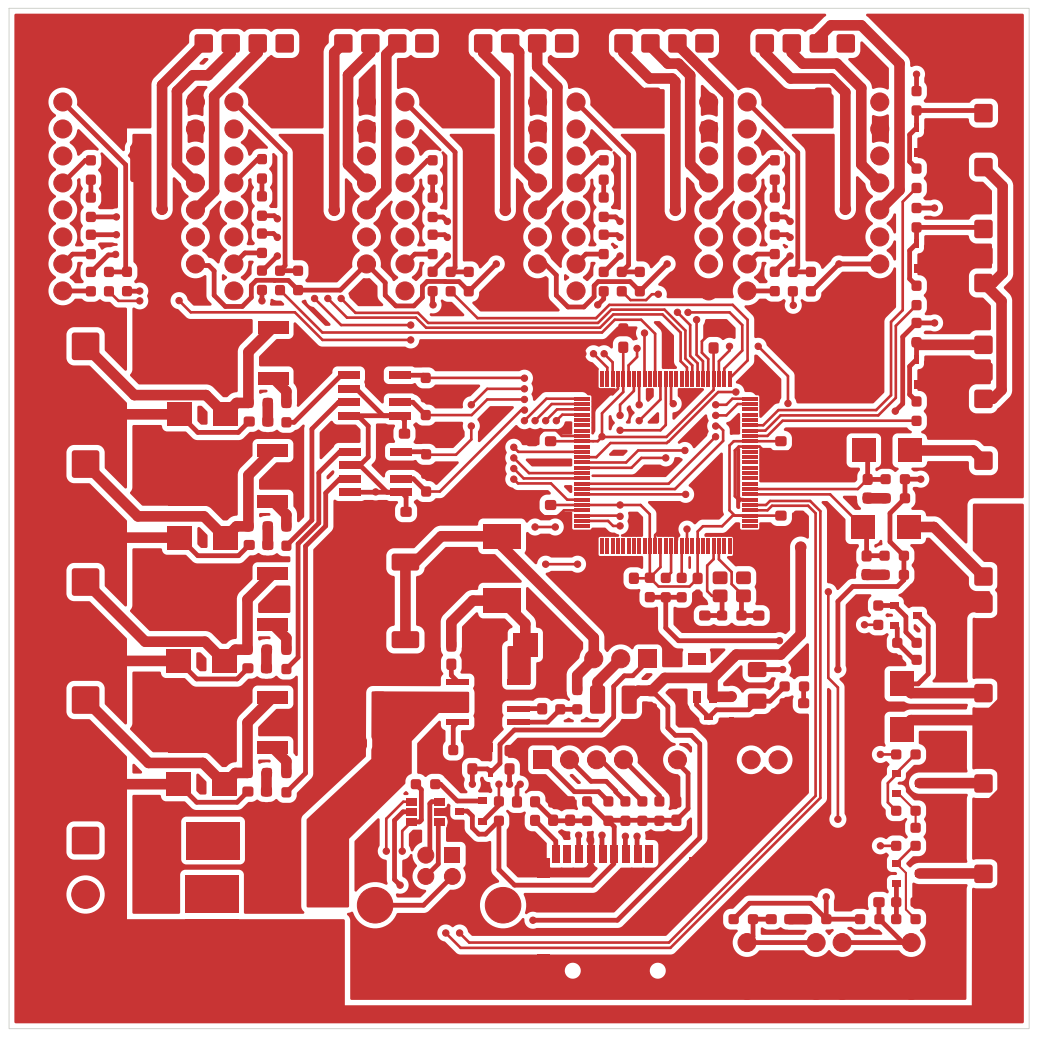
[picture p145: page 1]
