tominhcuong2041505-sys/SMT-Pick-and-Place/PCB/2026-07-02/Layout/LPC1769_PNP-F_Silkscreen.pdf

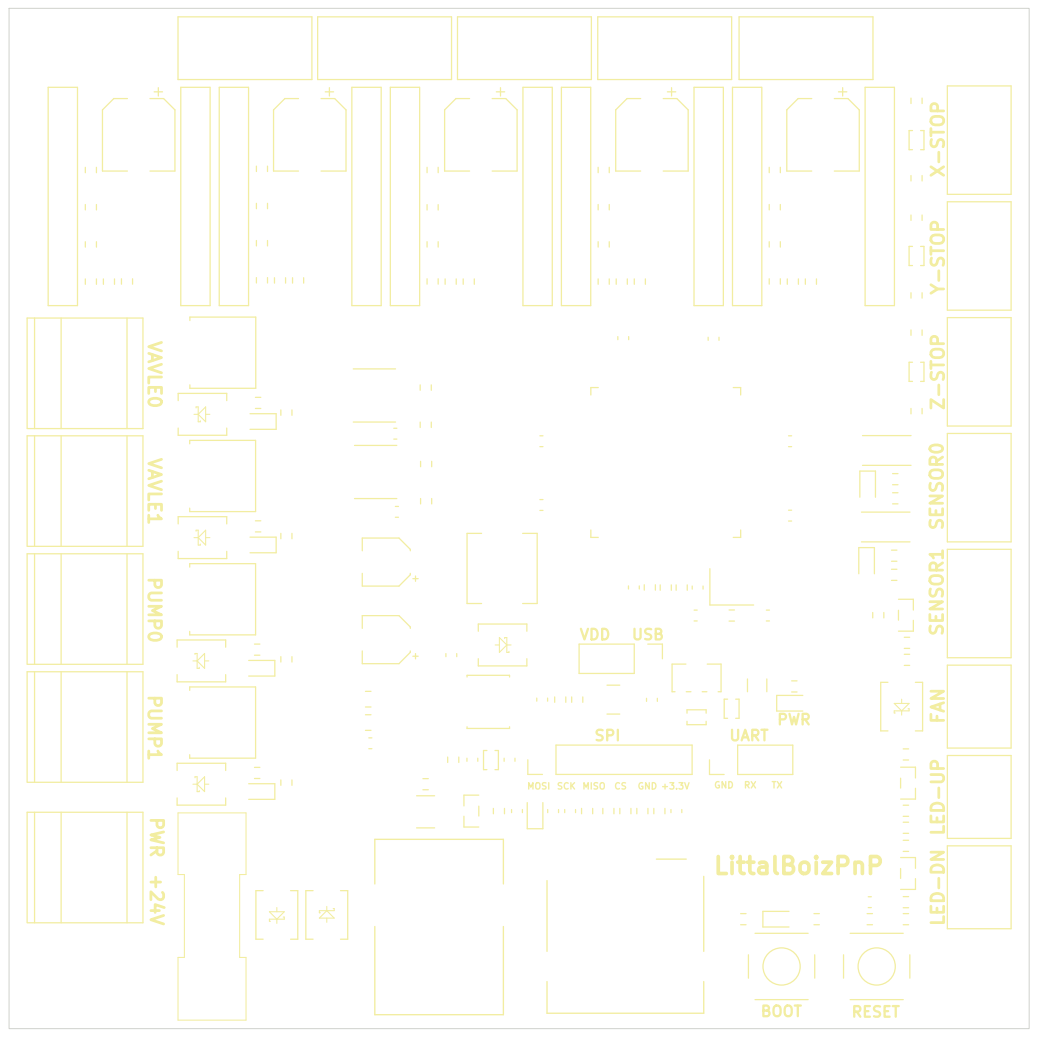
[picture p148: page 1]
