tominhcuong2041505-sys/SMT-Pick-and-Place/Klipper/2026-09-18/macro.pnp.cfg

[homing_override]
axes: xyz
gcode:
  	G28 Z0
    G28 X0 Y0 E0
    ; G1 X10 Y10 Z-4 E0 F1000

[gcode_macro PNP_CONNECTED]
description: OpenPnP status
gcode:
    RESPOND MSG="OpenPnP Connected"

[gcode_macro M42]
description: Cầu nối lệnh M42 từ OpenPnP để điều khiển Actuator (ON/OFF)
gcode:
    {% set pin_num = params.P|default(-1)|int %}
    {% set pin_val = params.S|default(0)|float %}

    # Pin 2.4
    {% if pin_num == 1 %}
        {% if pin_val > 0.0 %}
            SET_PIN PIN=led_down VALUE=1
        {% else %}
            SET_PIN PIN=led_down VALUE=0.0
        {% endif %}
    
    # Pin 2.7
    {% elif pin_num == 2 %}
        {% if pin_val > 0.0 %}
            SET_PIN PIN=led_top VALUE=1
        {% else %}
            SET_PIN PIN=led_top VALUE=0.0
        {% endif %}
    {% endif %}

    RESPOND MSG="ok"

[gcode_macro G1]
rename_existing: G1.1
gcode:
    # 1. Bắt tham số an toàn: Dùng get() để không văng lỗi khi thiếu trục C
    {% set c_axis = params.get('C') %}
    
    # 2. Xử lý Feedrate: Có F thì chia 60, không có F thì bám theo tốc độ hiện hành của máy
    {% set feedrate = (params.get('F')|float / 60.0) if 'F' in params else printer.gcode_move.speed %}
    
    # 3. Kích hoạt động cơ C chạy độc lập
    {% if c_axis is not none %}
        MANUAL_STEPPER STEPPER=c MOVE={c_axis|float} SPEED={feedrate} SYNC=0
    {% endif %}
    
    # 4. Lọc bỏ C, giữ lại XYZ
    {% set clean_params = [] %}
    {% for k in params %}
        {% if k != 'C' %}
            {% set _ = clean_params.append(k ~ params[k]) %}
        {% endif %}
    {% endfor %}
    
    # 5. Thực thi G1 gốc
    {% if clean_params|length > 0 %}
        G1.1 {clean_params|join(" ")}
    {% endif %}

[gcode_macro G0]
rename_existing: G0.1
gcode:
    # Xử lý độc lập cho G0 để tránh gọi chồng macro gây kẹt Klipper
    {% set c_axis = params.get('C') %}
    {% set feedrate = (params.get('F')|float / 60.0) if 'F' in params else printer.gcode_move.speed %}
    
    {% if c_axis is not none %}
        MANUAL_STEPPER STEPPER=c MOVE={c_axis|float} SPEED={feedrate} SYNC=0
    {% endif %}
    
    {% set clean_params = [] %}
    {% for k in params %}
        {% if k != 'C' %}
            {% set _ = clean_params.append(k ~ params[k]) %}
        {% endif %}
    {% endfor %}
    
    {% if clean_params|length > 0 %}
        G0.1 {clean_params|join(" ")}
    {% endif %}
